leedshackspace/lulzbot-mini/documentation/Specifications v1.0.odt

- Printing
  - Print Surface: Heated Borosilicate glass bed covered with PEI film
  - Print Area:155mm x 155mm x 155mm (6.1in x 6.1in x 6.1in)
  - Print Volume: 3,724cm3 (227in3) of usable space
  - Top Print Speed: 275mm/sec (10.8in/sec) at 0.18 layer height
  - Print Tolerance: 0.1mm (0.0039in) in X and Y axes. Z axis is dependent on layer thickness
  - Layer Thickness: 0.05mm to 0.50mm (0.002in - 0.020in)
  - Supported Materials: ABS, PLA, HIPS, PVA, wood filled filaments, Polyester (Tritan), PETT, filled PLA, Bronze and copper filled filaments, Polycarbonate, Nylon, PETG, Conductive PLA and ABS, UV luminescent filaments, PCTPE, PC-ABS, and more every day.
  - Usable Filament Sizes: standard 3mm (0.1in)
- Physical Dimensions
  - Overall Dimensions: 435mm x 340mm x 385mm (17.1in x 13.4in x 15.2in)
  - Weight: 8.55kg (18.85lbs)
- Electrical
  - Power Requirements: 100 - 240 VAC
  - Power Supply: 24V 150W
  - US, UK, AU and EU electrical plugs available
- Temperature
  - Temperature: Maximum operating temperature (Extruder), 300C (572F)
  - Temperature: Maximum operating temperature (Heated Bed), 120C (248F)
  - Suggested operating temperature (environment), 15-38C (60-100F)
