leedshackspace/lulzbot-mini/parts/machined_parts/electronics_case/index.html

# Index of /Mini/1.04/production_parts/machined_parts/electronics_case

(ICO) | Name | Last modified | Size | Description
(PARENTDIR) | Parent Directory | | -
( ) | electronics-case-mini_PP-FP0082_revG.fcstd | 2017-09-13 06:26 | 938K
( ) | electronics-case-mini_PP-FP0082_revG.step | 2017-09-13 06:26 | 1.0M
( ) | electronics-case-mini_PP-FP0082_revG_page1.pdf | 2017-09-13 06:26 | 1.3M
( ) | electronics-case-mini_PP-FP0082_revG_page2.pdf | 2017-09-13 06:26 | 867K
( ) | electronics-case-mini_PP-FP0082_revG_page3.pdf | 2017-09-13 06:26 | 369K
( ) | electronics-case-mini_PP-FP0139_revJ.fcstd | 2017-12-08 15:28 | 1.0M
( ) | electronics-case-mini_PP-FP0139_revJ.pdf | 2017-12-08 15:28 | 401K
(DIR) | electronics_case_graphics/ | 2017-12-08 15:28 | -
( ) | mini_chassis_corrected_Sept2016.pdf | 2017-09-13 06:26 | 117K
(DIR) | ready/ | 2017-11-06 11:28 | -

Apache/2.4.25 (Debian) Server at download.lulzbot.com Port 80
