leedshackspace/lulzbot-mini/parts/Electronics/cable-harnesses/index.html

# Index of /Mini/1.04/production_parts/Electronics/cable-harnesses

(ICO) | Name | Last modified | Size | Description
(PARENTDIR) | Parent Directory | | -
( ) | EL-HR0114_bed_harness_revK.odg | 2018-01-25 11:28 | 3.5M
( ) | EL-HR0115_yz_motor_harness_revH.odg | 2017-08-30 07:58 | 524K
( ) | bed_harness.odg | 2017-09-13 06:26 | 3.5M
( ) | bed_harness.pdf | 2017-09-13 06:26 | 4.6M
( ) | bed_harness_igus.odg | 2017-09-13 06:26 | 3.3M
( ) | bed_harness_igus.pdf | 2017-09-13 06:26 | 4.1M
(DIR) | chassis_assembly/ | 2017-09-13 06:26 | -
(DIR) | extruder_assembly/ | 2017-09-13 06:26 | -
( ) | igus_changelog.odt | 2017-09-13 06:26 | 13K
( ) | igus_first_cable_prototypes.zip | 2017-09-13 06:26 | 8.0M
( ) | x_extruder_harnesses.odg | 2017-09-13 06:26 | 3.3M
( ) | x_extruder_harnesses.pdf | 2017-09-13 06:26 | 4.2M
( ) | x_extruder_harnesses_revI.odg | 2017-03-20 11:58 | 3.2M
( ) | yz_motor_harness.odg | 2017-09-13 06:26 | 523K

Apache/2.4.25 (Debian) Server at download.lulzbot.com Port 80
