leedshackspace/lulzbot-mini/documentation/Bill of Materials/Mini_1.04_BOM.ods

Sheet: OdooParts_PurchaseNotes
Internal Reference | Name | Long Lead | Possibly Change Part, PN, or Modify | Special | U/M | Supplier PN | Category | Price Per Unit | Released to Order | Manufacturer | Mfg PN | Distributor | Distributor SKU | Notes | 2nd Distributor | 2nd Dist. Part Number | Mass each (g) | Mass per Printer (g) | Mass Total (kg)
AO-PG0001 | Aleph Objects, Inc. Business Cards | #N/A | #N/A | #N/A | PCE | 0 | #N/A | #N/A | #N/A | #N/A | 0 | #N/A | #N/A | #N/A | #N/A | #N/A | #N/A | #N/A | #N/A
AP0010 | Print die | #N/A | #N/A | #N/A | PCE | 0 | #N/A | #N/A | #N/A | #N/A | 0 | #N/A | #N/A | #N/A | #N/A | #N/A | #N/A | #N/A | #N/A
AP-MM0000 | MendelMax Prototype, Dual Extrusion | #N/A | #N/A | #N/A | PCE | 0 | #N/A | #N/A | #N/A | #N/A | 0 | #N/A | #N/A | #N/A | #N/A | #N/A | #N/A | #N/A | #N/A
AP-MM0001 | RepRap 3D Printer, MendelMax Variant, Fully Calibrated | #N/A | #N/A | #N/A | PCE | 0 | #N/A | #N/A | #N/A | #N/A | 0 | #N/A | #N/A | #N/A | #N/A | #N/A | #N/A | #N/A | #N/A
AP-MM0001 | RepRap 3D Printer, MendelMax Variant, Fully Calibrated (copy) | #N/A | #N/A | #N/A | PCE | 0 | #N/A | #N/A | #N/A | #N/A | 0 | #N/A | #N/A | #N/A | #N/A | #N/A | #N/A | #N/A | #N/A
AP-PR0000 | 3D Printer, RepRap Mendel by LulzBot | #N/A | #N/A | #N/A | PCE | 0 | #N/A | #N/A | #N/A | #N/A | 0 | #N/A | #N/A | #N/A | #N/A | #N/A | #N/A | #N/A | #N/A
AP-PR0001 | RepRap Prusa Mendel by LulzBot, Used 3D Printer | #N/A | #N/A | #N/A | PCE | 0 | #N/A | #N/A | #N/A | #N/A | 0 | #N/A | #N/A | #N/A | #N/A | #N/A | #N/A | #N/A | #N/A
AP-PR0002 | Original Prusa i3 MK2 3D Printer | #N/A | #N/A | #N/A | PCE | 0 | #N/A | #N/A | #N/A | #N/A | 0 | #N/A | #N/A | #N/A | #N/A | #N/A | #N/A | #N/A | #N/A
DC-LB0001 | Label, Lulzbot AO-101 Barcode label | #N/A | #N/A | #N/A | PCE | 0 | #N/A | #N/A | #N/A | #N/A | 0 | #N/A | #N/A | #N/A | #N/A | #N/A | #N/A | #N/A | #N/A
DC-LB0002 | Label, LulzBot AO-100 Barcode | #N/A | #N/A | #N/A | PCE | 0 | #N/A | #N/A | #N/A | #N/A | 0 | #N/A | #N/A | #N/A | #N/A | #N/A | #N/A | #N/A | #N/A
DC-LB0003 | Label, Hobbed Bolt | #N/A | #N/A | #N/A | PCE | 0 | #N/A | #N/A | #N/A | #N/A | 0 | #N/A | #N/A | #N/A | #N/A | #N/A | #N/A | #N/A | #N/A
DC-LB0004 | Label, Budaschnozzle 1.1 threaded extension | #N/A | #N/A | #N/A | PCE | 0 | #N/A | #N/A | #N/A | #N/A | 0 | #N/A | #N/A | #N/A | #N/A | #N/A | #N/A | #N/A | #N/A
DC-LB0005 | 2 x 2" D.O.T. Labels - "Right to Know" | #N/A | #N/A | #N/A | PCE | S-2845 | #N/A | #N/A | #N/A | #N/A | 0 | #N/A | #N/A | #N/A | #N/A | #N/A | #N/A | #N/A | #N/A
DC-LB0006 | Label, Lulzbot TAZ 2.0 Barcode | #N/A | #N/A | #N/A | PCE | 0 | #N/A | #N/A | #N/A | #N/A | 0 | #N/A | #N/A | #N/A | #N/A | #N/A | #N/A | #N/A | #N/A
DC-LB0007 | Label, Top of Box | #N/A | #N/A | #N/A | PCE | 0 | #N/A | #N/A | #N/A | #N/A | 0 | #N/A | #N/A | #N/A | #N/A | #N/A | #N/A | #N/A | #N/A
DC-LB0008 | 2 x 2" D.O.T. Labels - "Right to Know", single label | #N/A | #N/A | #N/A | PCE | 0 | #N/A | #N/A | #N/A | #N/A | 0 | #N/A | #N/A | #N/A | #N/A | #N/A | #N/A | #N/A | #N/A
DC-LB0009 | 1", "Made In USA" Labels 500/roll | #N/A | #N/A | #N/A | PCE | S-17021 | #N/A | #N/A | #N/A | #N/A | 0 | #N/A | #N/A | #N/A | #N/A | #N/A | #N/A | #N/A | #N/A
DC-LB0010 | 3X5 DELICATE INSTRUMENTS LBL 500/RL | #N/A | #N/A | #N/A | PCE | S-3005 | #N/A | #N/A | #N/A | #N/A | 0 | #N/A | #N/A | #N/A | #N/A | #N/A | #N/A | #N/A | #N/A
DC-LB0011 | Flame Labels - "Hot", 1 1⁄2 x 2" | #N/A | #N/A | #N/A | PCE | S-248 | #N/A | #N/A | #N/A | #N/A | 0 | #N/A | #N/A | #N/A | #N/A | #N/A | #N/A | #N/A | #N/A
DC-LB0012 | 14035T23 Hazardous Material Sign, NFPA Diamond Style, 5" X5", Adhesive-Backed Vinyl | #N/A | #N/A | #N/A | PCE | 14035T23 | #N/A | #N/A | #N/A | #N/A | 0 | #N/A | #N/A | #N/A | #N/A | #N/A | #N/A | #N/A | #N/A
DC-LB0013 | Hazardous Material Sign, NFPA Diamond, 10-1/2" x 10-1/2", Adhesive-Back Vinyl | #N/A | #N/A | #N/A | PCE | 14035T25 | #N/A | #N/A | #N/A | #N/A | 0 | #N/A | #N/A | #N/A | #N/A | #N/A | #N/A | #N/A | #N/A
DC-LB0014 | TAZ v3.1 serial number sticker | #N/A | #N/A | #N/A | PCE | 0 | #N/A | #N/A | #N/A | #N/A | 0 | #N/A | #N/A | #N/A | #N/A | #N/A | #N/A | #N/A | #N/A
DC-LB0015 | 24VDC sticker | #N/A | #N/A | #N/A | PCE | 0 | #N/A | #N/A | #N/A | #N/A | 0 | #N/A | #N/A | #N/A | #N/A | #N/A | #N/A | #N/A | #N/A
DC-LB0016 | TAZ v3.1 bar code and serial number sticker | #N/A | #N/A | #N/A | PCE | 0 | #N/A | #N/A | #N/A | #N/A | 0 | #N/A | #N/A | #N/A | #N/A | #N/A | #N/A | #N/A | #N/A
DC-LB0017 | Label, Extruder E-Step Number, Avery 1/2 x 3/4 | #N/A | #N/A | #N/A | PCE | 112797 | #N/A | #N/A | #N/A | #N/A | 0 | #N/A | #N/A | #N/A | #N/A | #N/A | #N/A | #N/A | #N/A
DC-LB0018 | TAZ v4.0 serial number sticker | #N/A | #N/A | #N/A | PCE | 0 | #N/A | #N/A | #N/A | #N/A | 0 | #N/A | #N/A | #N/A | #N/A | #N/A | #N/A | #N/A | #N/A
DC-LB0019 | Label, 12VDC Extrusion Fan | #N/A | #N/A | #N/A | PCE | 0 | #N/A | #N/A | #N/A | #N/A | 0 | #N/A | #N/A | #N/A | #N/A | #N/A | #N/A | #N/A | #N/A
DC-LB0020 | Label, 24VDC Extrusion Fan | #N/A | #N/A | #N/A | PCE | 0 | #N/A | #N/A | #N/A | #N/A | 0 | #N/A | #N/A | #N/A | #N/A | #N/A | #N/A | #N/A | #N/A
DC-LB0021 | 1" Circle Inventory Control Labels - "Inspected by _____" roll 500 | #N/A | #N/A | #N/A | PCE | S-13119 | #N/A | #N/A | #N/A | #N/A | 0 | #N/A | #N/A | #N/A | #N/A | #N/A | #N/A | #N/A | #N/A
DC-LB0022 | 2" Circle Inventory Control Labels - "QC Rejected" roll 500 | #N/A | #N/A | #N/A | PCE | S-5914 | #N/A | #N/A | #N/A | #N/A | 0 | #N/A | #N/A | #N/A | #N/A | #N/A | #N/A | #N/A | #N/A
DC-LB0023 | 1" Circle Inventory Control Labels - "QC Passed" Roll 500 | #N/A | #N/A | #N/A | PCE | S-13118 | #N/A | #N/A | #N/A | #N/A | 0 | #N/A | #N/A | #N/A | #N/A | #N/A | #N/A | #N/A | #N/A
DC-LB0024 | Label, Bottom of Box | #N/A | #N/A | #N/A | PCE | 0 | #N/A | #N/A | #N/A | #N/A | 0 | #N/A | #N/A | #N/A | #N/A | #N/A | #N/A | #N/A | #N/A
DC-LB0025 | TAZ v4.1 serial number sticker | #N/A | #N/A | #N/A | PCE | 0 | #N/A | #N/A | #N/A | #N/A | 0 | #N/A | #N/A | #N/A | #N/A | #N/A | #N/A | #N/A | #N/A
DC-LB0026 | Label, Lulzbot TAZ 4.1 Barcode | #N/A | #N/A | #N/A | PCE | 0 | #N/A | #N/A | #N/A | #N/A | 0 | #N/A | #N/A | #N/A | #N/A | #N/A | #N/A | #N/A | #N/A
DC-LB0027 | KITTAZ Labels Complete Set | #N/A | #N/A | #N/A | PCE | 0 | #N/A | #N/A | #N/A | #N/A | 0 | #N/A | #N/A | #N/A | #N/A | #N/A | #N/A | #N/A | #N/A
DC-LB0028 | Label, Lulzbot Mini Barcode | 0 | Y | 0 | PCE | 0 | Packaging | 0.14 |  | 0 | 0 | The print shop of loveland | 0 | 0 | 0 | 0 | 0 | 0 | 0
DC-LB0029 | Mini v1 serial number sticker | 0 | Y | 0 | PCE | 0 | Packaging | 0.014 |  | 0 | 0 | The print shop of loveland | 0 | 0 | 0 | 0 | 0 | 0 | 0
DC-LB0030 | "CE" Regulated Label - 1 x 1" | #N/A | #N/A | #N/A | PCE | S-13827 | #N/A | #N/A | #N/A | #N/A | 0 | #N/A | #N/A | #N/A | #N/A | #N/A | #N/A | #N/A | #N/A
DC-LB0031 | TAZ v5.0 serial number sticker, KT-PR0017NA | #N/A | #N/A | #N/A | PCE | 0 | #N/A | #N/A | #N/A | #N/A | 0 | #N/A | #N/A | #N/A | #N/A | #N/A | #N/A | #N/A | #N/A
DC-LB0032 | Label, Lulzbot TAZ 5.0 Barcode, KT-PR0017NA | #N/A | #N/A | #N/A | PCE | 0 | #N/A | #N/A | #N/A | #N/A | 0 | #N/A | #N/A | #N/A | #N/A | #N/A | #N/A | #N/A | #N/A
DC-LB0033 | TAZ v5.0 serial number sticker, KT-PR0017EU | #N/A | #N/A | #N/A | PCE | 0 | #N/A | #N/A | #N/A | #N/A | 0 | #N/A | #N/A | #N/A | #N/A | #N/A | #N/A | #N/A | #N/A
DC-LB0034 | Label, Lulzbot TAZ 5.0 Barcode, KT-PR0017EU | #N/A | #N/A | #N/A | PCE | 0 | #N/A | #N/A | #N/A | #N/A | 0 | #N/A | #N/A | #N/A | #N/A | #N/A | #N/A | #N/A | #N/A
DC-LB0035 | TAZ v5.0 serial number sticker, KT-PR0017AU | #N/A | #N/A | #N/A | PCE | 0 | #N/A | #N/A | #N/A | #N/A | 0 | #N/A | #N/A | #N/A | #N/A | #N/A | #N/A | #N/A | #N/A
DC-LB0036 | Label, Lulzbot TAZ 5.0 Barcode, KT-PR0017AU | #N/A | #N/A | #N/A | PCE | 0 | #N/A | #N/A | #N/A | #N/A | 0 | #N/A | #N/A | #N/A | #N/A | #N/A | #N/A | #N/A | #N/A
DC-LB0037 | FCC Sticker, Blank | #N/A | #N/A | #N/A | PCE | 0 | #N/A | #N/A | #N/A | #N/A | 0 | #N/A | #N/A | #N/A | #N/A | #N/A | #N/A | #N/A | #N/A
DC-LB0038 | FCC Sticker, KT-PR0035-**** | #N/A | #N/A | #N/A | PCE | 0 | #N/A | #N/A | #N/A | #N/A | 0 | #N/A | #N/A | #N/A | #N/A | #N/A | #N/A | #N/A | #N/A
DC-LB0039 | Label, LulzBot TAZ Single Extruder Tool Head v2, 0.35 Nozzle | #N/A | #N/A | #N/A | PCE | 0 | #N/A | #N/A | #N/A | #N/A | 0 | #N/A | #N/A | #N/A | #N/A | #N/A | #N/A | #N/A | #N/A
DC-LB0040 | Label, Lulzbot Mini Barcode, NA | #N/A | #N/A | #N/A | PCE | 0 | #N/A | #N/A | #N/A | #N/A | 0 | #N/A | #N/A | #N/A | #N/A | #N/A | #N/A | #N/A | #N/A
DC-LB0041 | Label, Lulzbot Mini Barcode, EU | #N/A | #N/A | #N/A | PCE | 0 | #N/A | #N/A | #N/A | #N/A | 0 | #N/A | #N/A | #N/A | #N/A | #N/A | #N/A | #N/A | #N/A
DC-LB0042 | Label, Lulzbot Mini Barcode, AU | #N/A | #N/A | #N/A | PCE | 0 | #N/A | #N/A | #N/A | #N/A | 0 | #N/A | #N/A | #N/A | #N/A | #N/A | #N/A | #N/A | #N/A
DC-LB0043 | Mini v1 serial number sticker, NA | #N/A | #N/A | #N/A | PCE | 0 | #N/A | #N/A | #N/A | #N/A | 0 | #N/A | #N/A | #N/A | #N/A | #N/A | #N/A | #N/A | #N/A
DC-LB0044 | Mini v1 serial number sticker, EU | #N/A | #N/A | #N/A | PCE | 0 | #N/A | #N/A | #N/A | #N/A | 0 | #N/A | #N/A | #N/A | #N/A | #N/A | #N/A | #N/A | #N/A
DC-LB0045 | Mini v1 serial number sticker, AU | #N/A | #N/A | #N/A | PCE | 0 | #N/A | #N/A | #N/A | #N/A | 0 | #N/A | #N/A | #N/A | #N/A | #N/A | #N/A | #N/A | #N/A
DC-LB0046 | FCC-CE-RSF-Colorado Made 3" x 3" B&W Sticker | #N/A | #N/A | #N/A | PCE | Custom Part | #N/A | #N/A | #N/A | #N/A | 0 | #N/A | #N/A | #N/A | #N/A | #N/A | #N/A | #N/A | #N/A
DC-LB0047 | TAZ v5.0 serial number sticker, KT-PR0036NA | #N/A | #N/A | #N/A | PCE | 0 | #N/A | #N/A | #N/A | #N/A | 0 | #N/A | #N/A | #N/A | #N/A | #N/A | #N/A | #N/A | #N/A
DC-LB0048 | Label, Lulzbot TAZ 5.0 Barcode, KT-PR0036NA | #N/A | #N/A | #N/A | PCE | 0 | #N/A | #N/A | #N/A | #N/A | 0 | #N/A | #N/A | #N/A | #N/A | #N/A | #N/A | #N/A | #N/A
DC-LB0049 | TAZ v5.0 serial number sticker, KT-PR0036EU | #N/A | #N/A | #N/A | PCE | 0 | #N/A | #N/A | #N/A | #N/A | 0 | #N/A | #N/A | #N/A | #N/A | #N/A | #N/A | #N/A | #N/A
DC-LB0050 | Label, Lulzbot TAZ 5.0 Barcode, KT-PR0036EU | #N/A | #N/A | #N/A | PCE | 0 | #N/A | #N/A | #N/A | #N/A | 0 | #N/A | #N/A | #N/A | #N/A | #N/A | #N/A | #N/A | #N/A
DC-LB0051 | TAZ v5.0 serial number sticker, KT-PR0036AU | #N/A | #N/A | #N/A | PCE | 0 | #N/A | #N/A | #N/A | #N/A | 0 | #N/A | #N/A | #N/A | #N/A | #N/A | #N/A | #N/A | #N/A
DC-LB0052 | Label, Lulzbot TAZ 5.0 Barcode, KT-PR0036AU | #N/A | #N/A | #N/A | PCE | 0 | #N/A | #N/A | #N/A | #N/A | 0 | #N/A | #N/A | #N/A | #N/A | #N/A | #N/A | #N/A | #N/A
DC-LB0053 | Label, LulzBot TAZ Flexystruder Tool Head v2, 0.6 Nozzle | #N/A | #N/A | #N/A | PCE | 0 | #N/A | #N/A | #N/A | #N/A | 0 | #N/A | #N/A | #N/A | #N/A | #N/A | #N/A | #N/A | #N/A
DC-LB0054 | TAZ v5.0 serial number sticker, KT-PR0036NA | #N/A | #N/A | #N/A | PCE | 0 | #N/A | #N/A | #N/A | #N/A | 0 | #N/A | #N/A | #N/A | #N/A | #N/A | #N/A | #N/A | #N/A
DC-LB0055 | Label, Lulzbot TAZ 5.0 Barcode, KT-PR0036NA | #N/A | #N/A | #N/A | PCE | 0 | #N/A | #N/A | #N/A | #N/A | 0 | #N/A | #N/A | #N/A | #N/A | #N/A | #N/A | #N/A | #N/A
DC-LB0056 | TAZ v5.0 serial number sticker, KT-PR0036EU | #N/A | #N/A | #N/A | PCE | 0 | #N/A | #N/A | #N/A | #N/A | 0 | #N/A | #N/A | #N/A | #N/A | #N/A | #N/A | #N/A | #N/A
DC-LB0057 | Label, Lulzbot TAZ 5.0 Barcode, KT-PR0036EU | #N/A | #N/A | #N/A | PCE | 0 | #N/A | #N/A | #N/A | #N/A | 0 | #N/A | #N/A | #N/A | #N/A | #N/A | #N/A | #N/A | #N/A
DC-LB0058 | TAZ v5.0 serial number sticker, KT-PR0036AU | #N/A | #N/A | #N/A | PCE | 0 | #N/A | #N/A | #N/A | #N/A | 0 | #N/A | #N/A | #N/A | #N/A | #N/A | #N/A | #N/A | #N/A
DC-LB0059 | Label, Lulzbot TAZ 5.0 Barcode, KT-PR0036AU | #N/A | #N/A | #N/A | PCE | 0 | #N/A | #N/A | #N/A | #N/A | 0 | #N/A | #N/A | #N/A | #N/A | #N/A | #N/A | #N/A | #N/A
DC-LB0060 | Tool head ID label, TAZ 5 0.5mm Nozzle | #N/A | #N/A | #N/A | PCE | 0 | #N/A | #N/A | #N/A | #N/A | 0 | #N/A | #N/A | #N/A | #N/A | #N/A | #N/A | #N/A | #N/A
DC-LB0061 | FCC_CE_ROHS_OSHW_RYF_CO_Made_Sticker_4" x3" | #N/A | #N/A | #N/A | PCE | Custom Part | #N/A | #N/A | #N/A | #N/A | 0 | #N/A | #N/A | #N/A | #N/A | #N/A | #N/A | #N/A | #N/A
DC-LB0062 | Clam Knife Sheath Sticker - Caution Sharp Blade! (1"x2.5" Rectangle) | 0 | 0 | 0 | PCE | 0 | Packaging | 0.350877 |  | 0 | 0 | Sticker Giant | 0 | 0 | 0 | 0 | 0 | 0 | 0
DC-LB0063 | Modification Warning Insert Modification 2.75 x 8.5 on 100 lb. Astrobright Lift Off Lemon Very Bright | 0 | 0 | 0 | PCE | 0 | Packaging | 0.07 |  | 0 | 0 | The print shop of loveland | 0 | 0 | 0 | 0 | 0 | 0 | 0
DC-LB0064 | Hexagon Hot End Retail Box Label | #N/A | #N/A | #N/A | PCE | 0 | #N/A | #N/A | #N/A | #N/A | 0 | #N/A | #N/A | #N/A | #N/A | #N/A | #N/A | #N/A | #N/A
DC-LB0065 | Hexagon Hot End Retail Box Label, 0.35mm | #N/A | #N/A | #N/A | PCE | 0 | #N/A | #N/A | #N/A | #N/A | 0 | #N/A | #N/A | #N/A | #N/A | #N/A | #N/A | #N/A | #N/A
DC-LB0066 | Hexagon Hot End Retail Box Label, 0.50mm | #N/A | #N/A | #N/A | PCE | 0 | #N/A | #N/A | #N/A | #N/A | 0 | #N/A | #N/A | #N/A | #N/A | #N/A | #N/A | #N/A | #N/A
DC-LB0067 | Hexagon Hot End Retail Box Label, 0.60mm | #N/A | #N/A | #N/A | PCE | 0 | #N/A | #N/A | #N/A | #N/A | 0 | #N/A | #N/A | #N/A | #N/A | #N/A | #N/A | #N/A | #N/A
DC-LB0068 | Label, LulzBot TAZ Flexystruder Tool Head v2c, 0.6 Nozzle, Front | #N/A | #N/A | #N/A | PCE | 0 | #N/A | #N/A | #N/A | #N/A | 0 | #N/A | #N/A | #N/A | #N/A | #N/A | #N/A | #N/A | #N/A
DC-LB0069 | Label, LulzBot TAZ Flexystruder Tool Head v2c, 0.6 Nozzle, Back | #N/A | #N/A | #N/A | PCE | 0 | #N/A | #N/A | #N/A | #N/A | 0 | #N/A | #N/A | #N/A | #N/A | #N/A | #N/A | #N/A | #N/A
DC-LB0070 | Label, LulzBot Mini Flexystruder Tool Head v2, 0.6 Nozzle, Front | #N/A | #N/A | #N/A | PCE | 0 | #N/A | #N/A | #N/A | #N/A | 0 | #N/A | #N/A | #N/A | #N/A | #N/A | #N/A | #N/A | #N/A
DC-LB0071 | Label, LulzBot Mini Flexystruder Tool Head v2, 0.6 Nozzle, Back | #N/A | #N/A | #N/A | PCE | 0 | #N/A | #N/A | #N/A | #N/A | 0 | #N/A | #N/A | #N/A | #N/A | #N/A | #N/A | #N/A | #N/A
DC-LB0072 | Label, LulzBot TAZ Dual Extruder Tool Head v2c, 0.5 Nozzle, Front | #N/A | #N/A | #N/A | PCE | 0 | #N/A | #N/A | #N/A | #N/A | 0 | #N/A | #N/A | #N/A | #N/A | #N/A | #N/A | #N/A | #N/A
DC-LB0073 | Label, LulzBot TAZ Dual Extruder Tool Head v2c, 0.5 Nozzle, Back | #N/A | #N/A | #N/A | PCE | 0 | #N/A | #N/A | #N/A | #N/A | 0 | #N/A | #N/A | #N/A | #N/A | #N/A | #N/A | #N/A | #N/A
DC-LB0074 | Label, LulzBot TAZ FlexyDually Tool Head v2c, 0.6 Nozzle, Front | #N/A | #N/A | #N/A | PCE | 0 | #N/A | #N/A | #N/A | #N/A | 0 | #N/A | #N/A | #N/A | #N/A | #N/A | #N/A | #N/A | #N/A
DC-LB0075 | Label, LulzBot TAZ FlexyDually Tool Head v2c, 0.6 Nozzle, Back | #N/A | #N/A | #N/A | PCE | 0 | #N/A | #N/A | #N/A | #N/A | 0 | #N/A | #N/A | #N/A | #N/A | #N/A | #N/A | #N/A | #N/A
DC-LB0076 | LulzBot Mini Flexystruder v2 Serial Number Label | #N/A | #N/A | #N/A | PCE | 0 | #N/A | #N/A | #N/A | #N/A | 0 | #N/A | #N/A | #N/A | #N/A | #N/A | #N/A | #N/A | #N/A
DC-LB0077 | Tool head ID label, TAZ 5 0.35mm Nozzle | #N/A | #N/A | #N/A | PCE | 0 | #N/A | #N/A | #N/A | #N/A | 0 | #N/A | #N/A | #N/A | #N/A | #N/A | #N/A | #N/A | #N/A
DC-LB0078 | Label, LulzBot TAZ Single Extruder Tool Head v2c, 0.5 Nozzle, Front | #N/A | #N/A | #N/A | PCE | 0 | #N/A | #N/A | #N/A | #N/A | 0 | #N/A | #N/A | #N/A | #N/A | #N/A | #N/A | #N/A | #N/A
DC-LB0079 | Label, LulzBot TAZ Single Extruder Tool Head v2c, 0.5 Nozzle, Back | #N/A | #N/A | #N/A | PCE | 0 | #N/A | #N/A | #N/A | #N/A | 0 | #N/A | #N/A | #N/A | #N/A | #N/A | #N/A | #N/A | #N/A
DC-LB0080 | Label, LulzBot TAZ Single Extruder Tool Head v2c, 0.35 Nozzle, Front | #N/A | #N/A | #N/A | PCE | 0 | #N/A | #N/A | #N/A | #N/A | 0 | #N/A | #N/A | #N/A | #N/A | #N/A | #N/A | #N/A | #N/A
DC-LB0081 | Label, LulzBot TAZ Single Extruder Tool Head v2c, 0.35 Nozzle, Back | #N/A | #N/A | #N/A | PCE | 0 | #N/A | #N/A | #N/A | #N/A | 0 | #N/A | #N/A | #N/A | #N/A | #N/A | #N/A | #N/A | #N/A
DC-LB0082 | LulzBot TAZ Flexystruder v2 Serial Number Label | #N/A | #N/A | #N/A | PCE | 0 | #N/A | #N/A | #N/A | #N/A | 0 | #N/A | #N/A | #N/A | #N/A | #N/A | #N/A | #N/A | #N/A
DC-LB0083 | LulzBot TAZ Dual Extruder v2 Serial Number Label | #N/A | #N/A | #N/A | PCE | 0 | #N/A | #N/A | #N/A | #N/A | 0 | #N/A | #N/A | #N/A | #N/A | #N/A | #N/A | #N/A | #N/A
DC-LB0084 | LulzBot TAZ FlexyDually v2 Serial Number Label | #N/A | #N/A | #N/A | PCE | 0 | #N/A | #N/A | #N/A | #N/A | 0 | #N/A | #N/A | #N/A | #N/A | #N/A | #N/A | #N/A | #N/A
DC-LB0085 | LulzBot TAZ Single Extruder 0.50noz v2c Serial Number Label | #N/A | #N/A | #N/A | PCE | 0 | #N/A | #N/A | #N/A | #N/A | 0 | #N/A | #N/A | #N/A | #N/A | #N/A | #N/A | #N/A | #N/A
DC-LB0086 | LulzBot TAZ Single Extruder 0.35noz v2c Serial Number Label | #N/A | #N/A | #N/A | PCE | 0 | #N/A | #N/A | #N/A | #N/A | 0 | #N/A | #N/A | #N/A | #N/A | #N/A | #N/A | #N/A | #N/A
DC-LB0087 | Lulzbot Mini topper "sign for Micro Center" | #N/A | #N/A | #N/A | PCE | 0 | #N/A | #N/A | #N/A | #N/A | 0 | #N/A | #N/A | #N/A | #N/A | #N/A | #N/A | #N/A | #N/A
DC-LB0088 | Lulzbot Taz 5, "sign for Micro Center" | #N/A | #N/A | #N/A | PCE | 0 | #N/A | #N/A | #N/A | #N/A | 0 | #N/A | #N/A | #N/A | #N/A | #N/A | #N/A | #N/A | #N/A
DC-LB0089 | Lulzbot ticket molding "for Micro Center" | #N/A | #N/A | #N/A | PCE | 0 | #N/A | #N/A | #N/A | #N/A | 0 | #N/A | #N/A | #N/A | #N/A | #N/A | #N/A | #N/A | #N/A
DC-LB0090 | Lulzbot Channel strip "for Micro Center" | #N/A | #N/A | #N/A | PCE | 0 | #N/A | #N/A | #N/A | #N/A | 0 | #N/A | #N/A | #N/A | #N/A | #N/A | #N/A | #N/A | #N/A
DC-LB0091 | Lulzbot Mini Fact Tag "for Micro Center" | #N/A | #N/A | #N/A | PCE | 0 | #N/A | #N/A | #N/A | #N/A | 0 | #N/A | #N/A | #N/A | #N/A | #N/A | #N/A | #N/A | #N/A
DC-LB0092 | Lulzbot Taz 5 Fact Tag "for Micro Center" | #N/A | #N/A | #N/A | PCE | 0 | #N/A | #N/A | #N/A | #N/A | 0 | #N/A | #N/A | #N/A | #N/A | #N/A | #N/A | #N/A | #N/A
DC-LB0093 | RCM certified for sales in Australia | #N/A | #N/A | #N/A | PCE | 0 | #N/A | #N/A | #N/A | #N/A | 0 | #N/A | #N/A | #N/A | #N/A | #N/A | #N/A | #N/A | #N/A
DC-LB0094 | Serial number label sheets (blank) 100/pk 105 up - 1.25" x 0.375" | #N/A | #N/A | #N/A | PCE | 105 up - 1.25" x 0.375" | #N/A | #N/A | #N/A | #N/A | 0 | #N/A | #N/A | #N/A | #N/A | #N/A | #N/A | #N/A | #N/A
DC-LB0095 | LulzBot Logo Sticker, 3 - Inch | #N/A | #N/A | #N/A | PCE | 0 | #N/A | #N/A | #N/A | #N/A | 0 | #N/A | #N/A | #N/A | #N/A | #N/A | #N/A | #N/A | #N/A
DC-LB0096 | Tool head ID label, Mini 0.5mm Nozzle | #N/A | #N/A | #N/A | PCE | 0 | #N/A | #N/A | #N/A | #N/A | 0 | #N/A | #N/A | #N/A | #N/A | #N/A | #N/A | #N/A | #N/A
DC-LB0097 | TAZ v6.0 serial number sticker, KT-PR0041NA | #N/A | #N/A | #N/A | PCE | 0 | #N/A | #N/A | #N/A | #N/A | 0 | #N/A | #N/A | #N/A | #N/A | #N/A | #N/A | #N/A | #N/A
DC-LB0098 | Label, Lulzbot TAZ 6.0 Barcode, KT-PR0041NA | #N/A | #N/A | #N/A | PCE | 0 | #N/A | #N/A | #N/A | #N/A | 0 | #N/A | #N/A | #N/A | #N/A | #N/A | #N/A | #N/A | #N/A
DC-LB0099 | TAZ v6.0 serial number sticker, KT-PR0041EU | #N/A | #N/A | #N/A | PCE | 0 | #N/A | #N/A | #N/A | #N/A | 0 | #N/A | #N/A | #N/A | #N/A | #N/A | #N/A | #N/A | #N/A
DC-LB0100 | Label, Lulzbot TAZ 6.0 Barcode, KT-PR0041EU | #N/A | #N/A | #N/A | PCE | 0 | #N/A | #N/A | #N/A | #N/A | 0 | #N/A | #N/A | #N/A | #N/A | #N/A | #N/A | #N/A | #N/A
DC-LB0101 | TAZ v6.0 serial number sticker, KT-PR0041AU | #N/A | #N/A | #N/A | PCE | 0 | #N/A | #N/A | #N/A | #N/A | 0 | #N/A | #N/A | #N/A | #N/A | #N/A | #N/A | #N/A | #N/A
DC-LB0102 | Label, Lulzbot TAZ 6.0 Barcode, KT-PR0041AU | #N/A | #N/A | #N/A | PCE | 0 | #N/A | #N/A | #N/A | #N/A | 0 | #N/A | #N/A | #N/A | #N/A | #N/A | #N/A | #N/A | #N/A
DC-LB0104 | Tool Head Wiring Connector Alignment Label | #N/A | #N/A | #N/A | PCE | 0 | #N/A | 0.01791 | Yes | Sticker Giant | 0 | Sticker Giant | #N/A | #N/A | #N/A | #N/A | #N/A | #N/A | #N/A
DC-LB0105 | Arrow Labels - Yellow, 1 x 3" 500/roll | #N/A | #N/A | #N/A | PCE | S-13121 | #N/A | #N/A | #N/A | #N/A | 0 | #N/A | #N/A | #N/A | #N/A | #N/A | #N/A | #N/A | #N/A
DC-LB0106 | TAZ 6 Inner Box Label #1 Contents | #N/A | #N/A | #N/A | PCE | 0 | #N/A | #N/A | #N/A | #N/A | 0 | #N/A | #N/A | #N/A | #N/A | #N/A | #N/A | #N/A | #N/A
DC-LB0107 | TAZ 6 Inner Box Label #2, Contents | #N/A | #N/A | #N/A | PCE | 0 | #N/A | #N/A | #N/A | #N/A | 0 | #N/A | #N/A | #N/A | #N/A | #N/A | #N/A | #N/A | #N/A
DC-LB0108 | Filament Samples Bag Label - TAZ 6 | #N/A | #N/A | #N/A | PCE | 0 | #N/A | #N/A | #N/A | #N/A | 0 | #N/A | #N/A | #N/A | #N/A | #N/A | #N/A | #N/A | #N/A
DC-LB0109 | Label, LulzBot TAZ Opah Tool Head v2c, 1.2 Nozzle, Front | #N/A | #N/A | #N/A | PCE | 0 | #N/A | #N/A | #N/A | #N/A | 0 | #N/A | #N/A | #N/A | #N/A | #N/A | #N/A | #N/A | #N/A
DC-LB0110 | Label, LulzBot TAZ Opah Tool Head v2c, 1.2 Nozzle, Back | #N/A | #N/A | #N/A | PCE | 0 | #N/A | #N/A | #N/A | #N/A | 0 | #N/A | #N/A | #N/A | #N/A | #N/A | #N/A | #N/A | #N/A
DC-MN0000 | AO-100 User Manual | #N/A | #N/A | #N/A | Each - OLD | 0 | #N/A | #N/A | #N/A | #N/A | 0 | #N/A | #N/A | #N/A | #N/A | #N/A | #N/A | #N/A | #N/A
DC-MN0001 | AO-101 User Manual | #N/A | #N/A | #N/A | PCE | 0 | #N/A | #N/A | #N/A | #N/A | 0 | #N/A | #N/A | #N/A | #N/A | #N/A | #N/A | #N/A | #N/A
DC-MN0002 | Lulzbot-Taz Manual Print & Binding | #N/A | #N/A | #N/A | PCE | 0 | #N/A | #N/A | #N/A | #N/A | 0 | #N/A | #N/A | #N/A | #N/A | #N/A | #N/A | #N/A | #N/A
DC-MN0003 | Lulzbot-Taz User Manual | #N/A | #N/A | #N/A | PCE | 0 | #N/A | #N/A | #N/A | #N/A | 0 | #N/A | #N/A | #N/A | #N/A | #N/A | #N/A | #N/A | #N/A
DC-MN0004 | Quick Start Guide, Lulzbot | #N/A | #N/A | #N/A | PCE | 0 | #N/A | #N/A | #N/A | #N/A | 0 | #N/A | #N/A | #N/A | #N/A | #N/A | #N/A | #N/A | #N/A
DC-MN0005 | Lulzbot-Taz 2.0 User Manual | #N/A | #N/A | #N/A | PCE | 0 | #N/A | #N/A | #N/A | #N/A | 0 | #N/A | #N/A | #N/A | #N/A | #N/A | #N/A | #N/A | #N/A
DC-MN0006 | Lulzbot-Taz 2.1 User Manual | #N/A | #N/A | #N/A | PCE | 0 | #N/A | #N/A | #N/A | #N/A | 0 | #N/A | #N/A | #N/A | #N/A | #N/A | #N/A | #N/A | #N/A
DC-MN0007 | Lulzbot-Taz 3.0 User Manual | #N/A | #N/A | #N/A | PCE | 0 | #N/A | #N/A | #N/A | #N/A | 0 | #N/A | #N/A | #N/A | #N/A | #N/A | #N/A | #N/A | #N/A
DC-MN0008 | Lulzbot-Taz 3.1 User Manual | #N/A | #N/A | #N/A | PCE | 0 | #N/A | #N/A | #N/A | #N/A | 0 | #N/A | #N/A | #N/A | #N/A | #N/A | #N/A | #N/A | #N/A
DC-MN0009 | Lulzbot-Taz 4.0 User Manual | #N/A | #N/A | #N/A | PCE | 0 | #N/A | #N/A | #N/A | #N/A | 0 | #N/A | #N/A | #N/A | #N/A | #N/A | #N/A | #N/A | #N/A
DC-MN0010 | Lulzbot-Taz 4.1 User Manual | #N/A | #N/A | #N/A | PCE | 0 | #N/A | #N/A | #N/A | #N/A | 0 | #N/A | #N/A | #N/A | #N/A | #N/A | #N/A | #N/A | #N/A
DC-MN0011 | Getting Started Guide, TAZ 4 | #N/A | #N/A | #N/A | PCE | 0 | #N/A | #N/A | #N/A | #N/A | 0 | #N/A | #N/A | #N/A | #N/A | #N/A | #N/A | #N/A | #N/A
DC-MN0012 | Getting Started Guide, TAZ 5 | #N/A | #N/A | #N/A | PCE | 0 | #N/A | #N/A | #N/A | #N/A | 0 | #N/A | #N/A | #N/A | #N/A | #N/A | #N/A | #N/A | #N/A
DC-MN0013 | Lulzbot-Taz 5.0 User Manual | #N/A | #N/A | #N/A | PCE | 0 | #N/A | #N/A | #N/A | #N/A | 0 | #N/A | #N/A | #N/A | #N/A | #N/A | #N/A | #N/A | #N/A
DC-MN0014 | LulzBot Mini User Manual (PDF) | #N/A | #N/A | #N/A | PCE | 0 | #N/A | #N/A | #N/A | #N/A | 0 | #N/A | #N/A | #N/A | #N/A | #N/A | #N/A | #N/A | #N/A
DC-MN0015 | Lulzbot-TAZ 6.0 User Manual | #N/A | #N/A | #N/A | PCE | 0 | #N/A | #N/A | #N/A | #N/A | 0 | #N/A | #N/A | #N/A | #N/A | #N/A | #N/A | #N/A | #N/A
DC-MN0016 | Operating Guide, TAZ 6 | #N/A | #N/A | #N/A | PCE | 0 | #N/A | #N/A | #N/A | #N/A | 0 | #N/A | #N/A | #N/A | #N/A | #N/A | #N/A | #N/A | #N/A
DC-MN0017 | Unboxing Guide, TAZ 6 | #N/A | #N/A | #N/A | PCE | 0 | #N/A | #N/A | #N/A | #N/A | 0 | #N/A | #N/A | #N/A | #N/A | #N/A | #N/A | #N/A | #N/A
DC-MN0018 | FreeCAD: A Manual | #N/A | #N/A | #N/A | PCE | 0 | #N/A | #N/A | #N/A | #N/A | 0 | #N/A | #N/A | #N/A | #N/A | #N/A | #N/A | #N/A | #N/A
DC-MS0001 | Registration Card, AO-100 | #N/A | #N/A | #N/A | PCE | 0 | #N/A | #N/A | #N/A | #N/A | 0 | #N/A | #N/A | #N/A | #N/A | #N/A | #N/A | #N/A | #N/A
DC-MS0003 | AO-101 Unpacking Instructions | #N/A | #N/A | #N/A | PCE | 0 | #N/A | #N/A | #N/A | #N/A | 0 | #N/A | #N/A | #N/A | #N/A | #N/A | #N/A | #N/A | #N/A
DC-MS0004 | Quality checklist, TAZ 2.0 | #N/A | #N/A | #N/A | PCE | 0 | #N/A | #N/A | #N/A | #N/A | 0 | #N/A | #N/A | #N/A | #N/A | #N/A | #N/A | #N/A | #N/A
DC-MS0005 | Test/Acceptance record TAZ 2.0 | #N/A | #N/A | #N/A | PCE | 0 | #N/A | #N/A | #N/A | #N/A | 0 | #N/A | #N/A | #N/A | #N/A | #N/A | #N/A | #N/A | #N/A
DC-MS0006 | Forum Postcards | #N/A | #N/A | #N/A | PCE | 0 | #N/A | #N/A | #N/A | #N/A | 0 | #N/A | #N/A | #N/A | #N/A | #N/A | #N/A | #N/A | #N/A
DC-MS0007 | Packing List, TAZ 2.0 | #N/A | #N/A | #N/A | PCE | 0 | #N/A | #N/A | #N/A | #N/A | 0 | #N/A | #N/A | #N/A | #N/A | #N/A | #N/A | #N/A | #N/A
DC-MS0008 | AO-101 Printer Documentation | #N/A | #N/A | #N/A | PCE | 0 | #N/A | #N/A | #N/A | #N/A | 0 | #N/A | #N/A | #N/A | #N/A | #N/A | #N/A | #N/A | #N/A
DC-MS0009 | Brochure, Lulzbot Flyer | #N/A | #N/A | #N/A | PCE | 0 | #N/A | #N/A | #N/A | #N/A | 0 | #N/A | #N/A | #N/A | #N/A | #N/A | #N/A | #N/A | #N/A
DC-MS0010 | DVD Training 12: Blender for 3D Printing | #N/A | #N/A | #N/A | PCE | 0 | #N/A | #N/A | #N/A | #N/A | 0 | #N/A | #N/A | #N/A | #N/A | #N/A | #N/A | #N/A | #N/A
DC-MS0011 | New Product Introduction | #N/A | #N/A | #N/A | PCE | 0 | #N/A | #N/A | #N/A | #N/A | 0 | #N/A | #N/A | #N/A | #N/A | #N/A | #N/A | #N/A | #N/A
DC-MS0012 | Postcards | #N/A | #N/A | #N/A | PCE | 0 | #N/A | #N/A | #N/A | #N/A | 0 | #N/A | #N/A | #N/A | #N/A | #N/A | #N/A | #N/A | #N/A
DC-MS0013 | Product Flyers | #N/A | #N/A | #N/A | PCE | 0 | #N/A | #N/A | #N/A | #N/A | 0 | #N/A | #N/A | #N/A | #N/A | #N/A | #N/A | #N/A | #N/A
DC-MS0014 | Quality checklist, TAZ 3.1 | #N/A | #N/A | #N/A | PCE | 0 | #N/A | #N/A | #N/A | #N/A | 0 | #N/A | #N/A | #N/A | #N/A | #N/A | #N/A | #N/A | #N/A
DC-MS0015 | Test/Acceptance record TAZ 3.1 | #N/A | #N/A | #N/A | PCE | 0 | #N/A | #N/A | #N/A | #N/A | 0 | #N/A | #N/A | #N/A | #N/A | #N/A | #N/A | #N/A | #N/A
DC-MS0016 | Packing List, TAZ 3.1 | #N/A | #N/A | #N/A | PCE | 0 | #N/A | #N/A | #N/A | #N/A | 0 | #N/A | #N/A | #N/A | #N/A | #N/A | #N/A | #N/A | #N/A
DC-MS0017 | TAZ 3 unpacking instructions, #1 | #N/A | #N/A | #N/A | PCE | 0 | #N/A | #N/A | #N/A | #N/A | 0 | #N/A | #N/A | #N/A | #N/A | #N/A | #N/A | #N/A | #N/A
DC-MS0018 | TAZ 3 set up instructions, #2 | #N/A | #N/A | #N/A | PCE | 0 | #N/A | #N/A | #N/A | #N/A | 0 | #N/A | #N/A | #N/A | #N/A | #N/A | #N/A | #N/A | #N/A
DC-MS0019 | TAZ 3 quick print instructions, #3 | #N/A | #N/A | #N/A | PCE | 0 | #N/A | #N/A | #N/A | #N/A | 0 | #N/A | #N/A | #N/A | #N/A | #N/A | #N/A | #N/A | #N/A
DC-MS0020 | Test/Acceptance record TAZ 4.0 | #N/A | #N/A | #N/A | PCE | 0 | #N/A | #N/A | #N/A | #N/A | 0 | #N/A | #N/A | #N/A | #N/A | #N/A | #N/A | #N/A | #N/A
DC-MS0021 | Quality checklist, TAZ 4.0 | #N/A | #N/A | #N/A | PCE | 0 | #N/A | #N/A | #N/A | #N/A | 0 | #N/A | #N/A | #N/A | #N/A | #N/A | #N/A | #N/A | #N/A
DC-MS0022 | Packing List, TAZ 4.0 | #N/A | #N/A | #N/A | PCE | 0 | #N/A | #N/A | #N/A | #N/A | 0 | #N/A | #N/A | #N/A | #N/A | #N/A | #N/A | #N/A | #N/A
DC-MS0023 | Test/Acceptance record TAZ 4.1 | #N/A | #N/A | #N/A | PCE | 0 | #N/A | #N/A | #N/A | #N/A | 0 | #N/A | #N/A | #N/A | #N/A | #N/A | #N/A | #N/A | #N/A
DC-MS0024 | Quality checklist, TAZ 4.1 | #N/A | #N/A | #N/A | PCE | 0 | #N/A | #N/A | #N/A | #N/A | 0 | #N/A | #N/A | #N/A | #N/A | #N/A | #N/A | #N/A | #N/A
DC-MS0025 | Packing List, TAZ 4.1 | #N/A | #N/A | #N/A | PCE | 0 | #N/A | #N/A | #N/A | #N/A | 0 | #N/A | #N/A | #N/A | #N/A | #N/A | #N/A | #N/A | #N/A
DC-MS0026 | KITTAZ 4 Page Packing List | #N/A | #N/A | #N/A | PCE | 0 | #N/A | #N/A | #N/A | #N/A | 0 | #N/A | #N/A | #N/A | #N/A | #N/A | #N/A | #N/A | #N/A
DC-MS0027 | KITTAZ Insert | #N/A | #N/A | #N/A | PCE | 0 | #N/A | #N/A | #N/A | #N/A | 0 | #N/A | #N/A | #N/A | #N/A | #N/A | #N/A | #N/A | #N/A
DC-MS0028 | Packing List, Mini 1.0 | 0 | 0 | 0 | PCE | 0 | Packaging | 0.18 |  | 0 | 0 | The print shop of loveland | 0 | 0 | 0 | 0 | 0 | 0 | 0
DC-MS0029 | Quality assurance record Mini 1.0 | 0 | 0 | 0 | PCE | 0 | Packaging | 0.11 |  | 0 | 0 | The print shop of loveland | 0 | 0 | 0 | 0 | 0 | 0 | 0
DC-MS0030 | Lulzbot Mini Poster | 0 | 0 | 0 | PCE | 0 | Packaging | 0.75 |  | 0 | 0 | The print shop of loveland | 0 | 0 | 0 | 0 | 0 | 0 | 0
DC-MS0031 | Warning sheet, Mini | 0 | 0 | 0 | PCE | 0 | Packaging | 0.07 |  | 0 | 0 | The print shop of loveland | 0 | 0 | 0 | 0 | 0 | 0 | 0
DC-MS0032 | Quick start guide, Mini | 0 | 0 | 0 | PCE | 0 | Packaging | 0.95 |  | 0 | 0 | The Print shop of Loveland | 0 | 0 | 0 | 0 | 0 | 0 | 0
DC-MS0033 | EC Declaration of Conformity, Mini v1.0 | 0 | 0 | 0 | PCE | 0 | Packaging | 0.11 |  | 0 | 0 | The print shop of loveland | 0 | 0 | 0 | 0 | 0 | 0 | 0
DC-MS0034 | Test/Acceptance record TAZ 5.0 | #N/A | #N/A | #N/A | PCE | 0 | #N/A | #N/A | #N/A | #N/A | 0 | #N/A | #N/A | #N/A | #N/A | #N/A | #N/A | #N/A | #N/A
DC-MS0035 | Quality checklist, TAZ 5.0 | #N/A | #N/A | #N/A | PCE | 0 | #N/A | #N/A | #N/A | #N/A | 0 | #N/A | #N/A | #N/A | #N/A | #N/A | #N/A | #N/A | #N/A
DC-MS0036 | Packing List, TAZ 5.0 | #N/A | #N/A | #N/A | PCE | 0 | #N/A | #N/A | #N/A | #N/A | 0 | #N/A | #N/A | #N/A | #N/A | #N/A | #N/A | #N/A | #N/A
DC-MS0037 | Colorado Made Green Sticker | #N/A | #N/A | #N/A | PCE | 0 | #N/A | #N/A | #N/A | #N/A | 0 | #N/A | #N/A | #N/A | #N/A | #N/A | #N/A | #N/A | #N/A
DC-MS0038 | Lulzbot Mini Promo Postcard | #N/A | #N/A | #N/A | PCE | 0 | #N/A | #N/A | #N/A | #N/A | 0 | #N/A | #N/A | #N/A | #N/A | #N/A | #N/A | #N/A | #N/A
DC-MS0039 | Lulzbot MINI Brochure | #N/A | #N/A | #N/A | PCE | 0 | #N/A | #N/A | #N/A | #N/A | 0 | #N/A | #N/A | #N/A | #N/A | #N/A | #N/A | #N/A | #N/A
DC-MS0040 | TAZ 4, One Pager (Brochure and Specs) | #N/A | #N/A | #N/A | PCE | 0 | #N/A | #N/A | #N/A | #N/A | 0 | #N/A | #N/A | #N/A | #N/A | #N/A | #N/A | #N/A | #N/A
DC-MS0041 | EC Declaration of Conformity, TAZ v5.0 | #N/A | #N/A | #N/A | PCE | 0 | #N/A | #N/A | #N/A | #N/A | 0 | #N/A | #N/A | #N/A | #N/A | #N/A | #N/A | #N/A | #N/A
DC-MS0042 | TAZ 5, One Pager (Brochure and Specs) | #N/A | #N/A | #N/A | PCE | 0 | #N/A | #N/A | #N/A | #N/A | 0 | #N/A | #N/A | #N/A | #N/A | #N/A | #N/A | #N/A | #N/A
DC-MS0043 | Vinyl Lulzbot Wall Graphic, 4/0, contour cut, 24 x 30 White # 3M Control Tac IJ180 CV3 Matte , high resolution ink jet on 1 side | #N/A | #N/A | #N/A | PCE | DC-MS0043 | #N/A | #N/A | #N/A | #N/A | 0 | #N/A | #N/A | #N/A | #N/A | #N/A | #N/A | #N/A | #N/A
DC-MS0044 | LulzBot Give-Away Banner v2 | #N/A | #N/A | #N/A | PCE | 0 | #N/A | #N/A | #N/A | #N/A | 0 | #N/A | #N/A | #N/A | #N/A | #N/A | #N/A | #N/A | #N/A
DC-MS0045 | LulzBot_Give-Away_Banner_Final | #N/A | #N/A | #N/A | PCE | 0 | #N/A | #N/A | #N/A | #N/A | 0 | #N/A | #N/A | #N/A | #N/A | #N/A | #N/A | #N/A | #N/A
DC-MS0046 | Warning sheet, TAZ | #N/A | #N/A | #N/A | PCE | 0 | #N/A | #N/A | #N/A | #N/A | 0 | #N/A | #N/A | #N/A | #N/A | #N/A | #N/A | #N/A | #N/A
DC-MS0047 | v2 - CONGRATULATIONS!- Tool Head Instruction Card | #N/A | #N/A | #N/A | PCE | 0 | #N/A | #N/A | #N/A | #N/A | 0 | #N/A | #N/A | #N/A | #N/A | #N/A | #N/A | #N/A | #N/A
DC-MS0048 | TAZ 1 Page Brochure v. 3.1 | #N/A | #N/A | #N/A | PCE | 0 | #N/A | #N/A | #N/A | #N/A | 0 | #N/A | #N/A | #N/A | #N/A | #N/A | #N/A | #N/A | #N/A
DC-MS0049 | Test/Acceptance record TAZ 6.0 | #N/A | #N/A | #N/A | PCE | 0 | #N/A | #N/A | #N/A | #N/A | 0 | #N/A | #N/A | #N/A | #N/A | #N/A | #N/A | #N/A | #N/A
DC-MS0050 | Packing List, TAZ 6.0 | #N/A | #N/A | #N/A | PCE | 0 | #N/A | #N/A | #N/A | #N/A | 0 | #N/A | #N/A | #N/A | #N/A | #N/A | #N/A | #N/A | #N/A
DC-MS0051 | EC Declaration of Conformity, TAZ 6.0 | #N/A | #N/A | #N/A | PCE | 0 | #N/A | #N/A | #N/A | #N/A | 0 | #N/A | #N/A | #N/A | #N/A | #N/A | #N/A | #N/A | #N/A
DC-MS0052 | Safety Warnings sheet, TAZ 6.0 | #N/A | #N/A | #N/A | PCE | 0 | #N/A | #N/A | #N/A | #N/A | 0 | #N/A | #N/A | #N/A | #N/A | #N/A | #N/A | #N/A | #N/A
DC-MS0053 | LulzBot Give-Away Banner | #N/A | #N/A | #N/A | PCE | 0 | #N/A | #N/A | #N/A | #N/A | 0 | #N/A | #N/A | #N/A | #N/A | #N/A | #N/A | #N/A | #N/A
DC-MS0054 | Firmware Update Warning Cards | #N/A | #N/A | #N/A | PCE | 0 | #N/A | #N/A | #N/A | #N/A | 0 | #N/A | #N/A | #N/A | #N/A | #N/A | #N/A | #N/A | #N/A
DC-MS0055 | TAZ 6 One-Page Flyers | #N/A | #N/A | #N/A | PCE | 0 | #N/A | #N/A | #N/A | #N/A | 0 | #N/A | #N/A | #N/A | #N/A | #N/A | #N/A | #N/A | #N/A
DC-MS0056 | Frosted Vinyl Applique Sticker | #N/A | #N/A | #N/A | PCE | 0 | #N/A | #N/A | #N/A | #N/A | 0 | #N/A | #N/A | #N/A | #N/A | #N/A | #N/A | #N/A | #N/A
DC-MS0057 | Mini One-Page Flyers | #N/A | #N/A | #N/A | PCE | 0 | #N/A | #N/A | #N/A | #N/A | 0 | #N/A | #N/A | #N/A | #N/A | #N/A | #N/A | #N/A | #N/A
EL-CA0001 | 6ft USB 2.0 A Male to B Male 28/24AWG Cable | #N/A | #N/A | #N/A | PCE | ALE-0000133 | #N/A | #N/A | #N/A | #N/A | 0 | #N/A | #N/A | #N/A | #N/A | #N/A | #N/A | #N/A | #N/A
EL-CA0002 | AC Power Cable w/ Bare End | #N/A | #N/A | #N/A | PCE | ALE-0000132 | #N/A | #N/A | #N/A | #N/A | 0 | #N/A | #N/A | #N/A | #N/A | #N/A | #N/A | #N/A | #N/A
EL-CA0003 | 1.5ft USB 2.0 A Male to A Male 28/24AWG Cable (Gold Plated) | #N/A | #N/A | #N/A | PCE | 5441 | #N/A | #N/A | #N/A | #N/A | 0 | #N/A | #N/A | #N/A | #N/A | #N/A | #N/A | #N/A | #N/A
EL-CA0004 | 15ft USB 2.0 A Male to A Male 28/24AWG Cable (Gold Plated) | #N/A | #N/A | #N/A | PCE | 5445 | #N/A | #N/A | #N/A | #N/A | 0 | #N/A | #N/A | #N/A | #N/A | #N/A | #N/A | #N/A | #N/A
EL-CA0005 | 1.5ft USB 2.0 A Male to B Male 28/24AWG Cable - (Gold Plated) | #N/A | #N/A | #N/A | PCE | 5436 | #N/A | #N/A | #N/A | #N/A | 0 | #N/A | #N/A | #N/A | #N/A | #N/A | #N/A | #N/A | #N/A
EL-CA0006 | 15ft USB 2.0 A Male to B Male 28/24AWG Cable (Gold Plated) | #N/A | #N/A | #N/A | PCE | 5440 | #N/A | #N/A | #N/A | #N/A | 0 | #N/A | #N/A | #N/A | #N/A | #N/A | #N/A | #N/A | #N/A
EL-CA0007 | 3ft USB 2.0 A Male to A Male 28/24AWG Cable (Gold Plated) | #N/A | #N/A | #N/A | PCE | 5442 | #N/A | #N/A | #N/A | #N/A | 0 | #N/A | #N/A | #N/A | #N/A | #N/A | #N/A | #N/A | #N/A
EL-CA0008 | 3ft USB 2.0 A Male to B Male 28/24AWG Cable - (Gold Plated) | #N/A | #N/A | #N/A | PCE | 5437 | #N/A | #N/A | #N/A | #N/A | 0 | #N/A | #N/A | #N/A | #N/A | #N/A | #N/A | #N/A | #N/A
EL-CA0009 | 6ft USB 2.0 A Male to A Male 28/24AWG Cable (Gold Plated) | #N/A | #N/A | #N/A | PCE | 5443 | #N/A | #N/A | #N/A | #N/A | 0 | #N/A | #N/A | #N/A | #N/A | #N/A | #N/A | #N/A | #N/A
EL-CA0010 | 10ft USB 2.0 A Male to B Male 28/24AWG Cable (Gold Plated) | #N/A | #N/A | #N/A | PCE | 5439 | #N/A | #N/A | #N/A | #N/A | 0 | #N/A | #N/A | #N/A | #N/A | #N/A | #N/A | #N/A | #N/A
EL-CA0011 | 10ft USB 2.0 A Male to Mini-B 5pin Male 28/24AWG Cable w/ Ferrite Core (Gold Plated) | #N/A | #N/A | #N/A | PCE | 5449 | #N/A | #N/A | #N/A | #N/A | 0 | #N/A | #N/A | #N/A | #N/A | #N/A | #N/A | #N/A | #N/A
EL-CA0012 | 100cm Length Wire K-type Thermocouple Sensor Probe Temperature 1M Cable New | #N/A | #N/A | #N/A | PCE | 0 | #N/A | #N/A | #N/A | #N/A | 0 | #N/A | #N/A | #N/A | #N/A | #N/A | #N/A | #N/A | #N/A
EL-CA0013 | Ativa® 3' High-Speed HDMI Cable, Black | #N/A | #N/A | #N/A | PCE | 482038 | #N/A | #N/A | #N/A | #N/A | 0 | #N/A | #N/A | #N/A | #N/A | #N/A | #N/A | #N/A | #N/A
EL-CA0014 | BNC to USB Video Converter Cable, 2M length | #N/A | #N/A | #N/A | PCE | 51935 | #N/A | #N/A | #N/A | #N/A | 0 | #N/A | #N/A | #N/A | #N/A | #N/A | #N/A | #N/A | #N/A
EL-CA0015 | CBL, MNG, PVC, 6' | #N/A | #N/A | #N/A | PCE | 284410 | #N/A | #N/A | #N/A | #N/A | 0 | #N/A | #N/A | #N/A | #N/A | #N/A | #N/A | #N/A | #N/A
EL-CA0016 | Flat Cables .050" 10C SHIELDED BLACK 28AWG STRANDED | #N/A | #N/A | #N/A | ft | 517-3517/10 | #N/A | #N/A | #N/A | #N/A | 0 | #N/A | #N/A | #N/A | #N/A | #N/A | #N/A | #N/A | #N/A
EL-CA0016 old | (Obsolete) Flat Cables .050" 10C SHIELDED BLACK 28AWG STRANDED | #N/A | #N/A | #N/A | PCE | 517-3517/10 | #N/A | #N/A | #N/A | #N/A | 0 | #N/A | #N/A | #N/A | #N/A | #N/A | #N/A | #N/A | #N/A
EL-CA0017 | HDMI cable for Raspberry Pi | #N/A | #N/A | #N/A | PCE | 0 | #N/A | #N/A | #N/A | #N/A | 0 | #N/A | #N/A | #N/A | #N/A | #N/A | #N/A | #N/A | #N/A
EL-CA0018 | Lot of Male to Male A/A USB cables | #N/A | #N/A | #N/A | PCE | 0 | #N/A | #N/A | #N/A | #N/A | 0 | #N/A | #N/A | #N/A | #N/A | #N/A | #N/A | #N/A | #N/A
EL-CA0019 | USB DATA CABLE | #N/A | #N/A | #N/A | PCE | 0 | #N/A | #N/A | #N/A | #N/A | 0 | #N/A | #N/A | #N/A | #N/A | #N/A | #N/A | #N/A | #N/A
EL-CA0020 | USB Extension Cable | #N/A | #N/A | #N/A | PCE | 0 | #N/A | #N/A | #N/A | #N/A | 0 | #N/A | #N/A | #N/A | #N/A | #N/A | #N/A | #N/A | #N/A
EL-CA0021 | AmazonBasics High-Speed HDMI Cable (6.5 Feet/2.0 Meters) - Supports Ethernet, 3D, and Audio Return [Newest Standard] | #N/A | #N/A | #N/A | PCE | B003L1ZYYM | #N/A | #N/A | #N/A | #N/A | 0 | #N/A | #N/A | #N/A | #N/A | #N/A | #N/A | #N/A | #N/A
EL-CA0022 | Micro HDMI Low Profile Cable | #N/A | #N/A | #N/A | PCE | 8818542 | #N/A | #N/A | #N/A | #N/A | 0 | #N/A | #N/A | #N/A | #N/A | #N/A | #N/A | #N/A | #N/A
EL-CA0023 | 50ft Ultra Slim Series High Performance HDMI® Cable w/ RedMere® Technology | #N/A | #N/A | #N/A | PCE | 9432 | #N/A | #N/A | #N/A | #N/A | 0 | #N/A | #N/A | #N/A | #N/A | #N/A | #N/A | #N/A | #N/A
EL-CA0024 | 3FT 24AWG Cat5e 350MHz UTP Bare Copper Ethernet Network Cable - Black, 2132 | #N/A | #N/A | #N/A | PCE | 2132 | #N/A | #N/A | #N/A | #N/A | 0 | #N/A | #N/A | #N/A | #N/A | #N/A | #N/A | #N/A | #N/A
EL-CA0025 | 7FT 24AWG Cat5e 350MHz UTP Bare Copper Ethernet Network Cable - Black, 2139 | #N/A | #N/A | #N/A | PCE | 2139 | #N/A | #N/A | #N/A | #N/A | 0 | #N/A | #N/A | #N/A | #N/A | #N/A | #N/A | #N/A | #N/A
EL-CA0026 | 14FT 24AWG Cat5e 350MHz UTP Bare Copper Ethernet Network Cable - Black, 2145 | #N/A | #N/A | #N/A | PCE | 2145 | #N/A | #N/A | #N/A | #N/A | 0 | #N/A | #N/A | #N/A | #N/A | #N/A | #N/A | #N/A | #N/A
EL-CA0027 | 20FT 24AWG Cat5e 350MHz UTP Bare Copper Ethernet Network Cable - Black, 4984 | #N/A | #N/A | #N/A | PCE | 4984 | #N/A | #N/A | #N/A | #N/A | 0 | #N/A | #N/A | #N/A | #N/A | #N/A | #N/A | #N/A | #N/A
EL-CA0028 | 25FT 24AWG Cat5e 350MHz UTP Bare Copper Ethernet Network Cable - Black, 2151 | #N/A | #N/A | #N/A | PCE | 2151 | #N/A | #N/A | #N/A | #N/A | 0 | #N/A | #N/A | #N/A | #N/A | #N/A | #N/A | #N/A | #N/A
EL-CA0029 | 10FT 24AWG Cat5e 350MHz UTP Bare Copper Ethernet Network Cable - Black, 3384 | #N/A | #N/A | #N/A | PCE | 3384 | #N/A | #N/A | #N/A | #N/A | 0 | #N/A | #N/A | #N/A | #N/A | #N/A | #N/A | #N/A | #N/A
EL-CA0030 | North American - 6ft 18AWG Power Cord Cable w/ 3 Conductor PC Power Connector Socket (C13/5-15P) - Black, 5279, Box of 125 | 0 | 0 | 0 | PCE | 5279 | Electronic | 1.1 |  | 0 | 0 | Linvox | 5279 | 0 | 0 | 0 | 0 | 0 | 0
EL-CA0031 | 6ft 18AWG England Power Cord Cable - H05VV-F NEMA C13 - Black , Box of 75 | 0 | 0 | 0 | PCE | 7691 | Electronic | 1.98 |  | 0 | 0 | Linvox | 7691 |  | 0 | 0 | 0 | 0 | 0
EL-CA0032 | 6ft 18AWG European Power Cord Cable - H05VV-F NEMA C13 - Black order in 125 qty boxes | 0 | 0 | 0 | PCE | 7692 | Electronic | 1.25 |  | 0 | 0 | Linvox | 7692 |  | 0 | 0 | 0 | 0 | 0
EL-CA0033 | 10ft 18AWG Power Cord Cable w/ 3 Conductor PC Power Connector Socket (C13/5-15P) - Black, 5280 | #N/A | #N/A | #N/A | PCE | 5280 | #N/A | #N/A | #N/A | #N/A | 0 | #N/A | #N/A | #N/A | #N/A | #N/A | #N/A | #N/A | #N/A
EL-CA0034 | 15ft 18AWG Power Cord Cable w/ 3 Conductor PC Power Connector Socket (C13/5-15P) - Black, 5281 | #N/A | #N/A | #N/A | PCE | 5281 | #N/A | #N/A | #N/A | #N/A | 0 | #N/A | #N/A | #N/A | #N/A | #N/A | #N/A | #N/A | #N/A
EL-CA0035 | CABLE 22AWG 2COND 300V 152M | #N/A | #N/A | #N/A | PCE | T3008-152-ND | #N/A | #N/A | #N/A | #N/A | 0 | #N/A | #N/A | #N/A | #N/A | #N/A | #N/A | #N/A | #N/A
EL-CA0036 | Velcro Reusable Self-Gripping Cable Ties, 0.5 Inches x 8 Inches Long, Black, 100 Ties per Pack (91140) | #N/A | #N/A | #N/A | PCE | 0 | #N/A | #N/A | #N/A | #N/A | 0 | #N/A | #N/A | #N/A | #N/A | #N/A | #N/A | #N/A | #N/A
EL-CA0037 | 5FT 24AWG Cat5e 350MHz UTP Bare Copper Ethernet Network Cable - Black, 3375 | #N/A | #N/A | #N/A | PCE | 0 | #N/A | #N/A | #N/A | #N/A | 0 | #N/A | #N/A | #N/A | #N/A | #N/A | #N/A | #N/A | #N/A
EL-CA0038 | Patch Cord, Cat5E, 7 foot | #N/A | #N/A | #N/A | PCE | 0 | #N/A | #N/A | #N/A | #N/A | 0 | #N/A | #N/A | #N/A | #N/A | #N/A | #N/A | #N/A | #N/A
EL-CA0039 | Patch Cord, Cat5E, 10 foot | #N/A | #N/A | #N/A | PCE | 0 | #N/A | #N/A | #N/A | #N/A | 0 | #N/A | #N/A | #N/A | #N/A | #N/A | #N/A | #N/A | #N/A
EL-CA0040 | Patch Cord, Cat5E, 3 foot | #N/A | #N/A | #N/A | PCE | 0 | #N/A | #N/A | #N/A | #N/A | 0 | #N/A | #N/A | #N/A | #N/A | #N/A | #N/A | #N/A | #N/A
EL-CA0041 | C2G / Cables to Go 27329 WSB 2.0 A to Mini-B Cable, Black (1 Meter/3.28 Feet) | #N/A | #N/A | #N/A | PCE | 0 | #N/A | #N/A | #N/A | #N/A | 0 | #N/A | #N/A | #N/A | #N/A | #N/A | #N/A | #N/A | #N/A
EL-CA0042 | 50 Ft Power Extension Cable | #N/A | #N/A | #N/A | PCE | 0 | #N/A | #N/A | #N/A | #N/A | 0 | #N/A | #N/A | #N/A | #N/A | #N/A | #N/A | #N/A | #N/A
EL-CA0043 | Olimex Ribbon Cables / IDC Cables UEXT FEM-FEM REPLACEMENT CABLE | #N/A | #N/A | #N/A | PCE | 909-CABLE-IDC40-15CM | #N/A | #N/A | #N/A | #N/A | 0 | #N/A | #N/A | #N/A | #N/A | #N/A | #N/A | #N/A | #N/A
EL-CA0044 | Olimex Specialized Cables USB TO SERIAL CABLE | #N/A | #N/A | #N/A | PCE | 1188-1018-ND | #N/A | #N/A | #N/A | #N/A | 0 | #N/A | #N/A | #N/A | #N/A | #N/A | #N/A | #N/A | #N/A
EL-CA0045 | 1.5ft USB 2.0 A Male to Micro 5pin Male 28/28AWG Cable | #N/A | #N/A | #N/A | PCE | 5137 | #N/A | #N/A | #N/A | #N/A | 0 | #N/A | #N/A | #N/A | #N/A | #N/A | #N/A | #N/A | #N/A
EL-CA0046 | Panel Mount USB Cable - A Male to A Female | #N/A | #N/A | #N/A | PCE | 908 | #N/A | #N/A | #N/A | #N/A | 0 | #N/A | #N/A | #N/A | #N/A | #N/A | #N/A | #N/A | #N/A
EL-CA0047 | Panel Mount Ethernet Extension Cable | #N/A | #N/A | #N/A | PCE | 909 | #N/A | #N/A | #N/A | #N/A | 0 | #N/A | #N/A | #N/A | #N/A | #N/A | #N/A | #N/A | #N/A
EL-CA0048 | 1.5ft 28AWG High Speed HDMI® Cable w/Ferrite Cores - Black | #N/A | #N/A | #N/A | PCE | 3872 | #N/A | #N/A | #N/A | #N/A | 0 | #N/A | #N/A | #N/A | #N/A | #N/A | #N/A | #N/A | #N/A
EL-CA0049 | Serial Debug Cable for pcDuino | #N/A | #N/A | #N/A | PCE | SERCAB_PCDUINO_O29 | #N/A | #N/A | #N/A | #N/A | 0 | #N/A | #N/A | #N/A | #N/A | #N/A | #N/A | #N/A | #N/A
EL-CA0050 | 15ft 24AWG CL2 Standard HDMI® Cable Male to Female Extension - Black, 3344 | #N/A | #N/A | #N/A | PCE | 3344 | #N/A | #N/A | #N/A | #N/A | 0 | #N/A | #N/A | #N/A | #N/A | #N/A | #N/A | #N/A | #N/A
EL-CA0051 | 25ft 24AWG CL2 Standard HDMI® Cable Male to Female Extension - Black, 3345 | #N/A | #N/A | #N/A | PCE | 3345 | #N/A | #N/A | #N/A | #N/A | 0 | #N/A | #N/A | #N/A | #N/A | #N/A | #N/A | #N/A | #N/A
EL-CA0052 | 10ft 24AWG CL2 Silver Plated High Speed HDMI® Cable - Black, 3659 | #N/A | #N/A | #N/A | PCE | 3659 | #N/A | #N/A | #N/A | #N/A | 0 | #N/A | #N/A | #N/A | #N/A | #N/A | #N/A | #N/A | #N/A
EL-CA0053 | CABLE 40COND GRAY 25' RIBBON | #N/A | #N/A | #N/A | PCE | AE40A-25-ND | #N/A | #N/A | #N/A | #N/A | 0 | #N/A | #N/A | #N/A | #N/A | #N/A | #N/A | #N/A | #N/A
EL-CA0054 | AmazonBasics High-Speed HDMI Cable - 3 Feet (0.9 Meter) - Supports Ethernet, 3D and Audio Return | #N/A | #N/A | #N/A | PCE | RFQ442 | #N/A | #N/A | #N/A | #N/A | 0 | #N/A | #N/A | #N/A | #N/A | #N/A | #N/A | #N/A | #N/A
EL-CA0055 | 7FT FLEXboot Series 24AWG Cat5e 350MHz UTP Bare Copper Ethernet Network Cable - Black, 11381 | #N/A | #N/A | #N/A | PCE | 11381 | #N/A | #N/A | #N/A | #N/A | 0 | #N/A | #N/A | #N/A | #N/A | #N/A | #N/A | #N/A | #N/A
EL-CA0056 | 6ft 18AWG Australian Power Cord Cable - H05VV-FNEMA C13 - Black, Box of 75 | #N/A | #N/A | #N/A | PCE | 7670 | #N/A | #N/A | #N/A | #N/A | 0 | #N/A | #N/A | #N/A | #N/A | #N/A | #N/A | #N/A | #N/A
EL-CA0057 | Cable Assembly SMA STR Plug RG58 36" | #N/A | #N/A | #N/A | PCE | ACX17236-ND | #N/A | #N/A | #N/A | #N/A | 0 | #N/A | #N/A | #N/A | #N/A | #N/A | #N/A | #N/A | #N/A
EL-CA0059 | 110A Probe Cable | #N/A | #N/A | #N/A | PCE | 110A | #N/A | #N/A | #N/A | #N/A | 0 | #N/A | #N/A | #N/A | #N/A | #N/A | #N/A | #N/A | #N/A
EL-CA0060 | Cable Molded RG58/U 48" | #N/A | #N/A | #N/A | PCE | 290-1012-ND | #N/A | #N/A | #N/A | #N/A | 0 | #N/A | #N/A | #N/A | #N/A | #N/A | #N/A | #N/A | #N/A
EL-CA0061 | Black Extension Cord, 14 Gauge Wire, 3' Long | #N/A | #N/A | #N/A | PCE | 9581T21 | #N/A | #N/A | #N/A | #N/A | 0 | #N/A | #N/A | #N/A | #N/A | #N/A | #N/A | #N/A | #N/A
EL-CA0062 | Black Extension Cord, 14 Gauge Wire, 6' Long | #N/A | #N/A | #N/A | PCE | 5388K14 | #N/A | #N/A | #N/A | #N/A | 0 | #N/A | #N/A | #N/A | #N/A | #N/A | #N/A | #N/A | #N/A
EL-CA0063 | 6ft Tripp Lite - USB 2.0 A/B Gold Device Cable Ferrite Chokes A Male B Male | Y | 0 | 0 | PCE | U023-006 | Electronic | 2.89 |  | 0 | U023-006 | EDC (Electronics Distributors Corp. | Tripplite U023-006 | 0 | 0 | 0 | 0 | 0 | 0
EL-CA0064 | Cable 2PR CPU SHLD PVC 22 AWG 50' | #N/A | #N/A | #N/A | PCE | C1352-50-ND | #N/A | #N/A | #N/A | #N/A | 0 | #N/A | #N/A | #N/A | #N/A | #N/A | #N/A | #N/A | #N/A
EL-CA0065 | 3ft Passive HDMI Cable - Black | #N/A | #N/A | #N/A | PCE | 11559 | #N/A | #N/A | #N/A | #N/A | 0 | #N/A | #N/A | #N/A | #N/A | #N/A | #N/A | #N/A | #N/A
EL-CA0066 | 10FT 24AWG Cat5e 350MHz UTP Bare Copper Ethernet Network Cable - White | #N/A | #N/A | #N/A | PCE | 3391 | #N/A | #N/A | #N/A | #N/A | 0 | #N/A | #N/A | #N/A | #N/A | #N/A | #N/A | #N/A | #N/A
EL-CA0067 | Coboc CY-CAT5E-10-BK 10ft.24AWG Snagless Cat 5e Black Color 350MHz UTP Ethernet Stranded Copper Patch cord /Molded Network lan C | #N/A | #N/A | #N/A | PCE | N82E16812422007 | #N/A | #N/A | #N/A | #N/A | 0 | #N/A | #N/A | #N/A | #N/A | #N/A | #N/A | #N/A | #N/A
EL-CA0068 | 1.5 Feet USB 2.0 Extender Cable - A Male to A Female 28/24AWG Extension Gold Plated (Black) | #N/A | #N/A | #N/A | PCE | B00GCG94WG | #N/A | #N/A | #N/A | #N/A | 0 | #N/A | #N/A | #N/A | #N/A | #N/A | #N/A | #N/A | #N/A
EL-CA0069 | 15ft USB 2.0 A Male to Micro 5pin Male 28/24 AWG Cable w/Ferrite Core (Gold Plated) | #N/A | #N/A | #N/A | PCE | 5460 | #N/A | #N/A | #N/A | #N/A | 0 | #N/A | #N/A | #N/A | #N/A | #N/A | #N/A | #N/A | #N/A
EL-CA0070 | 15ft. USB 2.0 A Male to Mini - B 5pin Male 28/24 AWG Cable w/Ferrite Core (Gold Plated) | #N/A | #N/A | #N/A | PCE | 5450 | #N/A | #N/A | #N/A | #N/A | 0 | #N/A | #N/A | #N/A | #N/A | #N/A | #N/A | #N/A | #N/A
EL-CA0071 | Plantronics APD-80 CS500/SAVI EHS For Grandstream | #N/A | #N/A | #N/A | PCE | 87327-01 | #N/A | #N/A | #N/A | #N/A | 0 | #N/A | #N/A | #N/A | #N/A | #N/A | #N/A | #N/A | #N/A
EL-CA0072 | 10ft USB Cable 2.0 EXT 3M Gold, A Male to A Female | #N/A | #N/A | #N/A | PCE | TL383-ND | #N/A | #N/A | #N/A | #N/A | 0 | #N/A | #N/A | #N/A | #N/A | #N/A | #N/A | #N/A | #N/A
EL-CA0073 | Belden 1310A 010U500 Multi-Conductor Cables 14AWG 4C UNSHLD, BLACK | #N/A | #N/A | #N/A | mm | 1310A 010U500 | #N/A | #N/A | #N/A | #N/A | 0 | #N/A | #N/A | #N/A | #N/A | #N/A | #N/A | #N/A | #N/A
EL-CA0073- old | OLD - Multi-Conductor Cables 14AWG 4C UNSHLD 500ft BOX BLACK | #N/A | #N/A | #N/A | PCE | 566-1310A-U500-10 | #N/A | #N/A | #N/A | #N/A | 0 | #N/A | #N/A | #N/A | #N/A | #N/A | #N/A | #N/A | #N/A
EL-CA0074 | AmazonBasics High-Speed HDMI Cable 2-Pack - 3 Feet | #N/A | #N/A | #N/A | PCE | B00L3KNY22 | #N/A | #N/A | #N/A | #N/A | 0 | #N/A | #N/A | #N/A | #N/A | #N/A | #N/A | #N/A | #N/A
EL-CA0075 | Monoprice 109767 3-Feet 3.5mm Stereo Male to RCA Stereo Male Gold Plated Cable for Mobile, Black | #N/A | #N/A | #N/A | PCE | 109767 or B00AJHBES6 | #N/A | #N/A | #N/A | #N/A | 0 | #N/A | #N/A | #N/A | #N/A | #N/A | #N/A | #N/A | #N/A
EL-CA0076 | Ativa® 6' High-Speed HDMI Cable Kit, Black | #N/A | #N/A | #N/A | PCE | 443149 | #N/A | #N/A | #N/A | #N/A | 0 | #N/A | #N/A | #N/A | #N/A | #N/A | #N/A | #N/A | #N/A
EL-CA0077 | ONN miniHDMI to HDMI Cable, 3', Black | #N/A | #N/A | #N/A | PCE | 68113107335 | #N/A | #N/A | #N/A | #N/A | 0 | #N/A | #N/A | #N/A | #N/A | #N/A | #N/A | #N/A | #N/A
EL-CA0078 | Flat Cables .050" 10C 10 COLOR 28AWG STRANDED 2x180mm | #N/A | #N/A | #N/A | mm | 517-3302/10-300 | #N/A | #N/A | #N/A | #N/A | 3302/10-300 | #N/A | #N/A | #N/A | #N/A | #N/A | #N/A | #N/A | #N/A
EL-CA0079 | Electop USB 2.0 A Female To 2 Dual USB Male Jack Y Splitter Charger Cable | #N/A | #N/A | #N/A | PCE | 0 | #N/A | #N/A | #N/A | #N/A | 0 | #N/A | #N/A | #N/A | #N/A | #N/A | #N/A | #N/A | #N/A
EL-CA0080 | 6ft 16 AWG 1-to-2 Power Cord Splitter (NEMA 5-15P to 1 NEMA 5-15R + 1 IEC320C13) | #N/A | #N/A | #N/A | PCE | 29812 | #N/A | #N/A | #N/A | #N/A | 0 | #N/A | #N/A | #N/A | #N/A | #N/A | #N/A | #N/A | #N/A
EL-CA0081 | Cable Matters Micro USB SlimPort (MyDP) to HDMI 6 Foot Cable with 6 Foot USB Charging Cable | #N/A | #N/A | #N/A | PCE | 603002 | #N/A | #N/A | #N/A | #N/A | 603002 | #N/A | #N/A | #N/A | #N/A | #N/A | #N/A | #N/A | #N/A
EL-CA0082 | 6ft Japan NEMA 5-15P 3-pin to C13 Power Cord with VCTF 0.75mm, Black (Box of 100) | #N/A | #N/A | #N/A | PCE | 3271VF76 | #N/A | #N/A | #N/A | #N/A | 3271VF76 | #N/A | #N/A | #N/A | #N/A | #N/A | #N/A | #N/A | #N/A
EL-FA0001 | 40mm Fan, 5.75 CFM | #N/A | #N/A | #N/A | PCE | UM40FAN | #N/A | #N/A | #N/A | #N/A | 0 | #N/A | #N/A | #N/A | #N/A | #N/A | #N/A | #N/A | #N/A
EL-FA0002 | FAN DC 40X10.5MM 12V 6.7CFM | #N/A | #N/A | #N/A | PCE | 1053-1205-ND | #N/A | #N/A | #N/A | #N/A | 0 | #N/A | #N/A | #N/A | #N/A | #N/A | #N/A | #N/A | #N/A
EL-FA0004 | 12vDC Fan 40mm | #N/A | #N/A | #N/A | PCE | TF4010-12H-S | #N/A | #N/A | #N/A | #N/A | 0 | #N/A | #N/A | #N/A | #N/A | #N/A | #N/A | #N/A | #N/A
EL-FA0005 | Brushless DC Cooling Fan 5V or 12V 24V 4010S Blades 40x40x10mm Sleeve-bearing | #N/A | #N/A | #N/A | PCE | 0 | #N/A | #N/A | #N/A | #N/A | 0 | #N/A | #N/A | #N/A | #N/A | #N/A | #N/A | #N/A | #N/A
EL-FA0006 | Fan, 12VDC | #N/A | #N/A | #N/A | PCE | ME40101V1-000U-A99 | #N/A | #N/A | #N/A | #N/A | 0 | #N/A | #N/A | #N/A | #N/A | #N/A | #N/A | #N/A | #N/A
EL-FA0007 | Fan 40x10mm, 5 VDC 0.9Wm 7.0 cfm | #N/A | #N/A | #N/A | PCE | 25-1565-ND | #N/A | #N/A | #N/A | #N/A | 0 | #N/A | #N/A | #N/A | #N/A | #N/A | #N/A | #N/A | #N/A
EL-FA0008 | FAN 40X20MM 12VDC 1.38W 10.8CFM | #N/A | #N/A | #N/A | PCE | 259-1630-ND | #N/A | #N/A | #N/A | #N/A | 0 | #N/A | #N/A | #N/A | #N/A | #N/A | #N/A | #N/A | #N/A
EL-FA0009 | Fans & Blowers 40mm 24VDC 6.8CFM | #N/A | #N/A | #N/A | PCE | 664-D4010HX-G70-LF | #N/A | #N/A | #N/A | #N/A | 0 | #N/A | #N/A | #N/A | #N/A | #N/A | #N/A | #N/A | #N/A
EL-FA0010 | Link Depot FAN-4LED-80BU 80mm | #N/A | #N/A | #N/A | PCE | 0 | #N/A | #N/A | #N/A | #N/A | 0 | #N/A | #N/A | #N/A | #N/A | #N/A | #N/A | #N/A | #N/A
EL-FA0011 | 69829 FAN,24VDC,Sleeve,5.75CFM,40X40X10MM,60mA | 0 | 0 | 0 | PCE | 69829 - TF4010-24H-S | #N/A | #N/A | #N/A | #N/A | TF4010-24H-S | #N/A | #N/A | #N/A | #N/A | #N/A | #N/A | #N/A | #N/A
EL-FA0012 | 69866 FAN,24VDC,BALL,31.60CFM,80×80×15 MM,100mA | 0 | Y | 0 | PCE | 69866 - TF8015-24M-B | #N/A | #N/A | #N/A | #N/A | TF8015-24M-B | #N/A | #N/A | #N/A | #N/A | #N/A | #N/A | #N/A | #N/A
EL-FA0013 | FAN DC 40X10.5MM 12V 5.7CFM | #N/A | #N/A | #N/A | PCE | TF4010-12H-S | #N/A | #N/A | #N/A | #N/A | 0 | #N/A | #N/A | #N/A | #N/A | #N/A | #N/A | #N/A | #N/A
EL-FA0014 | FAN DC 40X10.5MM 24V 6.7CFM | #N/A | #N/A | #N/A | PCE | 1053-1210-ND | #N/A | #N/A | #N/A | #N/A | 0 | #N/A | #N/A | #N/A | #N/A | #N/A | #N/A | #N/A | #N/A
EL-FA0015 | 24V fan for add on kit w/ connector | #N/A | #N/A | #N/A | PCE | 0 | #N/A | #N/A | #N/A | #N/A | 0 | #N/A | #N/A | #N/A | #N/A | #N/A | #N/A | #N/A | #N/A
EL-FA0016 | 12V fan for add on kit w/ connector | #N/A | #N/A | #N/A | PCE | 0 | #N/A | #N/A | #N/A | #N/A | 0 | #N/A | #N/A | #N/A | #N/A | #N/A | #N/A | #N/A | #N/A
EL-FA0017 | TAZ 24V Extruder Fan Add-on Kit | #N/A | #N/A | #N/A | PCE | 0 | #N/A | #N/A | #N/A | #N/A | 0 | #N/A | #N/A | #N/A | #N/A | #N/A | #N/A | #N/A | #N/A
EL-FA0018 | TAZ 12V Extruder Fan Add-on | #N/A | #N/A | #N/A | PCE | TF4010-12H-S | #N/A | #N/A | #N/A | #N/A | 0 | #N/A | #N/A | #N/A | #N/A | #N/A | #N/A | #N/A | #N/A
EL-FA0019 | BLOWER 12VDC 51.6 X 51.6 X 15MM | #N/A | #N/A | #N/A | PCE | 259-1316-ND | #N/A | #N/A | #N/A | #N/A | 0 | #N/A | #N/A | #N/A | #N/A | #N/A | #N/A | #N/A | #N/A
EL-FA0020 | RFB2008 Micro Blower with 30awg wire that is 250mm long | 0 | 0 | 0 | PCE | RFB2008 | Electronic | 6.54 |  | 0 | 0 | Pelonis | 0 | 0 | 0 | 0 | 0 | 0 | 0
EL-FA0021 | BLOWER DC 24V 51X15 6500RPM | Y | #N/A | #N/A | PCE | 603-1116-ND | #N/A | #N/A | #N/A | #N/A | 0 | #N/A | #N/A | #N/A | #N/A | #N/A | #N/A | #N/A | #N/A
EL-FA0022 | FAN 12VDC 30X10MM 3.5CFM | #N/A | #N/A | #N/A | PCE | 259-1615-ND | #N/A | #N/A | #N/A | #N/A | 0 | #N/A | #N/A | #N/A | #N/A | #N/A | #N/A | #N/A | #N/A
EL-FA0023 | 30x30x10mm 24v DC Fan | #N/A | #N/A | #N/A | PCE | 0 | #N/A | #N/A | #N/A | #N/A | 0 | #N/A | #N/A | #N/A | #N/A | #N/A | #N/A | #N/A | #N/A
EL-FA0024 | RFB2008 Micro Blower, 5.5v Retail (DO Not Use - See KT-CP0082) | #N/A | #N/A | #N/A | PCE | 0 | #N/A | #N/A | #N/A | #N/A | 0 | #N/A | #N/A | #N/A | #N/A | #N/A | #N/A | #N/A | #N/A
EL-FA0025 | FAN 24VDC 40X40X10 Crimped Retail | #N/A | #N/A | #N/A | PCE | TF4010-24H-S | #N/A | #N/A | #N/A | #N/A | 0 | #N/A | #N/A | #N/A | #N/A | #N/A | #N/A | #N/A | #N/A
EL-FA0026 | FAN 12vDC 80x80x15 Crimped Retail | #N/A | #N/A | #N/A | PCE | TF8015-24M-B | #N/A | #N/A | #N/A | #N/A | 0 | #N/A | #N/A | #N/A | #N/A | #N/A | #N/A | #N/A | #N/A
EL-FA0027 | RFB2008 Micro Blower, 5.5v Crimped RMAs | #N/A | #N/A | #N/A | PCE | 0 | #N/A | #N/A | #N/A | #N/A | 0 | #N/A | #N/A | #N/A | #N/A | #N/A | #N/A | #N/A | #N/A
EL-FA0028 | Computer Fans - System 76 | #N/A | #N/A | #N/A | PCE | 0 | #N/A | #N/A | #N/A | #N/A | 0 | #N/A | #N/A | #N/A | #N/A | #N/A | #N/A | #N/A | #N/A
EL-FA0029 | FAN AXIAL 40X10MM VAPO 5VDC WIRE | #N/A | #N/A | #N/A | PCE | 259-1565-ND | #N/A | #N/A | #N/A | #N/A | 0 | #N/A | #N/A | #N/A | #N/A | #N/A | #N/A | #N/A | #N/A
EL-FA0030 | Dual blower harness for v2.0 dual extruders | #N/A | #N/A | #N/A | PCE | 0 | #N/A | #N/A | #N/A | #N/A | 0 | #N/A | #N/A | #N/A | #N/A | #N/A | #N/A | #N/A | #N/A
EL-FA0031 | Dual 40mm fan harness for v2.0 dual extruders | #N/A | #N/A | #N/A | PCE | 0 | #N/A | #N/A | #N/A | #N/A | 0 | #N/A | #N/A | #N/A | #N/A | #N/A | #N/A | #N/A | #N/A
EL-FA0032 | Pelonis FAN 24V 40mmx40mmx10mm Low flow | Y | #N/A | #N/A | PCE | C4010L24BPLB1b-7 | #N/A | 3.13 | Y- Long Lead | #N/A | C4010L24BPLB1b-7 | Pelonis | #N/A | #N/A | #N/A | #N/A | #N/A | #N/A | #N/A
EL-FA0033 | Pelonis FAN 24V 80x80x15mm Low flow | Y | #N/A | #N/A | PCE | C8015L24BPLP1b-7 | #N/A | 3.12 | Y- Long Lead | #N/A | C8015L24BPLP1b-7 | Pelonis | #N/A | #N/A | #N/A | #N/A | #N/A | #N/A | #N/A
EL-FA0034 | Pelonis FAN 5V 40x40x10mm Low flow | Y | #N/A | #N/A | PCE | C4010L05BPLB1b-7 | #N/A | 3.07 | Y- Long Lead | #N/A | C4010L05BPLB1b-7 | Pelonis | #N/A | #N/A | #N/A | #N/A | #N/A | #N/A | #N/A
EL-FA0035 | Pelonis FAN 24V 40x10mm Medium flow | Y | #N/A | #N/A | PCE | C4010M24BPLP1b-7 | #N/A | #N/A | Y- Long Lead | #N/A | 0 | Pelonis | #N/A | #N/A | #N/A | #N/A | #N/A | #N/A | #N/A
EL-FA0036 | TAZ 6 CB Case Fan Assembly v1.0 | #N/A | #N/A | #N/A | PCE | 0 | #N/A | #N/A | #N/A | #N/A | 0 | #N/A | #N/A | #N/A | #N/A | #N/A | #N/A | #N/A | #N/A
EL-FA0037 | 963E Benchtop Air Ionizer w / North America Power Cord (US/MX only) | #N/A | #N/A | #N/A | PCE | 00051135329573-31196 | #N/A | #N/A | #N/A | #N/A | 963E | #N/A | #N/A | #N/A | #N/A | #N/A | #N/A | #N/A | #N/A
EL-FA0038 | EBM-PAPST FAN AXIAL 40X10MM 24VDC WIRE 414FH | #N/A | #N/A | #N/A | PCE | 381-2367-ND | #N/A | #N/A | #N/A | #N/A | 414FH | #N/A | #N/A | #N/A | #N/A | #N/A | #N/A | #N/A | #N/A
EL-FA0039 | ORION FAN AXIAL 40X10MM 24VDC WIRE OD4010-24HSS | #N/A | #N/A | #N/A | PCE | 1053-1210-ND | #N/A | #N/A | #N/A | #N/A | OD4010-24HSS | #N/A | #N/A | #N/A | #N/A | #N/A | #N/A | #N/A | #N/A
EL-FA0040 | ORION FAN AXIAL 40X10.5MM 24VDC WIRE - OD4010-24HB | #N/A | #N/A | #N/A | PCE | 1053-1208-ND | #N/A | #N/A | #N/A | #N/A | OD4010-24HB | #N/A | #N/A | #N/A | #N/A | #N/A | #N/A | #N/A | #N/A
EL-FA0041 | ORIX MDS410-24, DC Axial Fan | #N/A | #N/A | #N/A | PCE | MDS410-24 | #N/A | #N/A | #N/A | #N/A | MDS410-24 | #N/A | #N/A | #N/A | #N/A | #N/A | #N/A | #N/A | #N/A
EL-FA0044 | Pelonis FAN 80x80x15 Medium flow | Y | #N/A | #N/A | PCE | C8015M24BPLP1b-7 | #N/A | #N/A | #N/A | #N/A | C8015M24BPLP1b-7 | Pelonis | #N/A | #N/A | #N/A | #N/A | #N/A | #N/A | #N/A
EL-FA0045 | Pelonis FAN 80x80x15 High flow | Y | #N/A | #N/A | PCE | C8015H24BPLP1b-7 | #N/A | 3.88 | #N/A | #N/A | C8015H24BPLP1b-7 | Pelonis | #N/A | #N/A | #N/A | #N/A | #N/A | #N/A | #N/A
EL-FA0046 | LiteWorld Protective Enclosure: Additional Fan | #N/A | #N/A | #N/A | PCE | 0 | #N/A | #N/A | #N/A | #N/A | 0 | #N/A | #N/A | #N/A | #N/A | #N/A | #N/A | #N/A | #N/A
EL-HB0000 | 5 RepRap PCB heated beds, Out of Spec | #N/A | #N/A | #N/A | PCE | 0 | #N/A | #N/A | #N/A | #N/A | 0 | #N/A | #N/A | #N/A | #N/A | #N/A | #N/A | #N/A | #N/A
EL-HB0001 | Flexible Silicone-Rubber Heat Sheet Plain Backing, 6" X 6" Sheet, Med Watts/SQ Inch | #N/A | #N/A | #N/A | PCE | 35765K51 | #N/A | #N/A | #N/A | #N/A | 0 | #N/A | #N/A | #N/A | #N/A | #N/A | #N/A | #N/A | #N/A
EL-HB0002 | Heated Bed Kit | #N/A | #N/A | #N/A | PCE | 0 | #N/A | #N/A | #N/A | #N/A | 0 | #N/A | #N/A | #N/A | #N/A | #N/A | #N/A | #N/A | #N/A
EL-HB0003 | Low watts, Flexible Silicone-rubber Heat Sheet Plain backing, 10" x 10" sheet | #N/A | #N/A | #N/A | PCE | 35765k512 | #N/A | #N/A | #N/A | #N/A | 0 | #N/A | #N/A | #N/A | #N/A | #N/A | #N/A | #N/A | #N/A
EL-HB0004 | Med Watts, Flexible Silicone-rubber Heat Sheet Plain Backing, 10" X 10" sheet | #N/A | #N/A | #N/A | PCE | 35765K513 | #N/A | #N/A | #N/A | #N/A | 0 | #N/A | #N/A | #N/A | #N/A | #N/A | #N/A | #N/A | #N/A
EL-HB0005 | PCB Heatbed MK1 - soldered power wires | #N/A | #N/A | #N/A | PCE | 0 | #N/A | #N/A | #N/A | #N/A | 0 | #N/A | #N/A | #N/A | #N/A | #N/A | #N/A | #N/A | #N/A
EL-HB0006 | PCB Heatbed MK1 - soldered power wires and thermistor | #N/A | #N/A | #N/A | PCE | 0 | #N/A | #N/A | #N/A | #N/A | 0 | #N/A | #N/A | #N/A | #N/A | #N/A | #N/A | #N/A | #N/A
EL-HB0007 | Silicone Heating Pads | #N/A | #N/A | #N/A | PCE | 0 | #N/A | #N/A | #N/A | #N/A | 0 | #N/A | #N/A | #N/A | #N/A | #N/A | #N/A | #N/A | #N/A
EL-HB0008 | Silicone Rubber Heater Mat w/ Thermistor 12"x12" | #N/A | #N/A | #N/A | PCE | 0 | #N/A | #N/A | #N/A | #N/A | 0 | #N/A | #N/A | #N/A | #N/A | #N/A | #N/A | #N/A | #N/A
EL-HB0009 | Silicone-Rubber Heat Sheet Plain Backing, 9" X 9" Sheet, Med Watts/SQ Inch | #N/A | #N/A | #N/A | PCE | 35765K55 | #N/A | #N/A | #N/A | #N/A | 0 | #N/A | #N/A | #N/A | #N/A | #N/A | #N/A | #N/A | #N/A
EL-HB0011 | TAZ 5 Heat Bed Kit | #N/A | #N/A | #N/A | PCE | 0 | #N/A | #N/A | #N/A | #N/A | 0 | #N/A | #N/A | #N/A | #N/A | #N/A | #N/A | #N/A | #N/A
EL-HR0000 | Servo Y-Harness PCB | #N/A | #N/A | #N/A | PCE | HH-SC_PCB_YH | #N/A | #N/A | #N/A | #N/A | 0 | #N/A | #N/A | #N/A | #N/A | #N/A | #N/A | #N/A | #N/A
EL-HR0001 | Thermistor Wire Harness | #N/A | #N/A | #N/A | PCE | 0 | #N/A | #N/A | #N/A | #N/A | 0 | #N/A | #N/A | #N/A | #N/A | #N/A | #N/A | #N/A | #N/A
EL-HR0002 | Y Opto Wire Harness, 470mm | #N/A | #N/A | #N/A | PCE | 0 | #N/A | #N/A | #N/A | #N/A | 0 | #N/A | #N/A | #N/A | #N/A | #N/A | #N/A | #N/A | #N/A
EL-HR0003 | X Opto Wire Harness, 680mm | #N/A | #N/A | #N/A | PCE | 0 | #N/A | #N/A | #N/A | #N/A | 0 | #N/A | #N/A | #N/A | #N/A | #N/A | #N/A | #N/A | #N/A
EL-HR0004 | Z Opto Wire Harness, 850mm | #N/A | #N/A | #N/A | PCE | 0 | #N/A | #N/A | #N/A | #N/A | 0 | #N/A | #N/A | #N/A | #N/A | #N/A | #N/A | #N/A | #N/A
EL-HR0006 | Heat bed extensions | #N/A | #N/A | #N/A | PCE | 0 | #N/A | #N/A | #N/A | #N/A | 0 | #N/A | #N/A | #N/A | #N/A | #N/A | #N/A | #N/A | #N/A
EL-HR0007 | Heat bed wiring assembly | #N/A | #N/A | #N/A | PCE | 0 | #N/A | #N/A | #N/A | #N/A | 0 | #N/A | #N/A | #N/A | #N/A | #N/A | #N/A | #N/A | #N/A
EL-HR0009-2 | Y switch extension short, TAZ | #N/A | #N/A | #N/A | PCE | 0 | #N/A | #N/A | #N/A | #N/A | 0 | #N/A | #N/A | #N/A | #N/A | #N/A | #N/A | #N/A | #N/A
EL-HR0010-2 | X switch extension short, TAZ | #N/A | #N/A | #N/A | PCE | 0 | #N/A | #N/A | #N/A | #N/A | 0 | #N/A | #N/A | #N/A | #N/A | #N/A | #N/A | #N/A | #N/A
EL-HR0011 | Jumper wire yellow | #N/A | #N/A | #N/A | PCE | 0 | #N/A | #N/A | #N/A | #N/A | 0 | #N/A | #N/A | #N/A | #N/A | #N/A | #N/A | #N/A | #N/A
EL-HR0012 | Jumper wire red | #N/A | #N/A | #N/A | PCE | 0 | #N/A | #N/A | #N/A | #N/A | 0 | #N/A | #N/A | #N/A | #N/A | #N/A | #N/A | #N/A | #N/A
EL-HR0014 | Power thru case assembly | #N/A | #N/A | #N/A | PCE | 0 | #N/A | #N/A | #N/A | #N/A | 0 | #N/A | #N/A | #N/A | #N/A | #N/A | #N/A | #N/A | #N/A
EL-HR0017-1 | Motor extension -1 | #N/A | #N/A | #N/A | PCE | 0 | #N/A | #N/A | #N/A | #N/A | 0 | #N/A | #N/A | #N/A | #N/A | #N/A | #N/A | #N/A | #N/A
EL-HR0017-2 | Motor extension -2 | #N/A | #N/A | #N/A | PCE | 0 | #N/A | #N/A | #N/A | #N/A | 0 | #N/A | #N/A | #N/A | #N/A | #N/A | #N/A | #N/A | #N/A
EL-HR0017-3 | Motor extension -3 | #N/A | #N/A | #N/A | PCE | 0 | #N/A | #N/A | #N/A | #N/A | 0 | #N/A | #N/A | #N/A | #N/A | #N/A | #N/A | #N/A | #N/A
EL-HR0017-4 | Motor extension -4 | #N/A | #N/A | #N/A | PCE | 0 | #N/A | #N/A | #N/A | #N/A | 0 | #N/A | #N/A | #N/A | #N/A | #N/A | #N/A | #N/A | #N/A
EL-HR0018 | Endstop wire harness from Rambo kit | #N/A | #N/A | #N/A | PCE | 0 | #N/A | #N/A | #N/A | #N/A | 0 | #N/A | #N/A | #N/A | #N/A | #N/A | #N/A | #N/A | #N/A
EL-HR0019 | Switch Wires from RAMBo Kit | #N/A | #N/A | #N/A | PCE | 0 | #N/A | #N/A | #N/A | #N/A | 0 | #N/A | #N/A | #N/A | #N/A | #N/A | #N/A | #N/A | #N/A
EL-HR0020 | 24vDC Power supply assembly | #N/A | #N/A | #N/A | PCE | 0 | #N/A | #N/A | #N/A | #N/A | 0 | #N/A | #N/A | #N/A | #N/A | #N/A | #N/A | #N/A | #N/A
EL-HR0021 | Power through case assembly, TAZ | #N/A | #N/A | #N/A | PCE | 0 | #N/A | #N/A | #N/A | #N/A | 0 | #N/A | #N/A | #N/A | #N/A | #N/A | #N/A | #N/A | #N/A
EL-HR0022 | Heat bed extension assembly, #6 | #N/A | #N/A | #N/A | PCE | 0 | #N/A | #N/A | #N/A | #N/A | 0 | #N/A | #N/A | #N/A | #N/A | #N/A | #N/A | #N/A | #N/A
EL-HR0023 | Y extension assembly, #5 | #N/A | #N/A | #N/A | PCE | 0 | #N/A | #N/A | #N/A | #N/A | 0 | #N/A | #N/A | #N/A | #N/A | #N/A | #N/A | #N/A | #N/A
EL-HR0024 | Budaschnozzle extension, 1300mm | #N/A | #N/A | #N/A | PCE | 0 | #N/A | #N/A | #N/A | #N/A | 0 | #N/A | #N/A | #N/A | #N/A | #N/A | #N/A | #N/A | #N/A
EL-HR0025 | Print head extension, #4 | #N/A | #N/A | #N/A | PCE | 0 | #N/A | #N/A | #N/A | #N/A | 0 | #N/A | #N/A | #N/A | #N/A | #N/A | #N/A | #N/A | #N/A
EL-HR0026 | Z switch extension assembly, #1 | #N/A | #N/A | #N/A | PCE | 0 | #N/A | #N/A | #N/A | #N/A | 0 | #N/A | #N/A | #N/A | #N/A | #N/A | #N/A | #N/A | #N/A
EL-HR0027 | Z right motor extension assembly, #2 | #N/A | #N/A | #N/A | PCE | 0 | #N/A | #N/A | #N/A | #N/A | 0 | #N/A | #N/A | #N/A | #N/A | #N/A | #N/A | #N/A | #N/A
EL-HR0028 | X extension assembly, #3A | #N/A | #N/A | #N/A | PCE | 0 | #N/A | #N/A | #N/A | #N/A | 0 | #N/A | #N/A | #N/A | #N/A | #N/A | #N/A | #N/A | #N/A
EL-HR0029 | X switch extension assembly, #3B | #N/A | #N/A | #N/A | PCE | 0 | #N/A | #N/A | #N/A | #N/A | 0 | #N/A | #N/A | #N/A | #N/A | #N/A | #N/A | #N/A | #N/A
EL-HR0030 | AMP-3K TERMINATOR MACHINE RENTAL | #N/A | #N/A | #N/A | PCE | 1725950-2 | #N/A | #N/A | #N/A | #N/A | 0 | #N/A | #N/A | #N/A | #N/A | #N/A | #N/A | #N/A | #N/A
EL-HR0031 | ANVIL | #N/A | #N/A | #N/A | PCE | 1333228-2 | #N/A | #N/A | #N/A | #N/A | 0 | #N/A | #N/A | #N/A | #N/A | #N/A | #N/A | #N/A | #N/A
EL-HR0032 | ANVIL, COMBINATION (.055) | #N/A | #N/A | #N/A | PCE | 1-1333201-1 | #N/A | #N/A | #N/A | #N/A | 0 | #N/A | #N/A | #N/A | #N/A | #N/A | #N/A | #N/A | #N/A
EL-HR0033 | CRIMPER, INSULATION (.070) | #N/A | #N/A | #N/A | PCE | 2-456135-2 | #N/A | #N/A | #N/A | #N/A | 0 | #N/A | #N/A | #N/A | #N/A | #N/A | #N/A | #N/A | #N/A
EL-HR0034 | CRIMPER, INSUL O PREMIUM | #N/A | #N/A | #N/A | PCE | 2119784.7 | #N/A | #N/A | #N/A | #N/A | 0 | #N/A | #N/A | #N/A | #N/A | #N/A | #N/A | #N/A | #N/A
EL-HR0035 | CRIMPER, WIRE .062 F | #N/A | #N/A | #N/A | PCE | 1-456403-2 | #N/A | #N/A | #N/A | #N/A | 0 | #N/A | #N/A | #N/A | #N/A | #N/A | #N/A | #N/A | #N/A
EL-HR0036 | CRIMPER, WIRE .090 F | #N/A | #N/A | #N/A | PCE | 4-456406-7 | #N/A | #N/A | #N/A | #N/A | 0 | #N/A | #N/A | #N/A | #N/A | #N/A | #N/A | #N/A | #N/A
EL-HR0037 | FLOATING SHEAR | #N/A | #N/A | #N/A | PCE | 454276-1 | #N/A | #N/A | #N/A | #N/A | 0 | #N/A | #N/A | #N/A | #N/A | #N/A | #N/A | #N/A | #N/A
EL-HR0038 | FLOATING SHEAR | #N/A | #N/A | #N/A | PCE | 462006-6 | #N/A | #N/A | #N/A | #N/A | 0 | #N/A | #N/A | #N/A | #N/A | #N/A | #N/A | #N/A | #N/A
EL-HR0039 | HD-I 5SMPR055F070O BENCH RENTAL | #N/A | #N/A | #N/A | PCE | 1426179-2 | #N/A | #N/A | #N/A | #N/A | 0 | #N/A | #N/A | #N/A | #N/A | #N/A | #N/A | #N/A | #N/A
EL-HR0040 | INSERT, SHEAR | #N/A | #N/A | #N/A | PCE | 2119806-1 | #N/A | #N/A | #N/A | #N/A | 0 | #N/A | #N/A | #N/A | #N/A | #N/A | #N/A | #N/A | #N/A
EL-HR0041 | OC-AT-S-FM-062F120O-001-0212 RENTAL | #N/A | #N/A | #N/A | PCE | 2151641-1 | #N/A | #N/A | #N/A | #N/A | 0 | #N/A | #N/A | #N/A | #N/A | #N/A | #N/A | #N/A | #N/A
EL-HR0042 | OC-AT-S-FM-090F120O-001-0021 RENTAL | #N/A | #N/A | #N/A | PCE | 2151101-1 | #N/A | #N/A | #N/A | #N/A | 0 | #N/A | #N/A | #N/A | #N/A | #N/A | #N/A | #N/A | #N/A
EL-HR0043 | WORK LIGHT 110V | #N/A | #N/A | #N/A | PCE | CRK-1003 | #N/A | #N/A | #N/A | #N/A | 0 | #N/A | #N/A | #N/A | #N/A | #N/A | #N/A | #N/A | #N/A
EL-HR0044 | Short Motor Wires - 2 | #N/A | #N/A | #N/A | PCE | 0 | #N/A | #N/A | #N/A | #N/A | 0 | #N/A | #N/A | #N/A | #N/A | #N/A | #N/A | #N/A | #N/A
EL-HR0045 | Dual Extruder Wiring Harness - Pre-TAZ 4.0 | #N/A | #N/A | #N/A | PCE | 0 | #N/A | #N/A | #N/A | #N/A | 0 | #N/A | #N/A | #N/A | #N/A | #N/A | #N/A | #N/A | #N/A
EL-HR0046 | Fan add-on wiring harness | #N/A | #N/A | #N/A | PCE | 0 | #N/A | #N/A | #N/A | #N/A | 0 | #N/A | #N/A | #N/A | #N/A | #N/A | #N/A | #N/A | #N/A
EL-HR0049 | FINGER GUARD | #N/A | #N/A | #N/A | PCE | CRK-420102105 | #N/A | #N/A | #N/A | #N/A | 0 | #N/A | #N/A | #N/A | #N/A | #N/A | #N/A | #N/A | #N/A
EL-HR0050 | Enclosure Power Connector Assy | #N/A | #N/A | #N/A | PCE | 0 | #N/A | #N/A | #N/A | #N/A | 0 | #N/A | #N/A | #N/A | #N/A | #N/A | #N/A | #N/A | #N/A
EL-HR0051 | Power Connector Assy | #N/A | #N/A | #N/A | PCE | 0 | #N/A | #N/A | #N/A | #N/A | 0 | #N/A | #N/A | #N/A | #N/A | #N/A | #N/A | #N/A | #N/A
EL-HR0052 | Extruder Extension v2.1 | #N/A | #N/A | #N/A | PCE | 0 | #N/A | #N/A | #N/A | #N/A | 0 | #N/A | #N/A | #N/A | #N/A | #N/A | #N/A | #N/A | #N/A
EL-HR0053 | PS-GRD Wire v1.0, Pomfret | #N/A | #N/A | #N/A | PCE | 0 | #N/A | #N/A | #N/A | #N/A | 0 | #N/A | #N/A | #N/A | #N/A | #N/A | #N/A | #N/A | #N/A
EL-HR0054 | PP-GRD Wire v1.0, Pomfret | #N/A | #N/A | #N/A | PCE | 0 | #N/A | #N/A | #N/A | #N/A | 0 | #N/A | #N/A | #N/A | #N/A | #N/A | #N/A | #N/A | #N/A
EL-HR0055 | PP-SW Black Wire v1.0, Pomfret | #N/A | #N/A | #N/A | PCE | 0 | #N/A | #N/A | #N/A | #N/A | 0 | #N/A | #N/A | #N/A | #N/A | #N/A | #N/A | #N/A | #N/A
EL-HR0056 | PS-SW Black Wire v1.0, Pomfret | #N/A | #N/A | #N/A | PCE | 0 | #N/A | #N/A | #N/A | #N/A | 0 | #N/A | #N/A | #N/A | #N/A | #N/A | #N/A | #N/A | #N/A
EL-HR0057 | PS-SW White Wire v1.0, Pomfret | #N/A | #N/A | #N/A | PCE | 0 | #N/A | #N/A | #N/A | #N/A | 0 | #N/A | #N/A | #N/A | #N/A | #N/A | #N/A | #N/A | #N/A
EL-HR0058 | PP-SW White Wire v1.0, Pomfret | #N/A | #N/A | #N/A | PCE | 0 | #N/A | #N/A | #N/A | #N/A | 0 | #N/A | #N/A | #N/A | #N/A | #N/A | #N/A | #N/A | #N/A
EL-HR0059 | TAZ Extruder Pin Assignments v3.0 | #N/A | #N/A | #N/A | PCE | 0 | #N/A | #N/A | #N/A | #N/A | 0 | #N/A | #N/A | #N/A | #N/A | #N/A | #N/A | #N/A | #N/A
EL-HR0060 | TAZ Extruder Extension v3.0 | #N/A | #N/A | #N/A | PCE | 0 | #N/A | #N/A | #N/A | #N/A | 0 | #N/A | #N/A | #N/A | #N/A | #N/A | #N/A | #N/A | #N/A
EL-HR0061 | Extruder Extension Adapter v2c to v1/v2a | #N/A | #N/A | #N/A | PCE | 0 | #N/A | #N/A | #N/A | #N/A | 0 | #N/A | #N/A | #N/A | #N/A | #N/A | #N/A | #N/A | #N/A
EL-HR0062 | Extruder Extension Adapter v1/v2a to v2c | #N/A | #N/A | #N/A | PCE | 0 | #N/A | #N/A | #N/A | #N/A | 0 | #N/A | #N/A | #N/A | #N/A | #N/A | #N/A | #N/A | #N/A
EL-HR0063 | Extruder Extension Adapter v2c to v2b | #N/A | #N/A | #N/A | PCE | 0 | #N/A | #N/A | #N/A | #N/A | 0 | #N/A | #N/A | #N/A | #N/A | #N/A | #N/A | #N/A | #N/A
EL-HR0064 | External Blower Harness add-on | #N/A | #N/A | #N/A | PCE | 0 | #N/A | #N/A | #N/A | #N/A | 0 | #N/A | #N/A | #N/A | #N/A | #N/A | #N/A | #N/A | #N/A
EL-HR0066 | TAZ Extruder Pin Assignments v2.1 | #N/A | #N/A | #N/A | PCE | 0 | #N/A | #N/A | #N/A | #N/A | 0 | #N/A | #N/A | #N/A | #N/A | #N/A | #N/A | #N/A | #N/A
EL-HR0067 | TAZ Extruder Pin Assignments v2.0 | #N/A | #N/A | #N/A | PCE | 0 | #N/A | #N/A | #N/A | #N/A | 0 | #N/A | #N/A | #N/A | #N/A | #N/A | #N/A | #N/A | #N/A
EL-HR0068 | Mini Plug to Ground Post Extension | 0 | 0 | 0 | PCE | 0 | Electronic | 0 |  | 0 | 0 | 0 | 0 | 0 | 0 | 0 | 0 | 0 | 0
EL-HR0069 | Mini PS to Ground Post Extension | 0 | 0 | 0 | PCE | 0 | Electronic | 0 |  | 0 | 0 | 0 | 0 | 0 | 0 | 0 | 0 | 0 | 0
EL-HR0070 | X-Extruder-1 Assembly for Mini | #N/A | #N/A | #N/A | PCE | 0 | #N/A | #N/A | #N/A | #N/A | 0 | #N/A | #N/A | #N/A | #N/A | #N/A | #N/A | #N/A | #N/A
EL-HR0071 | Mini Ferrite-Jumper Extension | #N/A | #N/A | #N/A | PCE | 0 | #N/A | #N/A | #N/A | #N/A | 0 | #N/A | #N/A | #N/A | #N/A | #N/A | #N/A | #N/A | #N/A
EL-HR0072 | Hexagon Hot End Kit, Adapter Harness | #N/A | #N/A | #N/A | PCE | 0 | #N/A | #N/A | #N/A | #N/A | 0 | #N/A | #N/A | #N/A | #N/A | #N/A | #N/A | #N/A | #N/A
EL-HR0073 | Thermistor Assembly | #N/A | #N/A | #N/A | PCE | 0 | #N/A | #N/A | #N/A | #N/A | 0 | #N/A | #N/A | #N/A | #N/A | #N/A | #N/A | #N/A | #N/A
EL-HR0074 | DC Power Harness v1.0 TAZ 6 | #N/A | #N/A | #N/A | PCE | 0 | #N/A | #N/A | #N/A | #N/A | 0 | #N/A | #N/A | #N/A | #N/A | #N/A | #N/A | #N/A | #N/A
EL-HR0075 | X Harness External TAZ 6 | #N/A | #N/A | #N/A | PCE | 0 | #N/A | #N/A | #N/A | #N/A | 0 | #N/A | #N/A | #N/A | #N/A | #N/A | #N/A | #N/A | #N/A
EL-HR0076 | Taz 6 switch to PSU white | #N/A | #N/A | #N/A | PCE | 0 | #N/A | #N/A | #N/A | #N/A | 0 | #N/A | #N/A | #N/A | #N/A | #N/A | #N/A | #N/A | #N/A
EL-HR0077 | TAZ 6 switch to PSU black | #N/A | #N/A | #N/A | PCE | 0 | #N/A | #N/A | #N/A | #N/A | 0 | #N/A | #N/A | #N/A | #N/A | #N/A | #N/A | #N/A | #N/A
EL-HR0078 | TAZ 6 plug to ground green | #N/A | #N/A | #N/A | PCE | 0 | #N/A | #N/A | #N/A | #N/A | 0 | #N/A | #N/A | #N/A | #N/A | #N/A | #N/A | #N/A | #N/A
EL-HR0079 | TAZ 6 PSU to ground green | #N/A | #N/A | #N/A | PCE | 0 | #N/A | #N/A | #N/A | #N/A | 0 | #N/A | #N/A | #N/A | #N/A | #N/A | #N/A | #N/A | #N/A
EL-HR0080 | TAZ 6 plug to switch black and white with ferrite | #N/A | #N/A | #N/A | PCE | 0 | #N/A | #N/A | #N/A | #N/A | 0 | #N/A | #N/A | #N/A | #N/A | #N/A | #N/A | #N/A | #N/A
EL-HR0081 | TAZ 6 Bed Harness Internal | #N/A | #N/A | #N/A | PCE | Q5-3X-3/4-01 | #N/A | #N/A | #N/A | #N/A | 0 | #N/A | #N/A | #N/A | #N/A | #N/A | #N/A | #N/A | #N/A
EL-HR0082 | Bed power harness internal, TAZ 6 | #N/A | #N/A | #N/A | PCE | 0 | #N/A | #N/A | #N/A | #N/A | 0 | #N/A | #N/A | #N/A | #N/A | #N/A | #N/A | #N/A | #N/A
EL-HR0083 | Bed power harness external, TAZ 6 | #N/A | #N/A | #N/A | PCE | 0 | #N/A | #N/A | #N/A | #N/A | 0 | #N/A | #N/A | #N/A | #N/A | #N/A | #N/A | #N/A | #N/A
EL-HR0084 | TAZ 6, X Harness Internal | #N/A | #N/A | #N/A | PCE | Q5-3X-3/4-01 | #N/A | #N/A | #N/A | #N/A | 0 | #N/A | #N/A | #N/A | #N/A | #N/A | #N/A | #N/A | #N/A
EL-HR0085 | Shielded 24AWG harness for Moon's NEMA17 stepper, 640mm | #N/A | #N/A | #N/A | PCE | 0 | #N/A | #N/A | #N/A | #N/A | 0 | #N/A | #N/A | #N/A | #N/A | #N/A | #N/A | #N/A | #N/A
EL-HR0086 | Mini, Ferrite Motor Extension | #N/A | #N/A | #N/A | PCE | 0 | #N/A | #N/A | #N/A | #N/A | 0 | #N/A | #N/A | #N/A | #N/A | #N/A | #N/A | #N/A | #N/A
EL-HR0087 | TAZ 6, CB Extruder Harness Internal | #N/A | #N/A | #N/A | PCE | FSD74-6 | #N/A | #N/A | #N/A | #N/A | 0 | #N/A | #N/A | #N/A | #N/A | #N/A | #N/A | #N/A | #N/A
EL-HR0088 | TAZ 6, Y & Z Harness Internal | #N/A | #N/A | #N/A | PCE | Q5-3X-3/4-01 | #N/A | #N/A | #N/A | #N/A | 0 | #N/A | #N/A | #N/A | #N/A | #N/A | #N/A | #N/A | #N/A
EL-HR0089 | Taz 6, Bed harness extension | #N/A | #N/A | #N/A | PCE | 0 | #N/A | #N/A | #N/A | #N/A | 0 | #N/A | #N/A | #N/A | #N/A | #N/A | #N/A | #N/A | #N/A
EL-HR0090 | Taz 6, Bed harness external | #N/A | #N/A | #N/A | PCE | 0 | #N/A | #N/A | #N/A | #N/A | 0 | #N/A | #N/A | #N/A | #N/A | #N/A | #N/A | #N/A | #N/A
EL-HR0091 | Taz 6 Y & Z harness external | #N/A | #N/A | #N/A | PCE | 0 | #N/A | #N/A | #N/A | #N/A | 0 | #N/A | #N/A | #N/A | #N/A | #N/A | #N/A | #N/A | #N/A
EL-HR0092 | Taz 6, Extruder 0 harness external | #N/A | #N/A | #N/A | PCE | 0 | #N/A | #N/A | #N/A | #N/A | 0 | #N/A | #N/A | #N/A | #N/A | #N/A | #N/A | #N/A | #N/A
EL-HR0093 | Mini X-Motor Adapter, Moons' v1.0 | #N/A | #N/A | #N/A | PCE | 4634140204390 | #N/A | #N/A | #N/A | #N/A | 4634140204390 | #N/A | #N/A | #N/A | #N/A | #N/A | #N/A | #N/A | #N/A
EL-HR0094 | TAZ XY, Mini Y-Motor Adapter, Moons' v1.0 | #N/A | #N/A | #N/A | PCE | 4634140204391 | #N/A | #N/A | #N/A | #N/A | 4634140204391 | #N/A | #N/A | #N/A | #N/A | #N/A | #N/A | #N/A | #N/A
EL-HR0095 | Extruder Fan Harness TAZ 6, v0.1 | #N/A | #N/A | #N/A | PCE | 0 | #N/A | #N/A | #N/A | #N/A | 0 | #N/A | #N/A | #N/A | #N/A | #N/A | #N/A | #N/A | #N/A
EL-HR0096 | Extruder Motor-switch Harness TAZ 6, v0.1 | #N/A | #N/A | #N/A | PCE | 0 | #N/A | #N/A | #N/A | #N/A | 0 | #N/A | #N/A | #N/A | #N/A | #N/A | #N/A | #N/A | #N/A
EL-HR0097 | LCD Harness TAZ 6, v0.1 | #N/A | #N/A | #N/A | PCE | 0 | #N/A | #N/A | #N/A | #N/A | 0 | #N/A | #N/A | #N/A | #N/A | #N/A | #N/A | #N/A | #N/A
EL-HR0098 | TAZ 2-3pin Blower Adapter | #N/A | #N/A | #N/A | PCE | 0 | #N/A | #N/A | #N/A | #N/A | 0 | #N/A | #N/A | #N/A | #N/A | #N/A | #N/A | #N/A | #N/A
EL-HR0100 | Opah thermistor assembly v0.1 | #N/A | #N/A | #N/A | PCE | 0 | #N/A | #N/A | #N/A | #N/A | 0 | #N/A | #N/A | #N/A | #N/A | #N/A | #N/A | #N/A | #N/A
EL-HR0101 | Taz 6, CB extruder 1 harness | #N/A | #N/A | #N/A | PCE | 0 | #N/A | #N/A | #N/A | #N/A | 0 | #N/A | #N/A | #N/A | #N/A | #N/A | #N/A | #N/A | #N/A
EL-HR0102 | Mini Bed Harness Assembly - Gladiola | 0 | 0 | 0 | PCE | 0 | Electronic | 29.58 |  | 0 | 0 | IGUS | 0 | 0 | 0 | 0 | 0 | 0 | 0
EL-HR0104 | Mini Plug to SW Extension Harness Assembly - Gladiola | #N/A | #N/A | #N/A | PCE | 0 | #N/A | #N/A | #N/A | #N/A | 0 | #N/A | #N/A | #N/A | #N/A | #N/A | #N/A | #N/A | #N/A
EL-HR0106 | Mini PS to RAMBo Harness Assembly - Gladiola | #N/A | #N/A | #N/A | PCE | 0 | #N/A | #N/A | #N/A | #N/A | 0 | #N/A | #N/A | #N/A | #N/A | #N/A | #N/A | #N/A | #N/A
EL-HR0107 | Mini SW to PS Extension Harness Assembly - Gladiola | #N/A | #N/A | #N/A | PCE | 0 | #N/A | #N/A | #N/A | #N/A | 0 | #N/A | #N/A | #N/A | #N/A | #N/A | #N/A | #N/A | #N/A
EL-HR0108 | Mini X Extruder Harnesses Assembly - Gladiola | 0 | 0 | 0 | PCE | 0 | Electronic | 73.26 |  | 0 | 0 | IGUS | 0 | 0 | 0 | 0 | 0 | 0 | 0
EL-HR0109 | Finger Guard 80mm Plastic | #N/A | #N/A | #N/A | PCE | CR282-ND | #N/A | 0.30414 | #N/A | #N/A | 09080-G | Digi-Key | #N/A | #N/A | #N/A | #N/A | #N/A | #N/A | #N/A
EL-HR0110 | Finger/ Filter Assembly 80mm Plastic 30ppl | #N/A | #N/A | #N/A | PCE | CR212-ND | #N/A | #N/A | #N/A | #N/A | 09325-F/30 | #N/A | #N/A | #N/A | #N/A | #N/A | #N/A | #N/A | #N/A
EL-HR0111 | Fan Filter 80mm 45ppl | #N/A | #N/A | #N/A | PCE | 1053-1394-ND | #N/A | #N/A | #N/A | #N/A | GRM80-45 | #N/A | #N/A | #N/A | #N/A | #N/A | #N/A | #N/A | #N/A
EL-HR0112 | Finger Guard 8mm Plastic | #N/A | #N/A | #N/A | PCE | CR226-ND | #N/A | #N/A | #N/A | #N/A | 09325-G | #N/A | #N/A | #N/A | #N/A | #N/A | #N/A | #N/A | #N/A
EL-HR0113 | igus Bed Harness Cable Sub-Assembly - Gladiola | #N/A | #N/A | #N/A | PCE | 0 | #N/A | #N/A | #N/A | #N/A | 0 | #N/A | #N/A | #N/A | #N/A | #N/A | #N/A | #N/A | #N/A
El-HR0114 | Mini Bed Harness Completed Assembly - Gladiola | #N/A | #N/A | #N/A | PCE | 0 | #N/A | #N/A | #N/A | #N/A | 0 | #N/A | #N/A | #N/A | #N/A | #N/A | #N/A | #N/A | #N/A
EL-HR0115 | Mini XY Harness Assembly - Gladiola | #N/A | #N/A | #N/A | PCE | 0 | #N/A | #N/A | #N/A | #N/A | 0 | #N/A | #N/A | #N/A | #N/A | #N/A | #N/A | #N/A | #N/A
EL-HR0116 | Mini USB to Ground Harness | #N/A | #N/A | #N/A | PCE | 0 | #N/A | #N/A | #N/A | #N/A | 0 | #N/A | #N/A | #N/A | #N/A | #N/A | #N/A | #N/A | #N/A
EL-MS0001 | Female Connector Pins .1in Gold Terminals | #N/A | #N/A | #N/A | PCE | HH-PT1IN_FT | #N/A | #N/A | #N/A | #N/A | 0 | #N/A | #N/A | #N/A | #N/A | #N/A | #N/A | #N/A | #N/A
EL-MS0002 | 1x4-pin Connector Housing | #N/A | #N/A | #N/A | PCE | HH-PT1IN_1x4 | #N/A | #N/A | #N/A | #N/A | 0 | #N/A | #N/A | #N/A | #N/A | #N/A | #N/A | #N/A | #N/A
EL-MS0003 | Male Connector Pins .1in Gold Terminals | #N/A | #N/A | #N/A | PCE | HH-PT1IN_MT | #N/A | #N/A | #N/A | #N/A | 0 | #N/A | #N/A | #N/A | #N/A | #N/A | #N/A | #N/A | #N/A
EL-MS0004 | 1x2-pin Connector Housing | #N/A | #N/A | #N/A | PCE | HH-PT1IN_1x2 | #N/A | #N/A | #N/A | #N/A | 0 | #N/A | #N/A | #N/A | #N/A | #N/A | #N/A | #N/A | #N/A
EL-MS0005 | 1x3-pin Connector Housing | #N/A | #N/A | #N/A | PCE | HH-PT1IN_1x3 | #N/A | #N/A | #N/A | #N/A | 0 | #N/A | #N/A | #N/A | #N/A | #N/A | #N/A | #N/A | #N/A
EL-MS0006 | Power Cord with Three-Blade Plug, 18 Gauge Wire, NEMA 5-15 Plug, 6' 7" Long | #N/A | #N/A | #N/A | PCE | 70355K76 | #N/A | #N/A | #N/A | #N/A | 0 | #N/A | #N/A | #N/A | #N/A | #N/A | #N/A | #N/A | #N/A
EL-MS0007 | 22-18 AWG butt connector | #N/A | #N/A | #N/A | PCE | 0 | #N/A | #N/A | #N/A | #N/A | 0 | #N/A | #N/A | #N/A | #N/A | #N/A | #N/A | #N/A | #N/A
EL-MS0008 | Anderson-Heavy Duty Power Connectors HOUSING ONLY, BLACK-BULK POWERPOLE 15/45 | 0 | 0 | 0 | PCE | 879-1327G6-BK | Electronic | 0.192 |  | Anderson | 1327G6-BK | SAGER | 879-1327G6-BK | 0 | 0 | 0 | 0 | 0 | 0
EL-MS0009 | Wire Wrap, 1/4", 100' Length | #N/A | #N/A | #N/A | cm | 7432K91 | #N/A | #N/A | #N/A | #N/A | 0 | #N/A | #N/A | #N/A | #N/A | #N/A | #N/A | #N/A | #N/A
EL-MS0010 | Heavy Duty Power Connectors POWERPOLE 15A CONT | 0 | 0 | 0 | PCE | 879-1332-BK | Electronic | 0.1 |  | Anderson | 1332-BK | Mouser | 879-1332-BK | 0 | 0 | 0 | 0 | 0 | 0
EL-MS0011 | Wire Wrap, 1/2", 100' Length | #N/A | #N/A | #N/A | cm | 7432K93 | #N/A | #N/A | #N/A | #N/A | 0 | #N/A | #N/A | #N/A | #N/A | #N/A | #N/A | #N/A | #N/A
EL-MS0012 | Noninsulated Wire Ferrule, 24-20 AWG, .31" Pin Length | #N/A | #N/A | #N/A | PCE | 9681K15 | #N/A | #N/A | #N/A | #N/A | 0 | #N/A | #N/A | #N/A | #N/A | #N/A | #N/A | #N/A | #N/A
EL-MS0013 | Wire Ferrules, 18 AWG | #N/A | #N/A | #N/A | PCE | 9681K17 | #N/A | #N/A | #N/A | #N/A | 0 | #N/A | #N/A | #N/A | #N/A | #N/A | #N/A | #N/A | #N/A
EL-MS0014 | Noninsulated Wire Ferrule, 16 AWG, .28" Pin Length | #N/A | #N/A | #N/A | PCE | 9681K21 | #N/A | #N/A | #N/A | #N/A | 0 | #N/A | #N/A | #N/A | #N/A | #N/A | #N/A | #N/A | #N/A
EL-MS0015 | Terminal, quick disconnect, female 22-18 AWG | #N/A | #N/A | #N/A | PCE | 538-19003-0107 | #N/A | #N/A | #N/A | #N/A | 0 | #N/A | #N/A | #N/A | #N/A | #N/A | #N/A | #N/A | #N/A
EL-MS0016 | Wire Wrap, 1/4", 300mm | #N/A | #N/A | #N/A | PCE | 0 | #N/A | #N/A | #N/A | #N/A | 0 | #N/A | #N/A | #N/A | #N/A | #N/A | #N/A | #N/A | #N/A
EL-MS0017 | Wire Wrap, 1/4", 340mm | #N/A | #N/A | #N/A | PCE | 0 | #N/A | #N/A | #N/A | #N/A | 0 | #N/A | #N/A | #N/A | #N/A | #N/A | #N/A | #N/A | #N/A
EL-MS0018 | Wire Wrap, 1/4", 420mm | #N/A | #N/A | #N/A | PCE | 0 | #N/A | #N/A | #N/A | #N/A | 0 | #N/A | #N/A | #N/A | #N/A | #N/A | #N/A | #N/A | #N/A
EL-MS0019 | Wire Wrap, 1/2", 90mm | #N/A | #N/A | #N/A | PCE | 0 | #N/A | #N/A | #N/A | #N/A | 0 | #N/A | #N/A | #N/A | #N/A | #N/A | #N/A | #N/A | #N/A
EL-MS0020 | 1x5-pin Connector Housing | #N/A | #N/A | #N/A | PCE | HH-PT1IN_1x5 | #N/A | #N/A | #N/A | #N/A | 0 | #N/A | #N/A | #N/A | #N/A | #N/A | #N/A | #N/A | #N/A
EL-MS0021 | Universal Servo JR Connector Housings | #N/A | #N/A | #N/A | PCE | HH-SC_UNH | #N/A | #N/A | #N/A | #N/A | 0 | #N/A | #N/A | #N/A | #N/A | #N/A | #N/A | #N/A | #N/A
EL-MS0022 | Universal Servo Connector Sleeves | #N/A | #N/A | #N/A | PCE | HH-SC_UNS | #N/A | #N/A | #N/A | #N/A | 0 | #N/A | #N/A | #N/A | #N/A | #N/A | #N/A | #N/A | #N/A
EL-MS0023 | Futaba J Servo Connector Housings | #N/A | #N/A | #N/A | PCE | HH-SC_FJH | #N/A | #N/A | #N/A | #N/A | 0 | #N/A | #N/A | #N/A | #N/A | #N/A | #N/A | #N/A | #N/A
EL-MS0024 | Futaba J Servo Connector Male Sleeves | #N/A | #N/A | #N/A | PCE | HH-SC_FJS | #N/A | #N/A | #N/A | #N/A | 0 | #N/A | #N/A | #N/A | #N/A | #N/A | #N/A | #N/A | #N/A
EL-MS0025 | 1x1-pin Connector Housing | #N/A | #N/A | #N/A | PCE | HH-PT1IN_1x1 | #N/A | #N/A | #N/A | #N/A | 0 | #N/A | #N/A | #N/A | #N/A | #N/A | #N/A | #N/A | #N/A
EL-MS0026 | 1x6-pin Connector Housing | #N/A | #N/A | #N/A | PCE | HH-PT1IN_1x6 | #N/A | #N/A | #N/A | #N/A | 0 | #N/A | #N/A | #N/A | #N/A | #N/A | #N/A | #N/A | #N/A
EL-MS0027 | 1x7-pin Connector Housing | #N/A | #N/A | #N/A | PCE | HH-PT1IN_1x7 | #N/A | #N/A | #N/A | #N/A | 0 | #N/A | #N/A | #N/A | #N/A | #N/A | #N/A | #N/A | #N/A
EL-MS0028 | 1x8-pin Connector Housing | #N/A | #N/A | #N/A | PCE | HH-PT1IN_1x8 | #N/A | #N/A | #N/A | #N/A | 0 | #N/A | #N/A | #N/A | #N/A | #N/A | #N/A | #N/A | #N/A
EL-MS0029 | 1x9-pin Connector Housing | #N/A | #N/A | #N/A | PCE | HH-PT1IN_1x9 | #N/A | #N/A | #N/A | #N/A | 0 | #N/A | #N/A | #N/A | #N/A | #N/A | #N/A | #N/A | #N/A
EL-MS0030 | 1x10-pin Connector Housing | #N/A | #N/A | #N/A | PCE | HH-PT1IN_1x10 | #N/A | #N/A | #N/A | #N/A | 0 | #N/A | #N/A | #N/A | #N/A | #N/A | #N/A | #N/A | #N/A
EL-MS0031 | 2x2-pin Connector Housing | #N/A | #N/A | #N/A | PCE | HH-PT1IN_2x2 | #N/A | #N/A | #N/A | #N/A | 0 | #N/A | #N/A | #N/A | #N/A | #N/A | #N/A | #N/A | #N/A
EL-MS0032 | 2x3-pin Connector Housing | #N/A | #N/A | #N/A | PCE | HH-PT1IN_2x3 | #N/A | #N/A | #N/A | #N/A | 0 | #N/A | #N/A | #N/A | #N/A | #N/A | #N/A | #N/A | #N/A
EL-MS0033 | 2x4-pin Connector Housing | #N/A | #N/A | #N/A | PCE | HH-PT1IN_2x4 | #N/A | #N/A | #N/A | #N/A | 0 | #N/A | #N/A | #N/A | #N/A | #N/A | #N/A | #N/A | #N/A
EL-MS0034 | 2x5-pin Connector Housing | #N/A | #N/A | #N/A | PCE | HH-PT1IN_2x5 | #N/A | #N/A | #N/A | #N/A | 0 | #N/A | #N/A | #N/A | #N/A | #N/A | #N/A | #N/A | #N/A
EL-MS0035 | Gold Single Row Straight Header - 40 Pin | #N/A | #N/A | #N/A | PCE | HH-PT1IN_SRSH40 | #N/A | #N/A | #N/A | #N/A | 0 | #N/A | #N/A | #N/A | #N/A | #N/A | #N/A | #N/A | #N/A
EL-MS0036 | Gold Double Row Straight Header - 80 Pin | #N/A | #N/A | #N/A | PCE | HH-PT1IN_SRSH80 | #N/A | #N/A | #N/A | #N/A | 0 | #N/A | #N/A | #N/A | #N/A | #N/A | #N/A | #N/A | #N/A
EL-MS0037 | Gold Single Row Right Angle Header - 40 Pin | #N/A | #N/A | #N/A | PCE | HH-PT1IN_SRRAH40 | #N/A | #N/A | #N/A | #N/A | 0 | #N/A | #N/A | #N/A | #N/A | #N/A | #N/A | #N/A | #N/A
EL-MS0038 | Gold Double Row Right Angle Header - 80 Pin | #N/A | #N/A | #N/A | PCE | HH-PT1IN_SRRAH80 | #N/A | #N/A | #N/A | #N/A | 0 | #N/A | #N/A | #N/A | #N/A | #N/A | #N/A | #N/A | #N/A
EL-MS0039 | Servo Connector Female to Male Adapter | #N/A | #N/A | #N/A | PCE | HH-PT1IN_SCFMA | #N/A | #N/A | #N/A | #N/A | 0 | #N/A | #N/A | #N/A | #N/A | #N/A | #N/A | #N/A | #N/A
EL-MS0040 | Gold Single Row Female to Male Adapter Header - 40 Pin | #N/A | #N/A | #N/A | PCE | HH-PT1IN_SRFMA40 | #N/A | #N/A | #N/A | #N/A | 0 | #N/A | #N/A | #N/A | #N/A | #N/A | #N/A | #N/A | #N/A
EL-MS0041 | Gold Double Row Female to Male Adapter Header - 80 Pin | #N/A | #N/A | #N/A | PCE | HH-PT1IN_SRFMA80 | #N/A | #N/A | #N/A | #N/A | 0 | #N/A | #N/A | #N/A | #N/A | #N/A | #N/A | #N/A | #N/A
EL-MS0042 | Servo Connector Three-Way Male / Y Adapter | #N/A | #N/A | #N/A | PCE | HH-SC_3WM | #N/A | #N/A | #N/A | #N/A | 0 | #N/A | #N/A | #N/A | #N/A | #N/A | #N/A | #N/A | #N/A
EL-MS0043 | Hammond Mfg Enclosure, 1593HAMBONEBK, Beaglebone | #N/A | #N/A | #N/A | PCE | 70313867 | #N/A | #N/A | #N/A | #N/A | 0 | #N/A | #N/A | #N/A | #N/A | #N/A | #N/A | #N/A | #N/A
EL-MS0044 | 0.1" Servo Strip PCB | #N/A | #N/A | #N/A | PCE | HH-SC_PCB_PT1INSS | #N/A | #N/A | #N/A | #N/A | 0 | #N/A | #N/A | #N/A | #N/A | #N/A | #N/A | #N/A | #N/A
EL-MS0045 | Universal Servo Connector Adapter PCB | #N/A | #N/A | #N/A | PCE | HH-SC_PCB_USCA | #N/A | #N/A | #N/A | #N/A | 0 | #N/A | #N/A | #N/A | #N/A | #N/A | #N/A | #N/A | #N/A
EL-MS0046 | Universal 22 AWG 8" Servo Lead | #N/A | #N/A | #N/A | PCE | HH-LEAD_DX22-08 | #N/A | #N/A | #N/A | #N/A | 0 | #N/A | #N/A | #N/A | #N/A | #N/A | #N/A | #N/A | #N/A
EL-MS0047 | Connector 4 Pin Din Power | #N/A | #N/A | #N/A | PCE | ALE-0000217 | #N/A | #N/A | #N/A | #N/A | 0 | #N/A | #N/A | #N/A | #N/A | #N/A | #N/A | #N/A | #N/A
EL-MS0048 | Non-Insulated Crimp-on Wire Ferrule, 12 AWG, .35" Overall Length, Packs of 100 | #N/A | #N/A | #N/A | PCE | 9681K28 | #N/A | #N/A | #N/A | #N/A | 0 | #N/A | #N/A | #N/A | #N/A | #N/A | #N/A | #N/A | #N/A
EL-MS0049 | Non-Insulated Crimp-on Wire Ferrule, 14 AWG, .39" Overall Length, Packs of 100 | #N/A | #N/A | #N/A | PCE | 9681K25 | #N/A | #N/A | #N/A | #N/A | 0 | #N/A | #N/A | #N/A | #N/A | #N/A | #N/A | #N/A | #N/A
EL-MS0050 | Non-Insulated Crimp-on Wire Ferrule, 16 AWG, .28" Overall Length, Packs of 100 | #N/A | #N/A | #N/A | PCE | 9681K21 | #N/A | #N/A | #N/A | #N/A | 0 | #N/A | #N/A | #N/A | #N/A | #N/A | #N/A | #N/A | #N/A
EL-MS0051 | Non-Insulated Crimp-on Wire Ferrule, 24-22 AWG, .20" Overall Length, Packs of 100 | #N/A | #N/A | #N/A | PCE | 9681K13 | #N/A | #N/A | #N/A | #N/A | 0 | #N/A | #N/A | #N/A | #N/A | #N/A | #N/A | #N/A | #N/A
EL-MS0052 | Non-Insulated Crimp-on Wire Ferrule, 26-24 AWG, .20" Overall Length, Packs of 100 | #N/A | #N/A | #N/A | PCE | 9681K11 | #N/A | #N/A | #N/A | #N/A | 0 | #N/A | #N/A | #N/A | #N/A | #N/A | #N/A | #N/A | #N/A
EL-MS0053 | Hammond Manufacturing Strip, Power; 6; 6 ft.; UL Listed, CSA Certified; Metal; 6 ft. | #N/A | #N/A | #N/A | PCE | 70175099 | #N/A | #N/A | #N/A | #N/A | 0 | #N/A | #N/A | #N/A | #N/A | #N/A | #N/A | #N/A | #N/A
EL-MS0054 | ENCODER OPTICAL ROTARY 256 CPR | #N/A | #N/A | #N/A | PCE | ENS1J-B28-L00256L-ND | #N/A | #N/A | #N/A | #N/A | 0 | #N/A | #N/A | #N/A | #N/A | #N/A | #N/A | #N/A | #N/A
EL-MS0055 | REPLICAPE | #N/A | #N/A | #N/A | PCE | 0 | #N/A | #N/A | #N/A | #N/A | 0 | #N/A | #N/A | #N/A | #N/A | #N/A | #N/A | #N/A | #N/A
EL-MS0056 | Rubber Static Control Work Surface Mat, 36" L X24" W X1-16" Thickness, Wrist Strap & Ground Kit, Blue | #N/A | #N/A | #N/A | PCE | 4446T72 | #N/A | #N/A | #N/A | #N/A | 0 | #N/A | #N/A | #N/A | #N/A | #N/A | #N/A | #N/A | #N/A
EL-MS0057 | Rubber Static Control Work Surface Mat, 48" L X24" W 1/16" Thickness, Wrist Strap & Ground Kit, Blue | #N/A | #N/A | #N/A | PCE | 4446T74 | #N/A | #N/A | #N/A | #N/A | 0 | #N/A | #N/A | #N/A | #N/A | #N/A | #N/A | #N/A | #N/A
EL-MS0058 | CONN PIN MALE 24-30AWG CRIMP TIN 20K REELS | #N/A | #N/A | #N/A | PCE | 1-66106-5 | #N/A | #N/A | #N/A | #N/A | 16-02-0108 | #N/A | #N/A | #N/A | #N/A | #N/A | #N/A | #N/A | #N/A
EL-MS0059 | Molex-CONN TERM FEMALE 22-24AWG TIN Reels of 20K | 0 | 0 | 0 | PCE | 16-02-0086 | Electronic | 0.0146 |  | Molex Inc. | 16-02-0086 / 16-02-0102 | TTI | WM2510TR-ND | 0 | 0 | 0 | 0 | 0 | 0
EL-MS0060 | Conn, term, female, .187 Rohs comp, insulated | #N/A | #N/A | #N/A | PCE | 534-8291 | #N/A | #N/A | #N/A | #N/A | 0 | #N/A | #N/A | #N/A | #N/A | #N/A | #N/A | #N/A | #N/A
EL-MS0061 | Molex-CONN HOUSING MALE 4POS .100 | 0 | 0 | 0 | PCE | 701070003 | Electronic | 0.116 |  | Molex | 701070003 | SAGER | WM2535-ND | 0 | 0 | 0 | 0 | 0 | 0
EL-MS0062 | MOLEX-CONN HOUSING 4POS .100 W/LATCH | 0 | 0 | 0 | PCE | ALE-0000191 | Electronic | 0.0523 |  | Molex Inc. | 50579404 | SAGER | WM2902-ND | 0 | 0 | 0 | 0 | 0 | 0
EL-MS0064 | TERM BLOCK 5.08MM VERT 3POS PCB | #N/A | #N/A | #N/A | PCE | ED2581-ND | #N/A | #N/A | #N/A | #N/A | 0 | #N/A | #N/A | #N/A | #N/A | #N/A | #N/A | #N/A | #N/A
EL-MS0065 | Kingston 4 GB microSDHC Class 4 Flash Memory Card SDC4/4GBET | #N/A | #N/A | #N/A | PCE | B00200K1TI | #N/A | #N/A | #N/A | #N/A | 0 | #N/A | #N/A | #N/A | #N/A | #N/A | #N/A | #N/A | #N/A
EL-MS0066 | Wire Ferrules, 24-20 AWG | #N/A | #N/A | #N/A | PCE | 9681K17 | #N/A | #N/A | #N/A | #N/A | 0 | #N/A | #N/A | #N/A | #N/A | #N/A | #N/A | #N/A | #N/A
EL-MS0067 | Wire Ferrules, 16 AWG | #N/A | #N/A | #N/A | PCE | 9681K17 | #N/A | #N/A | #N/A | #N/A | 0 | #N/A | #N/A | #N/A | #N/A | #N/A | #N/A | #N/A | #N/A
EL-MS0068 | Conn, Crimp, .250, 14-16AWG | #N/A | #N/A | #N/A | PCE | 3-350820-2 | #N/A | #N/A | #N/A | #N/A | 0 | #N/A | #N/A | #N/A | #N/A | #N/A | #N/A | #N/A | #N/A
EL-MS0069 | 48" x 500' 4 Mil Anti-Static Poly Sheeting Roll | #N/A | #N/A | #N/A | PCE | S-13010 | #N/A | #N/A | #N/A | #N/A | 0 | #N/A | #N/A | #N/A | #N/A | #N/A | #N/A | #N/A | #N/A
EL-MS0071 | Connector, 8 pin ribbon | #N/A | #N/A | #N/A | PCE | 71600-308LF | #N/A | #N/A | #N/A | #N/A | 0 | #N/A | #N/A | #N/A | #N/A | #N/A | #N/A | #N/A | #N/A
EL-MS0072 | Ace 16-14 AWG Blue Insulated Ring Terminal - 100 Pack | #N/A | #N/A | #N/A | PCE | 34542 | #N/A | #N/A | #N/A | #N/A | 0 | #N/A | #N/A | #N/A | #N/A | #N/A | #N/A | #N/A | #N/A
EL-MS0073 | Tubing Corrugated Loom .25", Black, 3200' Box | 0 | 0 | 0 | ft | 708161 | Electronic | 0.002246 |  | Panduit | 88-00011 | Electronics Distributors Corp (Distrubutor for Advanced Cable Tie) | 0 | 695 * 3050 / 304.8 = 6955 ft need 3 x 3200' rollsordered 9600 ft 2 x 3200' rolls | 0 | 0 | 0 | 0 | 0
EL-MS0073 (obsolete) | Tubing Corrugated Loom .25" x 100' (obsolete) | #N/A | #N/A | #N/A | PCE | CLT25F-C20 / 298-1141-ND | #N/A | #N/A | #N/A | #N/A | 0 | #N/A | #N/A | #N/A | #N/A | #N/A | #N/A | #N/A | #N/A
EL-MS0074 | Molex-CONN HOUSING 20POS .100 DUAL, BLACK | 0 | 0 | 0 | PCE | 22552201 | Electronic | 0.5101 |  | Molex Inc. | 22552201 | SAGER | WM2527-ND | 0 | 0 | 0 | 0 | 0 | 0
EL-MS0075 | CONN HOUSING 8POS .100 DUAL, Black | #N/A | #N/A | #N/A | PCE | 22552081 | #N/A | #N/A | #N/A | #N/A | 22552081 | #N/A | #N/A | #N/A | #N/A | #N/A | #N/A | #N/A | #N/A
EL-MS0076 | .1in Female Gold Terminals (x1,000) | #N/A | #N/A | #N/A | PCE | HH-PT1IN_FT (x1,000) | #N/A | #N/A | #N/A | #N/A | 0 | #N/A | #N/A | #N/A | #N/A | #N/A | #N/A | #N/A | #N/A
EL-MS0077 | .1in Male Gold Terminals (x1,000) | #N/A | #N/A | #N/A | PCE | HH-PT1IN_MT (x1,000) | #N/A | #N/A | #N/A | #N/A | 0 | #N/A | #N/A | #N/A | #N/A | #N/A | #N/A | #N/A | #N/A
EL-MS0079 | 10 Yubikeys in White | #N/A | #N/A | #N/A | pkg, 10 | 0 | #N/A | #N/A | #N/A | #N/A | 0 | #N/A | #N/A | #N/A | #N/A | #N/A | #N/A | #N/A | #N/A
EL-MS0080 | 1500 Watts Step Up-Step Down Voltage Converter | #N/A | #N/A | #N/A | PCE | TC-1500 | #N/A | #N/A | #N/A | #N/A | 0 | #N/A | #N/A | #N/A | #N/A | #N/A | #N/A | #N/A | #N/A
EL-MS0081 | 1x1 .1in Plastic Housings (x100) | #N/A | #N/A | #N/A | PCE | HH-PT1IN_1x1 (x100) | #N/A | #N/A | #N/A | #N/A | 0 | #N/A | #N/A | #N/A | #N/A | #N/A | #N/A | #N/A | #N/A
EL-MS0082 | 1x2 .1in Plastic Housings (x300) | #N/A | #N/A | #N/A | PCE | HH-PT1IN_1x2 (x300) | #N/A | #N/A | #N/A | #N/A | 0 | #N/A | #N/A | #N/A | #N/A | #N/A | #N/A | #N/A | #N/A
EL-MS0083 | 1x3 .1in Plastic Housings (Economy Servo Housings) (x300) | #N/A | #N/A | #N/A | PCE | HH-PT1IN_1x3 (x300) | #N/A | #N/A | #N/A | #N/A | 0 | #N/A | #N/A | #N/A | #N/A | #N/A | #N/A | #N/A | #N/A
EL-MS0084 | 1x4 .1in Plastic Housings (x300) | #N/A | #N/A | #N/A | PCE | HH-PT1IN_1x4 (x300) | #N/A | #N/A | #N/A | #N/A | 0 | #N/A | #N/A | #N/A | #N/A | #N/A | #N/A | #N/A | #N/A
EL-MS0085 | AC Power Entry Modules PWR INLET W/FUSEHLDR | #N/A | #N/A | #N/A | PCE | 161-PF0030/28 | #N/A | #N/A | #N/A | #N/A | 0 | #N/A | #N/A | #N/A | #N/A | #N/A | #N/A | #N/A | #N/A
EL-MS0086 | Antistatic Cleaner, 32-oz Trigger Spray | #N/A | #N/A | #N/A | PCE | 98265T72 | #N/A | #N/A | #N/A | #N/A | 0 | #N/A | #N/A | #N/A | #N/A | #N/A | #N/A | #N/A | #N/A
EL-MS0087 | Auto Fuse Holder, Littelfuse | #N/A | #N/A | #N/A | PCE | 79458035360 | #N/A | #N/A | #N/A | #N/A | 0 | #N/A | #N/A | #N/A | #N/A | #N/A | #N/A | #N/A | #N/A
EL-MS0088 | Buffers & Line Drivers Hex Non-Inverting | #N/A | #N/A | #N/A | PCE | 595-CD74HC4050M | #N/A | #N/A | #N/A | #N/A | 0 | #N/A | #N/A | #N/A | #N/A | #N/A | #N/A | #N/A | #N/A
EL-MS0089 | Buffers & Line Drivers Hi-Spd CMOS Logic Hex Non-Inv Bfr | #N/A | #N/A | #N/A | PCE | 595-CD74HC4050PWRG4 | #N/A | #N/A | #N/A | #N/A | 0 | #N/A | #N/A | #N/A | #N/A | #N/A | #N/A | #N/A | #N/A
EL-MS0090 | CONN CABLE CLAMP CPC SIZE 11 BLK | #N/A | #N/A | #N/A | PCE | A32515-ND | #N/A | #N/A | #N/A | #N/A | 0 | #N/A | #N/A | #N/A | #N/A | #N/A | #N/A | #N/A | #N/A
EL-MS0091 | DC 3A Step-Down Adjustable Breadboard Module; Power Supply Converter USA | #N/A | #N/A | #N/A | PCE | 0 | #N/A | #N/A | #N/A | #N/A | 0 | #N/A | #N/A | #N/A | #N/A | #N/A | #N/A | #N/A | #N/A
EL-MS0092 | Fuse 5A 125V Fast NANO2 SMD | #N/A | #N/A | #N/A | PCE | F1641CT-ND | #N/A | #N/A | #N/A | #N/A | 0 | #N/A | #N/A | #N/A | #N/A | #N/A | #N/A | #N/A | #N/A
EL-MS0093 | FUSE BLADE 15A 32V ATO FAST-ACT | #N/A | #N/A | #N/A | PCE | F4200-ND | #N/A | #N/A | #N/A | #N/A | 0 | #N/A | #N/A | #N/A | #N/A | #N/A | #N/A | #N/A | #N/A
EL-MS0094 | Fuse Holder Inline | #N/A | #N/A | #N/A | PCE | BPHHN | #N/A | #N/A | #N/A | #N/A | 0 | #N/A | #N/A | #N/A | #N/A | #N/A | #N/A | #N/A | #N/A
EL-MS0095 | FUSE MED-ACT 7A 125V UL 5X20MM | #N/A | #N/A | #N/A | PCE | F4710-ND | #N/A | #N/A | #N/A | #N/A | 0 | #N/A | #N/A | #N/A | #N/A | #N/A | #N/A | #N/A | #N/A
EL-MS0096 | Cartridge Fuses 125V 7A 5X20 MA UL LBC | 0 | 0 | 0 | PCE | 576-0233007.MXP | Electronic | 0.381 |  | 0 | F4710-ND | Mouser | 576-0233007.MXP | 0 | 0 | 0 | 0 | 0 | 0
EL-MS0097 | Heater Cartridge 24V, 40W | #N/A | #N/A | #N/A | PCE | 0 | #N/A | #N/A | #N/A | #N/A | 0 | #N/A | #N/A | #N/A | #N/A | #N/A | #N/A | #N/A | #N/A
EL-MS0098 | HOOK MINI TEST CONN BLK | #N/A | #N/A | #N/A | PCE | 461-1013-ND | #N/A | #N/A | #N/A | #N/A | 0 | #N/A | #N/A | #N/A | #N/A | #N/A | #N/A | #N/A | #N/A
EL-MS0099 | HOOK MINI TEST CONN RED | #N/A | #N/A | #N/A | PCE | 461-1014-ND | #N/A | #N/A | #N/A | #N/A | 0 | #N/A | #N/A | #N/A | #N/A | #N/A | #N/A | #N/A | #N/A
EL-MS0100 | MOD PWR INLET STD FILTER 10A PNL | #N/A | #N/A | #N/A | PCE | 486-2181-ND | #N/A | #N/A | #N/A | #N/A | 0 | #N/A | #N/A | #N/A | #N/A | #N/A | #N/A | #N/A | #N/A
EL-MS0101 | Modular Plug | #N/A | #N/A | #N/A | PCE | 783250853960 | #N/A | #N/A | #N/A | #N/A | 0 | #N/A | #N/A | #N/A | #N/A | #N/A | #N/A | #N/A | #N/A
EL-MS0102 | (OLD - use EL-MS0012) Noninsulated Wire Ferrule, 24-20 AWG, .31" pin length | #N/A | #N/A | #N/A | PCE | 9681K15 | #N/A | #N/A | #N/A | #N/A | 0 | #N/A | #N/A | #N/A | #N/A | #N/A | #N/A | #N/A | #N/A
EL-MS0103 | Rectifiers Vr/400V Io/1A | #N/A | #N/A | #N/A | PCE | 625-1N4004-E3/54 | #N/A | #N/A | #N/A | #N/A | 0 | #N/A | #N/A | #N/A | #N/A | #N/A | #N/A | #N/A | #N/A
EL-MS0104 | Ring Term 12-10 GA | #N/A | #N/A | #N/A | PCE | 85417 | #N/A | #N/A | #N/A | #N/A | 0 | #N/A | #N/A | #N/A | #N/A | #N/A | #N/A | #N/A | #N/A
EL-MS0105 | Safe Glass Fuse, Littelfuse | #N/A | #N/A | #N/A | PCE | 819562006029 | #N/A | #N/A | #N/A | #N/A | 0 | #N/A | #N/A | #N/A | #N/A | #N/A | #N/A | #N/A | #N/A
EL-MS0106 | Solid State Relay SSR-25DA 25A /250V 3-32VDC for Temperature Controller | #N/A | #N/A | #N/A | PCE | 0 | #N/A | #N/A | #N/A | #N/A | 0 | #N/A | #N/A | #N/A | #N/A | #N/A | #N/A | #N/A | #N/A
EL-MS0107 | Static Control Strap for Personnel, 4 Receptacle Grounding Station, 10' Straight Cord | #N/A | #N/A | #N/A | PCE | 72555K66 | #N/A | #N/A | #N/A | #N/A | 0 | #N/A | #N/A | #N/A | #N/A | #N/A | #N/A | #N/A | #N/A
EL-MS0108 | Static Control Strap for Personnel, Wrist Strap, Coiled Cord, 6' Cord Length | #N/A | #N/A | #N/A | PCE | 72555K55 | #N/A | #N/A | #N/A | #N/A | 0 | #N/A | #N/A | #N/A | #N/A | #N/A | #N/A | #N/A | #N/A
EL-MS0109 | Static Control Strap for Personnel, Wrist Strap, Straight Cord, 4' Cord Length | #N/A | #N/A | #N/A | PCE | 72555K54 | #N/A | #N/A | #N/A | #N/A | 0 | #N/A | #N/A | #N/A | #N/A | #N/A | #N/A | #N/A | #N/A
EL-MS0110 | Static Control Strap for Personnel, Wrist Strap, Straight Cord, 6' Cord Length | #N/A | #N/A | #N/A | PCE | 72555K53 | #N/A | #N/A | #N/A | #N/A | 0 | #N/A | #N/A | #N/A | #N/A | #N/A | #N/A | #N/A | #N/A
EL-MS0111 | Term QD 12-10 F .375 | #N/A | #N/A | #N/A | PCE | 85447 | #N/A | #N/A | #N/A | #N/A | 0 | #N/A | #N/A | #N/A | #N/A | #N/A | #N/A | #N/A | #N/A
EL-MS0112 | Wall Socket, single | #N/A | #N/A | #N/A | PCE | 0 | #N/A | #N/A | #N/A | #N/A | 0 | #N/A | #N/A | #N/A | #N/A | #N/A | #N/A | #N/A | #N/A
EL-MS0113 | TRENDnet Rack Mount Kit for TEG-S16Dg and TEG-S24Dg (ETH-11MK) | #N/A | #N/A | #N/A | PCE | 0 | #N/A | #N/A | #N/A | #N/A | 0 | #N/A | #N/A | #N/A | #N/A | #N/A | #N/A | #N/A | #N/A
EL-MS0114 | Transcend 16GB Class 10 SDHC Flash Memory Card (TS16GSDHC10E) | #N/A | #N/A | #N/A | PCE | 0 | #N/A | #N/A | #N/A | #N/A | 0 | #N/A | #N/A | #N/A | #N/A | #N/A | #N/A | #N/A | #N/A
EL-MS0115 | CONN PWR PLUG DC 2.1X5.5 8A MOD | #N/A | #N/A | #N/A | PCE | CP3-002AH-ND | #N/A | #N/A | #N/A | #N/A | 0 | #N/A | #N/A | #N/A | #N/A | #N/A | #N/A | #N/A | #N/A
EL-MS0116 | Kingston 8 GB 240-Pin DDR3 SDRAM ECC Registered DDR3 1600 (PC3 12800) Server Memory DR x4 Model KVR16R11D4/8 | #N/A | #N/A | #N/A | PCE | N82E16820239229 | #N/A | #N/A | #N/A | #N/A | 0 | #N/A | #N/A | #N/A | #N/A | #N/A | #N/A | #N/A | #N/A
EL-MS0117 | Pluggable Terminal Block, 6 contacts 5.08mm (black) | #N/A | #N/A | #N/A | PCE | 0 | #N/A | #N/A | #N/A | #N/A | 0 | #N/A | #N/A | #N/A | #N/A | #N/A | #N/A | #N/A | #N/A
EL-MS0118 | Pluggable Terminal Block, 2 contacts 5.08mm (black) | #N/A | #N/A | #N/A | PCE | 0 | #N/A | #N/A | #N/A | #N/A | 0 | #N/A | #N/A | #N/A | #N/A | #N/A | #N/A | #N/A | #N/A
EL-MS0119 | SD Card from GLCD Kit | #N/A | #N/A | #N/A | PCE | 0 | #N/A | #N/A | #N/A | #N/A | 0 | #N/A | #N/A | #N/A | #N/A | #N/A | #N/A | #N/A | #N/A
EL-MS0120 | (N82E16820239275) Kingston 16GB 240-Pin DDR3 SDRAM ECC Registered DDR3 1600 Server Memory DR x4 Model KVR16R11D4/16 | #N/A | #N/A | #N/A | PCE | N82E13820239275 | #N/A | #N/A | #N/A | #N/A | 0 | #N/A | #N/A | #N/A | #N/A | #N/A | #N/A | #N/A | #N/A
EL-MS0121 | 14-18 AWG Tin Sockets for Receptacle, 4k reel | #N/A | #N/A | #N/A | PCE | 1-66358-6 | #N/A | #N/A | #N/A | #N/A | 1-66359-4 | #N/A | #N/A | #N/A | #N/A | #N/A | #N/A | #N/A | #N/A
EL-MS0122 | CONN PIN .062 14-18AWG TIN CRIMP | #N/A | #N/A | #N/A | PCE | 1-66359-4 | #N/A | #N/A | #N/A | #N/A | 0 | #N/A | #N/A | #N/A | #N/A | #N/A | #N/A | #N/A | #N/A
EL-MS0123 | CONN PIN .062 24-26AWG TIN CRIMP | #N/A | #N/A | #N/A | PCE | 1-66106-5 | #N/A | #N/A | #N/A | #N/A | 0 | #N/A | #N/A | #N/A | #N/A | #N/A | #N/A | #N/A | #N/A
EL-MS0124 | 20-24 AWG Tin Sockets for Receptacle - 4K Reel | #N/A | #N/A | #N/A | PCE | 1-66331-4 | #N/A | #N/A | #N/A | #N/A | 1-66331-4 | #N/A | #N/A | #N/A | #N/A | #N/A | #N/A | #N/A | #N/A
EL-MS0126 | CONN PLUG, 25 POS, IDC GOLD | #N/A | #N/A | #N/A | PCE | 3M15408-ND | #N/A | #N/A | #N/A | #N/A | 0 | #N/A | #N/A | #N/A | #N/A | #N/A | #N/A | #N/A | #N/A
EL-MS0127 | CONN D-SUB RCPT 25 POS IDC GOLD | #N/A | #N/A | #N/A | PCE | 8325-8003 | #N/A | #N/A | #N/A | #N/A | 0 | #N/A | #N/A | #N/A | #N/A | #N/A | #N/A | #N/A | #N/A
EL-MS0128 | CONN PLUG CPC 4POS REV SER 1 | #N/A | #N/A | #N/A | PCE | 206429-1 | #N/A | #N/A | #N/A | #N/A | 206429-1 | #N/A | #N/A | #N/A | #N/A | #N/A | #N/A | #N/A | #N/A
EL-MS0129 | CONN CABLE CLAMP CPC SIZE 17 BLK | #N/A | #N/A | #N/A | PCE | 206070-8 | #N/A | #N/A | #N/A | #N/A | 20607-8 | #N/A | #N/A | #N/A | #N/A | #N/A | #N/A | #N/A | #N/A
EL-MS0130 | CONN CABLE CLAMP R/A CPC SIZE 17 | #N/A | #N/A | #N/A | PCE | 1546349-2 | #N/A | #N/A | #N/A | #N/A | 0 | #N/A | #N/A | #N/A | #N/A | #N/A | #N/A | #N/A | #N/A
EL-MS0131 | CONN PLUG CPC 14POS REV SER 1 | #N/A | #N/A | #N/A | PCE | A1358-ND | #N/A | #N/A | #N/A | #N/A | 206044-1 | #N/A | #N/A | #N/A | #N/A | #N/A | #N/A | #N/A | #N/A
EL-MS0132 | CONN CLAMP, R/A, W/O COVER, SIZE 17 | #N/A | #N/A | #N/A | PCE | 0 | #N/A | #N/A | #N/A | #N/A | 0 | #N/A | #N/A | #N/A | #N/A | #N/A | #N/A | #N/A | #N/A
EL-MS0133 | CONN, RCPT, 14 POS w/Brass Inserts | #N/A | #N/A | #N/A | PCE | 211103-1 | #N/A | #N/A | #N/A | #N/A | 0 | #N/A | #N/A | #N/A | #N/A | #N/A | #N/A | #N/A | #N/A
EL-MS0134 | Conn backshell DB25 Flat Ribbon Plast | #N/A | #N/A | #N/A | PCE | 636-976-025-010R031 | #N/A | #N/A | #N/A | #N/A | 0 | #N/A | #N/A | #N/A | #N/A | #N/A | #N/A | #N/A | #N/A
EL-MS0136 | Corrugated Wrap-Around Polyethylene Sleeving, 3/8" ID, 100' Length, Blue | #N/A | #N/A | #N/A | ft | 7700k52 | #N/A | #N/A | #N/A | #N/A | 0 | #N/A | #N/A | #N/A | #N/A | #N/A | #N/A | #N/A | #N/A
EL-MS0138 | SPEAKER 4OHM 3W 82DB 28X40MM | #N/A | #N/A | #N/A | PCE | 668-1234-ND | #N/A | #N/A | #N/A | #N/A | 0 | #N/A | #N/A | #N/A | #N/A | #N/A | #N/A | #N/A | #N/A
EL-MS0139 | Tubing Corrugated Loom 3/8" ID, Black, 1900' Box | #N/A | #N/A | #N/A | ft | 7840K72 | #N/A | #N/A | #N/A | #N/A | 88-00012 | #N/A | #N/A | #N/A | #N/A | #N/A | #N/A | #N/A | #N/A
EL-MS0140 | Conn Cable Clamp Shell size 11 for 4-Pos; 0.329” opening | #N/A | #N/A | #N/A | PCE | 1-206062-5 | #N/A | #N/A | #N/A | #N/A | 0 | #N/A | #N/A | #N/A | #N/A | #N/A | #N/A | #N/A | #N/A
EL-MS0141 | Term Ring Non Ins 26-22AWG #4 Order Bulk Only | 0 | 0 | 0 | PCE | P22-4R-M | Electronic | 0.069 |  | 0 | P22-4R-M | TTI | P22-4R-M | 0 | 0 | 0 | 0 | 0 | 0
EL-MS0142 | Conn Recept Faston 22-26AWG .110 - Reel of 3K | 0 | 0 | 0 | PCE | 0 | Electronic | 0.075 |  | 0 | 7-520365-2 | TTI | A27793-ND | 0 | 0 | 0 | 0 | 0 | 0
EL-MS0143 | Conn Fast Receptacle14-16 AWG .250 - REEL of 2200 Units | 0 | 0 | 0 | PCE | 3-350819-2 | Electronic | 0.069 |  | 0 | 3-350819-2 | TTI | 22-26AWG .110 | 0 | 0 | 0 | 0 | 0 | 0
EL-MS0144 | Connector Accessories, Sealing Cap, Shell Size 17 | #N/A | #N/A | #N/A | PCE | 207445-3 | #N/A | #N/A | #N/A | #N/A | 207445-3 | #N/A | #N/A | #N/A | #N/A | #N/A | #N/A | #N/A | #N/A
EL-MS0145 | CONN D-SUB PLUG 25POS IDC GOLD | #N/A | #N/A | #N/A | PCE | 3M15408-ND | #N/A | #N/A | #N/A | #N/A | 0 | #N/A | #N/A | #N/A | #N/A | #N/A | #N/A | #N/A | #N/A
EL-MS0148 | (OLD) 14-18 AWG Tin Sockets for Receptacle-[use EL-MS0121] | #N/A | #N/A | #N/A | PCE | A31997-ND | #N/A | #N/A | #N/A | #N/A | 0 | #N/A | #N/A | #N/A | #N/A | #N/A | #N/A | #N/A | #N/A
EL-MS0149 | (obsolete use EL-MS0122) 14-18 AWG Tin Pin for Plug | #N/A | #N/A | #N/A | PCE | A31998-ND | #N/A | #N/A | #N/A | #N/A | 0 | #N/A | #N/A | #N/A | #N/A | #N/A | #N/A | #N/A | #N/A
EL-MS0150 | CONN PIN 20-24AWG TIN CRIMP | #N/A | #N/A | #N/A | PCE | A32008TR-ND | #N/A | #N/A | #N/A | #N/A | 0 | #N/A | #N/A | #N/A | #N/A | #N/A | #N/A | #N/A | #N/A
EL-MS0151 | CONN SOCKET 20-24AWG TIN CRIMP | #N/A | #N/A | #N/A | PCE | A31990TR-ND | #N/A | #N/A | #N/A | #N/A | 0 | #N/A | #N/A | #N/A | #N/A | #N/A | #N/A | #N/A | #N/A
EL-MS0152 | CONN SKT .062 20-24AWG TIN CRIMP | #N/A | #N/A | #N/A | PCE | A32007TR-ND | #N/A | #N/A | #N/A | #N/A | 0 | #N/A | #N/A | #N/A | #N/A | #N/A | #N/A | #N/A | #N/A
EL-MS0153 | CONN SKT .062 14-18AWG AU CRIMP | #N/A | #N/A | #N/A | PCE | A25012TR-ND | #N/A | #N/A | #N/A | #N/A | 0 | #N/A | #N/A | #N/A | #N/A | #N/A | #N/A | #N/A | #N/A
EL-MS0155 | Serial Enabled 20x4 LCD - Black on Green 5V | #N/A | #N/A | #N/A | PCE | LCD-09568 | #N/A | #N/A | #N/A | #N/A | 0 | #N/A | #N/A | #N/A | #N/A | #N/A | #N/A | #N/A | #N/A
EL-MS0156 | IC REG LDO 5V 3A TO220-3 | #N/A | #N/A | #N/A | PCE | 576-1121-ND | #N/A | #N/A | #N/A | #N/A | 0 | #N/A | #N/A | #N/A | #N/A | #N/A | #N/A | #N/A | #N/A
EL-MS0157 | Tubing Corrugated Loom .25", Blue | #N/A | #N/A | #N/A | ft | 7700K51 | #N/A | #N/A | #N/A | #N/A | 0 | #N/A | #N/A | #N/A | #N/A | #N/A | #N/A | #N/A | #N/A
EL-MS0158 | JY-MCU Bluetooth Wireless Serial Port Module for Arduino | #N/A | #N/A | #N/A | PCE | 104299 | #N/A | #N/A | #N/A | #N/A | 0 | #N/A | #N/A | #N/A | #N/A | #N/A | #N/A | #N/A | #N/A
EL-MS0159 | Eleronic Butt Terminal | #N/A | #N/A | #N/A | PCE | 0 | #N/A | #N/A | #N/A | #N/A | 0 | #N/A | #N/A | #N/A | #N/A | #N/A | #N/A | #N/A | #N/A
EL-MS0160 | Noninsulated Wire Ferrule, 14 AWG, .39" Pin Length | #N/A | #N/A | #N/A | PCE | 11225-04231 | #N/A | #N/A | #N/A | #N/A | 11225-04231 | #N/A | #N/A | #N/A | #N/A | #N/A | #N/A | #N/A | #N/A
EL-MS0161 | LCD Graphic Display Modules & Accessories 4.3"LCDDispCAPEw/Tch for Beaglebone Black | #N/A | #N/A | #N/A | PCE | 971-4DCAPE-43T | #N/A | #N/A | #N/A | #N/A | 0 | #N/A | #N/A | #N/A | #N/A | #N/A | #N/A | #N/A | #N/A
EL-MS0162 | Display Modules 7" LCD DispCapew/tch for BeagleBone Black | #N/A | #N/A | #N/A | PCE | 971-4DCAPE-70T | #N/A | #N/A | #N/A | #N/A | 0 | #N/A | #N/A | #N/A | #N/A | #N/A | #N/A | #N/A | #N/A
EL-MS0163 | CONN PIN .062 24-26AWG TIN CRIMP | #N/A | #N/A | #N/A | PCE | 1-66107-2-ND (BULK) | #N/A | #N/A | #N/A | #N/A | 0 | #N/A | #N/A | #N/A | #N/A | #N/A | #N/A | #N/A | #N/A
EL-MS0164 | Servo - Generic (Sub-Micro Size) | #N/A | #N/A | #N/A | PCE | ROB-09065 | #N/A | #N/A | #N/A | #N/A | 0 | #N/A | #N/A | #N/A | #N/A | #N/A | #N/A | #N/A | #N/A
EL-MS0165 | Snap-Together Cable and Hose Carrier, Feed-Through, 0.41" High x 0.39" Wide Interior Size | 0 | 0 | 0 | ft | 06-10-028-0 | Hardware | 0.0202604986877 |  | 0 | 06-10-028-0 | IGUS | 06-10-028-0 | 0 | 0 | 0 | 0 | 0 | 0
EL-MS0165- old | (OLD) Snap-Together Cable and Hose Carrier, Feed-Through, 0.41" High x 0.39" Wide Interior Size | #N/A | #N/A | #N/A | PCE | 55835K32 | #N/A | #N/A | #N/A | #N/A | 0 | #N/A | #N/A | #N/A | #N/A | #N/A | #N/A | #N/A | #N/A
EL-MS0166-Female | Mounting Brackets for .41" High x .39" Wide Interior Snap-Together Cable and Hose Carrier - Female | #N/A | #N/A | #N/A | PCE | 060-10-1 | #N/A | #N/A | #N/A | #N/A | 060-10-12 | #N/A | #N/A | #N/A | #N/A | #N/A | #N/A | #N/A | #N/A
EL-MS0166-Male | Mounting Brackets for .41" High x .39" Wide Interior Snap-Together Cable and Hose Carrier - Male | #N/A | #N/A | #N/A | PCE | 55835K2 | #N/A | #N/A | #N/A | #N/A | 060-10-12 | #N/A | #N/A | #N/A | #N/A | #N/A | #N/A | #N/A | #N/A
EL-MS0167 | QUALITY USA brand fuses, Set of 5 pcs, T6.3AL250V, T6.3A 250V, T6.3L250V cartridge GLASS fuses 5X20mm (3/16" X 3/4"), 6.3A 250V | #N/A | #N/A | #N/A | PCE | 0 | #N/A | #N/A | #N/A | #N/A | 0 | #N/A | #N/A | #N/A | #N/A | #N/A | #N/A | #N/A | #N/A
EL-MS0168 | UniCrimp 200 Crimping Machine | #N/A | #N/A | #N/A | PCE | 0 | #N/A | #N/A | #N/A | #N/A | 0 | #N/A | #N/A | #N/A | #N/A | #N/A | #N/A | #N/A | #N/A
EL-MS0169 | Uni-A Mechanical Side Feed / Double Banded Applicator for Processing Molex Terminal #16-02-0086 | #N/A | #N/A | #N/A | PCE | 0 | #N/A | #N/A | #N/A | #N/A | 0 | #N/A | #N/A | #N/A | #N/A | #N/A | #N/A | #N/A | #N/A
EL-MS0170 | Uni-A Mechanical Side Feed / Front Banded Applicator for Processing Molex Terminal #16-02-0105 | #N/A | #N/A | #N/A | PCE | 0 | #N/A | #N/A | #N/A | #N/A | 0 | #N/A | #N/A | #N/A | #N/A | #N/A | #N/A | #N/A | #N/A
EL-MS0171 | FUSE 10 A/T 5x20 (115V) | #N/A | #N/A | #N/A | PCE | CRK-22042 | #N/A | #N/A | #N/A | #N/A | 0 | #N/A | #N/A | #N/A | #N/A | #N/A | #N/A | #N/A | #N/A
EL-MS0172 | FUSE 2 A/T 5x20 (24V) | #N/A | #N/A | #N/A | PCE | CRK-6270008 | #N/A | #N/A | #N/A | #N/A | 0 | #N/A | #N/A | #N/A | #N/A | #N/A | #N/A | #N/A | #N/A
EL-MS0173 | MAGNETIC BASE FOR WORK LIGHT | #N/A | #N/A | #N/A | PCE | CRK-1005 | #N/A | #N/A | #N/A | #N/A | 0 | #N/A | #N/A | #N/A | #N/A | #N/A | #N/A | #N/A | #N/A
EL-MS0174 | Olimex LCD Graphic Display Modules & Accessories 7 IN TFT TOUCHSCREEN A13 OLINUXINO | #N/A | #N/A | #N/A | PCE | 909-A13-LCD7-TS | #N/A | #N/A | #N/A | #N/A | 0 | #N/A | #N/A | #N/A | #N/A | #N/A | #N/A | #N/A | #N/A
EL-MS0175 | pcDuino3 | #N/A | #N/A | #N/A | PCE | PCDUINOV3 | #N/A | #N/A | #N/A | #N/A | 0 | #N/A | #N/A | #N/A | #N/A | #N/A | #N/A | #N/A | #N/A
EL-MS0176 | Kingston Digital 8 GB microSD Class 10 UHS-1 Memory Card 30MB/s with Adapter SDC10/8GB | #N/A | #N/A | #N/A | PCE | 0 | #N/A | #N/A | #N/A | #N/A | 0 | #N/A | #N/A | #N/A | #N/A | #N/A | #N/A | #N/A | #N/A
EL-MS0177 | Micro USB OTG Adapter | #N/A | #N/A | #N/A | PCE | 9724 | #N/A | #N/A | #N/A | #N/A | 0 | #N/A | #N/A | #N/A | #N/A | #N/A | #N/A | #N/A | #N/A
EL-MS0178 | RJ-45 MODULAR PLUGS RJ45 - 100 PACK FOR SOLID | #N/A | #N/A | #N/A | PCE | 7245 | #N/A | #N/A | #N/A | #N/A | 0 | #N/A | #N/A | #N/A | #N/A | #N/A | #N/A | #N/A | #N/A
EL-MS0179 | Cat5e Inline Coupler - White | #N/A | #N/A | #N/A | PCE | 7284 | #N/A | #N/A | #N/A | #N/A | 0 | #N/A | #N/A | #N/A | #N/A | #N/A | #N/A | #N/A | #N/A
EL-MS0180 | Prototyping board, PC BOARD 2-SIDE PPH 2.0X3.0 | #N/A | #N/A | #N/A | PCE | V2025-ND | #N/A | #N/A | #N/A | #N/A | 8029 | #N/A | #N/A | #N/A | #N/A | #N/A | #N/A | #N/A | #N/A
EL-MS0181 | Breakout pins, 2x36 | #N/A | #N/A | #N/A | PCE | S2252E-36-ND | #N/A | #N/A | #N/A | #N/A | 0 | #N/A | #N/A | #N/A | #N/A | #N/A | #N/A | #N/A | #N/A
EL-MS0182 | Breakout pins, 1x36 | #N/A | #N/A | #N/A | PCE | WM50018-36-ND | #N/A | #N/A | #N/A | #N/A | 0 | #N/A | #N/A | #N/A | #N/A | #N/A | #N/A | #N/A | #N/A
EL-MS0183 | 2 POS Term block header, 5.08mm | #N/A | #N/A | #N/A | PCE | WM7837-ND | #N/A | #N/A | #N/A | #N/A | 395311002 | #N/A | #N/A | #N/A | #N/A | #N/A | #N/A | #N/A | #N/A
EL-MS0184 | 24V 40W Heater Cartridge | #N/A | #N/A | #N/A | PCE | 0 | #N/A | #N/A | #N/A | #N/A | 0 | #N/A | #N/A | #N/A | #N/A | #N/A | #N/A | #N/A | #N/A
EL-MS0200 | FOOT PEDAL, UniCrimp | #N/A | #N/A | #N/A | PCE | SCH-404129 | #N/A | #N/A | #N/A | #N/A | 0 | #N/A | #N/A | #N/A | #N/A | #N/A | #N/A | #N/A | #N/A
EL-MS0201 | 7"HDMI LCD Module Display Optional TouchScreen VGA,Video Driver board | #N/A | #N/A | #N/A | PCE | ER-TFTV070-3 | #N/A | #N/A | #N/A | #N/A | 0 | #N/A | #N/A | #N/A | #N/A | #N/A | #N/A | #N/A | #N/A
EL-MS0202 | Power Module | #N/A | #N/A | #N/A | PCE | PL-TPower | #N/A | #N/A | #N/A | #N/A | 0 | #N/A | #N/A | #N/A | #N/A | #N/A | #N/A | #N/A | #N/A
EL-MS0203 | Leviton 30/50 Amp Black Commercial Grade Straight Blade Plug (00931-000) | #N/A | #N/A | #N/A | PCE | 3201365 | #N/A | #N/A | #N/A | #N/A | 0 | #N/A | #N/A | #N/A | #N/A | #N/A | #N/A | #N/A | #N/A
EL-MS0204 | 10mm Strip to Strip Snap Connector for RGB | #N/A | #N/A | #N/A | PCE | RGB-C2 | #N/A | #N/A | #N/A | #N/A | 0 | #N/A | #N/A | #N/A | #N/A | #N/A | #N/A | #N/A | #N/A
EL-MS0205 | Molex-CONN TERM MALE 22-24AWG TIN - Reels of 20K | 0 | 0 | 0 | PCE | 16-02-0107 | Electronic | 0.0185 |  | Molex | 16-02-0107 | TTI | WM2517TR-ND | 0 | 0 | 0 | 0 | 0 | 0
EL-MS0206 | CONN 3.5MM MALE MONO PHONE PLUG | #N/A | #N/A | #N/A | PCE | CP3-1005-ND | #N/A | #N/A | #N/A | #N/A | MP3-3501 | #N/A | #N/A | #N/A | #N/A | #N/A | #N/A | #N/A | #N/A
EL-MS0207 | POT 10K OHM 17MM RD .06W CARB | #N/A | #N/A | #N/A | PCE | PDB182-E420K-103A-ND | #N/A | #N/A | #N/A | #N/A | 0 | #N/A | #N/A | #N/A | #N/A | #N/A | #N/A | #N/A | #N/A
EL-MS0208 | Crucial 16GB (2 x 8GB) 240-Pin DDR3 SDRAM ECC Unbuffered DDR3 1600 (PC3 12800) Server Memory Model CT2KIT102472BA160B | #N/A | #N/A | #N/A | PCE | 0 | #N/A | #N/A | #N/A | #N/A | 0 | #N/A | #N/A | #N/A | #N/A | #N/A | #N/A | #N/A | #N/A
EL-MS0209 | BULK - RING TONGUE CONN 16-22 AWG #10 PIDG | #N/A | #N/A | #N/A | PCE | A1062-ND | #N/A | #N/A | #N/A | #N/A | 0 | #N/A | #N/A | #N/A | #N/A | #N/A | #N/A | #N/A | #N/A
EL-MS0210 | CONN RING UNINS 15-20AWG #M3 DO NOT USE See EL-MS0246 | #N/A | #N/A | #N/A | PCE | A107160CT-ND | #N/A | #N/A | #N/A | #N/A | 0 | #N/A | #N/A | #N/A | #N/A | #N/A | #N/A | #N/A | #N/A
EL-MS0211 | TE- REEL / RING TONGUE CONN 16-22 AWG #10 PIDG | 0 | 0 | 0 | PCE | 2-36154.2 | Electronic | 0.0854 |  | TE | 2-36154-2 | SAGER | A1062TR-ND | 0 | 0 | 0 | 0 | 0 | 0
EL-MS0212 | Molex-CONN PIN 24-30AWG Crimp Tin, 20,000 Unit Reel | #N/A | #N/A | #N/A | PCE | WM2565-ND | #N/A | 0.022 | #N/A | Molex | 16-02-0105 | TTI | #N/A | #N/A | #N/A | #N/A | #N/A | #N/A | #N/A
EL-MS0213 | 2 x 50' Vinyl Anti-Static Table Mat | #N/A | #N/A | #N/A | PCE | S-14117 | #N/A | 570 | #N/A | #N/A | 0 | uline | s-14117 | #N/A | #N/A | #N/A | #N/A | #N/A | #N/A
EL-MS0214 | Ferrite Tubular Bead 13.72mm | #N/A | #N/A | #N/A | PCE | 240-2116-ND | #N/A | #N/A | #N/A | #N/A | 0 | #N/A | #N/A | #N/A | #N/A | #N/A | #N/A | #N/A | #N/A
EL-MS0215 | Ferrite Tubular Bead 15.49mm | #N/A | #N/A | #N/A | PCE | 240-2313-ND | #N/A | #N/A | #N/A | #N/A | 0 | #N/A | #N/A | #N/A | #N/A | #N/A | #N/A | #N/A | #N/A
EL-MS0216 | Steward-Ferrite Tubular Bead 19.00mm | 0 | 0 | 0 | PCE | 28B1142-100 | Electronic | 0.295 |  | Laird Technologies - Signal Integrity Products | 28B1142-100 | SAGER | 28B1142-100 | Received SAGER $0.295 ea 12-14 wk leadtime w/expedite | 0 | 0 | 0 | 0 | 0
EL-MS0217 | Ferrite Tubular Bead 19.00mm | #N/A | #N/A | #N/A | PCE | 240-2118-ND | #N/A | #N/A | #N/A | #N/A | 0 | #N/A | #N/A | #N/A | #N/A | #N/A | #N/A | #N/A | #N/A
EL-MS0218 | FERRITE BEAD CORE EMI L/F 15.0MM | #N/A | #N/A | #N/A | PCE | 240-2285-ND | #N/A | #N/A | #N/A | #N/A | 0 | #N/A | #N/A | #N/A | #N/A | #N/A | #N/A | #N/A | #N/A
EL-MS0219 | Ferrite Bead Core EMI L/F 10.0mm | #N/A | #N/A | #N/A | PCE | 240-2283-ND | #N/A | #N/A | #N/A | #N/A | 0 | #N/A | #N/A | #N/A | #N/A | #N/A | #N/A | #N/A | #N/A
EL-MS0220 | SWM Style USB Flash drive, 4gb, black with MINI logo | #N/A | #N/A | #N/A | PCE | 0 | #N/A | #N/A | #N/A | #N/A | 0 | #N/A | #N/A | #N/A | #N/A | #N/A | #N/A | #N/A | #N/A
EL-MS0221 | Near Field E/H Probe Set to 3GHz | #N/A | #N/A | #N/A | PCE | EMCO-7405 | #N/A | #N/A | #N/A | #N/A | 0 | #N/A | #N/A | #N/A | #N/A | #N/A | #N/A | #N/A | #N/A
EL-MS0222 | 9kHz-6GHz Spectrum Analyzer w/EMI Filter/Detector/Tracking Gen opts B31/34,B30,K9,B7,B8,B22 | #N/A | #N/A | #N/A | PCE | ROHD-FSL616-PKG02 | #N/A | #N/A | #N/A | #N/A | 0 | #N/A | #N/A | #N/A | #N/A | #N/A | #N/A | #N/A | #N/A
EL-MS0223 | 9kHz-200MHz Transient Limiter, BNC(f) Input, N(m) Output | #N/A | #N/A | #N/A | PCE | AGIL-11947A | #N/A | #N/A | #N/A | #N/A | 0 | #N/A | #N/A | #N/A | #N/A | #N/A | #N/A | #N/A | #N/A
EL-MS0224 | LISN, 10kHz-50MHz 500V Single Line, 50A max, 50uH | #N/A | #N/A | #N/A | PCE | SOLA-9247-50-TS-50-N | #N/A | #N/A | #N/A | #N/A | 0 | #N/A | #N/A | #N/A | #N/A | #N/A | #N/A | #N/A | #N/A
EL-MS0225 | Broadband AMPL / SMA | #N/A | #N/A | #N/A | PCE | ZFL-1000LN+ | #N/A | #N/A | #N/A | #N/A | 0 | #N/A | #N/A | #N/A | #N/A | #N/A | #N/A | #N/A | #N/A
EL-MS0226 | Programmable DC Power Supply with 2 0-30V/3A c | #N/A | #N/A | #N/A | PCE | RIGOLDP832 | #N/A | #N/A | #N/A | #N/A | 0 | #N/A | #N/A | #N/A | #N/A | #N/A | #N/A | #N/A | #N/A
EL-MS0227 | Conn Adapt SMA Plug to BNC Jack | #N/A | #N/A | #N/A | PCE | J10098-ND | #N/A | #N/A | #N/A | #N/A | 0 | #N/A | #N/A | #N/A | #N/A | #N/A | #N/A | #N/A | #N/A
EL-MS0228 | Test Lead STKG BANAMINGRABR - BLACK | #N/A | #N/A | #N/A | PCE | 501-1060-ND | #N/A | #N/A | #N/A | #N/A | 0 | #N/A | #N/A | #N/A | #N/A | #N/A | #N/A | #N/A | #N/A
EL-MS0229 | Test Lead STKG BANAMINGRABR - RED | #N/A | #N/A | #N/A | PCE | 501-1061-ND | #N/A | #N/A | #N/A | #N/A | 0 | #N/A | #N/A | #N/A | #N/A | #N/A | #N/A | #N/A | #N/A
EL-MS0231 | Pneumatic Feed Kit for pneumatic applicator | #N/A | #N/A | #N/A | PCE | CRK-5000 | #N/A | #N/A | #N/A | #N/A | 0 | #N/A | #N/A | #N/A | #N/A | #N/A | #N/A | #N/A | #N/A
EL-MS0232 | Uni-A Mechanical Side Feed / Front Banded Applicator, for Processing TE #1-66331-4 | #N/A | #N/A | #N/A | PCE | SCA-700266001 | #N/A | #N/A | #N/A | #N/A | 0 | #N/A | #N/A | #N/A | #N/A | #N/A | #N/A | #N/A | #N/A
EL-MS0233 | Uni-A Mechanical Side Feed / Front Banded Applicator, for Processing TE #1-66358-6 & 1-66359-4 | #N/A | #N/A | #N/A | PCE | SCA-700269001 for Processing TE# 1-66358-6 & 1-66359-4 | #N/A | #N/A | #N/A | #N/A | 0 | #N/A | #N/A | #N/A | #N/A | #N/A | #N/A | #N/A | #N/A
EL-MS0234 | Uni-A Mechanical Side Feed / Front Banded Applicator, for processing TE #1-66106-5 | #N/A | #N/A | #N/A | PCE | 0 | #N/A | #N/A | #N/A | #N/A | 0 | #N/A | #N/A | #N/A | #N/A | #N/A | #N/A | #N/A | #N/A
EL-MS0235 | Surface Mount Fuses 125V V/FA 5A NANO2 | #N/A | #N/A | #N/A | PCE | 576-0448005.MR | #N/A | #N/A | #N/A | #N/A | 0 | #N/A | #N/A | #N/A | #N/A | #N/A | #N/A | #N/A | #N/A
EL-MS0236 | Steward-FERRITE CYLINDR BOX CLAMP.350"WHT | #N/A | #N/A | #N/A | PCE | 28A2029-0A0 | #N/A | #N/A | #N/A | #N/A | 28A2029-0A0 | #N/A | #N/A | #N/A | #N/A | #N/A | #N/A | #N/A | #N/A
EL-MS0237 | FERRITE BEADCORE L/F EMI 19.00MM | #N/A | #N/A | #N/A | PCE | 240-2139-ND | #N/A | #N/A | #N/A | #N/A | 0 | #N/A | #N/A | #N/A | #N/A | #N/A | #N/A | #N/A | #N/A
EL-MS0238 | Enercell™ High-Power AC Adapter | #N/A | #N/A | #N/A | PCE | 0 | #N/A | #N/A | #N/A | #N/A | 0 | #N/A | #N/A | #N/A | #N/A | #N/A | #N/A | #N/A | #N/A
EL-MS0239 | Grounding Cord Kit for Rubber Static Control Work Surface Mat | #N/A | #N/A | #N/A | PCE | 4446T752 | #N/A | #N/A | #N/A | #N/A | 0 | #N/A | #N/A | #N/A | #N/A | #N/A | #N/A | #N/A | #N/A
EL-MS0240 | Beagle Bone Enclosure - Plastic, Black | #N/A | #N/A | #N/A | PCE | PRT-12843 | #N/A | #N/A | #N/A | #N/A | 0 | #N/A | #N/A | #N/A | #N/A | #N/A | #N/A | #N/A | #N/A
EL-MS0241 | 4 GB DataStick Pro USB 2.0 Flash Drive DSP4GB-007 | #N/A | #N/A | #N/A | PCE | DSP4GB-007 | #N/A | #N/A | #N/A | #N/A | 0 | #N/A | #N/A | #N/A | #N/A | #N/A | #N/A | #N/A | #N/A
EL-MS0242 | TAPE COPPER FOIL 12.7MMX5.5 | #N/A | #N/A | #N/A | PCE | 3M9903-ND | #N/A | #N/A | #N/A | #N/A | 0 | #N/A | #N/A | #N/A | #N/A | #N/A | #N/A | #N/A | #N/A
EL-MS0243 | Corrugated Wrap-Around Polyethylene Sleeving, 3/8" ID, 100' Length, Blue | #N/A | #N/A | #N/A | mm | 7700K52 | #N/A | #N/A | #N/A | #N/A | 0 | #N/A | #N/A | #N/A | #N/A | #N/A | #N/A | #N/A | #N/A
EL-MS0244 | D SUB CONNECTOR, STANDARD, 25 POSITION, PLUG - ASSEMBLY | #N/A | #N/A | #N/A | PCE | 8225-6000 | #N/A | #N/A | #N/A | #N/A | 0 | #N/A | #N/A | #N/A | #N/A | #N/A | #N/A | #N/A | #N/A
EL-MS0245 | D SUB CONNECTOR, STANDARD, 25 POSITION, RECEPTACLE - ASSEMBLY | #N/A | #N/A | #N/A | PCE | 8325-6003 | #N/A | #N/A | #N/A | #N/A | 0 | #N/A | #N/A | #N/A | #N/A | #N/A | #N/A | #N/A | #N/A
EL-MS0246 | Conn Ring 16-22 AWG #4 Red PIDG - Reel 5000 | 0 | 0 | 0 | PCE | A27229TR-ND | Electronic | 0.414 |  | 0 | 2-323758-1 | TTI | A27229TR-ND | TTI 10k min reels 5000 Confirmed 10/16 delivery 11-14 wks leadtime requested quote heilind 10 wks 5k min 0.414ea some stock at digikey | 0 | 0 | 0 | 0 | 0
EL-MS0247 | Heat Shrink Tubing – 0.19-0.09 – Black, 100' | #N/A | #N/A | #N/A | PCE | 7856K74 | #N/A | 22.08 | #N/A | #N/A | 0 | EDC (Electronics Distributors Corp. | 88-01870 | #N/A | #N/A | #N/A | #N/A | #N/A | #N/A
EL-MS0248 | CONN RING 14-16 AWG #10 PIDG - 5,000 Unit Reel | #N/A | #N/A | #N/A | PCE | A1072TR-ND | #N/A | #N/A | #N/A | #N/A | 2-36160-1 | #N/A | #N/A | #N/A | #N/A | #N/A | #N/A | #N/A | #N/A
EL-MS0249 | WEiPU Front Mount Male, 4 pin, solder | #N/A | #N/A | #N/A | PCE | SP2112/P4 1N | #N/A | #N/A | #N/A | #N/A | SP2112/P4 1N | #N/A | #N/A | #N/A | #N/A | #N/A | #N/A | #N/A | #N/A
EL-MS0250 | WEiPU Cable connector female, 4 pin, solder | #N/A | #N/A | #N/A | PCE | SP2110/S4II1N | #N/A | #N/A | #N/A | #N/A | SP2110/S4II 1N | #N/A | #N/A | #N/A | #N/A | #N/A | #N/A | #N/A | #N/A
EL-MS0251 | CONN HOUSING 16POS .100 DUAL | #N/A | #N/A | #N/A | PCE | 22552161 | #N/A | #N/A | #N/A | #N/A | 22552161 | #N/A | #N/A | #N/A | #N/A | #N/A | #N/A | #N/A | #N/A
EL-MS0252 | Nikon MH-23 Quick Charger for EN-EL9 Li-ion Battery by Nikon | #N/A | #N/A | #N/A | PCE | B000KWGS9K | #N/A | #N/A | #N/A | #N/A | 0 | #N/A | #N/A | #N/A | #N/A | #N/A | #N/A | #N/A | #N/A
EL-MS0253 | FERRITE TUBULAR BEAD 7.87MM | #N/A | #N/A | #N/A | PCE | 240-2115-ND | #N/A | #N/A | #N/A | #N/A | 0 | #N/A | #N/A | #N/A | #N/A | #N/A | #N/A | #N/A | #N/A
EL-MS0254 | FERRITE BRDBAND CYLINDER 17.07MM | #N/A | #N/A | #N/A | PCE | 240-2769-ND | #N/A | #N/A | #N/A | #N/A | 0 | #N/A | #N/A | #N/A | #N/A | #N/A | #N/A | #N/A | #N/A
EL-MS0255 | FERRITE EMI SPLIT/SNAP-ON CORE | #N/A | #N/A | #N/A | PCE | 240-2601-ND | #N/A | #N/A | #N/A | #N/A | 0 | #N/A | #N/A | #N/A | #N/A | #N/A | #N/A | #N/A | #N/A
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
