leedshackspace/lulzbot-mini/documentation/Bill of Materials/Mini_Gladiola_BOM_OCA_AU.ods

BoM Name | Level | Product Reference | Product Name | Quantity | Unit of Measure | BoM Reference | Manufacturer | Manufacturer Ref. | Distributor | Distributor Ref. | Distr. UOM | Price per Unit | Price per BoM Qty
LulzBot Mini v1.0, Boxed for Retail, AU |  | KT-PR0035AU | LulzBot Mini v1.0, Boxed for Retail, AU | 1 | PCE
 | > | KT-PR0035 | [KT-PR0035] Mini, Gladiola, Calibrated | 1 | PCE
 | > > | AS-PR0037 | [AS-PR0037] Mini, Gladiola, Final Electrical Assembly | 1 | PCE
 | > > > | AS-PR0042 | [AS-PR0042] Mini, Z Axis, Left Assembly | 1 | PCE
 | > > > > | AS-PR0044 | [AS-PR0044] Mini, Z upper left v1.2, Mini, complete | 1 | PCE
 | > > > > > | PP-GP0271 | [PP-GP0271] z-upper-mini-left_black_v2.0 | 1 | PCE
 | > > > > > > | RM-AB0105 | [RM-AB0105] Chroma Strand ABS Filament, Black 2.85mm, 5 lb reel | 27.65 | g |  |  |  | Chroma Strand Labs, LLC |  | Reel, 5lb | 0.02 USD/g | 0.55 USD
 | > > > > > | HD-MS0030 | [HD-MS0030] Metric Brass Heat-Set Insert for Plastics Tapered, M3-.5 Internal Thread, 3.8mm Length | 6 | PCE |  |  |  | Aero-Space Fasteners and Hardware (formerly Colorado Electronic Hardware) | PEM IUBB-M3-1 | PCE | 0.04 USD/PCE | 0.21 USD
 | > > > > | AS-PR0045 | [AS-PR0045] Mini, Z lower, Left complete | 1 | PCE
 | > > > > > | PP-GP0269 | [PP-GP0269] lower-z-left-mini_lulz-green_v1.6 | 1 | PCE
 | > > > > > > | RM-AB0104 | [RM-AB0104] Chroma Strand ABS Filament, Lulzbot Green 2.85mm, 5 lb reel | 54.68 | g |  | Chroma Strand Labs, LLC |  | Chroma Strand Labs, LLC |  | Reel, 5lb | 0.02 USD/g | 1.08 USD
 | > > > > > | HD-MS0030 | [HD-MS0030] Metric Brass Heat-Set Insert for Plastics Tapered, M3-.5 Internal Thread, 3.8mm Length | 5 | PCE |  |  |  | Aero-Space Fasteners and Hardware (formerly Colorado Electronic Hardware) | PEM IUBB-M3-1 | PCE | 0.04 USD/PCE | 0.18 USD
 | > > > > > | HD-MS0277 | [HD-MS0277] Bearing 627 Ball Bearings 627 RS - BLACK | 1 | PCE |  |  |  | JSB Great Bearings | 627-2RS | PCE | 0.65 USD/PCE | 0.65 USD
 | > > > > | AS-PR0046 | [AS-PR0046] Mini, Z carriage- X Motor Inserts and Bushing Assembly | 1 | PCE
 | > > > > > | AS-PR0047 | [AS-PR0047] Mini, X End Motor Assembly | 1 | PCE
 | > > > > > > | RM-AB0105 | [RM-AB0105] Chroma Strand ABS Filament, Black 2.85mm, 5 lb reel | 112.68 | g |  |  |  | Chroma Strand Labs, LLC |  | Reel, 5lb | 0.02 USD/g | 2.24 USD
 | > > > > > > | HD-BU0013 | [HD-BU0013] DryLin® R - Solid polymer bearing RJM-01, 8mm | 2 | PCE |  |  | RJM-01-08 | Igus, Inc. | RJM-01-08 | PCE | 1.15 USD/PCE | 2.30 USD
 | > > > > > | HD-MS0030 | [HD-MS0030] Metric Brass Heat-Set Insert for Plastics Tapered, M3-.5 Internal Thread, 3.8mm Length | 6 | PCE |  |  |  | Aero-Space Fasteners and Hardware (formerly Colorado Electronic Hardware) | PEM IUBB-M3-1 | PCE | 0.04 USD/PCE | 0.21 USD
 | > > > > > | HD-MS0158 | [HD-MS0158] Metric Brass Heat-Set Insert For Plastics Tapered, M5-.8 Internal Thread, 6.7mm Length | 3 | PCE |  |  |  | Aero-Space Fasteners and Hardware (formerly Colorado Electronic Hardware) | PEM IUBB-M5-1 | PCE | 0.07 USD/PCE | 0.22 USD
 | > > > > > | PP-MP0066 | [PP-MP0066] Metric Brass Heat-Set Insert for Plastics, Tapered, M2-.4 Internal Thread, 2.9MM Length | 4 | PCE |  |  |  | Aero-Space Fasteners and Hardware (formerly Colorado Electronic Hardware) | PEM ZZIUB-48213 | PCE | 0.05 USD/PCE | 0.20 USD
 | > > > > | DC-LB0104 | [DC-LB0104] Tool Head Wiring Connector Alignment Label | 1 | PCE |  |  |  | Sticker Giant |  | PCE | 0.03 USD/PCE | 0.03 USD
 | > > > > | EL-HR0108 | [EL-HR0108] Mini X Extruder Harnesses Assembly - revG | 1 | PCE |  | Igus, Inc. |  | Igus, Inc. |  | PCE | 73.26 USD/PCE | 73.26 USD
 | > > > > | EL-MT0029 | [EL-MT0029] NEMA 17 Stepper Motor, Moons' - NOT INCLUDING wire harness | 2 | PCE |  |  | MS17HD6P4150-01-B | Moons' Industries (America), Inc. | MS17HD6P4150-01-B | PCE | 8.30 USD/PCE | 16.60 USD
 | > > > > | EL-MT0032 | [EL-MT0032] Nema 17 Stepper Motor Damper, Flange-less, w/Pilot - Moons' | 1 | PCE |  | Moons' Industries (America), Inc. | 4696325000008 | Moons' Industries (America), Inc. | 4696325000008 | PCE | 2.45 USD/PCE | 2.45 USD
 | > > > > | EL-SW0022 | [EL-SW0022] SWITCH BASIC SPDT 3A .110QC 125V | 2 | PCE |  |  | SS-3GPT | TTI Global Distribution | SS-3GPT | PCE | 0.42 USD/PCE | 0.84 USD
 | > > > > | HD-BT0005 | [HD-BT0005] M3 x 10 Bolt, SHCS Black-oxide | 2 | PCE |  |  |  | Fastenal | 1139504 | PCE | 0.05 USD/PCE | 0.10 USD
 | > > > > | HD-BT0012 | [HD-BT0012] M3 Set Screw (Grub Screw) | 3 | PCE |  |  | 40818 | Fastenal | 40818 | PCE | 0.03 USD/PCE | 0.08 USD
 | > > > > | HD-BT0039 | [HD-BT0039] Metric Class 12.9 Socket Head Cap Screw, Alloy Steel, M3 Thread, 12MM Length, 0.50MM Pitch | 4 | PCE |  |  | 39505 | Fastenal | 39505 | PCE | 0.03 USD/PCE | 0.12 USD
 | > > > > | HD-BT0044 | [HD-BT0044] Metric Class 12.9 Socket Head Cap Screw, Alloy Steel, M3 Thread, 5MM Length, 0.50MM Pitch | 2 | PCE |  |  | 39501 | Fastenal | 39501 | PCE | 0.02 USD/PCE | 0.04 USD
 | > > > > | HD-BT0048 | [HD-BT0048] Metric Class 12.9 Socket Head Cap Screw Alloy Steel, M5 Thread, 10mm Length, 0.80mm Pitch | 3 | PCE |  |  |  | Fastenal | 39544 | PCE | 0.02 USD/PCE | 0.06 USD
 | > > > > | HD-BT0107 | [HD-BT0107] Metric Class 12.9 Socket Head Cap Screw Alloy Steel, Black, M2 Thread, 10mm Length, 0.4mm Pitch | 4 | PCE |  |  | 0134599 | Fastenal | 0134599 | PCE | 0.02 USD/PCE | 0.09 USD
 | > > > > | HD-BT0128 | [HD-BT0128] M3 x 6 Bolt, FHCS Black-Oxide | 4 | PCE |  |  | 40921 | McMaster-Carr | 91294A126 | PCE | 0.04 USD/PCE | 0.16 USD
 | > > > > | HD-MS0033 | [HD-MS0033] GT2, 16 Teeth, timing pulley, AL | 1 | PCE |  |  |  | B & B Manufacturing, Inc | 16-2P06M6CA5 | PCE | 2.90 USD/PCE | 2.90 USD
 | > > > > | HD-MS0058 | [HD-MS0058] Wire Tie, 8" Black, pk 1000 | 6 | PCE |  |  | APU-08-18-0-M | Electronics Distributors Corp. | 17-01125 | pkg, 1000 | 0.01 USD/PCE | 0.08 USD
 | > > > > | HD-MS0277 | [HD-MS0277] Bearing 627 Ball Bearings 627 RS - BLACK | 1 | PCE |  |  |  | JSB Great Bearings | 627-2RS | PCE | 0.65 USD/PCE | 0.65 USD
 | > > > > | HD-MS0351 | [HD-MS0351] Helical Flexible Shaft Coupling with Set Screw - X10835-5mm-5mm - Anodize IAW HPS1000 | 1 | PCE |  | Helical Products Company, Inc. | 30070 | Helical Products Company, Inc. | 30070 | PCE | 6.33 USD/PCE | 6.33 USD
 | > > > > | HD-NT0047 | [HD-NT0047] 10mm x 2mm Flange mount supernut | 1 | PCE |  |  |  | Thomson Ball Screws and Actuators Co., Inc. |  | PCE | 4.81 USD/PCE | 4.81 USD
 | > > > > | HD-RD0035 | [HD-RD0035] 8mm Smooth rod, 315mm, 300 Series Stainless Steel | 1 | PCE |  | Igus, Inc. | EWMR-08-315X | Igus, Inc. | EWMR-08-315X | PCE | 5.26 USD/PCE | 5.26 USD
 | > > > > | HD-RD0037 | [HD-RD0037] Drive Rod 10mm X 2mm Lead OAL 282mm, Machined to Print | 1 | PCE |  | Thomson Linear | SRT10X2M | Thomson Ball Screws and Actuators Co., Inc. |  | PCE | 16.94 USD/PCE | 16.94 USD
 | > > > > | HD-WA0012 | [HD-WA0012] Steel Flat Washer, DIN 125 zinc-plated class 4,M2 screw sz, 5mm OD, .25mm-.35mm thick | 4 | PCE |  |  | 40350 | Fastenal | 40350 | PCE | 0.04 USD/PCE | 0.14 USD
 | > > > > | HD-WA0038 | [HD-WA0038] Black-Oxide 18-8 Steel Flat Washer, M3 Screw Size, 3.2mm ID, 7.0mm OD | 6 | PCE |  |  |  | Fastenal | 11264395 | PCE | 0.02 USD/PCE | 0.10 USD
 | > > > > | HD-WA0040 | [HD-WA0040] Black-Oxide 18-8 Stainless Steel Flat Washer, M5 Screw Size, 5.3mm ID, 10.0mm OD | 3 | PCE |  |  |  | Fastenal | 11264558 | PCE | 0.02 USD/PCE | 0.06 USD
 | > > > | AS-PR0048 | [AS-PR0048] Mini, Z Axis, Right Assembly | 1 | PCE
 | > > > > | AS-PR0050 | [AS-PR0050] Mini, Z upper right v1.2 Assembly | 1 | PCE
 | > > > > > | PP-GP0272 | [PP-GP0272] z-upper-mini-right_black_v2.0 | 1 | PCE
 | > > > > > > | RM-AB0105 | [RM-AB0105] Chroma Strand ABS Filament, Black 2.85mm, 5 lb reel | 27.62 | g |  |  |  | Chroma Strand Labs, LLC |  | Reel, 5lb | 0.02 USD/g | 0.55 USD
 | > > > > > | HD-MS0030 | [HD-MS0030] Metric Brass Heat-Set Insert for Plastics Tapered, M3-.5 Internal Thread, 3.8mm Length | 6 | PCE |  |  |  | Aero-Space Fasteners and Hardware (formerly Colorado Electronic Hardware) | PEM IUBB-M3-1 | PCE | 0.04 USD/PCE | 0.21 USD
 | > > > > | AS-PR0051 | [AS-PR0051] Mini, Z lower right Assembly | 1 | PCE
 | > > > > > | PP-GP0270 | [PP-GP0270] lower-z-right-mini_lulz-green_v1.6 | 1 | PCE
 | > > > > > > | RM-AB0104 | [RM-AB0104] Chroma Strand ABS Filament, Lulzbot Green 2.85mm, 5 lb reel | 56.15 | g |  | Chroma Strand Labs, LLC |  | Chroma Strand Labs, LLC |  | Reel, 5lb | 0.02 USD/g | 1.11 USD
 | > > > > > | HD-MS0030 | [HD-MS0030] Metric Brass Heat-Set Insert for Plastics Tapered, M3-.5 Internal Thread, 3.8mm Length | 5 | PCE |  |  |  | Aero-Space Fasteners and Hardware (formerly Colorado Electronic Hardware) | PEM IUBB-M3-1 | PCE | 0.04 USD/PCE | 0.18 USD
 | > > > > > | HD-MS0277 | [HD-MS0277] Bearing 627 Ball Bearings 627 RS - BLACK | 1 | PCE |  |  |  | JSB Great Bearings | 627-2RS | PCE | 0.65 USD/PCE | 0.65 USD
 | > > > > | AS-PR0052 | [AS-PR0052] Mini, X End Idler Assembly | 1 | PCE
 | > > > > > | AS-PR0054 | [AS-PR0054] Mini, X End Idler Printed Assembly | 1 | PCE
 | > > > > > > | RM-AB0105 | [RM-AB0105] Chroma Strand ABS Filament, Black 2.85mm, 5 lb reel | 114.42 | g |  |  |  | Chroma Strand Labs, LLC |  | Reel, 5lb | 0.02 USD/g | 2.27 USD
 | > > > > > > | HD-BU0013 | [HD-BU0013] DryLin® R - Solid polymer bearing RJM-01, 8mm | 2 | PCE |  |  | RJM-01-08 | Igus, Inc. | RJM-01-08 | PCE | 1.15 USD/PCE | 2.30 USD
 | > > > > > | HD-BT0131 | [HD-BT0131] Black Alloy Steel Flat-Head Socket Cap Screw, Class 10.9, M8 Size, 45mm Length, 1.25mm Pitch | 1 | PCE |  |  | 0154350 | Fastenal | 0154350 | PCE | 0.12 USD/PCE | 0.12 USD
 | > > > > > | HD-MS0030 | [HD-MS0030] Metric Brass Heat-Set Insert for Plastics Tapered, M3-.5 Internal Thread, 3.8mm Length | 2 | PCE |  |  |  | Aero-Space Fasteners and Hardware (formerly Colorado Electronic Hardware) | PEM IUBB-M3-1 | PCE | 0.04 USD/PCE | 0.07 USD
 | > > > > > | HD-MS0158 | [HD-MS0158] Metric Brass Heat-Set Insert For Plastics Tapered, M5-.8 Internal Thread, 6.7mm Length | 3 | PCE |  |  |  | Aero-Space Fasteners and Hardware (formerly Colorado Electronic Hardware) | PEM IUBB-M5-1 | PCE | 0.07 USD/PCE | 0.22 USD
 | > > > > > | HD-MS0282 | [HD-MS0282] 608-2RS ABEC3/C3 Rubber Sealed Bearing - BLACK | 2 | PCE |  | JSB Great Bearings | 608-2RS ABEC3/C3 | JSB Great Bearings | 608-2RS ABEC3/C3 | PCE | 0.42 USD/PCE | 0.84 USD
 | > > > > > | HD-NT0002 | [HD-NT0002] M8 Nyloc Nut, Zinc Plated | 1 | PCE |  |  | 40163 | Fastenal | 40163 | PCE | 0.03 USD/PCE | 0.03 USD
 | > > > > > | HD-WA0006 | [HD-WA0006] M8 Washer, Steel, Zinc Plated | 2 | PCE |  |  |  | Fastenal | 40357 | PCE | 0.04 USD/PCE | 0.08 USD
 | > > > > | EL-MT0029 | [EL-MT0029] NEMA 17 Stepper Motor, Moons' - NOT INCLUDING wire harness | 1 | PCE |  |  | MS17HD6P4150-01-B | Moons' Industries (America), Inc. | MS17HD6P4150-01-B | PCE | 8.30 USD/PCE | 8.30 USD
 | > > > > | EL-MT0032 | [EL-MT0032] Nema 17 Stepper Motor Damper, Flange-less, w/Pilot - Moons' | 1 | PCE |  | Moons' Industries (America), Inc. | 4696325000008 | Moons' Industries (America), Inc. | 4696325000008 | PCE | 2.45 USD/PCE | 2.45 USD
 | > > > > | HD-BT0005 | [HD-BT0005] M3 x 10 Bolt, SHCS Black-oxide | 2 | PCE |  |  |  | Fastenal | 1139504 | PCE | 0.05 USD/PCE | 0.10 USD
 | > > > > | HD-BT0012 | [HD-BT0012] M3 Set Screw (Grub Screw) | 3 | PCE |  |  | 40818 | Fastenal | 40818 | PCE | 0.03 USD/PCE | 0.08 USD
 | > > > > | HD-BT0044 | [HD-BT0044] Metric Class 12.9 Socket Head Cap Screw, Alloy Steel, M3 Thread, 5MM Length, 0.50MM Pitch | 2 | PCE |  |  | 39501 | Fastenal | 39501 | PCE | 0.02 USD/PCE | 0.04 USD
 | > > > > | HD-BT0048 | [HD-BT0048] Metric Class 12.9 Socket Head Cap Screw Alloy Steel, M5 Thread, 10mm Length, 0.80mm Pitch | 3 | PCE |  |  |  | Fastenal | 39544 | PCE | 0.02 USD/PCE | 0.06 USD
 | > > > > | HD-MS0277 | [HD-MS0277] Bearing 627 Ball Bearings 627 RS - BLACK | 1 | PCE |  |  |  | JSB Great Bearings | 627-2RS | PCE | 0.65 USD/PCE | 0.65 USD
 | > > > > | HD-MS0351 | [HD-MS0351] Helical Flexible Shaft Coupling with Set Screw - X10835-5mm-5mm - Anodize IAW HPS1000 | 1 | PCE |  | Helical Products Company, Inc. | 30070 | Helical Products Company, Inc. | 30070 | PCE | 6.33 USD/PCE | 6.33 USD
 | > > > > | HD-NT0047 | [HD-NT0047] 10mm x 2mm Flange mount supernut | 1 | PCE |  |  |  | Thomson Ball Screws and Actuators Co., Inc. |  | PCE | 4.81 USD/PCE | 4.81 USD
 | > > > > | HD-RD0035 | [HD-RD0035] 8mm Smooth rod, 315mm, 300 Series Stainless Steel | 1 | PCE |  | Igus, Inc. | EWMR-08-315X | Igus, Inc. | EWMR-08-315X | PCE | 5.26 USD/PCE | 5.26 USD
 | > > > > | HD-RD0037 | [HD-RD0037] Drive Rod 10mm X 2mm Lead OAL 282mm, Machined to Print | 1 | PCE |  | Thomson Linear | SRT10X2M | Thomson Ball Screws and Actuators Co., Inc. |  | PCE | 16.94 USD/PCE | 16.94 USD
 | > > > > | HD-WA0038 | [HD-WA0038] Black-Oxide 18-8 Steel Flat Washer, M3 Screw Size, 3.2mm ID, 7.0mm OD | 2 | PCE |  |  |  | Fastenal | 11264395 | PCE | 0.02 USD/PCE | 0.03 USD
 | > > > > | HD-WA0040 | [HD-WA0040] Black-Oxide 18-8 Stainless Steel Flat Washer, M5 Screw Size, 5.3mm ID, 10.0mm OD | 3 | PCE |  |  |  | Fastenal | 11264558 | PCE | 0.02 USD/PCE | 0.06 USD
 | > > > | AS-PR0055 | [AS-PR0055] Mini, X Axis, Carriage Assembly | 1 | PCE
 | > > > > | AS-PR0056 | [AS-PR0056] Mini, X Motor Carriage with Bearings Assembly | 1 | PCE
 | > > > > > | RM-AB0105 | [RM-AB0105] Chroma Strand ABS Filament, Black 2.85mm, 5 lb reel | 49.02 | g |  |  |  | Chroma Strand Labs, LLC |  | Reel, 5lb | 0.02 USD/g | 0.97 USD
 | > > > > > | HD-BU0013 | [HD-BU0013] DryLin® R - Solid polymer bearing RJM-01, 8mm | 2 | PCE |  |  | RJM-01-08 | Igus, Inc. | RJM-01-08 | PCE | 1.15 USD/PCE | 2.30 USD
 | > > > > | AS-PR0057 | [AS-PR0057] Mini, Upper Bearing holder Assembly | 1 | PCE
 | > > > > > | AS-PR0058 | [AS-PR0058] Mini, Upper Bearing holder with Bearings Assembly | 1 | PCE
 | > > > > > > | RM-AB0105 | [RM-AB0105] Chroma Strand ABS Filament, Black 2.85mm, 5 lb reel | 37.19 | g |  |  |  | Chroma Strand Labs, LLC |  | Reel, 5lb | 0.02 USD/g | 0.74 USD
 | > > > > > > | HD-BU0013 | [HD-BU0013] DryLin® R - Solid polymer bearing RJM-01, 8mm | 2 | PCE |  |  | RJM-01-08 | Igus, Inc. | RJM-01-08 | PCE | 1.15 USD/PCE | 2.30 USD
 | > > > > > | HD-MS0030 | [HD-MS0030] Metric Brass Heat-Set Insert for Plastics Tapered, M3-.5 Internal Thread, 3.8mm Length | 8 | PCE |  |  |  | Aero-Space Fasteners and Hardware (formerly Colorado Electronic Hardware) | PEM IUBB-M3-1 | PCE | 0.04 USD/PCE | 0.28 USD
 | > > > > | AS-PR0060 | [AS-PR0060] Mini, Printed belt clamp assembly | 1 | PCE
 | > > > > > | PP-GP0278 | [PP-GP0278] belt-mount black v1.2 | 1 | PCE
 | > > > > > > | RM-AB0105 | [RM-AB0105] Chroma Strand ABS Filament, Black 2.85mm, 5 lb reel | 9.4 | g |  |  |  | Chroma Strand Labs, LLC |  | Reel, 5lb | 0.02 USD/g | 0.19 USD
 | > > > > > | HD-MS0030 | [HD-MS0030] Metric Brass Heat-Set Insert for Plastics Tapered, M3-.5 Internal Thread, 3.8mm Length | 5 | PCE |  |  |  | Aero-Space Fasteners and Hardware (formerly Colorado Electronic Hardware) | PEM IUBB-M3-1 | PCE | 0.04 USD/PCE | 0.18 USD
 | > > > > | PP-GP0277 | [PP-GP0277] Belt-clamp Black v1.2 | 1 | PCE
 | > > > > > | RM-AB0105 | [RM-AB0105] Chroma Strand ABS Filament, Black 2.85mm, 5 lb reel | 0.86 | g |  |  |  | Chroma Strand Labs, LLC |  | Reel, 5lb | 0.02 USD/g | 0.02 USD
 | > > > > | HD-BT0039 | [HD-BT0039] Metric Class 12.9 Socket Head Cap Screw, Alloy Steel, M3 Thread, 12MM Length, 0.50MM Pitch | 7 | PCE |  |  | 39505 | Fastenal | 39505 | PCE | 0.03 USD/PCE | 0.20 USD
 | > > > > | HD-BT0039 | [HD-BT0039] Metric Class 12.9 Socket Head Cap Screw, Alloy Steel, M3 Thread, 12MM Length, 0.50MM Pitch | 2 | PCE |  |  | 39505 | Fastenal | 39505 | PCE | 0.03 USD/PCE | 0.06 USD
 | > > > > | HD-WA0038 | [HD-WA0038] Black-Oxide 18-8 Steel Flat Washer, M3 Screw Size, 3.2mm ID, 7.0mm OD | 7 | PCE |  |  |  | Fastenal | 11264395 | PCE | 0.02 USD/PCE | 0.12 USD
 | > > > > | HD-WA0038 | [HD-WA0038] Black-Oxide 18-8 Steel Flat Washer, M3 Screw Size, 3.2mm ID, 7.0mm OD | 2 | PCE |  |  |  | Fastenal | 11264395 | PCE | 0.02 USD/PCE | 0.03 USD
 | > > > | AS-PR0064 | [AS-PR0064] Mini, Final Frame Assembly | 1 | PCE
 | > > > > | AS-PR0065 | [AS-PR0065] Mini, Handle Complete | 1 | PCE
 | > > > > > | PP-GP0259_v2.5 | [PP-GP0259_v2.5] handle-bar_black_v2.5 | 1 | PCE
 | > > > > > > | RM-AB0105 | [RM-AB0105] Chroma Strand ABS Filament, Black 2.85mm, 5 lb reel | 41.44 | g |  |  |  | Chroma Strand Labs, LLC |  | Reel, 5lb | 0.02 USD/g | 0.82 USD
 | > > > > > | HD-MS0030 | [HD-MS0030] Metric Brass Heat-Set Insert for Plastics Tapered, M3-.5 Internal Thread, 3.8mm Length | 3 | PCE |  |  |  | Aero-Space Fasteners and Hardware (formerly Colorado Electronic Hardware) | PEM IUBB-M3-1 | PCE | 0.04 USD/PCE | 0.11 USD
 | > > > > | AS-PR0066 | [AS-PR0066] Mini, Upper Relief Mount Assembly | 1 | PCE
 | > > > > > | PP-GP0266 | [PP-GP0266] strain-relief-upper_black_v3.0 | 1 | PCE
 | > > > > > > | RM-AB0105 | [RM-AB0105] Chroma Strand ABS Filament, Black 2.85mm, 5 lb reel | 14.42 | g |  |  |  | Chroma Strand Labs, LLC |  | Reel, 5lb | 0.02 USD/g | 0.29 USD
 | > > > > > | HD-MS0030 | [HD-MS0030] Metric Brass Heat-Set Insert for Plastics Tapered, M3-.5 Internal Thread, 3.8mm Length | 2 | PCE |  |  |  | Aero-Space Fasteners and Hardware (formerly Colorado Electronic Hardware) | PEM IUBB-M3-1 | PCE | 0.04 USD/PCE | 0.07 USD
 | > > > > | AS-PR0067 | [AS-PR0067] Mini, Y Axis Assembly | 1 | PCE
 | > > > > > | AS-PR0023 | [AS-PR0023] 90mm Cut wiper pad | 1 | PCE, 90mm
 | > > > > > > | PP-FP0087 | [PP-FP0087] LulzBot Wiper Pads | 90 | mm |  |  |  | eNTWORKS Ltd. |  | ft, 25 | 0.01 USD/mm | 0.63 USD
 | > > > > > > | SR-MN0007 | [SR-MN0007] Service for Cutting Wiper Pad AS-PR0023 | 1 | PCE |  |  |  | CCX Corp. | WIPERKIT | PCE | 0.01 USD/PCE | 0.01 USD
 | > > > > > | AS-PR0060 | [AS-PR0060] Mini, Printed belt clamp assembly | 1 | PCE
 | > > > > > > | PP-GP0278 | [PP-GP0278] belt-mount black v1.2 | 1 | PCE
 | > > > > > > > | RM-AB0105 | [RM-AB0105] Chroma Strand ABS Filament, Black 2.85mm, 5 lb reel | 9.4 | g |  |  |  | Chroma Strand Labs, LLC |  | Reel, 5lb | 0.02 USD/g | 0.19 USD
 | > > > > > > | HD-MS0030 | [HD-MS0030] Metric Brass Heat-Set Insert for Plastics Tapered, M3-.5 Internal Thread, 3.8mm Length | 5 | PCE |  |  |  | Aero-Space Fasteners and Hardware (formerly Colorado Electronic Hardware) | PEM IUBB-M3-1 | PCE | 0.04 USD/PCE | 0.18 USD
 | > > > > > | AS-PR0069 | [AS-PR0069] Mini 2, Y Axis Mount Idler Insert Assembly | 1 | PCE
 | > > > > > > | PP-GP0264 | [PP-GP0264] y-idler-mini_black_v1.4 | 1 | PCE
 | > > > > > > > | RM-AB0105 | [RM-AB0105] Chroma Strand ABS Filament, Black 2.85mm, 5 lb reel | 27.44 | g |  |  |  | Chroma Strand Labs, LLC |  | Reel, 5lb | 0.02 USD/g | 0.54 USD
 | > > > > > > | HD-BT0117 | [HD-BT0117] Black Alloy Steel Flat-Head Socket Cap Screw, Class 10.9, M8 Size, 40mm Length, 1.25mm Pitch | 1 | PCE |  |  | 1139965 | Fastenal | 1139965 | PCE | 0.14 USD/PCE | 0.14 USD
 | > > > > > > | HD-MS0030 | [HD-MS0030] Metric Brass Heat-Set Insert for Plastics Tapered, M3-.5 Internal Thread, 3.8mm Length | 4 | PCE |  |  |  | Aero-Space Fasteners and Hardware (formerly Colorado Electronic Hardware) | PEM IUBB-M3-1 | PCE | 0.04 USD/PCE | 0.14 USD
 | > > > > > > | HD-MS0282 | [HD-MS0282] 608-2RS ABEC3/C3 Rubber Sealed Bearing - BLACK | 2 | PCE |  | JSB Great Bearings | 608-2RS ABEC3/C3 | JSB Great Bearings | 608-2RS ABEC3/C3 | PCE | 0.42 USD/PCE | 0.84 USD
 | > > > > > > | HD-NT0002 | [HD-NT0002] M8 Nyloc Nut, Zinc Plated | 1 | PCE |  |  | 40163 | Fastenal | 40163 | PCE | 0.03 USD/PCE | 0.03 USD
 | > > > > > > | HD-WA0006 | [HD-WA0006] M8 Washer, Steel, Zinc Plated | 3 | PCE |  |  |  | Fastenal | 40357 | PCE | 0.04 USD/PCE | 0.12 USD
 | > > > > > | AS-PR0070 | [AS-PR0070] Mini, Y Axis Rod Mount, Motor Side Assembly | 1 | PCE
 | > > > > > > | PP-GP0263 | [PP-GP0263] y-motor-mount_black_v1.4 | 1 | PCE
 | > > > > > > > | RM-AB0105 | [RM-AB0105] Chroma Strand ABS Filament, Black 2.85mm, 5 lb reel | 27.14 | g |  |  |  | Chroma Strand Labs, LLC |  | Reel, 5lb | 0.02 USD/g | 0.54 USD
 | > > > > > > | HD-MS0030 | [HD-MS0030] Metric Brass Heat-Set Insert for Plastics Tapered, M3-.5 Internal Thread, 3.8mm Length | 4 | PCE |  |  |  | Aero-Space Fasteners and Hardware (formerly Colorado Electronic Hardware) | PEM IUBB-M3-1 | PCE | 0.04 USD/PCE | 0.14 USD
 | > > > > > | AS-PR0073 | [AS-PR0073] Mini, Double Bearing Holder, Switchside Insert Assembly | 1 | PCE
 | > > > > > > | AS-PR0074 | [AS-PR0074] Mini, Double Bearing Holder Assembly | 1 | PCE
 | > > > > > > > | RM-AB0105 | [RM-AB0105] Chroma Strand ABS Filament, Black 2.85mm, 5 lb reel | 24.98 | g |  |  |  | Chroma Strand Labs, LLC |  | Reel, 5lb | 0.02 USD/g | 0.50 USD
 | > > > > > > > | HD-BU0013 | [HD-BU0013] DryLin® R - Solid polymer bearing RJM-01, 8mm | 2 | PCE |  |  | RJM-01-08 | Igus, Inc. | RJM-01-08 | PCE | 1.15 USD/PCE | 2.30 USD
 | > > > > > > | HD-MS0030 | [HD-MS0030] Metric Brass Heat-Set Insert for Plastics Tapered, M3-.5 Internal Thread, 3.8mm Length | 4 | PCE |  |  |  | Aero-Space Fasteners and Hardware (formerly Colorado Electronic Hardware) | PEM IUBB-M3-1 | PCE | 0.04 USD/PCE | 0.14 USD
 | > > > > > > | PP-MP0066 | [PP-MP0066] Metric Brass Heat-Set Insert for Plastics, Tapered, M2-.4 Internal Thread, 2.9MM Length | 4 | PCE |  |  |  | Aero-Space Fasteners and Hardware (formerly Colorado Electronic Hardware) | PEM ZZIUB-48213 | PCE | 0.05 USD/PCE | 0.20 USD
 | > > > > > | AS-PR0075 | [AS-PR0075] Mini, Double Bearing Holder, Non-switchside Insert Assembly | 1 | PCE
 | > > > > > > | AS-PR0074 | [AS-PR0074] Mini, Double Bearing Holder Assembly | 1 | PCE
 | > > > > > > > | RM-AB0105 | [RM-AB0105] Chroma Strand ABS Filament, Black 2.85mm, 5 lb reel | 24.98 | g |  |  |  | Chroma Strand Labs, LLC |  | Reel, 5lb | 0.02 USD/g | 0.50 USD
 | > > > > > > > | HD-BU0013 | [HD-BU0013] DryLin® R - Solid polymer bearing RJM-01, 8mm | 2 | PCE |  |  | RJM-01-08 | Igus, Inc. | RJM-01-08 | PCE | 1.15 USD/PCE | 2.30 USD
 | > > > > > > | HD-MS0030 | [HD-MS0030] Metric Brass Heat-Set Insert for Plastics Tapered, M3-.5 Internal Thread, 3.8mm Length | 4 | PCE |  |  |  | Aero-Space Fasteners and Hardware (formerly Colorado Electronic Hardware) | PEM IUBB-M3-1 | PCE | 0.04 USD/PCE | 0.14 USD
 | > > > > > | PP-FP0138 | [PP-FP0138] Silk Screened Bed Mount Plate, Mini | 1 | PCE |  |  |  | Rapid Sheet Metal |  | PCE | 21.74 USD/PCE | 21.74 USD
 | > > > > > | PP-GP0231 | [PP-GP0231] Wiper Mount, v1.1 | 1 | PCE
 | > > > > > > | RM-AB0105 | [RM-AB0105] Chroma Strand ABS Filament, Black 2.85mm, 5 lb reel | 12.35 | g |  |  |  | Chroma Strand Labs, LLC |  | Reel, 5lb | 0.02 USD/g | 0.25 USD
 | > > > > > | PP-GP0248 | [PP-GP0248] bed corners, mini v2.5 | 4 | PCE
 | > > > > > > | RM-TE0002 | [RM-TE0002] Midnight NinjaFlex™ TPE Filament, 3mm, 0.75kg Fenner Drives | 1.94 | g |  | Fenner Drives | 3D3011290 Midnight | Fenner Drives | 3D3011290A | Reel, 0.75kg | 0.05 USD/g | 0.09 USD
 | > > > > > | PP-GP0277 | [PP-GP0277] Belt-clamp Black v1.2 | 1 | PCE
 | > > > > > > | RM-AB0105 | [RM-AB0105] Chroma Strand ABS Filament, Black 2.85mm, 5 lb reel | 0.86 | g |  |  |  | Chroma Strand Labs, LLC |  | Reel, 5lb | 0.02 USD/g | 0.02 USD
 | > > > > > | EL-SW0022 | [EL-SW0022] SWITCH BASIC SPDT 3A .110QC 125V | 2 | PCE |  |  | SS-3GPT | TTI Global Distribution | SS-3GPT | PCE | 0.42 USD/PCE | 0.84 USD
 | > > > > > | HD-BT0039 | [HD-BT0039] Metric Class 12.9 Socket Head Cap Screw, Alloy Steel, M3 Thread, 12MM Length, 0.50MM Pitch | 2 | PCE |  |  | 39505 | Fastenal | 39505 | PCE | 0.03 USD/PCE | 0.06 USD
 | > > > > > | HD-BT0104 | [HD-BT0104] M3 x 8 Bolt, BHCS, SST | 1 | PCE |  |  | MB2510008A20000 | Fastenal | MB2510008A20000 | PCE | 0.10 USD/PCE | 0.10 USD
 | > > > > > | HD-BT0107 | [HD-BT0107] Metric Class 12.9 Socket Head Cap Screw Alloy Steel, Black, M2 Thread, 10mm Length, 0.4mm Pitch | 4 | PCE |  |  | 0134599 | Fastenal | 0134599 | PCE | 0.02 USD/PCE | 0.09 USD
 | > > > > > | HD-BT0128 | [HD-BT0128] M3 x 6 Bolt, FHCS Black-Oxide | 2 | PCE |  |  | 40921 | McMaster-Carr | 91294A126 | PCE | 0.04 USD/PCE | 0.08 USD
 | > > > > > | HD-BT0137 | [HD-BT0137] M3 x 8 Bolt, BHCS, Black-Oxide | 19 | PCE |  |  | 40868 | Fastenal | 40868 | PCE | 0.04 USD/PCE | 0.67 USD
 | > > > > > | HD-NT0001 | [HD-NT0001] Metric Zinc-Plated Steel Nylon-Insert Locknut, Class 8, M3 Screw sz, .5MM pitch, 5.5MM W, 4MM H | 2 | PCE |  |  | 40143 | Fastenal | 40143 | PCE | 0.01 USD/PCE | 0.02 USD
 | > > > > > | HD-RD0035 | [HD-RD0035] 8mm Smooth rod, 315mm, 300 Series Stainless Steel | 2 | PCE |  | Igus, Inc. | EWMR-08-315X | Igus, Inc. | EWMR-08-315X | PCE | 5.26 USD/PCE | 10.52 USD
 | > > > > > | HD-WA0012 | [HD-WA0012] Steel Flat Washer, DIN 125 zinc-plated class 4,M2 screw sz, 5mm OD, .25mm-.35mm thick | 4 | PCE |  |  | 40350 | Fastenal | 40350 | PCE | 0.04 USD/PCE | 0.14 USD
 | > > > > > | HD-WA0038 | [HD-WA0038] Black-Oxide 18-8 Steel Flat Washer, M3 Screw Size, 3.2mm ID, 7.0mm OD | 2 | PCE |  |  |  | Fastenal | 11264395 | PCE | 0.02 USD/PCE | 0.03 USD
 | > > > > > | HD-WA0038 | [HD-WA0038] Black-Oxide 18-8 Steel Flat Washer, M3 Screw Size, 3.2mm ID, 7.0mm OD | 21 | PCE |  |  |  | Fastenal | 11264395 | PCE | 0.02 USD/PCE | 0.35 USD
 | > > > > | EL-HR0114 | [EL-HR0114] Mini Bed Harness Completed Assembly - Gladiola | 1 | PCE
 | > > > > > | EL-HR0115 | [EL-HR0115] Mini YZ Motor Harness Assembly - Gladiola | 1 | PCE |  | Aleph Objects Inc.
 | > > > > > > | EL-MS0059 | [EL-MS0059] Molex-CONN TERM FEMALE 22-24AWG TIN Reels of 20K | 12 | PCE |  | Molex | 16-02-0086 | TTI Global Distribution | 16-02-0086 | PCE | 0.01 USD/PCE | 0.17 USD
 | > > > > > > | EL-MS0141 | [EL-MS0141] Term Ring Non Ins 26-22AWG #4 Order Bulk Only | 5 | PCE |  | Panduit | P22-4R-M | TTI Global Distribution | P22-4R-M | PCE | 0.06 USD/PCE | 0.30 USD
 | > > > > > > | EL-MS0351 | [EL-MS0351] JST - CONN TERM CRIMP PH 24-30AWG - 8,000 Unit Reel | 12 | PCE |  | JST Sales America | SPH-002T-P0.5S | Future Electronics |  | PCE | 0.01 USD/PCE | 0.15 USD
 | > > > > > > | EL-MS0355 | [EL-MS0355] CONN HOUSING PH 6POS 2MM WHITE | 3 | PCE |  | JST Sales America | PHR-6 | Future Electronics | PHR-6 | PCE | 0.04 USD/PCE | 0.12 USD
 | > > > > > > | EL-MS0431 | [EL-MS0431] Fork Terminal, non-insulated, 26 – 22 AWG, #4 stud size | 1 | PCE |  | Panduit | P22-4F-C | Fastenal | P22-4F-C | PCE | 0.39 USD/PCE | 0.39 USD
 | > > > > > > | EL-WR0099 | [EL-WR0099] Shielded 22AWG UL2464 4 COND | 1700 | mm |  |  |  | Allcable | C0762A.41.10 | ft, 1000 | 0.00 USD/mm | 1.72 USD
 | > > > > > > | HD-TB0066 | [HD-TB0066] Flexible Polyolefin Heat Shrink Tubing 1/8" ID Before, 1/16" ID After, 100' L, Black | 535 | mm |  |  |  | Electronics Distributors Corp. | 88-01250 | PCE, 100' | 0.00 USD/mm | 0.33 USD
 | > > > > > | EL-HR0102 | [EL-HR0102] Mini Bed Harness Assembly - revG | 1 | PCE |  | Igus, Inc. |  | Igus, Inc. |  | PCE | 29.58 USD/PCE | 29.58 USD
 | > > > > > | EL-MS0062 | [EL-MS0062] MOLEX-CONN HOUSING 4POS .100 W/LATCH | 3 | PCE |  |  | 050579404 | Sager Electronics | 050579404 | PCE | 0.05 USD/PCE | 0.16 USD
 | > > > > > | EL-MS0073 | [EL-MS0073] Tubing Corrugated Loom .25", Black, 3200' Box | 910 | mm |  |  | 88-00011 | Electronics Distributors Corp. | 88-00011 | ft, 100 | 0.00 USD/mm | 0.21 USD
 | > > > > > | EL-MS0247 | [EL-MS0247] Heat Shrink Tubing – 0.19-0.09 – Black, 100' | 25 | mm |  | 3M | 88-01870 | Electronics Distributors Corp. | 88-01870 | PCE, 100' | 0.00 USD/mm | 0.02 USD
 | > > > > > | EL-MS0259 | [EL-MS0259] Heat Shrink DL WL Q53X 3/4" | 70 | mm |  | Qualtek | Q5-3X-3/4-01-QB48IN-5 | Electronics Distributors Corp. | 67-30751 | PCE ft, 4 | 0.00 USD/mm | 0.32 USD
 | > > > > > | EL-MS0343 | [EL-MS0343] Ferrite Tubular Bead 10.16MM | 1 | PCE |  | Laird Technologies | 28B0735-000 | Sager Electronics | 28B0735-000 | PCE | 0.26 USD/PCE | 0.26 USD
 | > > > > > | EL-MS0434 | [EL-MS0434] Heat Shrink Tubing – 0.19-0.09 – Red, 100' | 25 | mm |  |  |  | Electronics Distributors Corp. | 99-01872 | PCE, 100' | 0.00 USD/mm | 0.02 USD
 | > > > > > | PC-CN0001 | [PC-CN0001] Molex-Conn Housing 2POS .100 W/Latch | 1 | PCE |  | Molex | 050579402 | Sager Electronics | 050579402 | PCE | 0.06 USD/PCE | 0.06 USD
 | > > > > > | PC-CN0003 | [PC-CN0003] Molex - CONN HOUSING 3POS .100 W/LATCH | 3 | PCE |  | Molex | 50-57-9403 | TTI Global Distribution | 0050579403 | PCE | 0.06 USD/PCE | 0.18 USD
 | > > > > > | PC-CN0032 | [PC-CN0032] Term Block Plug 2POS STR 5.08MM | 1 | PCE |  | Molex | 0395300002 | TTI Global Distribution | 0395300002 | PCE | 0.41 USD/PCE | 0.41 USD
 | > > > > | PP-GP0265 | [PP-GP0265] strain-relief-lower_black_1.2 | 1 | PCE
 | > > > > > | RM-AB0105 | [RM-AB0105] Chroma Strand ABS Filament, Black 2.85mm, 5 lb reel | 2.72 | g |  |  |  | Chroma Strand Labs, LLC |  | Reel, 5lb | 0.02 USD/g | 0.05 USD
 | > > > > | EL-MT0029 | [EL-MT0029] NEMA 17 Stepper Motor, Moons' - NOT INCLUDING wire harness | 1 | PCE |  |  | MS17HD6P4150-01-B | Moons' Industries (America), Inc. | MS17HD6P4150-01-B | PCE | 8.30 USD/PCE | 8.30 USD
 | > > > > | EL-MT0032 | [EL-MT0032] Nema 17 Stepper Motor Damper, Flange-less, w/Pilot - Moons' | 1 | PCE |  | Moons' Industries (America), Inc. | 4696325000008 | Moons' Industries (America), Inc. | 4696325000008 | PCE | 2.45 USD/PCE | 2.45 USD
 | > > > > | HD-BT0085 | [HD-BT0085] 18-8 Stainless Steel Button-Head Socket Cap Screw, M3 Size, 5 mm Length, .5 mm Pitch | 1 | PCE |  |  |  | Fastenal | 11511411 | PCE | 0.03 USD/PCE | 0.03 USD
 | > > > > | HD-BT0104 | [HD-BT0104] M3 x 8 Bolt, BHCS, SST | 4 | PCE |  |  | MB2510008A20000 | Fastenal | MB2510008A20000 | PCE | 0.10 USD/PCE | 0.39 USD
 | > > > > | HD-BT0128 | [HD-BT0128] M3 x 6 Bolt, FHCS Black-Oxide | 37 | PCE |  |  | 40921 | McMaster-Carr | 91294A126 | PCE | 0.04 USD/PCE | 1.52 USD
 | > > > > | HD-BT0137 | [HD-BT0137] M3 x 8 Bolt, BHCS, Black-Oxide | 13 | PCE |  |  | 40868 | Fastenal | 40868 | PCE | 0.04 USD/PCE | 0.46 USD
 | > > > > | HD-BT0140 | [HD-BT0140] M3 x 6 Bolt, BHCS Black-Oxide | 4 | PCE |  |  | 408674 | Fastenal | 40867 | PCE | 0.18 USD/PCE | 0.74 USD
 | > > > > | HD-MS0033 | [HD-MS0033] GT2, 16 Teeth, timing pulley, AL | 1 | PCE |  |  |  | B & B Manufacturing, Inc | 16-2P06M6CA5 | PCE | 2.90 USD/PCE | 2.90 USD
 | > > > > | HD-MS0054 | [HD-MS0054] Bumper Square, rubber | 4 | PCE |  |  |  | Aero-Space Fasteners and Hardware (formerly Colorado Electronic Hardware) | BS-19Black | PCE | 0.09 USD/PCE | 0.37 USD
 | > > > > | HD-MS0058 | [HD-MS0058] Wire Tie, 8" Black, pk 1000 | 2 | PCE |  |  | APU-08-18-0-M | Electronics Distributors Corp. | 17-01125 | pkg, 1000 | 0.01 USD/PCE | 0.03 USD
 | > > > > | HD-NT0001 | [HD-NT0001] Metric Zinc-Plated Steel Nylon-Insert Locknut, Class 8, M3 Screw sz, .5MM pitch, 5.5MM W, 4MM H | 1 | PCE |  |  | 40143 | Fastenal | 40143 | PCE | 0.01 USD/PCE | 0.01 USD
 | > > > > | HD-WA0035 | [HD-WA0035] Metric 18-8 Stainless Steel External Serrated Lock Washer, M3 Screw Size, 6mm OD, 0.4mm min Thick | 4 | PCE |  |  | 11511313 | Fastenal | 11511313 | PCE | 0.02 USD/PCE | 0.08 USD
 | > > > > | HD-WA0038 | [HD-WA0038] Black-Oxide 18-8 Steel Flat Washer, M3 Screw Size, 3.2mm ID, 7.0mm OD | 15 | PCE |  |  |  | Fastenal | 11264395 | PCE | 0.02 USD/PCE | 0.25 USD
 | > > > > | PP-FP0051 | [PP-FP0051] Top-Plate-Mini_PP-FP0051 | 1 | PCE |  |  |  | Weiser Engineering, Inc. |  | PCE | 19.87 USD/PCE | 19.87 USD
 | > > > > | PP-FP0052 | [PP-FP0052] Right-Side-Mini_PP-FP0052 | 1 | PCE |  |  |  | Weiser Engineering, Inc. |  | PCE | 11.98 USD/PCE | 11.98 USD
 | > > > > | PP-FP0055 | [PP-FP0055] Left-Side-Mini_PP-FP0055 | 1 | PCE |  |  |  | Weiser Engineering, Inc. |  | PCE | 18.52 USD/PCE | 18.52 USD
 | > > > > | PP-MP0149 | [PP-MP0149] Bottom-Plate-Mini_PP-MP0149 | 1 | PCE |  |  |  | Weiser Engineering, Inc. |  | PCE | 29.93 USD/PCE | 29.93 USD
 | > > > | AS-PR0078 | [AS-PR0078] Mini, Electrical Cover Assembly | 1 | PCE
 | > > > > | EL-HR0068 | [EL-HR0068] Mini Plug to Ground Post Extension | 1 | PCE
 | > > > > > | EL-MS0143 | [EL-MS0143] Conn Fast Receptacle14-16 AWG .250 - REEL of 2200 Units | 1 | PCE |  |  | 3-350819-2 | TTI Global Distribution | 3-350820-2 | PCE | 0.07 USD/PCE | 0.07 USD
 | > > > > > | EL-MS0246 | [EL-MS0246] Conn Ring 16-22 AWG #4 Red PIDG - Reel 5000 | 1 | PCE |  |  | 2-323758-1 | TTI Global Distribution | 2-323758-1 | PCE | 0.41 USD/PCE | 0.41 USD
 | > > > > > | EL-WR0124 | [EL-WR0124] 16AWG Stranded – Green w/ yellow stripe | 80 | mm |  |  |  | Allcable | HU15691626GN | ft, 1000 | 0.00 USD/mm | 0.03 USD
 | > > > > | EL-HR0069 | [EL-HR0069] Mini PS to Ground Post Extension | 1 | PCE
 | > > > > > | EL-MS0211 | [EL-MS0211] TE- REEL / RING TONGUE CONN 16-22 AWG #10 PIDG | 1 | PCE |  |  |  | Sager Electronics | 2-36154-2 | PCE | 0.09 USD/PCE | 0.09 USD
 | > > > > > | EL-MS0246 | [EL-MS0246] Conn Ring 16-22 AWG #4 Red PIDG - Reel 5000 | 1 | PCE |  |  | 2-323758-1 | TTI Global Distribution | 2-323758-1 | PCE | 0.41 USD/PCE | 0.41 USD
 | > > > > > | EL-WR0124 | [EL-WR0124] 16AWG Stranded – Green w/ yellow stripe | 50 | mm |  |  |  | Allcable | HU15691626GN | ft, 1000 | 0.00 USD/mm | 0.02 USD
 | > > > > | EL-HR0104 | [EL-HR0104] Mini Plug to SW Extension Harness Assembly - Gladiola | 1 | PCE
 | > > > > > | EL-MS0143 | [EL-MS0143] Conn Fast Receptacle14-16 AWG .250 - REEL of 2200 Units | 4 | PCE |  |  | 3-350819-2 | TTI Global Distribution | 3-350820-2 | PCE | 0.07 USD/PCE | 0.28 USD
 | > > > > > | EL-MS0216 | [EL-MS0216] Steward-Ferrite Tubular Bead 19.00mm | 1 | PCE |  |  |  | Sager Electronics | 28B1142-100 | PCE | 0.30 USD/PCE | 0.30 USD
 | > > > > > | EL-WR0121 | [EL-WR0121] 16AWG Stranded Wire – Black | 560 | mm |  |  |  | Allcable | HU15691626BK | ft, 1000 | 0.00 USD/mm | 0.16 USD
 | > > > > > | EL-WR0123 | [EL-WR0123] 16AWG Stranded Wire – White | 560 | mm |  |  |  | Allcable | HU15691626WE | ft, 1000 | 0.00 USD/mm | 0.16 USD
 | > > > > > | HD-MS0058 | [HD-MS0058] Wire Tie, 8" Black, pk 1000 | 2 | PCE |  |  | APU-08-18-0-M | Electronics Distributors Corp. | 17-01125 | pkg, 1000 | 0.01 USD/PCE | 0.03 USD
 | > > > > | EL-HR0106 | [EL-HR0106] Mini PS to RAMBo Harness Assembly - Gladiola | 1 | PCE
 | > > > > > | EL-MS0211 | [EL-MS0211] TE- REEL / RING TONGUE CONN 16-22 AWG #10 PIDG | 4 | PCE |  |  |  | Sager Electronics | 2-36154-2 | PCE | 0.09 USD/PCE | 0.34 USD
 | > > > > > | EL-MS0361 | [EL-MS0361] 16 AWG 6.0mm Pin Length Power Phase Black Single Wire - Insulated Ferrule | 4 | PCE |  | Panduit | FSD78-6-D | TTI Global Distribution | FSD78-6-D | PCE | 0.17 USD/PCE | 0.67 USD
 | > > > > > | EL-WR0106 | [EL-WR0106] 16AWG Stranded – Red | 400 | mm |  |  |  | Allcable | HU15691626RD | ft, 1000 | 0.00 USD/mm | 0.12 USD
 | > > > > > | EL-WR0121 | [EL-WR0121] 16AWG Stranded Wire – Black | 400 | mm |  |  |  | Allcable | HU15691626BK | ft, 1000 | 0.00 USD/mm | 0.12 USD
 | > > > > > | PC-CN0046 | [PC-CN0046] Term Block Plug 4POS STR 5.08MM | 1 | PCE |  |  | 0395300004 | TTI Global Distribution |  | PCE | 0.88 USD/PCE | 0.88 USD
 | > > > > | EL-HR0107 | [EL-HR0107] Mini SW to PS - Black Wire Extension Harness Assembly - Gladiola | 1 | PCE
 | > > > > > | EL-MS0143 | [EL-MS0143] Conn Fast Receptacle14-16 AWG .250 - REEL of 2200 Units | 1 | PCE |  |  | 3-350819-2 | TTI Global Distribution | 3-350820-2 | PCE | 0.07 USD/PCE | 0.07 USD
 | > > > > > | EL-MS0211 | [EL-MS0211] TE- REEL / RING TONGUE CONN 16-22 AWG #10 PIDG | 1 | PCE |  |  |  | Sager Electronics | 2-36154-2 | PCE | 0.09 USD/PCE | 0.09 USD
 | > > > > > | EL-WR0121 | [EL-WR0121] 16AWG Stranded Wire – Black | 260 | mm |  |  |  | Allcable | HU15691626BK | ft, 1000 | 0.00 USD/mm | 0.08 USD
 | > > > > | EL-HR0117 | [EL-HR0117] Earth Ground Extension Wire Harness | 1 | PCE
 | > > > > > | EL-MS0141 | [EL-MS0141] Term Ring Non Ins 26-22AWG #4 Order Bulk Only | 2 | PCE |  | Panduit | P22-4R-M | TTI Global Distribution | P22-4R-M | PCE | 0.06 USD/PCE | 0.12 USD
 | > > > > > | EL-MS0205 | [EL-MS0205] Molex-CONN TERM MALE 22-24AWG TIN - Reels of 20K | 2 | PCE |  | Molex | 16-02-0107 | TTI Global Distribution | 16-02-0107 | PCE | 0.02 USD/PCE | 0.04 USD
 | > > > > > | EL-WR0119 | [EL-WR0119] 24AWG Stranded Wire – Green | 200 | mm |  |  |  | Allcable | HU1569247GN | ft, 1000 | 0.00 USD/mm | 0.02 USD
 | > > > > > | PP-MP0059 | [PP-MP0059] CONN HOUSING MALE 2POS .100 | 1 | PCE |  |  |  | TTI Global Distribution | 0701070001 | PCE | 0.12 USD/PCE | 0.12 USD
 | > > > > | EL-HR0127 | [EL-HR0127] Mini SW to PS - White Wire Extension Harness Assembly – Gladiola | 1 | PCE
 | > > > > > | EL-MS0143 | [EL-MS0143] Conn Fast Receptacle14-16 AWG .250 - REEL of 2200 Units | 1 | PCE |  |  | 3-350819-2 | TTI Global Distribution | 3-350820-2 | PCE | 0.07 USD/PCE | 0.07 USD
 | > > > > > | EL-MS0211 | [EL-MS0211] TE- REEL / RING TONGUE CONN 16-22 AWG #10 PIDG | 1 | PCE |  |  |  | Sager Electronics | 2-36154-2 | PCE | 0.09 USD/PCE | 0.09 USD
 | > > > > > | EL-WR0123 | [EL-WR0123] 16AWG Stranded Wire – White | 260 | mm |  |  |  | Allcable | HU15691626WE | ft, 1000 | 0.00 USD/mm | 0.08 USD
 | > > > > | EL-HR0128 | [EL-HR0128] Mini Case Fan Harness RevA | 1 | PCE |  | Yageo | CC1206JKX7R7BB105 | Mouser Electronics | 603-CC126JKX7R7BB105 | PCE | 0.04 USD/PCE | 0.04 USD
 | > > > > > | EL-FA0045 | [EL-FA0045] Pelonis FAN 80x80x15 High flow | 1 | PCE |  | Pelonis Technologies, Inc. | C8015H24BPLP1b-7 | Pelonis Technologies, Inc. | C8015H24BPLP1b-7 | PCE | 3.88 USD/PCE | 3.88 USD
 | > > > > > | EL-MS0059 | [EL-MS0059] Molex-CONN TERM FEMALE 22-24AWG TIN Reels of 20K | 2 | PCE |  | Molex | 16-02-0086 | TTI Global Distribution | 16-02-0086 | PCE | 0.01 USD/PCE | 0.03 USD
 | > > > > > | PC-CN0001 | [PC-CN0001] Molex-Conn Housing 2POS .100 W/Latch | 1 | PCE |  | Molex | 050579402 | Sager Electronics | 050579402 | PCE | 0.06 USD/PCE | 0.06 USD
 | > > > > | PP-FP0139 | [PP-FP0139] Silk Screened Electronics Case, Mini | 1 | PCE |  |  |  | Weiser Engineering, Inc. |  | PCE | 42.32 USD/PCE | 42.32 USD
 | > > > > | EL-HR0109 | [EL-HR0109] Finger Guard 80mm Plastic | 1 | PCE |  | Qualtek | 09080-G | Digi-Key Corp | CR282-ND | PCE | 0.30 USD/PCE | 0.30 USD
 | > > > > | EL-PS0025 | [EL-PS0025] DELTA POWER SUP 150W 24V 6.25A PNL MT | 1 | PCE |  | Delta Electronics (Americas) Ltd. | PMC-24V150W1AA | Delta Electronics (Americas) Ltd. | PMC-24V150W1AA | PCE | 20.65 USD/PCE | 20.65 USD
 | > > > > | EL-MS0414 | [EL-MS0414] Cartridge Fuse 250V 3.15A Slo-Blo | 2 | PCE |  | Littelfuse | 02153.15MXP | TTI Global Distribution | 576-02153.15MXP | PCE | 0.39 USD/PCE | 0.77 USD
 | > > > > | EL-MS0432 | [EL-MS0432] Clip-On EMI Shielding Gasket 150.876mm length | 1 | PCE |  | TECH-ETCH, Inc. | 187RF1C100-5.94-L-08 | Tech Etch AP | 187RF1C100-5.94-L-08 | PCE | 2.36 USD/PCE | 2.36 USD
 |  |  |  |  |  |  |  |  | TECH-ETCH, Inc. |  | PCE | 2.36 USD/PCE | 2.36 USD
 | > > > > | EL-SW0023 | [EL-SW0023] SWITCH ROCKER DPST 20A 250V, Illuminated Red | 1 | PCE |  |  | R5BBLKREDFF2 | Heilind | R5BBLKREDFF2 | PCE | 1.27 USD/PCE | 1.27 USD
 | > > > > | HD-BT0128 | [HD-BT0128] M3 x 6 Bolt, FHCS Black-Oxide | 4 | PCE |  |  | 40921 | McMaster-Carr | 91294A126 | PCE | 0.04 USD/PCE | 0.16 USD
 | > > > > | HD-BT0130 | [HD-BT0130] M3 x 8 Bolt, FHCS Black-Oxide | 2 | PCE |  |  |  | Fastenal | 40922 | PCE | 0.03 USD/PCE | 0.06 USD
 | > > > > | HD-BT0135 | [HD-BT0135] M3 x 25 Bolt FHCS, Black-Oxide, Partially Threaded | 4 | PCE |  |  | 40929 | Fastenal | 40929 | PCE | 0.03 USD/PCE | 0.14 USD
 | > > > > | HD-MS0058 | [HD-MS0058] Wire Tie, 8" Black, pk 1000 | 2 | PCE |  |  | APU-08-18-0-M | Electronics Distributors Corp. | 17-01125 | pkg, 1000 | 0.01 USD/PCE | 0.03 USD
 | > > > > | HD-MS0249 | [HD-MS0249] UV-Resistant Cable Tie Holder, Adhesive Back/Screw Mount, 4-Way, for.18" Maximum Tie, Black | 2 | PCE |  |  |  | Electronics Distributors Corp. | 56-07035 | pkg, 500 | 0.26 USD/PCE | 0.52 USD
 | > > > > | HD-NT0001 | [HD-NT0001] Metric Zinc-Plated Steel Nylon-Insert Locknut, Class 8, M3 Screw sz, .5MM pitch, 5.5MM W, 4MM H | 5 | PCE |  |  | 40143 | Fastenal | 40143 | PCE | 0.01 USD/PCE | 0.06 USD
 | > > > > | HD-WA0035 | [HD-WA0035] Metric 18-8 Stainless Steel External Serrated Lock Washer, M3 Screw Size, 6mm OD, 0.4mm min Thick | 1 | PCE |  |  | 11511313 | Fastenal | 11511313 | PCE | 0.02 USD/PCE | 0.02 USD
 | > > > > | HD-WA0038 | [HD-WA0038] Black-Oxide 18-8 Steel Flat Washer, M3 Screw Size, 3.2mm ID, 7.0mm OD | 4 | PCE |  |  |  | Fastenal | 11264395 | PCE | 0.02 USD/PCE | 0.07 USD
 | > > > > | PP-MP0028 | [PP-MP0028] Bulgin-AC Power Entry Modules SC MT FUSED .25" TAB | 1 | PCE |  |  | PF0030/63 | Heilind Electronics | PF0030/63 | PCE | 3.10 USD/PCE | 3.10 USD
 | > > > | AS-PR0107 | [AS-PR0107] Mini Spool Arm Assembly, v2 | 1 | PCE
 | > > > > | PP-IS0044 | [PP-IS0044] Spool mount A with inserts | 1 | PCE
 | > > > > > | PP-GP0319 | [PP-GP0319] Spool Mount A | 1 | PCE
 | > > > > > > | RM-AB0105 | [RM-AB0105] Chroma Strand ABS Filament, Black 2.85mm, 5 lb reel | 30.7 | g |  |  |  | Chroma Strand Labs, LLC |  | Reel, 5lb | 0.02 USD/g | 0.61 USD
 | > > > > > | HD-MS0158 | [HD-MS0158] Metric Brass Heat-Set Insert For Plastics Tapered, M5-.8 Internal Thread, 6.7mm Length | 2 | PCE |  |  |  | Aero-Space Fasteners and Hardware (formerly Colorado Electronic Hardware) | PEM IUBB-M5-1 | PCE | 0.07 USD/PCE | 0.15 USD
 | > > > > | PP-IS0045 | [PP-IS0045] Spool Mount B with inserts | 1 | PCE
 | > > > > > | PP-GP0318 | [PP-GP0318] Spool Mount B | 1 | PCE
 | > > > > > > | RM-AB0105 | [RM-AB0105] Chroma Strand ABS Filament, Black 2.85mm, 5 lb reel | 38.4 | g |  |  |  | Chroma Strand Labs, LLC |  | Reel, 5lb | 0.02 USD/g | 0.76 USD
 | > > > > > | HD-MS0158 | [HD-MS0158] Metric Brass Heat-Set Insert For Plastics Tapered, M5-.8 Internal Thread, 6.7mm Length | 4 | PCE |  |  |  | Aero-Space Fasteners and Hardware (formerly Colorado Electronic Hardware) | PEM IUBB-M5-1 | PCE | 0.07 USD/PCE | 0.30 USD
 | > > > > | PP-IS0067 | [PP-IS0067] Mini 2, Spool Hinge | 1 | PCE
 | > > > > > | PP-GP0253 | [PP-GP0253] spool-arm-bracket_black_v1.0 | 1 | PCE
 | > > > > > > | RM-AB0105 | [RM-AB0105] Chroma Strand ABS Filament, Black 2.85mm, 5 lb reel | 10.74 | g |  |  |  | Chroma Strand Labs, LLC |  | Reel, 5lb | 0.02 USD/g | 0.21 USD
 | > > > > > | HD-MS0030 | [HD-MS0030] Metric Brass Heat-Set Insert for Plastics Tapered, M3-.5 Internal Thread, 3.8mm Length | 4 | PCE |  |  |  | Aero-Space Fasteners and Hardware (formerly Colorado Electronic Hardware) | PEM IUBB-M3-1 | PCE | 0.04 USD/PCE | 0.14 USD
 | > > > > | PP-GP0255_v1.4 | [PP-GP0255_v1.4] spool-arm_black_v1.4 | 1 | PCE
 | > > > > > | RM-AB0105 | [RM-AB0105] Chroma Strand ABS Filament, Black 2.85mm, 5 lb reel | 16.43 | g |  |  |  | Chroma Strand Labs, LLC |  | Reel, 5lb | 0.02 USD/g | 0.33 USD
 | > > > > | HD-BT0049 | [HD-BT0049] Metric Class 12.9 Socket Head Cap Screw, Alloy Steel, M5 thread, 14MM length, 0.80MM pitch | 2 | PCE |  |  | 1139539 | Fastenal | 1139539 | PCE | 0.02 USD/PCE | 0.05 USD
 | > > > > | HD-BT0120 | [HD-BT0120] Alloy Steel Shoulder Screw, 6mm Diameter x 10mm Long Shoulder, M5 Thread | 2 | PCE |  |  | 40000 | Fastenal | 40000 | PCE | 0.59 USD/PCE | 1.18 USD
 | > > > > | HD-BT0151 | [HD-BT0151] M5 x 20mm SCHS, Black Oxide | 2 | PCE |  |  |  | McMaster-Carr | 91290A242 | pkg, 100 | 0.12 USD/PCE | 0.24 USD
 | > > > > | HD-WA0040 | [HD-WA0040] Black-Oxide 18-8 Stainless Steel Flat Washer, M5 Screw Size, 5.3mm ID, 10.0mm OD | 4 | PCE |  |  |  | Fastenal | 11264558 | PCE | 0.02 USD/PCE | 0.08 USD
 | > > > | AS-TH0022 | [AS-TH0022] Mini, Gladiola, Extruder Assembly | 1 | PCE
 | > > > > | AS-HE0005 | [AS-HE0005] Hexagon Hot End, .5mm Assembly, Mini Single | 1 | PCE
 | > > > > > | AS-CB0024 | [AS-CB0024] Heater Cartridge 175mm Harness | 1 | PCE
 | > > > > > > | EL-MS0205 | [EL-MS0205] Molex-CONN TERM MALE 22-24AWG TIN - Reels of 20K | 2 | PCE |  | Molex | 16-02-0107 | TTI Global Distribution | 16-02-0107 | PCE | 0.02 USD/PCE | 0.04 USD
 | > > > > > > | EL-MS0377 | [EL-MS0377] 24V 30W Heater Cartridge, 23cm Leads (with no connectors on end) | 1 | PCE |  | Reprapdiscount / PLUG IT LTD |  | Reprapdiscount / PLUG IT LTD | HC24V | PCE | 3.25 USD/PCE | 3.25 USD
 | > > > > > | AS-CB0025 | [AS-CB0025] Thermistor 195mm Harness | 1 | PCE
 | > > > > > > | EL-MS0212 | [EL-MS0212] Molex-CONN PIN 24-30AWG Crimp Tin, 20,000 Unit Reel | 2 | PCE |  |  | 16-02-0105 | TTI Global Distribution | 16-02-0105 | PCE | 0.02 USD/PCE | 0.04 USD
 | > > > > > > | EL-TH0011 | [EL-TH0011] Semitec GT2 Thermistor (100kOhm type) Leads with no connectors on end. | 1 | PCE |  | Reprapdiscount / PLUG IT LTD |  | Reprapdiscount / PLUG IT LTD | Semitec104gt2 Thermistor | PCE | 1.30 USD/PCE | 1.30 USD
 | > > > > > | EL-HR0124 | [EL-HR0124] Mini, Zero Sense 215mm Harness | 1 | PCE
 | > > > > > > | EL-MS0141 | [EL-MS0141] Term Ring Non Ins 26-22AWG #4 Order Bulk Only | 1 | PCE |  | Panduit | P22-4R-M | TTI Global Distribution | P22-4R-M | PCE | 0.06 USD/PCE | 0.06 USD
 | > > > > > > | EL-MS0205 | [EL-MS0205] Molex-CONN TERM MALE 22-24AWG TIN - Reels of 20K | 1 | PCE |  | Molex | 16-02-0107 | TTI Global Distribution | 16-02-0107 | PCE | 0.02 USD/PCE | 0.02 USD
 | > > > > > > | EL-WR0040 | [EL-WR0040] Wire - Single Conductor 20AWG SOLID PTFE, RED | 215 | mm |  | Thermax | M16878/4BGA-2 | Hardware Speciality |  | ft, 500 | 0.00 USD/mm | 0.21 USD
 | > > > > > | HD-BT0104 | [HD-BT0104] M3 x 8 Bolt, BHCS, SST | 2 | PCE |  |  | MB2510008A20000 | Fastenal | MB2510008A20000 | PCE | 0.10 USD/PCE | 0.19 USD
 | > > > > > | HD-BT0172 | [HD-BT0172] M3 x 4 Setscrew (Heater Cartridge Set Screw) | 1 | PCE |  | Reprapdiscount / PLUG IT LTD |  | Reprapdiscount / PLUG IT LTD | M3x4 Setscrew | pkg, 2 | 0.04 USD/PCE | 0.04 USD
 | > > > > > | HD-MS0230 | [HD-MS0230] Black Class 12.9 Socket Head Cap Screw, Alloy Steel, M2 Thread, 6mm Length, 0.4mm Pitch | 1 | PCE |  |  | 0134596 | Fastenal | 0134596 | PCE | 0.03 USD/PCE | 0.03 USD
 | > > > > > | HD-WA0035 | [HD-WA0035] Metric 18-8 Stainless Steel External Serrated Lock Washer, M3 Screw Size, 6mm OD, 0.4mm min Thick | 1 | PCE |  |  | 11511313 | Fastenal | 11511313 | PCE | 0.02 USD/PCE | 0.02 USD
 | > > > > > | PP-MP0133 | [PP-MP0133] Hexagon Heatsink for 3mm Filament | 1 | PCE |  | Reprapdiscount / PLUG IT LTD |  | Reprapdiscount / PLUG IT LTD | Hexagon AO Body | PCE | 19.50 USD/PCE | 19.50 USD
 | > > > > > | PP-MP0134 | [PP-MP0134] Hexagon Heater Block with Holes for Retention Plate and Hexagon Logo Laser Etched on Front | 1 | PCE |  | Reprapdiscount / PLUG IT LTD |  | Reprapdiscount / PLUG IT LTD | Hexagon AO Block | PCE | 5.20 USD/PCE | 5.20 USD
 | > > > > > | PP-MP0135 | [PP-MP0135] 0.5mm Nozzle for 3mm Filament | 1 | PCE |  | Reprapdiscount / PLUG IT LTD |  | Reprapdiscount / PLUG IT LTD | Nozzle 0.5mm | PCE | 4.55 USD/PCE | 4.55 USD
 | > > > > > | PP-MP0136 | [PP-MP0136] Thermistor Retention Plate | 1 | PCE |  | Reprapdiscount / PLUG IT LTD |  | Reprapdiscount / PLUG IT LTD | Hexagon AO Retention Plate | PCE | 0.52 USD/PCE | 0.52 USD
 | > > > > | AS-TH0003 | [AS-TH0003] Large Herringbone, Green with Hob Bolt Assembly | 1 | PCE
 | > > > > > | PP-GP0191 | [PP-GP0191] Herringbone Large Gear v1.3, Lulzbot green | 1 | PCE
 | > > > > > > | RM-AB0104 | [RM-AB0104] Chroma Strand ABS Filament, Lulzbot Green 2.85mm, 5 lb reel | 23.71 | g |  | Chroma Strand Labs, LLC |  | Chroma Strand Labs, LLC |  | Reel, 5lb | 0.02 USD/g | 0.47 USD
 | > > > > > | HD-BT0108 | [HD-BT0108] Hobbed Bolt, M8 x 50mm Hex head, 26mm offset, Stainless Steel | 1 | PCE |  |  |  | Quattro Machining Services, Inc. |  | PCE | 5.99 USD/PCE | 5.99 USD
 | > > > > | AS-TH0005 | [AS-TH0005] Extruder Thumb Screw assembly | 2 | PCE
 | > > > > > | HD-BT0052 | [HD-BT0052] Metric Class 12.9 Socket Head Cap Screw M4 Thread, 55mm Length, 0.70mm Pitch | 1 | PCE |  |  | ZT2530055PF0000 | Fastenal | ZT2530055PF000 | PCE | 0.09 USD/PCE | 0.09 USD
 | > > > > > | HD-MS0031 | [HD-MS0031] Metric Press-Fit Plastic Thumb Screw Head Knurled, Black, Fits M4 Screw, 13mm A, 5.5mm B | 1 | PCE |  |  | 11102951 | Fastenal | 11102951 | PCE | 0.08 USD/PCE | 0.08 USD
 | > > > > | AS-TH0016 | [AS-TH0016] Extruder Heatsink Fan duct with Insert Assembly | 1 | PCE
 | > > > > > | PP-GP0232 | [PP-GP0232] heatsink-fan-duct_black_v0.6 | 1 | PCE
 | > > > > > > | RM-AB0105 | [RM-AB0105] Chroma Strand ABS Filament, Black 2.85mm, 5 lb reel | 11.07 | g |  |  |  | Chroma Strand Labs, LLC |  | Reel, 5lb | 0.02 USD/g | 0.22 USD
 | > > > > > | HD-MS0030 | [HD-MS0030] Metric Brass Heat-Set Insert for Plastics Tapered, M3-.5 Internal Thread, 3.8mm Length | 4 | PCE |  |  |  | Aero-Space Fasteners and Hardware (formerly Colorado Electronic Hardware) | PEM IUBB-M3-1 | PCE | 0.04 USD/PCE | 0.14 USD
 | > > > > | AS-TH0023 | [AS-TH0023] Mini, Nozzle Fan Mount Complete | 1 | PCE
 | > > > > > | PP-GP0252 | [PP-GP0252] Extruder Fan Mount v2.0, Mini | 1 | PCE
 | > > > > > > | RM-AB0105 | [RM-AB0105] Chroma Strand ABS Filament, Black 2.85mm, 5 lb reel | 12.16 | g |  |  |  | Chroma Strand Labs, LLC |  | Reel, 5lb | 0.02 USD/g | 0.24 USD
 | > > > > > | HD-MS0030 | [HD-MS0030] Metric Brass Heat-Set Insert for Plastics Tapered, M3-.5 Internal Thread, 3.8mm Length | 2 | PCE |  |  |  | Aero-Space Fasteners and Hardware (formerly Colorado Electronic Hardware) | PEM IUBB-M3-1 | PCE | 0.04 USD/PCE | 0.07 USD
 | > > > > > | PP-MP0066 | [PP-MP0066] Metric Brass Heat-Set Insert for Plastics, Tapered, M2-.4 Internal Thread, 2.9MM Length | 2 | PCE |  |  |  | Aero-Space Fasteners and Hardware (formerly Colorado Electronic Hardware) | PEM ZZIUB-48213 | PCE | 0.05 USD/PCE | 0.10 USD
 | > > > > | AS-TH0027 | [AS-TH0027] Mini, Extruder Mount Complete | 1 | PCE
 | > > > > > | PP-GP0251 | [PP-GP0251] Extruder Mount v3.0, Mini | 1 | PCE
 | > > > > > > | RM-AB0105 | [RM-AB0105] Chroma Strand ABS Filament, Black 2.85mm, 5 lb reel | 35.36 | g |  |  |  | Chroma Strand Labs, LLC |  | Reel, 5lb | 0.02 USD/g | 0.70 USD
 | > > > > > | HD-MS0030 | [HD-MS0030] Metric Brass Heat-Set Insert for Plastics Tapered, M3-.5 Internal Thread, 3.8mm Length | 3 | PCE |  |  |  | Aero-Space Fasteners and Hardware (formerly Colorado Electronic Hardware) | PEM IUBB-M3-1 | PCE | 0.04 USD/PCE | 0.11 USD
 | > > > > > | HD-MS0158 | [HD-MS0158] Metric Brass Heat-Set Insert For Plastics Tapered, M5-.8 Internal Thread, 6.7mm Length | 3 | PCE |  |  |  | Aero-Space Fasteners and Hardware (formerly Colorado Electronic Hardware) | PEM IUBB-M5-1 | PCE | 0.07 USD/PCE | 0.22 USD
 | > > > > | AS-TH0028 | [AS-TH0028] Beefy idler Assembly, Black | 1 | PCE
 | > > > > > | PP-GP0276 | [PP-GP0276] Beefy Extruder Idler v0.4 | 1 | PCE
 | > > > > > > | RM-AB0105 | [RM-AB0105] Chroma Strand ABS Filament, Black 2.85mm, 5 lb reel | 12.66 | g |  |  |  | Chroma Strand Labs, LLC |  | Reel, 5lb | 0.02 USD/g | 0.25 USD
 | > > > > > | HD-MS0282 | [HD-MS0282] 608-2RS ABEC3/C3 Rubber Sealed Bearing - BLACK | 1 | PCE |  | JSB Great Bearings | 608-2RS ABEC3/C3 | JSB Great Bearings | 608-2RS ABEC3/C3 | PCE | 0.42 USD/PCE | 0.42 USD
 | > > > > > | HD-RD0004 | [HD-RD0004] 8mm Smooth Rod x 18-19mm, Stainless Steel (Nubbin) | 1 | PCE |  | Igus, Inc. | EWMR-08-19 | Igus, Inc. | EWMR-08-19 | PCE | 1.50 USD/PCE | 1.50 USD
 | > > > > | EL-HR0121 | [EL-HR0121] Mini, Nozzle Fan Harness | 1 | PCE
 | > > > > > | EL-FA0032 | [EL-FA0032] Pelonis FAN 24V 40mmx40mmx10mm Low flow | 1 | PCE |  |  | C4010L24BPLB1b-7 | Pelonis Technologies, Inc. | C4010L24BPLB1b-7 | PCE | 3.13 USD/PCE | 3.13 USD
 | > > > > > | EL-MS0205 | [EL-MS0205] Molex-CONN TERM MALE 22-24AWG TIN - Reels of 20K | 2 | PCE |  | Molex | 16-02-0107 | TTI Global Distribution | 16-02-0107 | PCE | 0.02 USD/PCE | 0.04 USD
 | > > > > | EL-HR0122 | [EL-HR0122] Mini, Extruder Motor Harness | 1 | PCE
 | > > > > > | EL-MS0074 | [EL-MS0074] Molex-CONN HOUSING 20POS .100 DUAL, BLACK | 1 | PCE |  |  | 0022552201 | TTI Global Distribution | 22552201 | PCE | 0.56 USD/PCE | 0.56 USD
 | > > > > > | EL-MS0205 | [EL-MS0205] Molex-CONN TERM MALE 22-24AWG TIN - Reels of 20K | 4 | PCE |  | Molex | 16-02-0107 | TTI Global Distribution | 16-02-0107 | PCE | 0.02 USD/PCE | 0.07 USD
 | > > > > > | EL-MS0351 | [EL-MS0351] JST - CONN TERM CRIMP PH 24-30AWG - 8,000 Unit Reel | 4 | PCE |  | JST Sales America | SPH-002T-P0.5S | Future Electronics |  | PCE | 0.01 USD/PCE | 0.05 USD
 | > > > > > | EL-MS0355 | [EL-MS0355] CONN HOUSING PH 6POS 2MM WHITE | 1 | PCE |  | JST Sales America | PHR-6 | Future Electronics | PHR-6 | PCE | 0.04 USD/PCE | 0.04 USD
 | > > > > > | EL-WR0103 | [EL-WR0103] 24AWG Stranded – Red | 200 | mm |  |  |  | Allcable | HU1569247RD | ft, 1000 | 0.00 USD/mm | 0.02 USD
 | > > > > > | EL-WR0105 | [EL-WR0105] 24AWG Stranded – Black | 200 | mm |  |  |  | Allcable | HU1569247BK | ft, 1000 | 0.00 USD/mm | 0.02 USD
 | > > > > > | EL-WR0119 | [EL-WR0119] 24AWG Stranded Wire – Green | 200 | mm |  |  |  | Allcable | HU1569247GN | ft, 1000 | 0.00 USD/mm | 0.02 USD
 | > > > > > | EL-WR0107 | [EL-WR0107] 24AWG Stranded – White | 200 | mm |  |  |  | Allcable | HU1569247WE | ft, 1000 | 0.00 USD/mm | 0.02 USD
 | > > > > > | EL-MS0247 | [EL-MS0247] Heat Shrink Tubing – 0.19-0.09 – Black, 100' | 90 | mm |  | 3M | 88-01870 | Electronics Distributors Corp. | 88-01870 | PCE, 100' | 0.00 USD/mm | 0.07 USD
 | > > > > | EL-HR0123 | [EL-HR0123] Mini, Heat Sink Fan Harness | 1 | PCE
 | > > > > > | EL-FA0034 | [EL-FA0034] Pelonis FAN 5V 40x40x10mm Low flow | 1 | PCE |  |  | C4010L05BPLB1b-7 | Pelonis Technologies, Inc. | C4010L05BPLB1b-7 | PCE | 3.07 USD/PCE | 3.07 USD
 | > > > > > | EL-MS0205 | [EL-MS0205] Molex-CONN TERM MALE 22-24AWG TIN - Reels of 20K | 2 | PCE |  | Molex | 16-02-0107 | TTI Global Distribution | 16-02-0107 | PCE | 0.02 USD/PCE | 0.04 USD
 | > > > > | EL-HR0125 | [EL-HR0125] Mini X Max Switch Harness | 2 | PCE
 | > > > > > | EL-MS0142 | [EL-MS0142] Conn Recept Faston 22-26AWG .110 - Reel of 3K | 1 | PCE |  |  | 7-520365-2 | TTI Global Distribution | 7-520365-2 | PCE | 0.08 USD/PCE | 0.08 USD
 | > > > > > | EL-WR0120 | [EL-WR0120] 24AWG Stranded Wire – Purple | 170 | mm |  |  |  | Allcable | HU1569247VT | ft, 1000 | 0.00 USD/mm | 0.01 USD
 | > > > > > | EL-MS0205 | [EL-MS0205] Molex-CONN TERM MALE 22-24AWG TIN - Reels of 20K | 1 | PCE |  | Molex | 16-02-0107 | TTI Global Distribution | 16-02-0107 | PCE | 0.02 USD/PCE | 0.02 USD
 | > > > > | PP-GP0060 | [PP-GP0060] Extruder Washer v3.0, Taz | 1 | PCE
 | > > > > > | RM-AB0105 | [RM-AB0105] Chroma Strand ABS Filament, Black 2.85mm, 5 lb reel | 0.2 | g |  |  |  | Chroma Strand Labs, LLC |  | Reel, 5lb | 0.02 USD/g | 0.00 USD
 | > > > > | PP-GP0186 | [PP-GP0186] extruder body hex black v1.4.1 | 1 | PCE
 | > > > > > | RM-AB0105 | [RM-AB0105] Chroma Strand ABS Filament, Black 2.85mm, 5 lb reel | 32.82 | g |  |  |  | Chroma Strand Labs, LLC |  | Reel, 5lb | 0.02 USD/g | 0.65 USD
 | > > > > | PP-GP0192 | [PP-GP0192] Herringbone Small Gear v1.1, Lulzbot green | 1 | PCE
 | > > > > > | RM-AB0104 | [RM-AB0104] Chroma Strand ABS Filament, Lulzbot Green 2.85mm, 5 lb reel | 3.47 | g |  | Chroma Strand Labs, LLC |  | Chroma Strand Labs, LLC |  | Reel, 5lb | 0.02 USD/g | 0.07 USD
 | > > > > | PP-GP0245 | [PP-GP0245] Beefy Idler Latch v2.2, black | 1 | PCE
 | > > > > > | RM-AB0105 | [RM-AB0105] Chroma Strand ABS Filament, Black 2.85mm, 5 lb reel | 2.32 | g |  |  |  | Chroma Strand Labs, LLC |  | Reel, 5lb | 0.02 USD/g | 0.05 USD
 | > > > > | DC-LB0104 | [DC-LB0104] Tool Head Wiring Connector Alignment Label | 1 | PCE |  |  |  | Sticker Giant |  | PCE | 0.03 USD/PCE | 0.03 USD
 | > > > > | EL-MT0029 | [EL-MT0029] NEMA 17 Stepper Motor, Moons' - NOT INCLUDING wire harness | 1 | PCE |  |  | MS17HD6P4150-01-B | Moons' Industries (America), Inc. | MS17HD6P4150-01-B | PCE | 8.30 USD/PCE | 8.30 USD
 | > > > > | EL-SW0022 | [EL-SW0022] SWITCH BASIC SPDT 3A .110QC 125V | 1 | PCE |  |  | SS-3GPT | TTI Global Distribution | SS-3GPT | PCE | 0.42 USD/PCE | 0.42 USD
 | > > > > | HD-BT0012 | [HD-BT0012] M3 Set Screw (Grub Screw) | 1 | PCE |  |  | 40818 | Fastenal | 40818 | PCE | 0.03 USD/PCE | 0.03 USD
 | > > > > | HD-BT0039 | [HD-BT0039] Metric Class 12.9 Socket Head Cap Screw, Alloy Steel, M3 Thread, 12MM Length, 0.50MM Pitch | 9 | PCE |  |  | 39505 | Fastenal | 39505 | PCE | 0.03 USD/PCE | 0.26 USD
 | > > > > | HD-BT0041 | [HD-BT0041] Metric Class 12.9 Socket Head Cap Screw Alloy Steel, M3 Thread, 25mm Length, 0.50mm Pitch | 2 | PCE |  |  | 39508 | Fastenal | 39508 | PCE | 0.03 USD/PCE | 0.06 USD
 | > > > > | HD-BT0107 | [HD-BT0107] Metric Class 12.9 Socket Head Cap Screw Alloy Steel, Black, M2 Thread, 10mm Length, 0.4mm Pitch | 2 | PCE |  |  | 0134599 | Fastenal | 0134599 | PCE | 0.02 USD/PCE | 0.04 USD
 | > > > > | HD-BT0118 | [HD-BT0118] M3 x 14 Bolt FHCS, Black-Oxide | 2 | PCE |  |  | 40925 | Fastenal | 40925 | PCE | 0.02 USD/PCE | 0.04 USD
 | > > > > | HD-MS0027 | [HD-MS0027] Extruder Comp Spring - Music Wire, Extruder, 6mm OD, 0.8mm WD, 9.7mm FL | 2 | PCE |  |  | C02400320380M | Associated Spring | C0240-032-0380-M | PCE | 0.16 USD/PCE | 0.32 USD
 | > > > > | HD-MS0229 | [HD-MS0229] M4 x 25 Bolt, SHCS Black-Oxide | 2 | PCE |  |  | 11103314 | Fastenal | 11103314 | PCE | 0.15 USD/PCE | 0.29 USD
 | > > > > | HD-MS0282 | [HD-MS0282] 608-2RS ABEC3/C3 Rubber Sealed Bearing - BLACK | 2 | PCE |  | JSB Great Bearings | 608-2RS ABEC3/C3 | JSB Great Bearings | 608-2RS ABEC3/C3 | PCE | 0.42 USD/PCE | 0.84 USD
 | > > > > | HD-NT0002 | [HD-NT0002] M8 Nyloc Nut, Zinc Plated | 1 | PCE |  |  | 40163 | Fastenal | 40163 | PCE | 0.03 USD/PCE | 0.03 USD
 | > > > > | HD-NT0004 | [HD-NT0004] M3 Nut, Steel, Zinc Plated | 2 | PCE |  |  | 40302 | Fastenal | 40302 | PCE | 0.01 USD/PCE | 0.01 USD
 | > > > > | HD-NT0011 | [HD-NT0011] M4 Nut, Steel, Zinc Plated | 4 | PCE |  |  | 40303 | Fastenal | 40303 | PCE | 0.01 USD/PCE | 0.02 USD
 | > > > > | HD-WA0006 | [HD-WA0006] M8 Washer, Steel, Zinc Plated | 3 | PCE |  |  |  | Fastenal | 40357 | PCE | 0.04 USD/PCE | 0.12 USD
 | > > > > | HD-WA0008 | [HD-WA0008] Metric Spring Steel Shim - DIN 988 0.5mm Thick, 8mm ID, 14mm OD | 1 | PCE |  |  | 11511045 | Fastenal | 11511045 | PCE | 0.05 USD/PCE | 0.05 USD
 | > > > > | HD-WA0009 | [HD-WA0009] Metric Spring Steel Shim - DIN 988 1.0mm Thick, 8mm ID, 14mm OD | 1 | PCE |  |  | 11511046 | Fastenal | 11511046 | PCE | 0.05 USD/PCE | 0.05 USD
 | > > > > | HD-WA0012 | [HD-WA0012] Steel Flat Washer, DIN 125 zinc-plated class 4,M2 screw sz, 5mm OD, .25mm-.35mm thick | 2 | PCE |  |  | 40350 | Fastenal | 40350 | PCE | 0.04 USD/PCE | 0.07 USD
 | > > > > | HD-WA0038 | [HD-WA0038] Black-Oxide 18-8 Steel Flat Washer, M3 Screw Size, 3.2mm ID, 7.0mm OD | 5 | PCE |  |  |  | Fastenal | 11264395 | PCE | 0.02 USD/PCE | 0.08 USD
 | > > > > | HD-WA0039 | [HD-WA0039] Black-Oxide 18-8 Stainless Steel Flat Washer, M4 Screw Size, 4.3mm ID, 9.0mm OD | 6 | PCE |  |  |  | Fastenal | 11264487 | PCE | 0.02 USD/PCE | 0.13 USD
 | > > > > | PP-MP0137 | [PP-MP0137] Standard Hexagon Mount Plate | 1 | PCE |  | Reprapdiscount / PLUG IT LTD |  | Reprapdiscount / PLUG IT LTD | Grove Mount Plate | PCE | 2.35 USD/PCE | 2.35 USD
 | > > > | EL-HR0118 | [EL-HR0118] Chassis Ground Extension Wire Harness | 1 | PCE
 | > > > > | EL-MS0059 | [EL-MS0059] Molex-CONN TERM FEMALE 22-24AWG TIN Reels of 20K | 2 | PCE |  | Molex | 16-02-0086 | TTI Global Distribution | 16-02-0086 | PCE | 0.01 USD/PCE | 0.03 USD
 | > > > > | EL-MS0141 | [EL-MS0141] Term Ring Non Ins 26-22AWG #4 Order Bulk Only | 2 | PCE |  | Panduit | P22-4R-M | TTI Global Distribution | P22-4R-M | PCE | 0.06 USD/PCE | 0.12 USD
 | > > > > | EL-WR0119 | [EL-WR0119] 24AWG Stranded Wire – Green | 200 | mm |  |  |  | Allcable | HU1569247GN | ft, 1000 | 0.00 USD/mm | 0.02 USD
 | > > > > | PC-CN0001 | [PC-CN0001] Molex-Conn Housing 2POS .100 W/Latch | 1 | PCE |  | Molex | 050579402 | Sager Electronics | 050579402 | PCE | 0.06 USD/PCE | 0.06 USD
 | > > > | PP-GP0247 | [PP-GP0247] USB support mini v1.5 | 1 | PCE
 | > > > > | RM-AB0105 | [RM-AB0105] Chroma Strand ABS Filament, Black 2.85mm, 5 lb reel | 2.05 | g |  |  |  | Chroma Strand Labs, LLC |  | Reel, 5lb | 0.02 USD/g | 0.04 USD
 | > > > | PP-GP0249 | [PP-GP0249] bed clip v3 | 1 | PCE
 | > > > > | RM-AB0105 | [RM-AB0105] Chroma Strand ABS Filament, Black 2.85mm, 5 lb reel | 2.86 | g |  |  |  | Chroma Strand Labs, LLC |  | Reel, 5lb | 0.02 USD/g | 0.06 USD
 | > > > | PP-GP0280 | [PP-GP0280] x-carriage-cap_black_v2.5 | 1 | PCE
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
