leedshackspace/lulzbot-mini/parts/jigs/heat_pad_alignment_jig_mini.stl

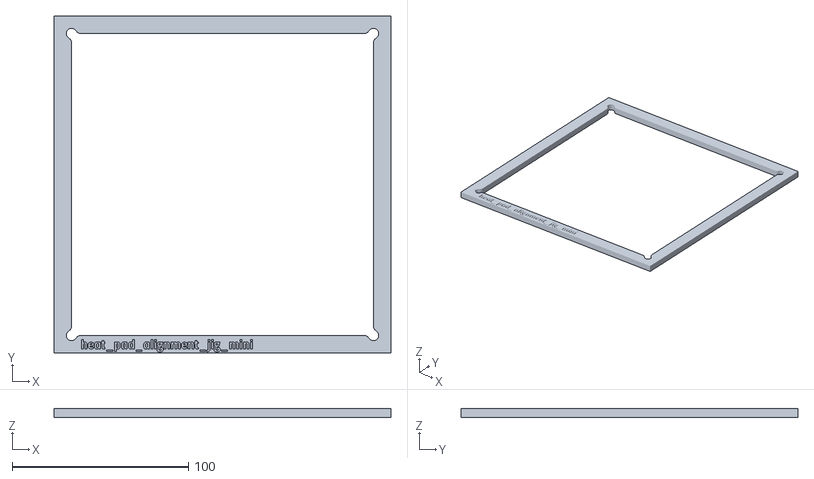
[picture p1: CAD file, 2022-02-17]
parts/jigs/heat_pad_alignment_jig_mini.stl
191.0 x 191.0 x 5.00
