leedshackspace/lulzbot-mini/parts/printed_parts/bed_clip/bed_clip_v3.stl

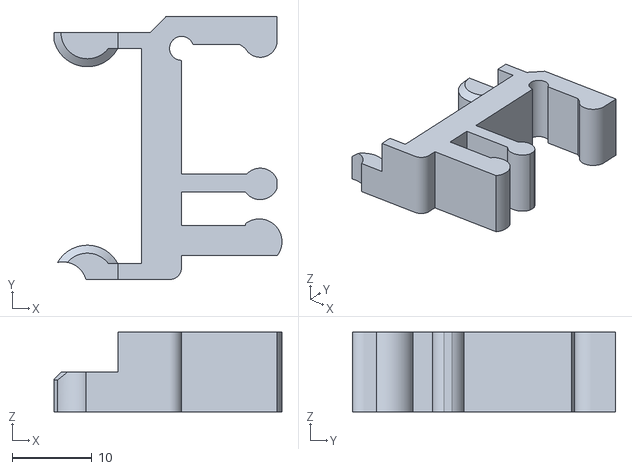
[picture p2: CAD file, 2022-02-17]
parts/printed_parts/bed_clip/bed_clip_v3.stl
28.6 x 33.0 x 10.0
