leedshackspace/lulzbot-mini/parts/printed_parts/bed_corner/bed_corner_v2.7.stl

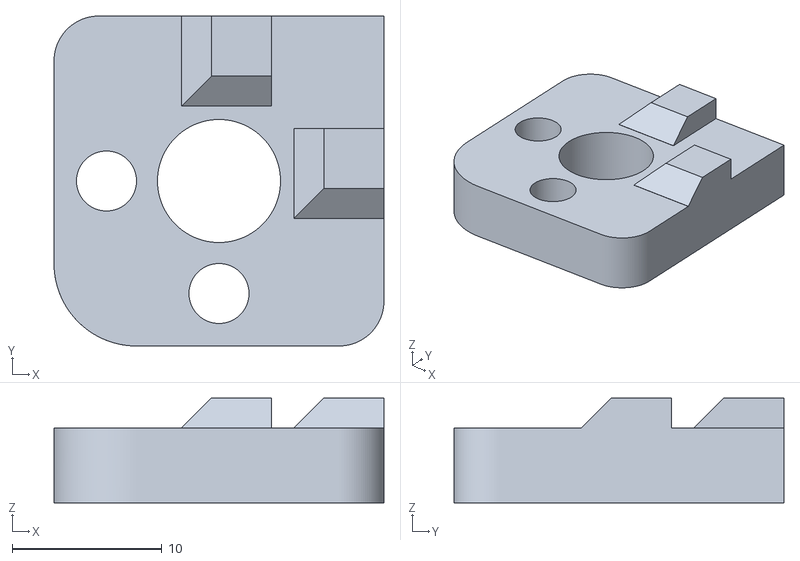
[picture p3: CAD file, 2022-02-17]
parts/printed_parts/bed_corner/bed_corner_v2.7.stl
22.0 x 22.0 x 7.00
