leedshackspace/lulzbot-mini/parts/printed_parts/beefy_extruder_idler/beefy_extruder_idler_v0.4.stl

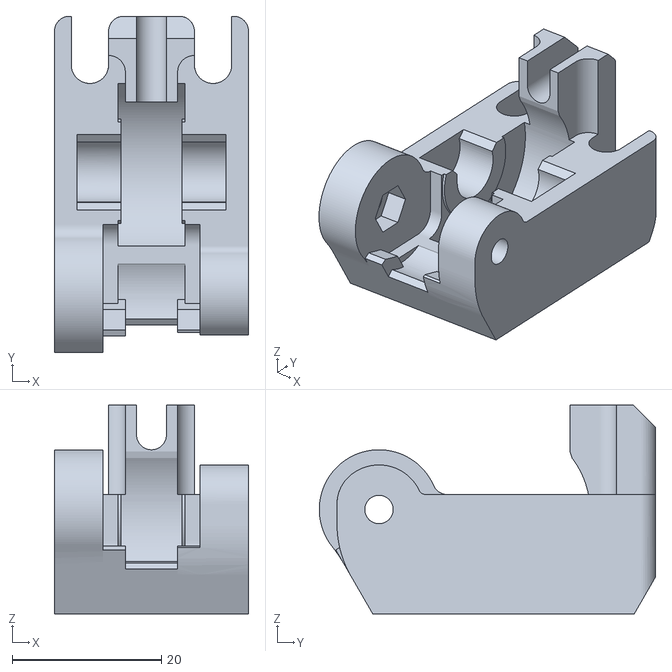
[picture p4: CAD file, 2022-02-17]
parts/printed_parts/beefy_extruder_idler/beefy_extruder_idler_v0.4.stl
26.0 x 45.1 x 28.0
