leedshackspace/lulzbot-mini/parts/printed_parts/beefy_idler_latch/beefy_idler_latch_v2.2.stl

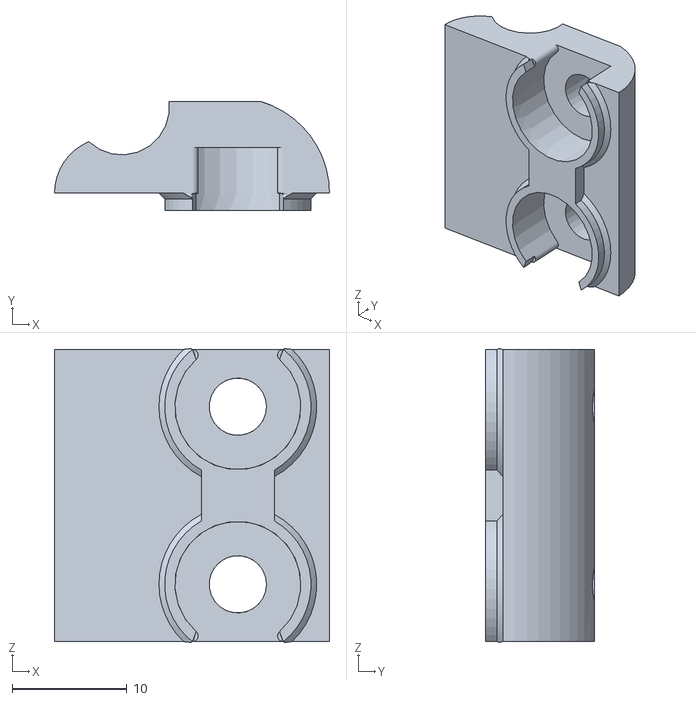
[picture p5: CAD file, 2022-02-17]
parts/printed_parts/beefy_idler_latch/beefy_idler_latch_v2.2.stl
24.0 x 9.50 x 25.7
