leedshackspace/lulzbot-mini/parts/printed_parts/belt-clamp/belt-clamp_black_v1.1.stl

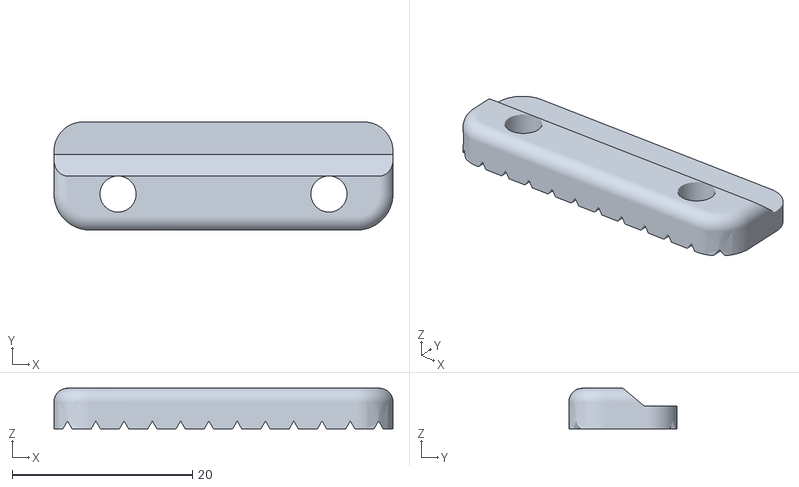
[picture p6: CAD file, 2022-02-17]
parts/printed_parts/belt-clamp/belt-clamp_black_v1.1.stl
37.6 x 12.0 x 4.50
