leedshackspace/lulzbot-mini/parts/printed_parts/belt-mount/belt-mount_black_v1.1.stl

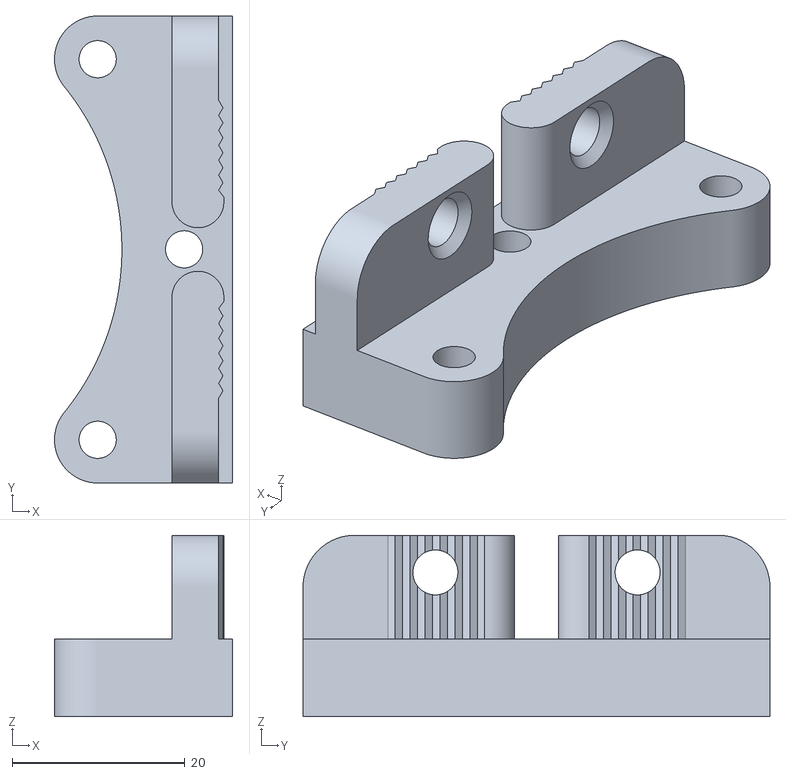
[picture p7: CAD file, 2022-02-17]
parts/printed_parts/belt-mount/belt-mount_black_v1.1.stl
20.6 x 54.0 x 21.0
