leedshackspace/lulzbot-mini/parts/printed_parts/double-bearing-holder/double-bearing-holder_black_v1.4.stl

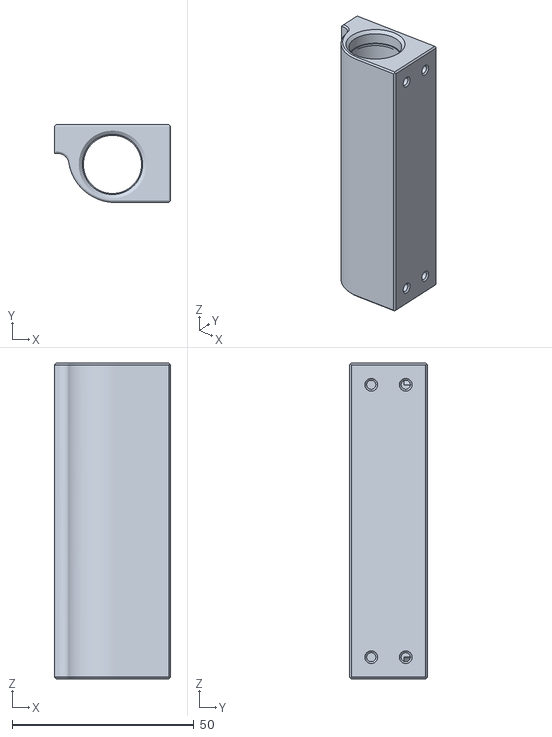
[picture p8: CAD file, 2022-02-17]
parts/printed_parts/double-bearing-holder/double-bearing-holder_black_v1.4.stl
32.0 x 21.5 x 87.0
