leedshackspace/lulzbot-mini/parts/printed_parts/extruder-body-hex/extruder-body-hex_black_v1.4.1.stl

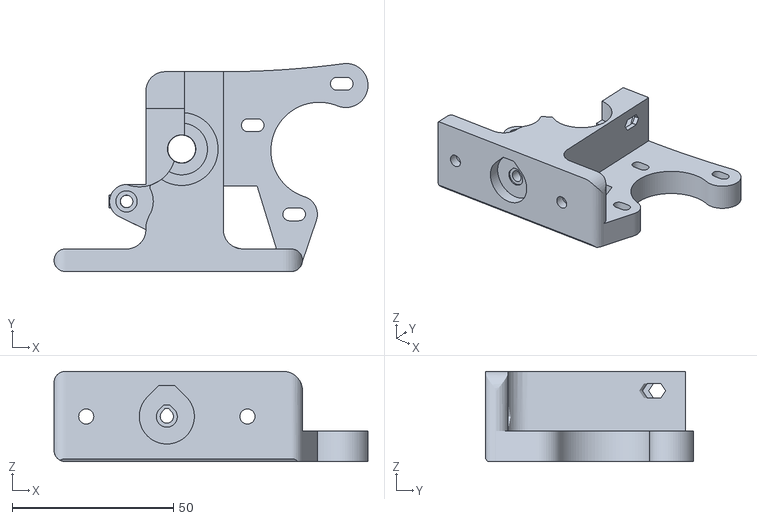
[picture p9: CAD file, 2022-02-17]
parts/printed_parts/extruder-body-hex/extruder-body-hex_black_v1.4.1.stl
97.4 x 64.5 x 28.0
