leedshackspace/lulzbot-mini/parts/printed_parts/extruder_fan_mount/extruder_fan_mount_v2.1_mini.stl

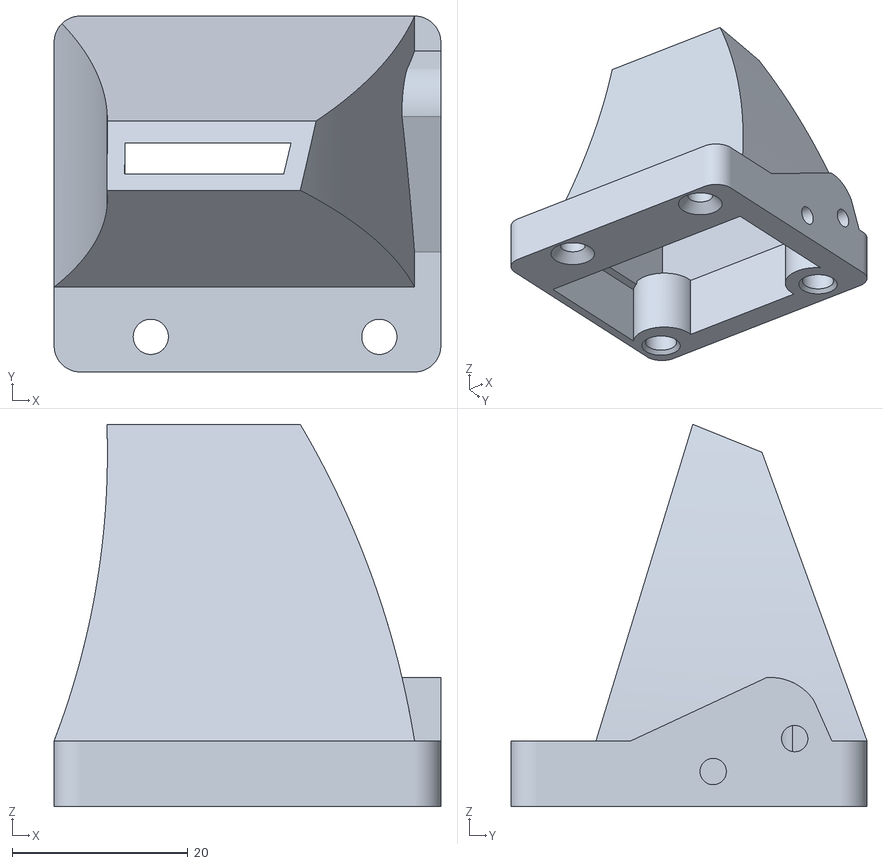
[picture p10: CAD file, 2022-02-17]
parts/printed_parts/extruder_fan_mount/extruder_fan_mount_v2.1_mini.stl
44.0 x 40.5 x 43.5
