leedshackspace/lulzbot-mini/parts/printed_parts/extruder_mount/extruder_mount_v2.11.stl

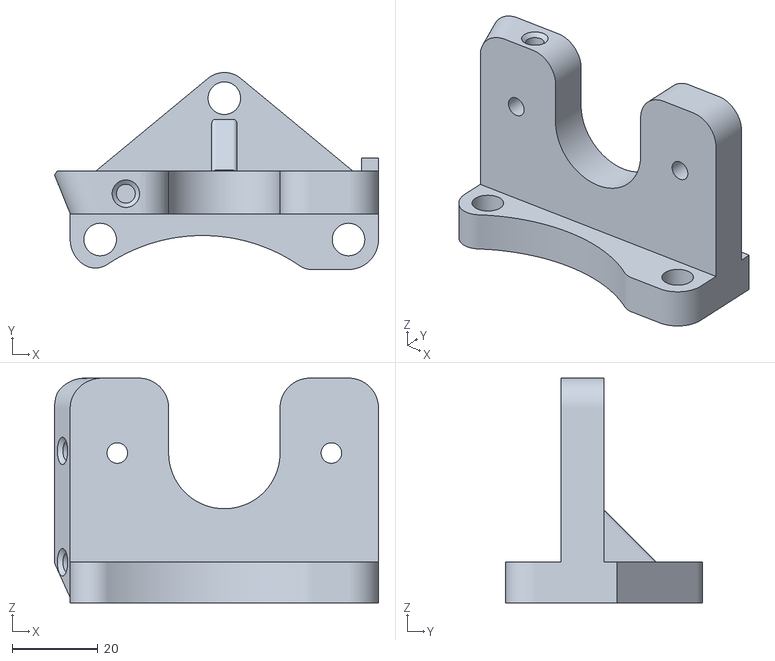
[picture p11: CAD file, 2022-02-17]
parts/printed_parts/extruder_mount/extruder_mount_v2.11.stl
75.7 x 46.0 x 52.5
