leedshackspace/lulzbot-mini/parts/printed_parts/handle/handle-bar_black_v2.6.stl

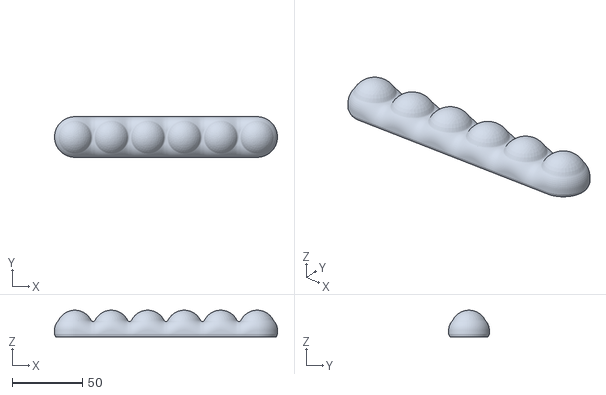
[picture p12: CAD file, 2022-02-17]
parts/printed_parts/handle/handle-bar_black_v2.6.stl
159.0 x 29.0 x 19.0
