leedshackspace/lulzbot-mini/parts/printed_parts/heatsink-fan-duct/heatsink-fan-duct_black_v0.6.stl

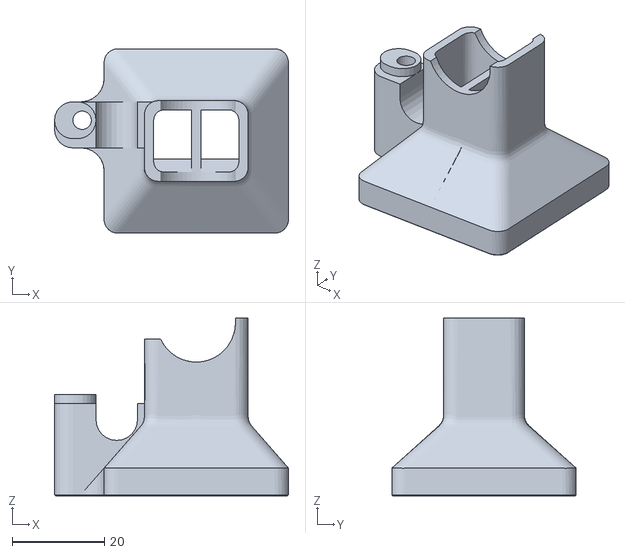
[picture p13: CAD file, 2022-02-17]
parts/printed_parts/heatsink-fan-duct/heatsink-fan-duct_black_v0.6.stl
50.8 x 40.0 x 38.5
