leedshackspace/lulzbot-mini/parts/printed_parts/herringbone-gears/large-herringbone/lrg_herringbone_gear_v1.3.stl

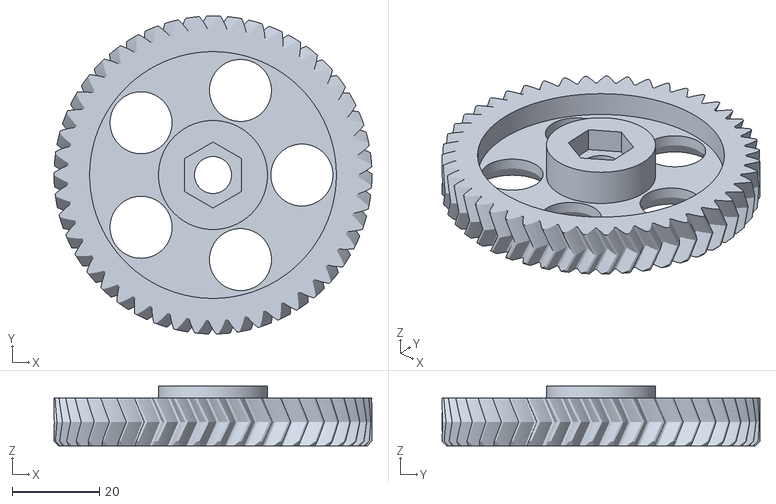
[picture p14: CAD file, 2022-02-17]
parts/printed_parts/herringbone-gears/large-herringbone/lrg_herringbone_gear_v1.3.stl
73.0 x 73.0 x 13.8
