leedshackspace/lulzbot-mini/parts/printed_parts/herringbone-gears/small-herringbone/herringbone_small_gear-1.1-highres.stl

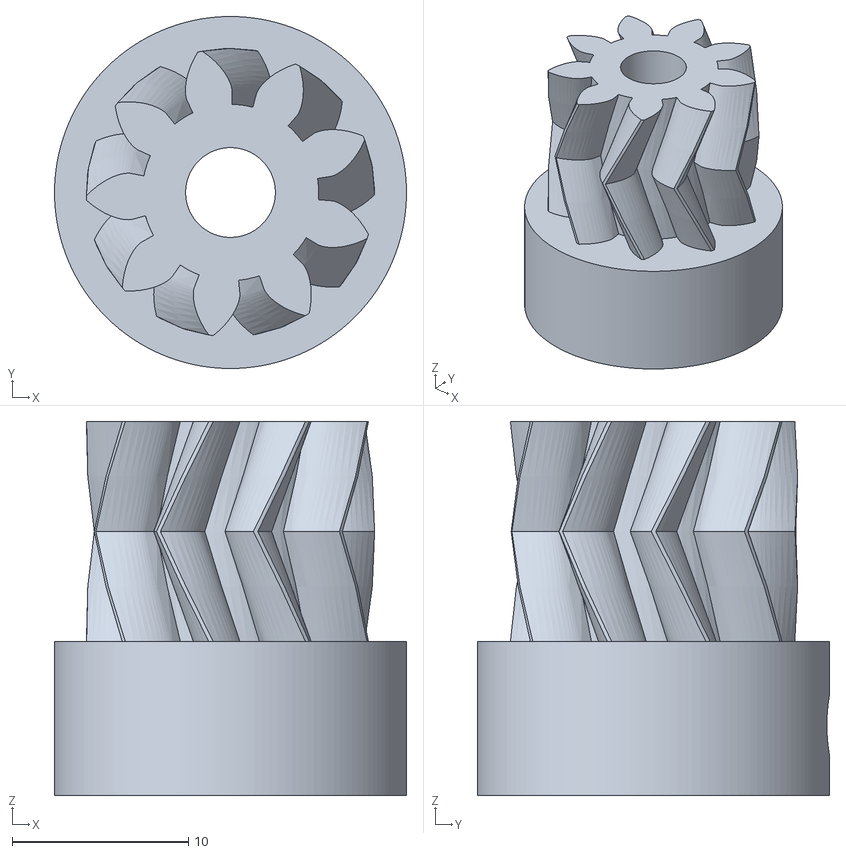
[picture p15: CAD file, 2022-02-17]
parts/printed_parts/herringbone-gears/small-herringbone/herringbone_small_gear-1.1-highres.stl
20.0 x 20.0 x 21.2
