leedshackspace/lulzbot-mini/parts/printed_parts/lower-z-left-mini/lower-z-left-mini_lulz-green_v1.6.stl

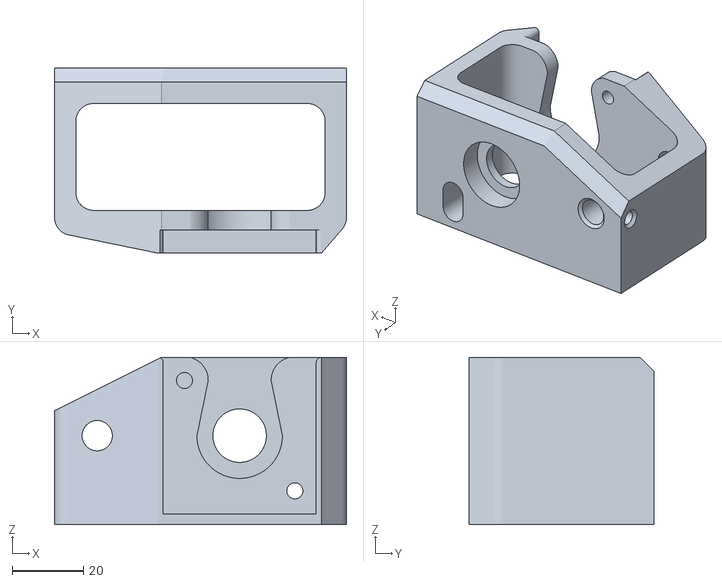
[picture p16: CAD file, 2022-02-17]
parts/printed_parts/lower-z-left-mini/lower-z-left-mini_lulz-green_v1.6.stl
82.0 x 52.0 x 47.0
