leedshackspace/lulzbot-mini/parts/printed_parts/spool-arm-bracket/spool-arm-bracket_black_v1.0.stl

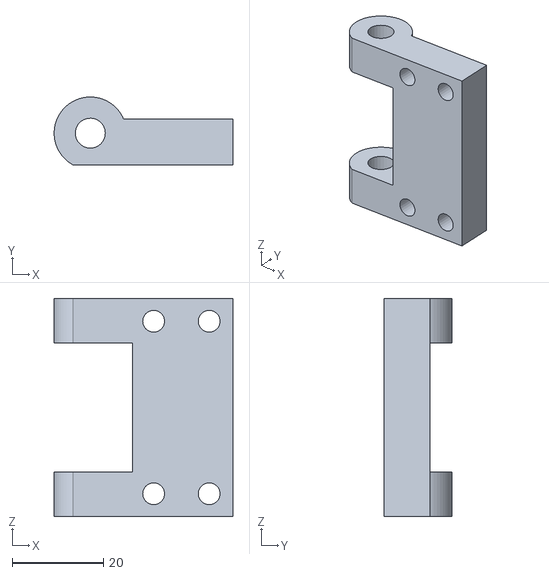
[picture p17: CAD file, 2022-02-17]
parts/printed_parts/spool-arm-bracket/spool-arm-bracket_black_v1.0.stl
39.3 x 14.9 x 47.9
