leedshackspace/lulzbot-mini/parts/printed_parts/spool-arm-mini/spool-arm-mini_black_v1.4.stl

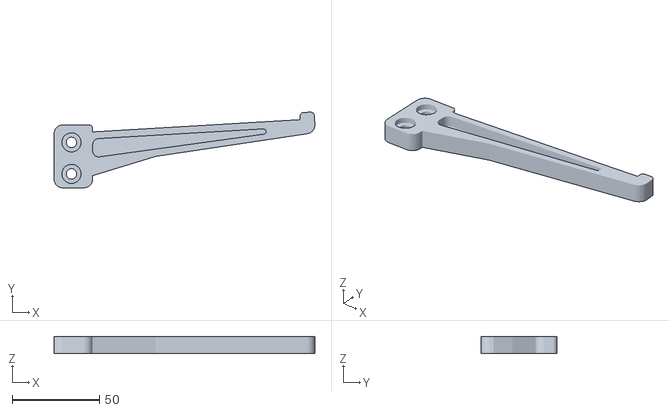
[picture p18: CAD file, 2022-02-17]
parts/printed_parts/spool-arm-mini/spool-arm-mini_black_v1.4.stl
149.2 x 43.3 x 10.0
