leedshackspace/lulzbot-mini/parts/printed_parts/spool-arm-support/spool-arm-support_black_v1.1.stl

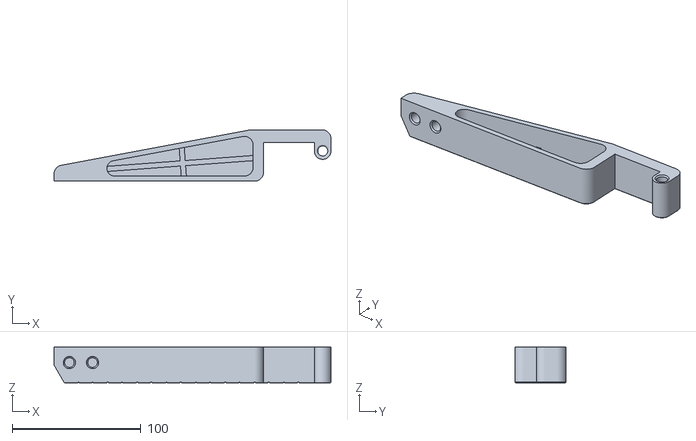
[picture p19: CAD file, 2022-02-17]
parts/printed_parts/spool-arm-support/spool-arm-support_black_v1.1.stl
215.5 x 40.0 x 27.8
