leedshackspace/lulzbot-mini/parts/printed_parts/strain-relief-lower/strain-relief-lower_black_1.2.stl

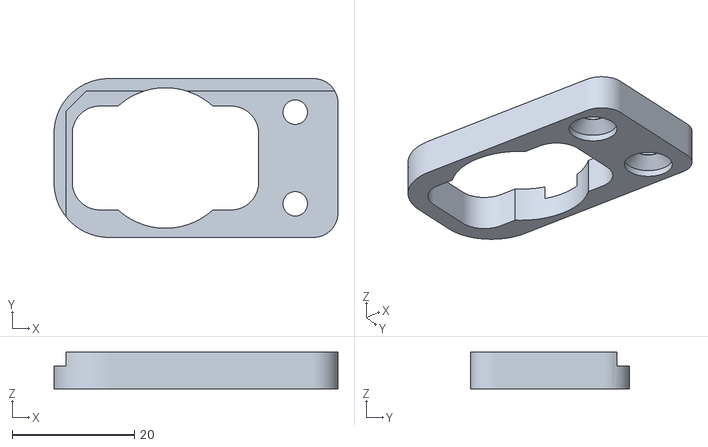
[picture p20: CAD file, 2022-02-17]
parts/printed_parts/strain-relief-lower/strain-relief-lower_black_1.2.stl
46.5 x 26.0 x 6.00
