leedshackspace/lulzbot-mini/parts/printed_parts/strain-relief-upper/strain-relief-upper_black_v3.0.stl

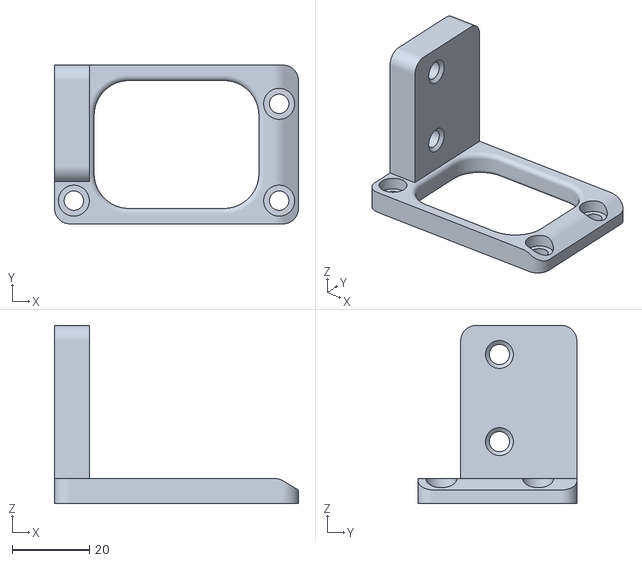
[picture p21: CAD file, 2022-02-17]
parts/printed_parts/strain-relief-upper/strain-relief-upper_black_v3.0.stl
63.0 x 41.0 x 46.0
