leedshackspace/lulzbot-mini/parts/printed_parts/upper-bearing-holder/upper-bearing-holder_black_v3.0.stl

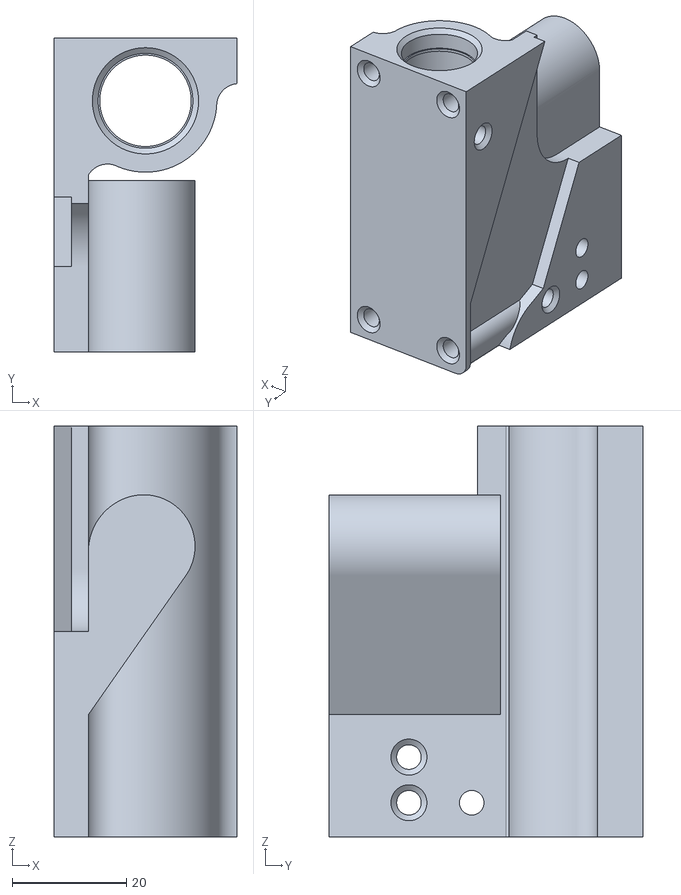
[picture p22: CAD file, 2022-02-17]
parts/printed_parts/upper-bearing-holder/upper-bearing-holder_black_v3.0.stl
32.0 x 55.0 x 72.0
