leedshackspace/lulzbot-mini/parts/printed_parts/wiper_mount/wiper_mount_v1.1-x3.stl

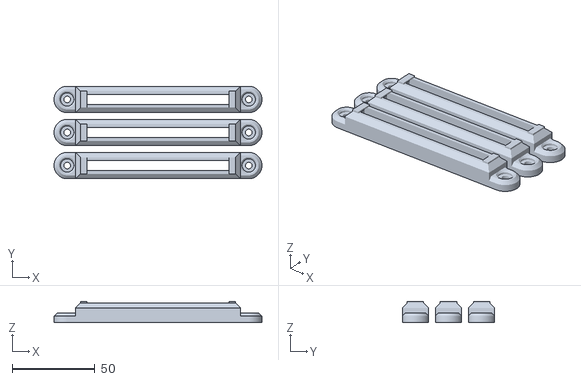
[picture p23: CAD file, 2022-02-17]
parts/printed_parts/wiper_mount/wiper_mount_v1.1-x3.stl
126.0 x 56.0 x 13.0
