leedshackspace/lulzbot-mini/parts/printed_parts/x-carriage-cap/x-carriage-cap_black_v2.4.stl

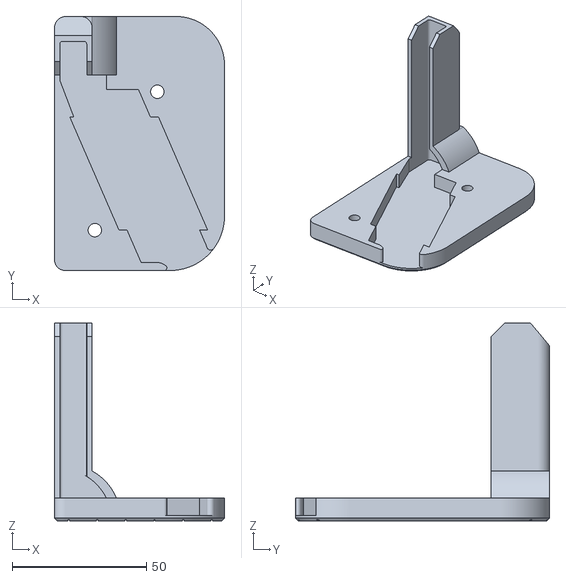
[picture p24: CAD file, 2022-02-17]
parts/printed_parts/x-carriage-cap/x-carriage-cap_black_v2.4.stl
63.2 x 94.5 x 73.5
