leedshackspace/lulzbot-mini/parts/printed_parts/x-carriage-mini/x-carriage-mini_black_v1.1.stl

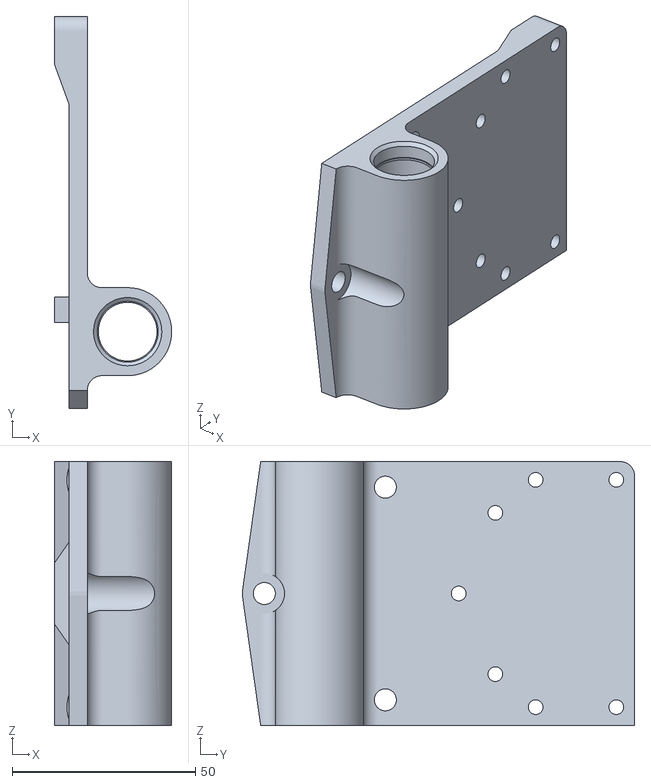
[picture p25: CAD file, 2022-02-17]
parts/printed_parts/x-carriage-mini/x-carriage-mini_black_v1.1.stl
32.0 x 107.0 x 72.0
