leedshackspace/lulzbot-mini/parts/printed_parts/x-end-motor/x-end-motor-mini_black_v1.9.stl

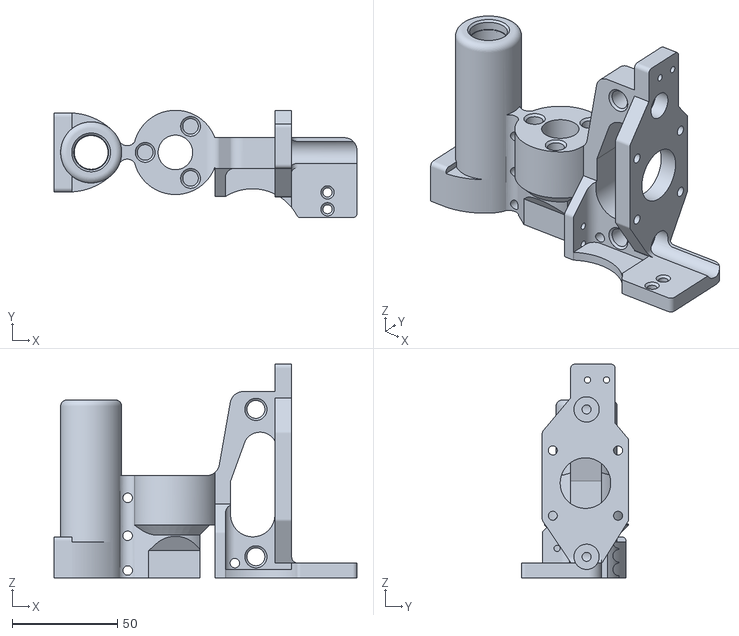
[picture p26: CAD file, 2022-02-17]
parts/printed_parts/x-end-motor/x-end-motor-mini_black_v1.9.stl
143.9 x 51.0 x 101.5
