leedshackspace/lulzbot-mini/parts/printed_parts/x-end_idler/x-end-idler-mini_black_v2.8.stl

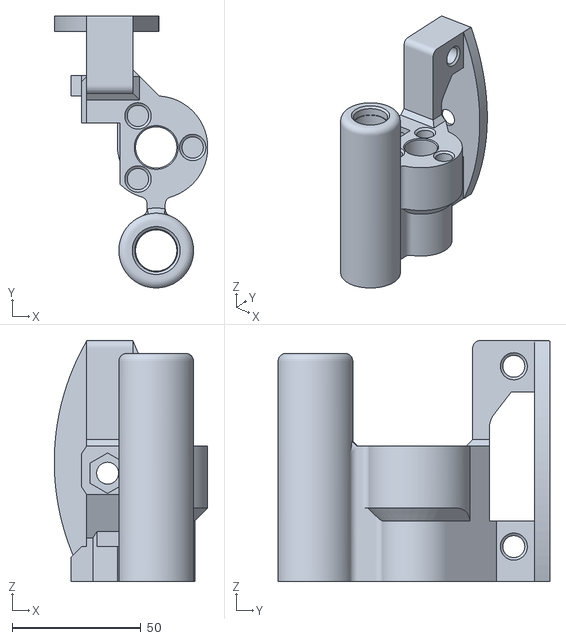
[picture p27: CAD file, 2022-02-17]
parts/printed_parts/x-end_idler/x-end-idler-mini_black_v2.8.stl
59.6 x 105.5 x 93.5
