leedshackspace/lulzbot-mini/parts/printed_parts/y-idler/y-idler-mini_black_v1.4.stl

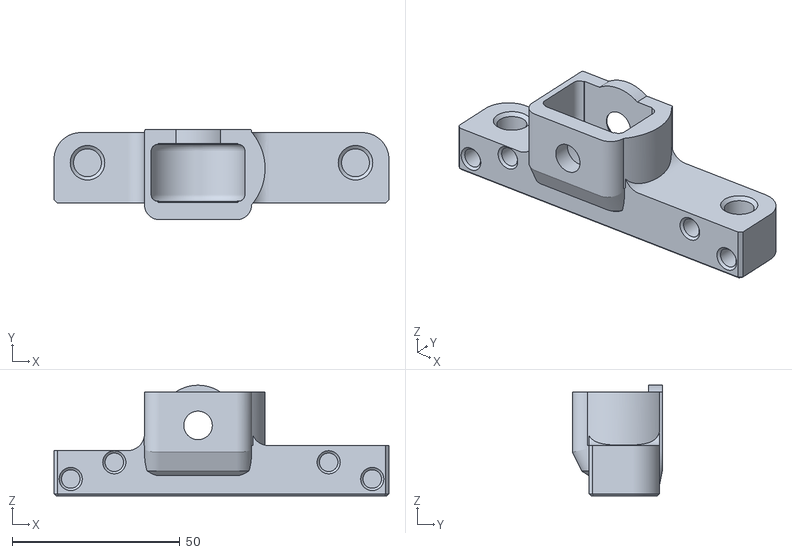
[picture p28: CAD file, 2022-02-17]
parts/printed_parts/y-idler/y-idler-mini_black_v1.4.stl
100.0 x 27.0 x 33.0
