leedshackspace/lulzbot-mini/parts/printed_parts/y-motor-mount/y-motor-mount_black_v1.4.stl

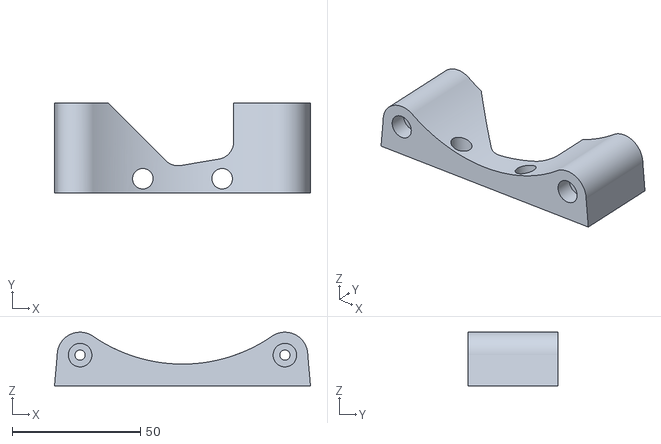
[picture p29: CAD file, 2022-02-17]
parts/printed_parts/y-motor-mount/y-motor-mount_black_v1.4.stl
100.0 x 35.0 x 21.0
