leedshackspace/lulzbot-mini/parts/printed_parts/z-upper-mini-left/z-upper-mini-left_black_v2.0.stl

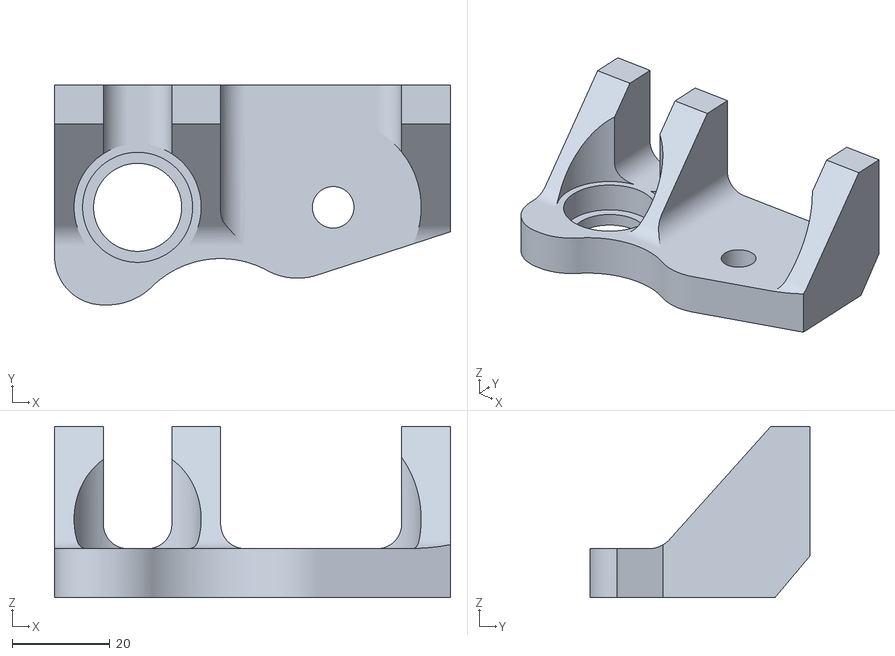
[picture p30: CAD file, 2022-02-17]
parts/printed_parts/z-upper-mini-left/z-upper-mini-left_black_v2.0.stl
81.0 x 45.0 x 35.0
