leedshackspace/lulzbot-mini/software/curasource/resources/example/OpenHardwareKeychain.stl

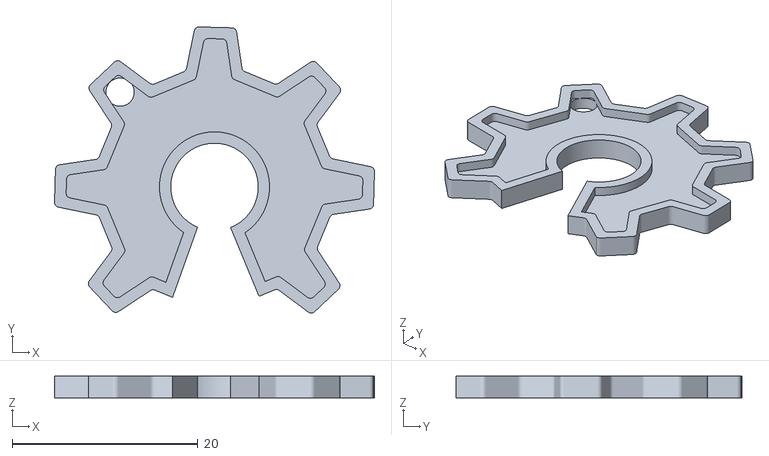
[picture p31: CAD file, 2022-02-17]
software/curasource/resources/example/OpenHardwareKeychain.stl
34.5 x 30.8 x 2.32
