leedshackspace/lulzbot-mini/software/curasource/resources/meshes/ultimaker2go_platform.stl

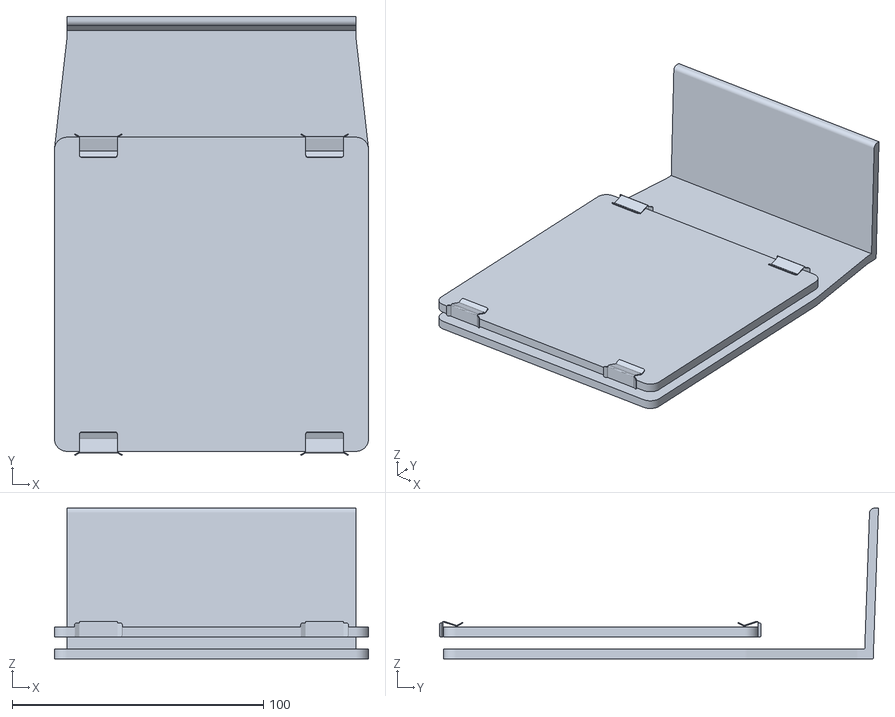
[picture p32: CAD file, 2022-02-17]
software/curasource/resources/meshes/ultimaker2go_platform.stl
125.0 x 174.7 x 60.0
