leedshackspace/lulzbot-mini/parts/jigs/15mm_z_motor_jig.stl

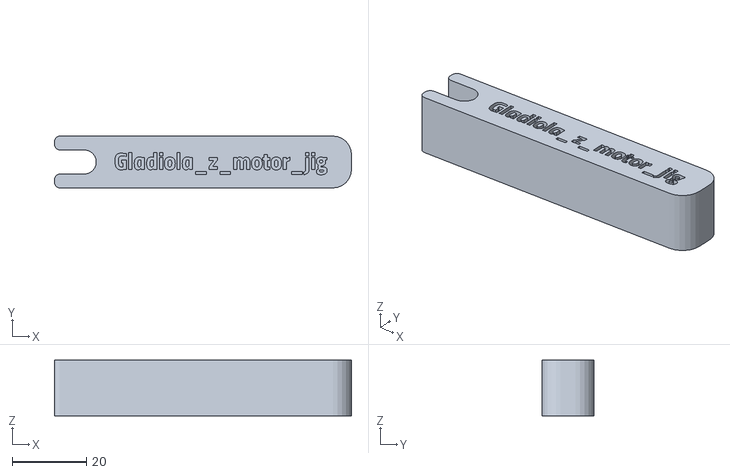
[picture p33: CAD file, 2022-02-17]
parts/jigs/15mm_z_motor_jig.stl
80.0 x 14.0 x 15.0
