leedshackspace/lulzbot-mini/parts/printed_parts/wiper_mount/wiper_mount_v1.1.stl

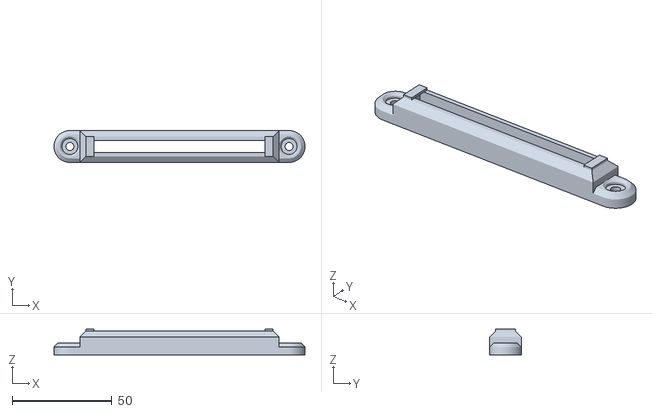
[picture p34: CAD file, 2022-02-17]
parts/printed_parts/wiper_mount/wiper_mount_v1.1.stl
126.0 x 16.0 x 13.0
