leedshackspace/lulzbot-mini/software/curasource/resources/example/UltimakerHandle.stl

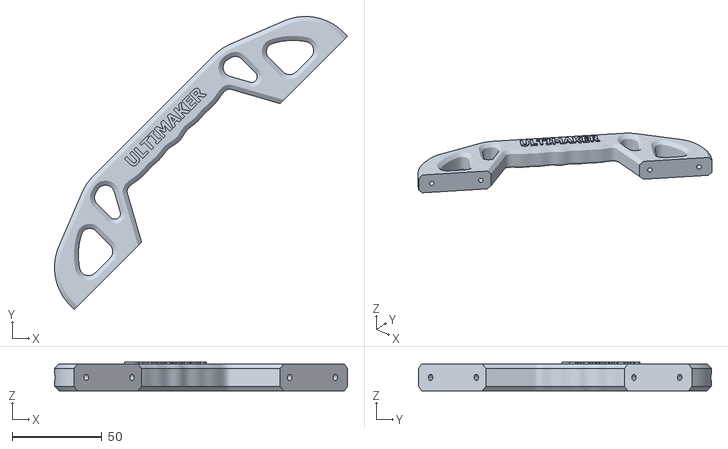
[picture p35: CAD file, 2022-02-17]
software/curasource/resources/example/UltimakerHandle.stl
163.0 x 163.0 x 16.0
