leedshackspace/lulzbot-mini/parts/jigs/Glad_80mmFanJig.stl

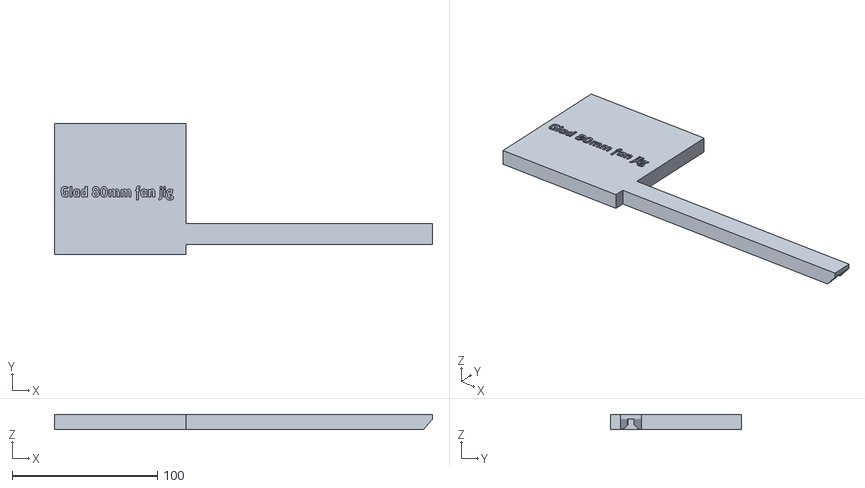
[picture p36: CAD file, 2022-02-17]
parts/jigs/Glad_80mmFanJig.stl
260.5 x 90.5 x 10.0
