leedshackspace/lulzbot-mini/(list of files, cad)

Other CAD files:
parts/printed_parts/extruder_mount/testing/extruder_mount_v2.14.stl
parts/printed_parts/lower-z-right-mini/lower-z-right-mini_lulz-green_v1.6.stl
parts/printed_parts/z-upper-mini-right/z-upper-mini-right_black_v2.0.stl
parts/jigs/heat_pad_alignment_jig_mini_1.stl
parts/jigs/nut_insert_tool.stl
parts/printed_parts/extruder_mount/testing/extruder_mount_v2.13.stl
parts/printed_parts/extruder_washer/extruder_washer_v3.0-x16.stl
