leedshackspace/lulzbot-mini/documentation/Quality Build Checklist.pdf

## QUALITY ASSURANCE RECORD

### Model: LulzBot Mini 1.0 3D Printer

Serial Number:
Date Completed:
Tested by:

Configuration:
Electronics: | Mini-RAMBo 1.3a
Firmware: | Marlin

Nozzle: 0.5mm diameter nozzle
Settings:
Stepper Motor | Steps/mm | Max Length | Microstep Mode | Digipot
X | 100.5 | 155 | 16 | 175
Y | 100.5 | 155 | 16 | 175
Z | 1600 | 155 | 16 | 220
E0 | 833 | NA | 16 | 135

Z Offset

General:
θ Are all the screws and zip ties tight?
θ Are the current version of parts being used?
θ Is the Spool Mount properly mounted so it flips up and sits securely? θ Is the Finger Clip properly mounted with the taller side on the left? θ Are the switches installed securely?
θ Are all 4 rubber feet installed?
θ Is the PEI tape free of bubbles and wrinkles?
θ Is the heat bed adhesive smooth and consistent? θ Is the frame free of scratches and scuffs?

Y Axis:
θ Does the Y bed move freely back and forth?
θ Is the Y bed tight side to side from motion and twisting?
θ Does the Y belt rub on the y-idler by the bearings?
θ Are the Y pulley set screws tight with one aligned with the flat on the motor shaft? θ Is the Y belt tight?
θ Are the four bed leveling washers tight?
θ Are the belts trimmed far enough to not interfere with the pulley or bearing?

## QUALITY ASSURANCE RECORD

X Axis:

θ Are the X pulley set screws tight with one aligned with the flat on the motor shaft? θ Does the X belt rub on the x-idler by the bearings?
θ Does the X belt rub on the screw heads of the belt mount?
θ Is the X belt tight?
θ Does the X axis move freely end to end?
θ Are the belts trimmed far enough to not interfere with the pulley or bearing? θ Are the wires and zip ties behind the carriage free from touching the case wall?

Z Axis:

θ Do the Z drive rods rotate smoothly?
θ Are the coupler set screws tight?
θ Are the drive rods and motor shafts aligned so the couplers are not bent?

Extruder:

θ Are the extruder springs set to 8mm between the cap and the latch?
θ Are the V grooves on the extruder gears lined up?
θ Is the hobbing aligned to the hole in the extruder?
θ Can you feed filament about 100mm from the top of the extruder?

Electronics:

θ Are all connections to the Mini-Rambo plugged in correctly?
θ Are all cables free from contacting any moving parts?

Test and Verification Results:

θ Verify case fan is running.
θ Verify heat sink fan is running when motors are engaged. θ Verify control of the extrusion fan.
θ Nozzle temperature control verified.
θ Extruder control verified.
θ X, Y, and Z min and max stop switches verified. θ Bed leveling is functioning properly.
θ Bed temperature control verified.
θ Bearing conditioning complete.
θ Test print (Octopus*) successful.
θ Print head moved to shipping position.

*Octopus by yeoldbrian is licensed under CC BY-SA 4.0

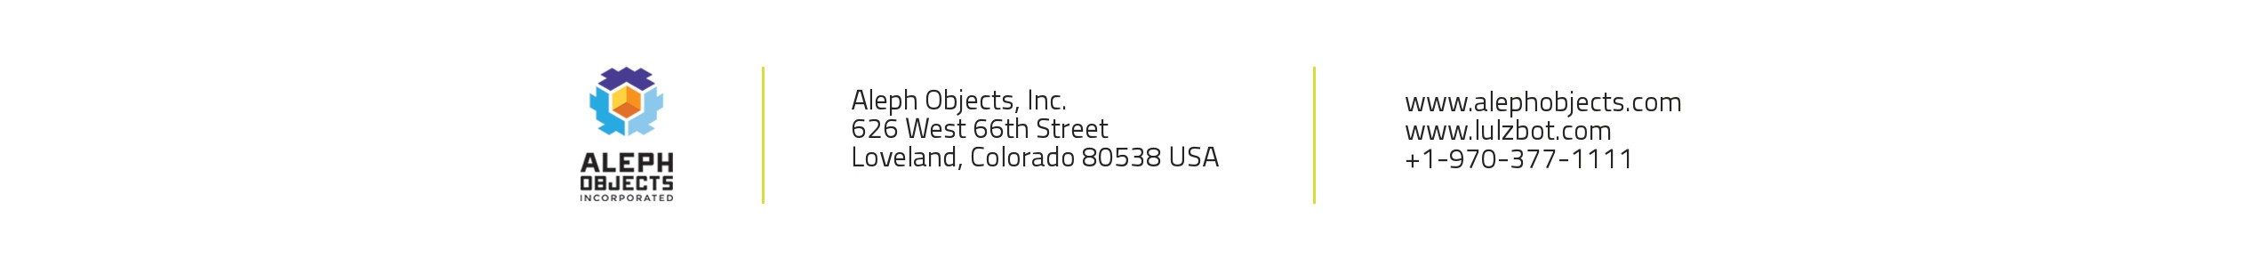
[picture p37: figure]
