leedshackspace/lulzbot-mini/parts/Electronics/cable-harnesses/igus_changelog.odt

Rev. B/C

X-Extruder Harness

- *No strain-relief teeth on mounting brackets!*
- *Cut X-min endstop wires 80mm not 40mm!*
- Heatshrink Z-max endstop wires together
- Make extruder motor cable 1150mm long
- Increase strip length for ferrite to 150mm (bring ferrite back 50mm)
- Shorten X-min/Z-max cable to 720mm
- Shorten X motor cable to 720mm
- Increase strip length of 20 position connector to 60mm
- Label wires

Bed Harness

- Increase Y-endstop cable strip length to 60mm
- Increase bed power cable strip length to 50mm
- Reduce the Z-probe cable length to 670mm, reduce the left strip length to 190mm
- Cut 40mm off the diode wire
- Label wires

Rev. D

X-Extruder Harness

- *No strain-relief teeth on mounting brackets!*
- *Cut 80mm off X-min endstop wires, not make it's length from the jacket 80mm!*
- Fix X-Motor label (X, not Z)
- Increase left-side E-Motor strip length to 80mm

Double-Ferrite X-Extruder Harness

- Increase left side strip length to 170mm and move ferrites to that new farther strip edge

Bed Harness

- *No strain-relief teeth on mounting brackets!*
- *Cut 40mm off brown diode wire, not make it's length from the jacket 40mm!*
- Increase right-side Y-Endstop cable strip length to 75mm
- Move labels to 25mm away from the pin

Rev. E

X-Extruder Harness

- Move shielding closer to (20mm away from) the ends of the X & E motor cables
- Change the lengths of the shielding/ground wires on the left-side of the X & E motor cables
- Add heat-shrink over the shielding that is exposed; The heat shrink insulation is thinner and more flexible than the cable's insulation where we need it to be
- Reduce right-side X-Motor cable strip length to 20mm
- Add shielding/ground wire to the right-side of the X-Motor cable
