leedshackspace/lulzbot-mini/parts/machined_parts/electronics_case/ready/mini_chassis_SilkScreen_Final.pdf

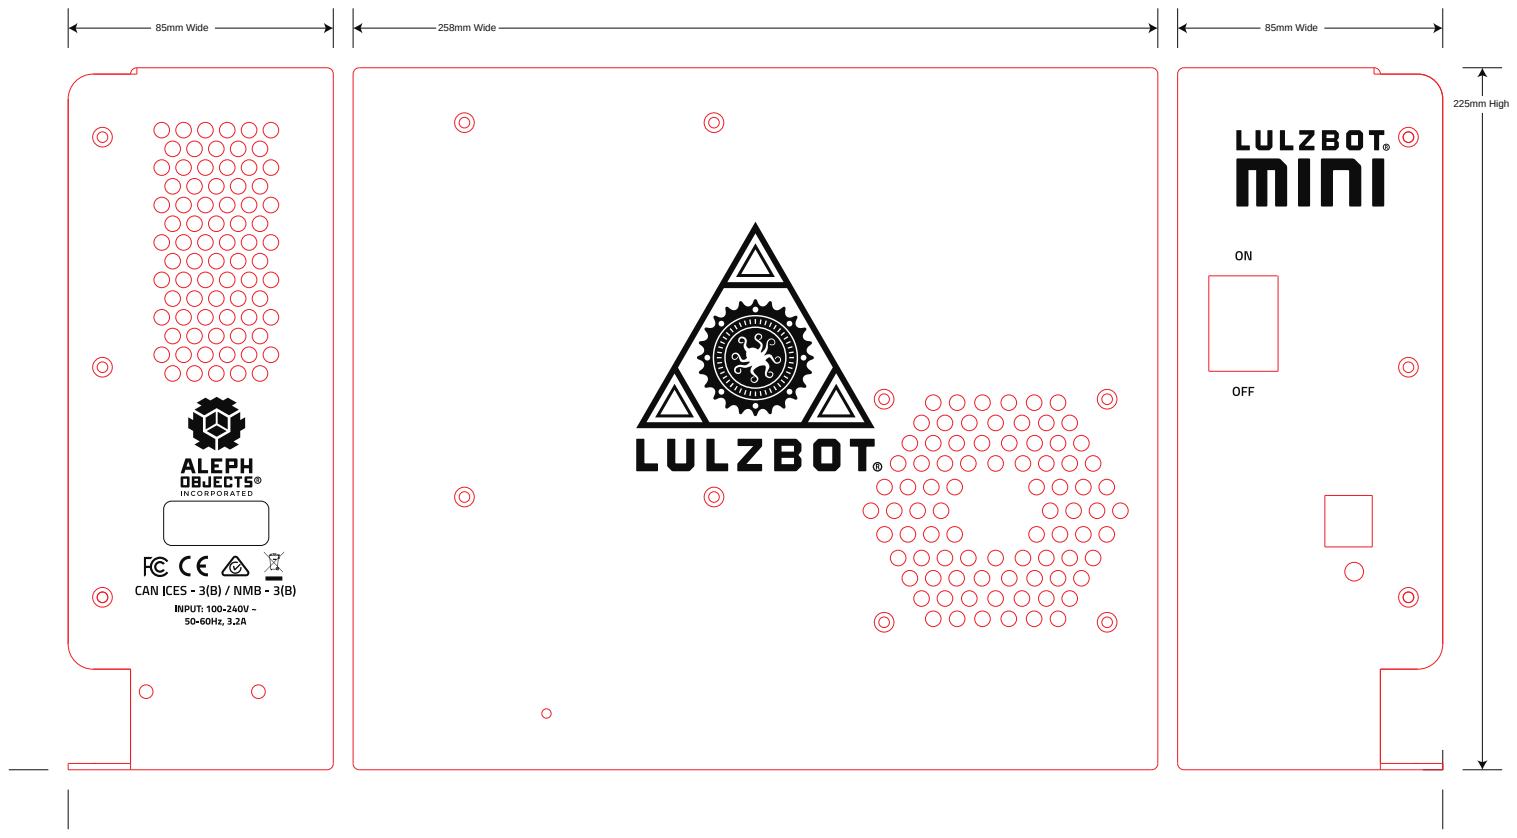
[picture p83: page 1]
225mm High; 85mm Wide; 258mm Wide
