leedshackspace/lulzbot-mini/parts/Electronics/bed_heat_pad/Silcone_heater_148mm-square_PC-BD0032.pdf

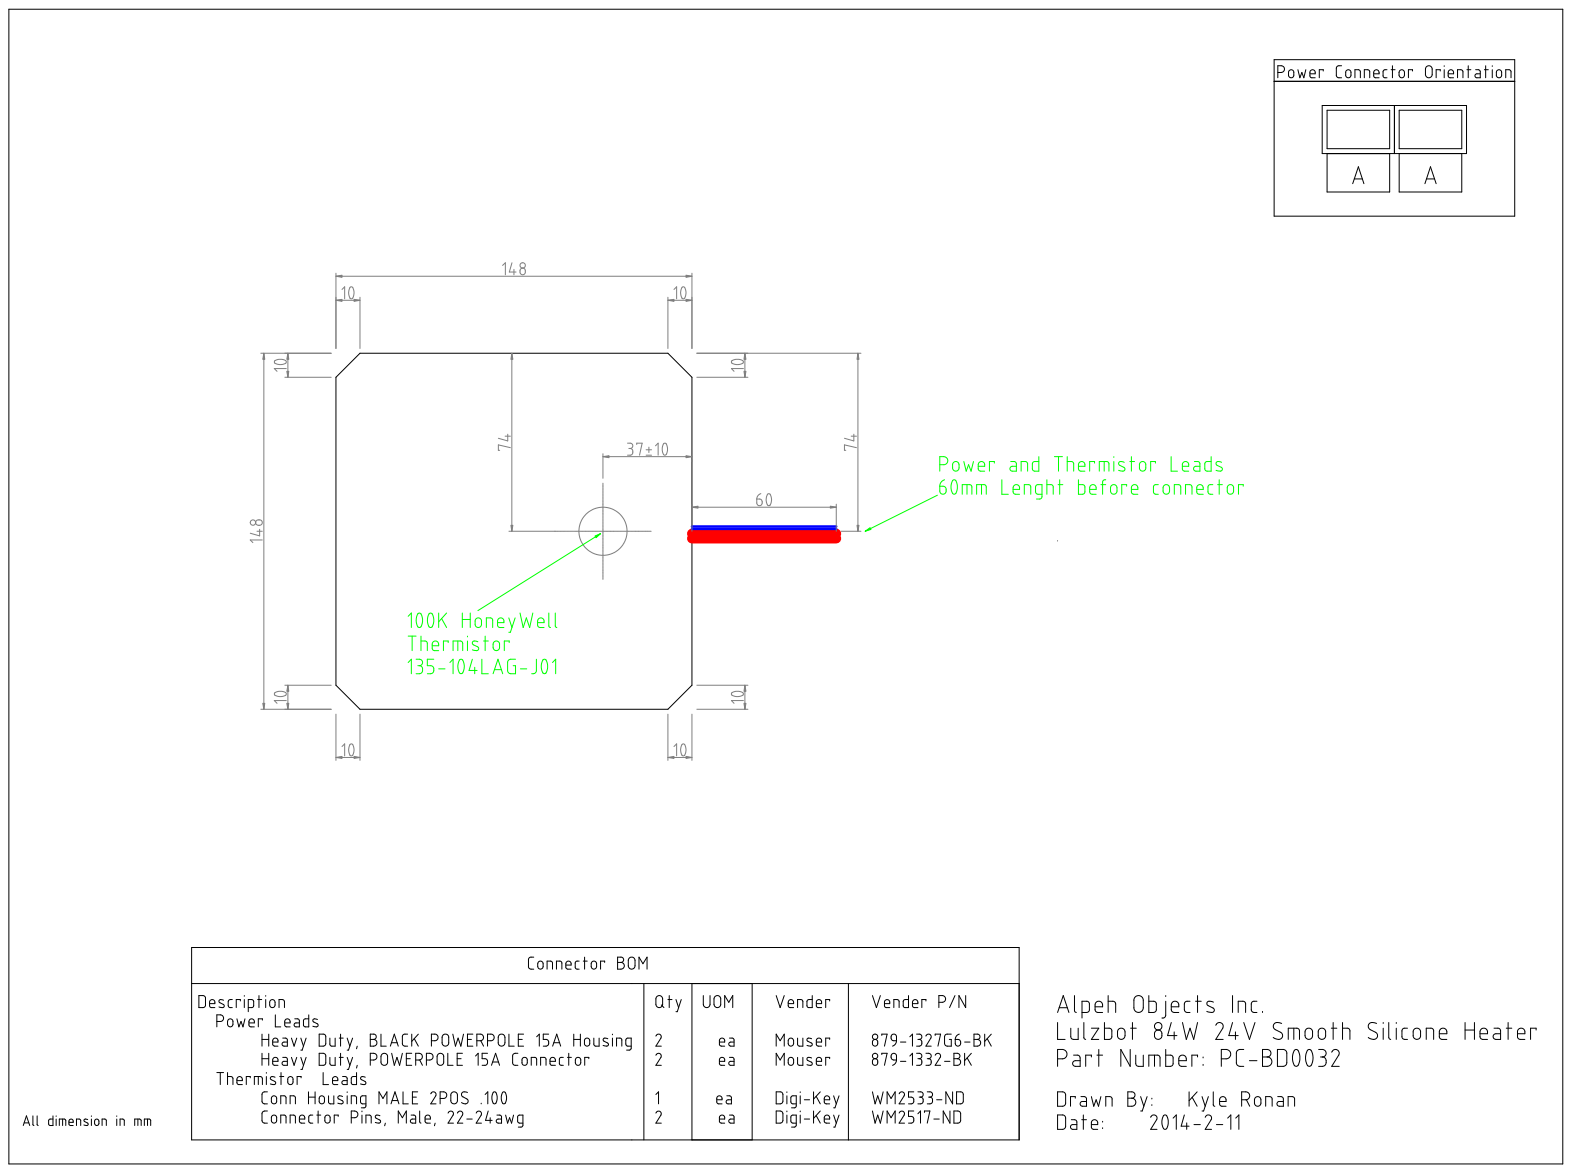
[picture p97: page 1]
