leedshackspace/lulzbot-mini/parts/machined_parts/8_mm_rod/8x19mm_smooth_rod_revA_page1.pdf

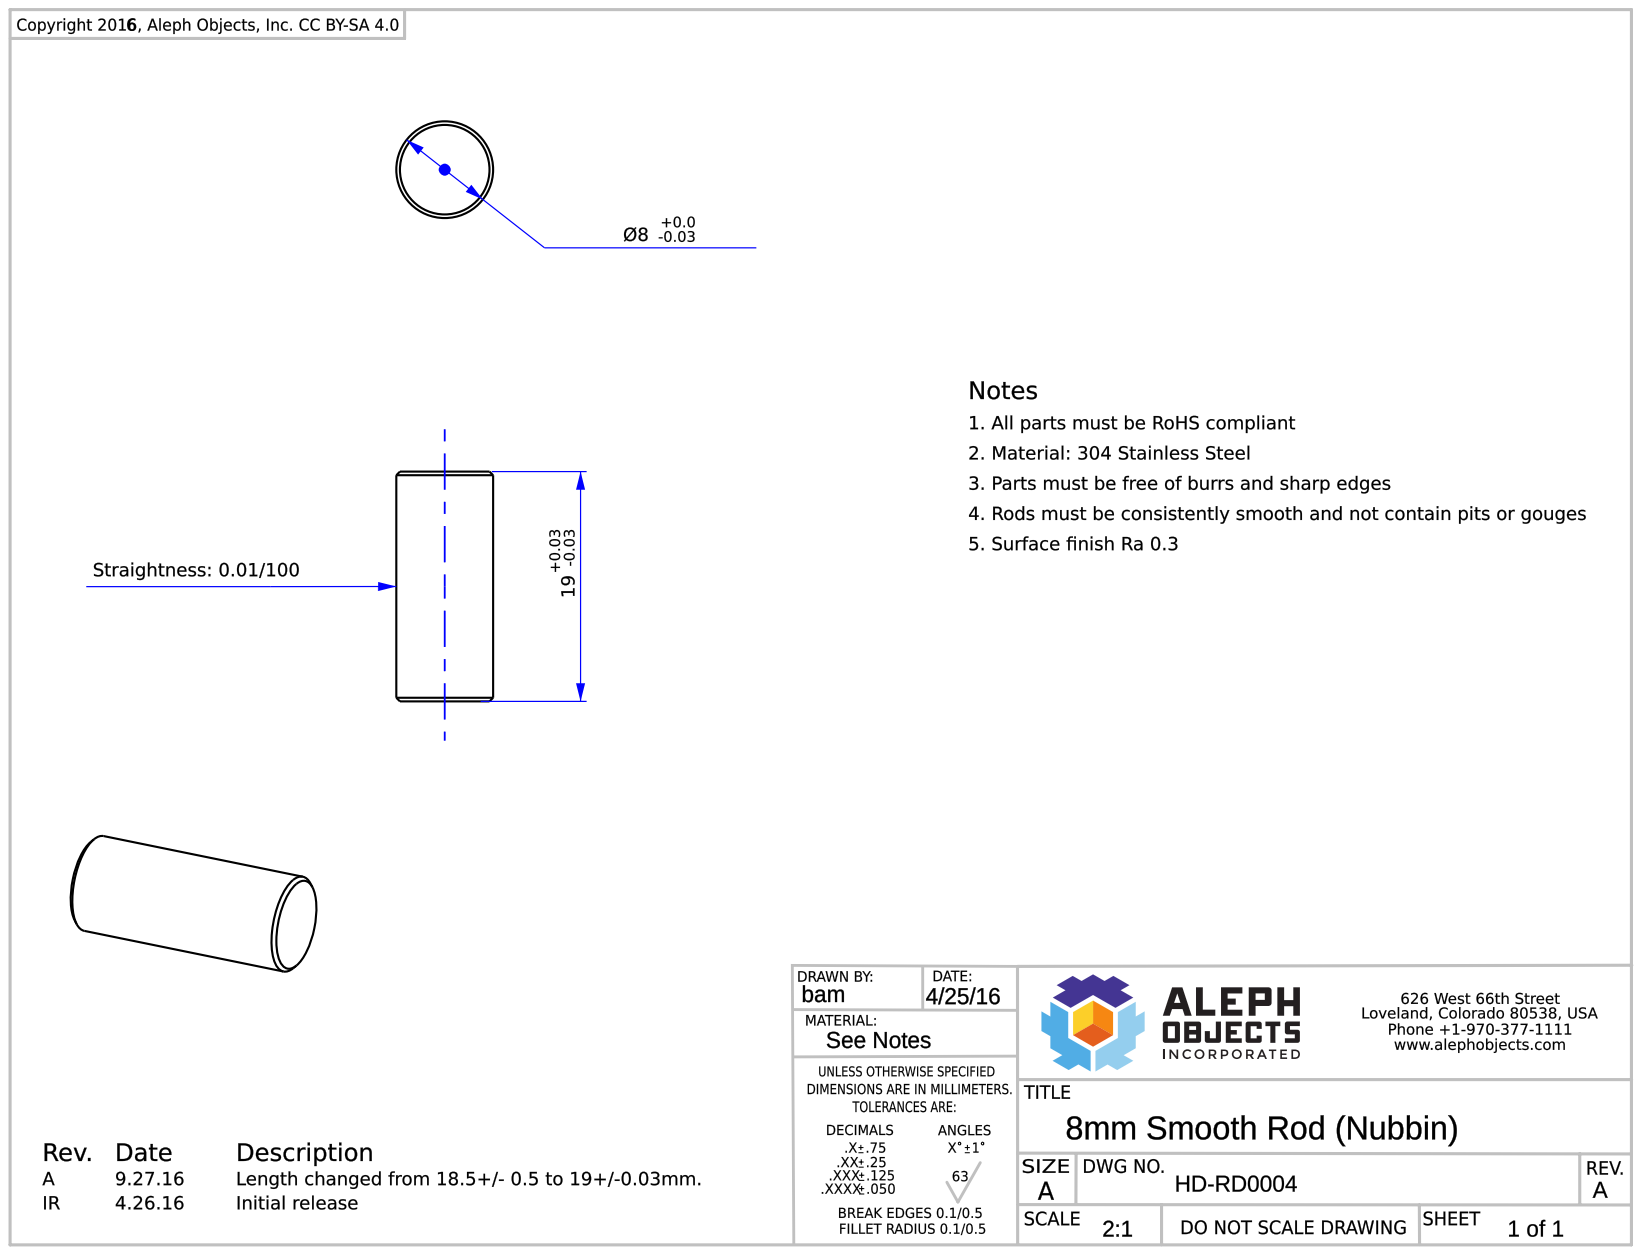
[picture p98: page 1]
