leedshackspace/lulzbot-mini/parts/machined_parts/bed_mount_plate/bed-mount-plate-mini_PP-MP0146_revC_page1.pdf

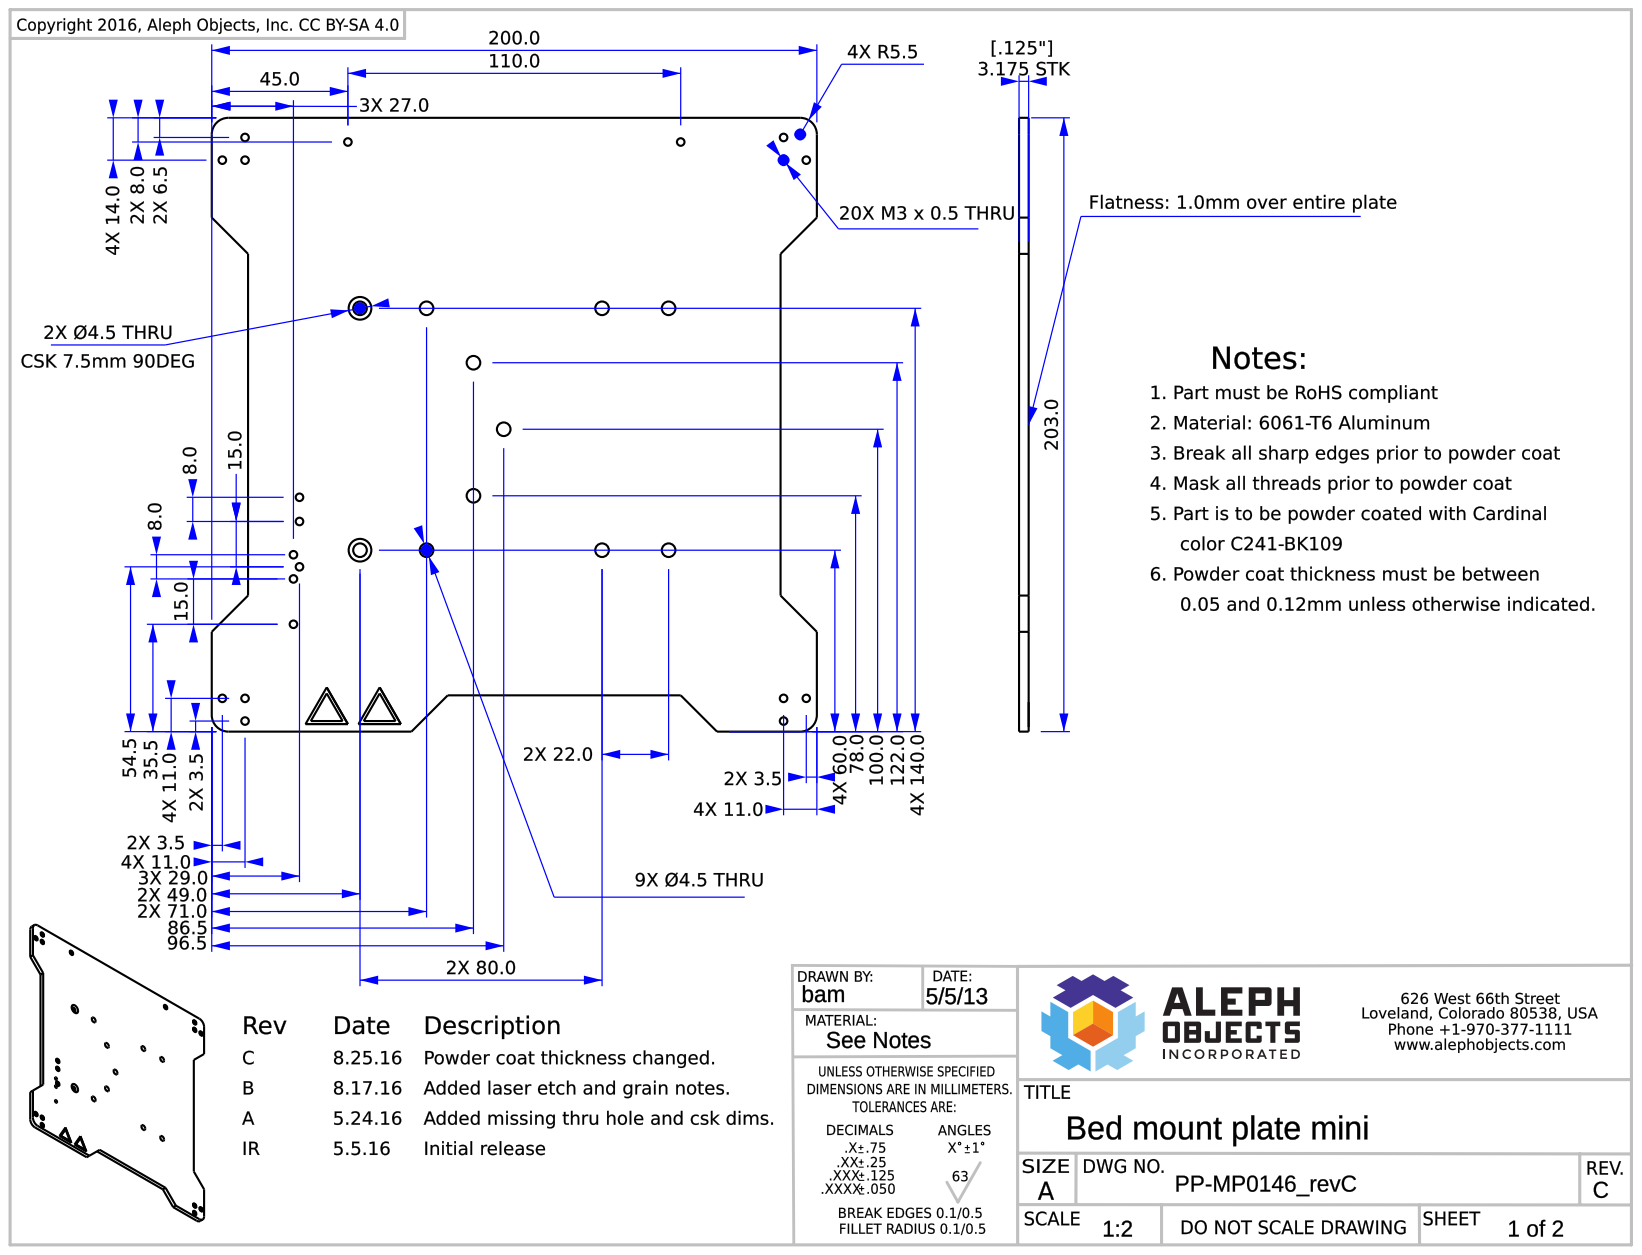
[picture p99: page 1]
