leedshackspace/lulzbot-mini/parts/machined_parts/bed_mount_plate/bed-mount-plate-mini_PP-MP0146_revC_page2.pdf

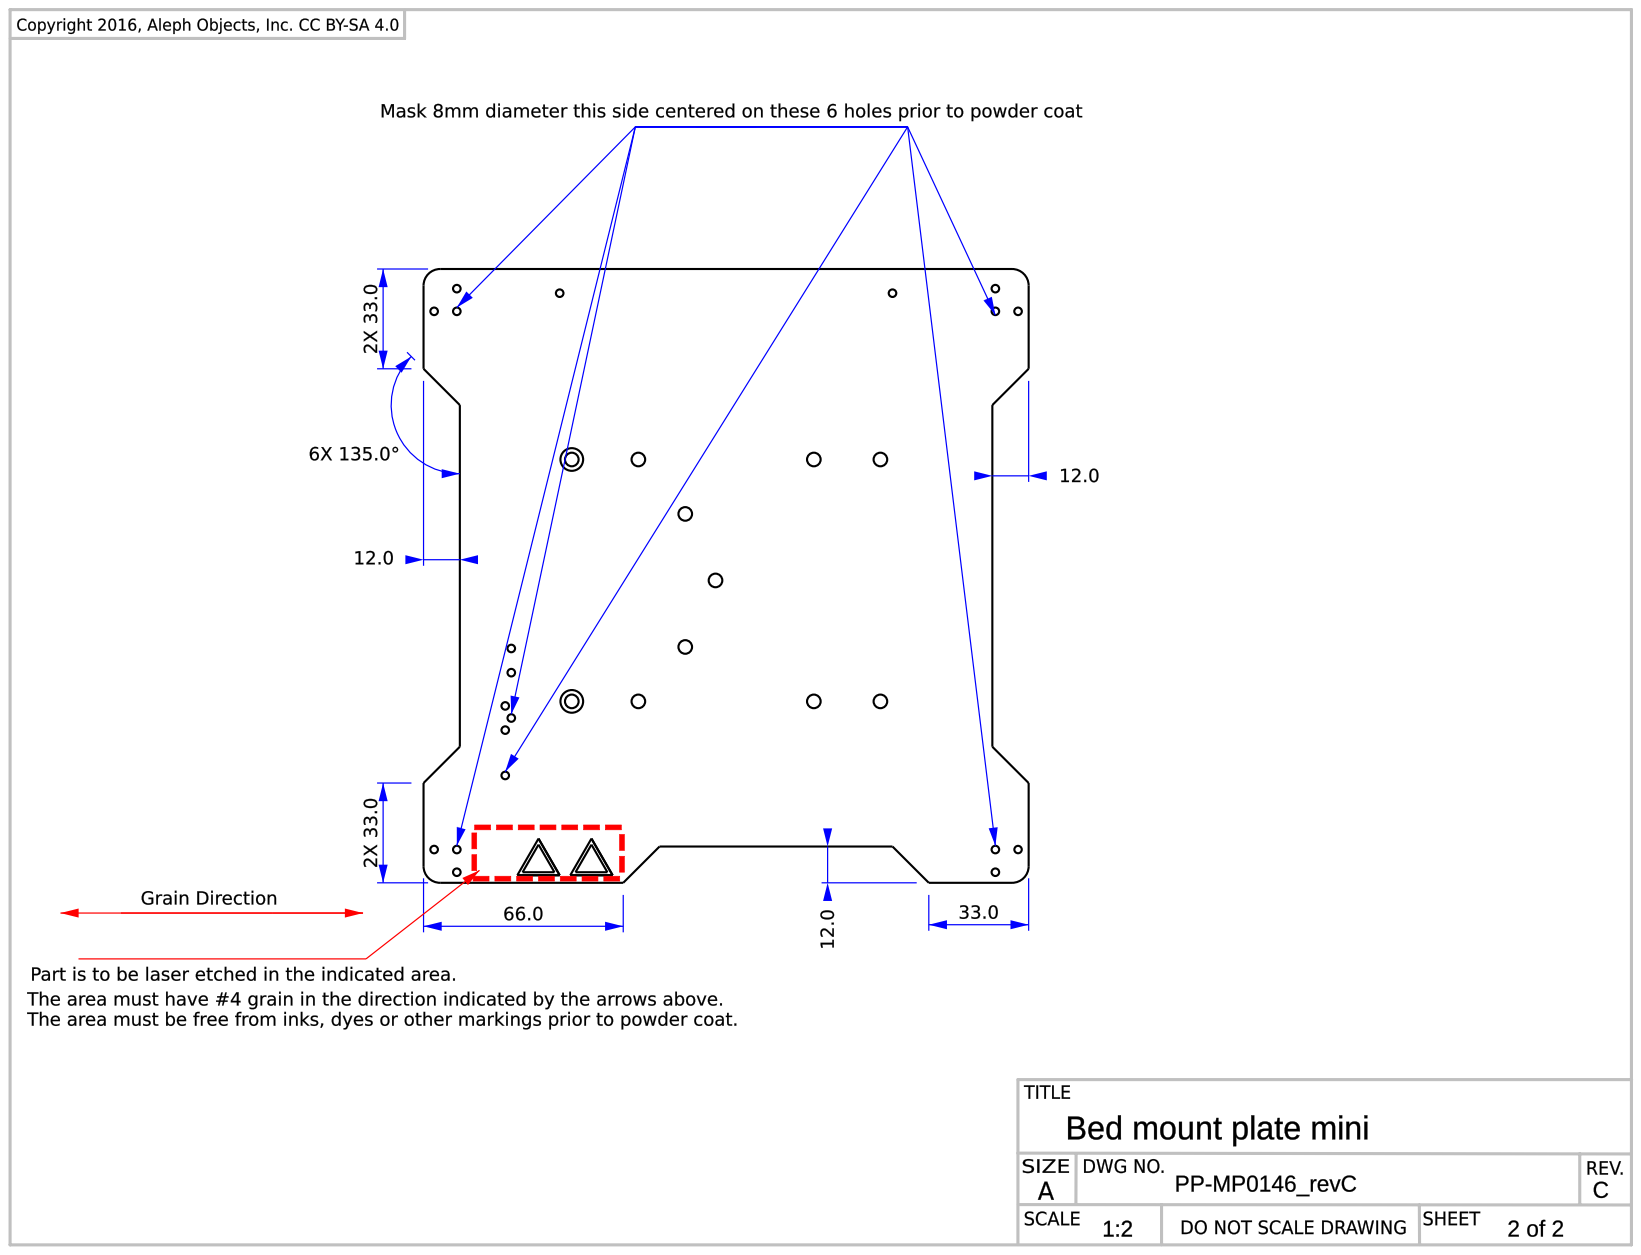
[picture p100: page 1]
