leedshackspace/lulzbot-mini/parts/machined_parts/bottom_plate_mini/bottom-plate-mini_PP-MP0149_revB_page1.pdf

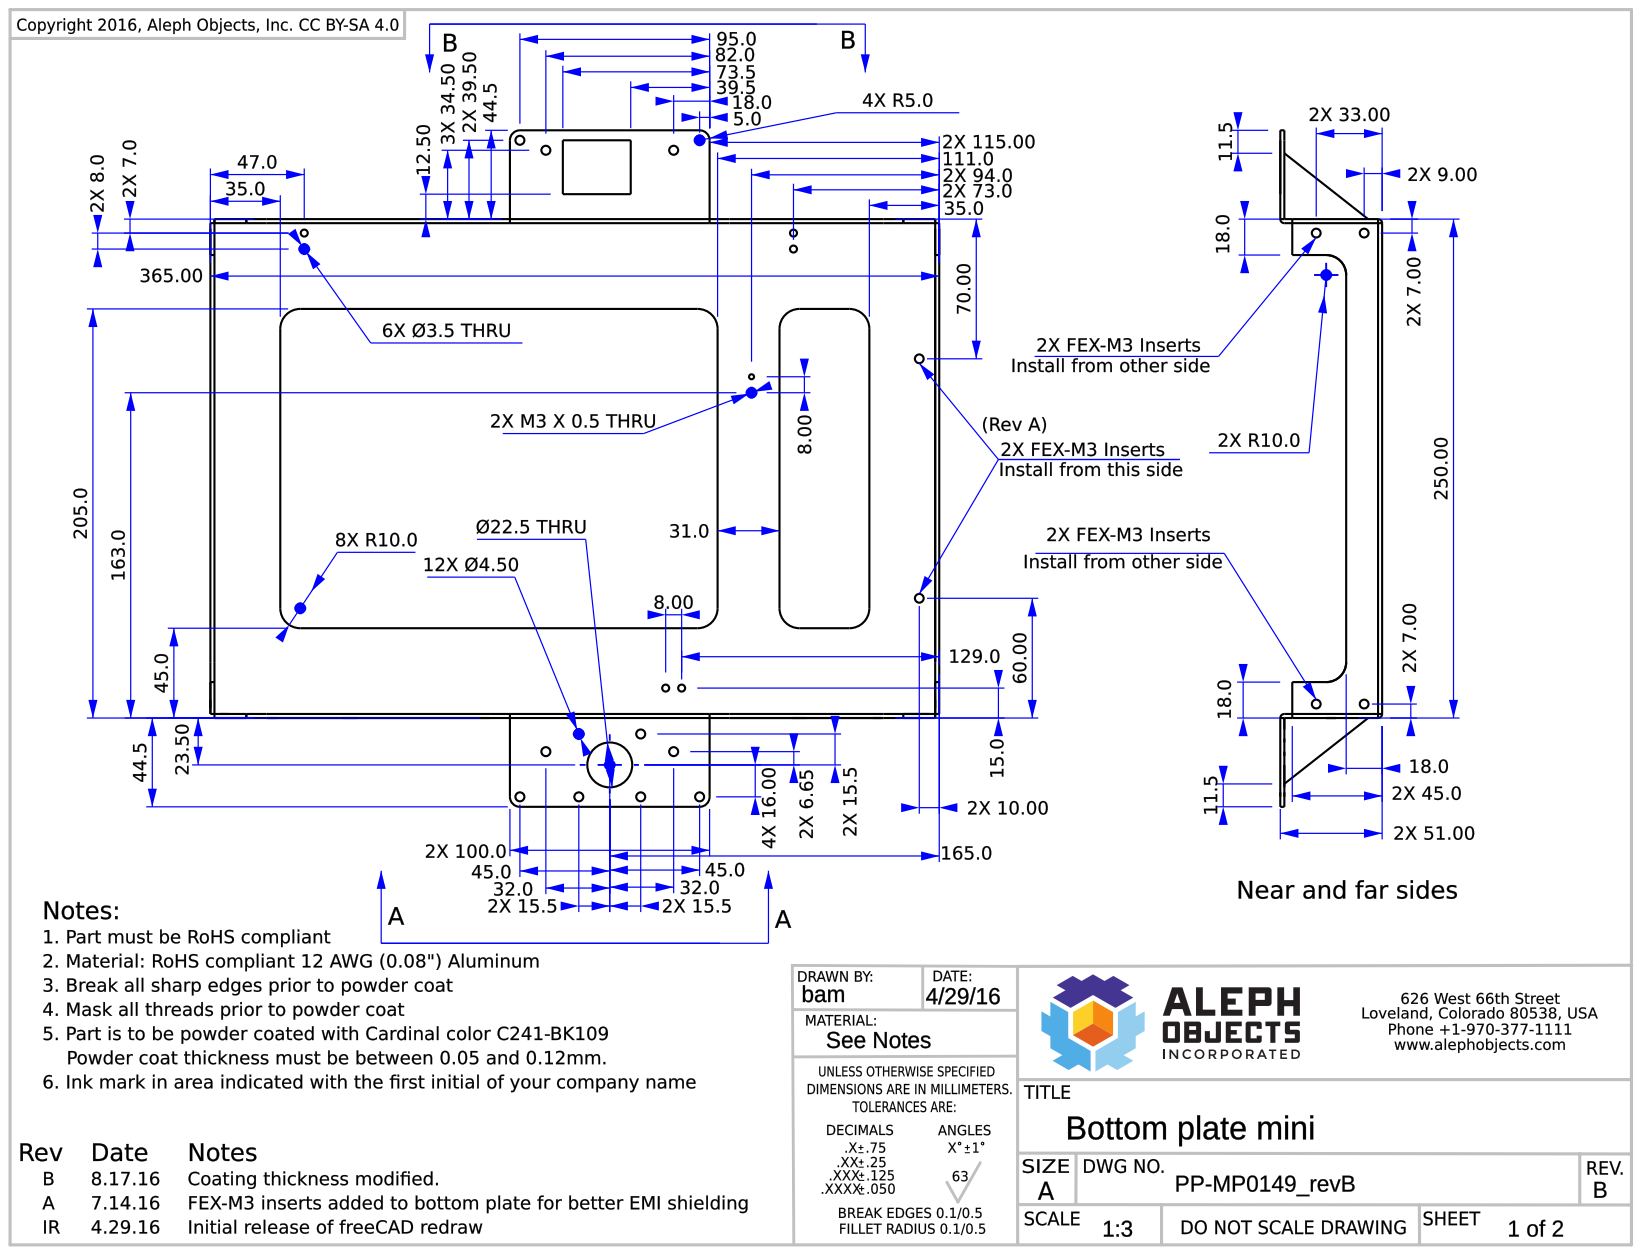
[picture p101: page 1]
