leedshackspace/lulzbot-mini/parts/machined_parts/bottom_plate_mini/bottom-plate-mini_PP-MP0149_revB_page2.pdf

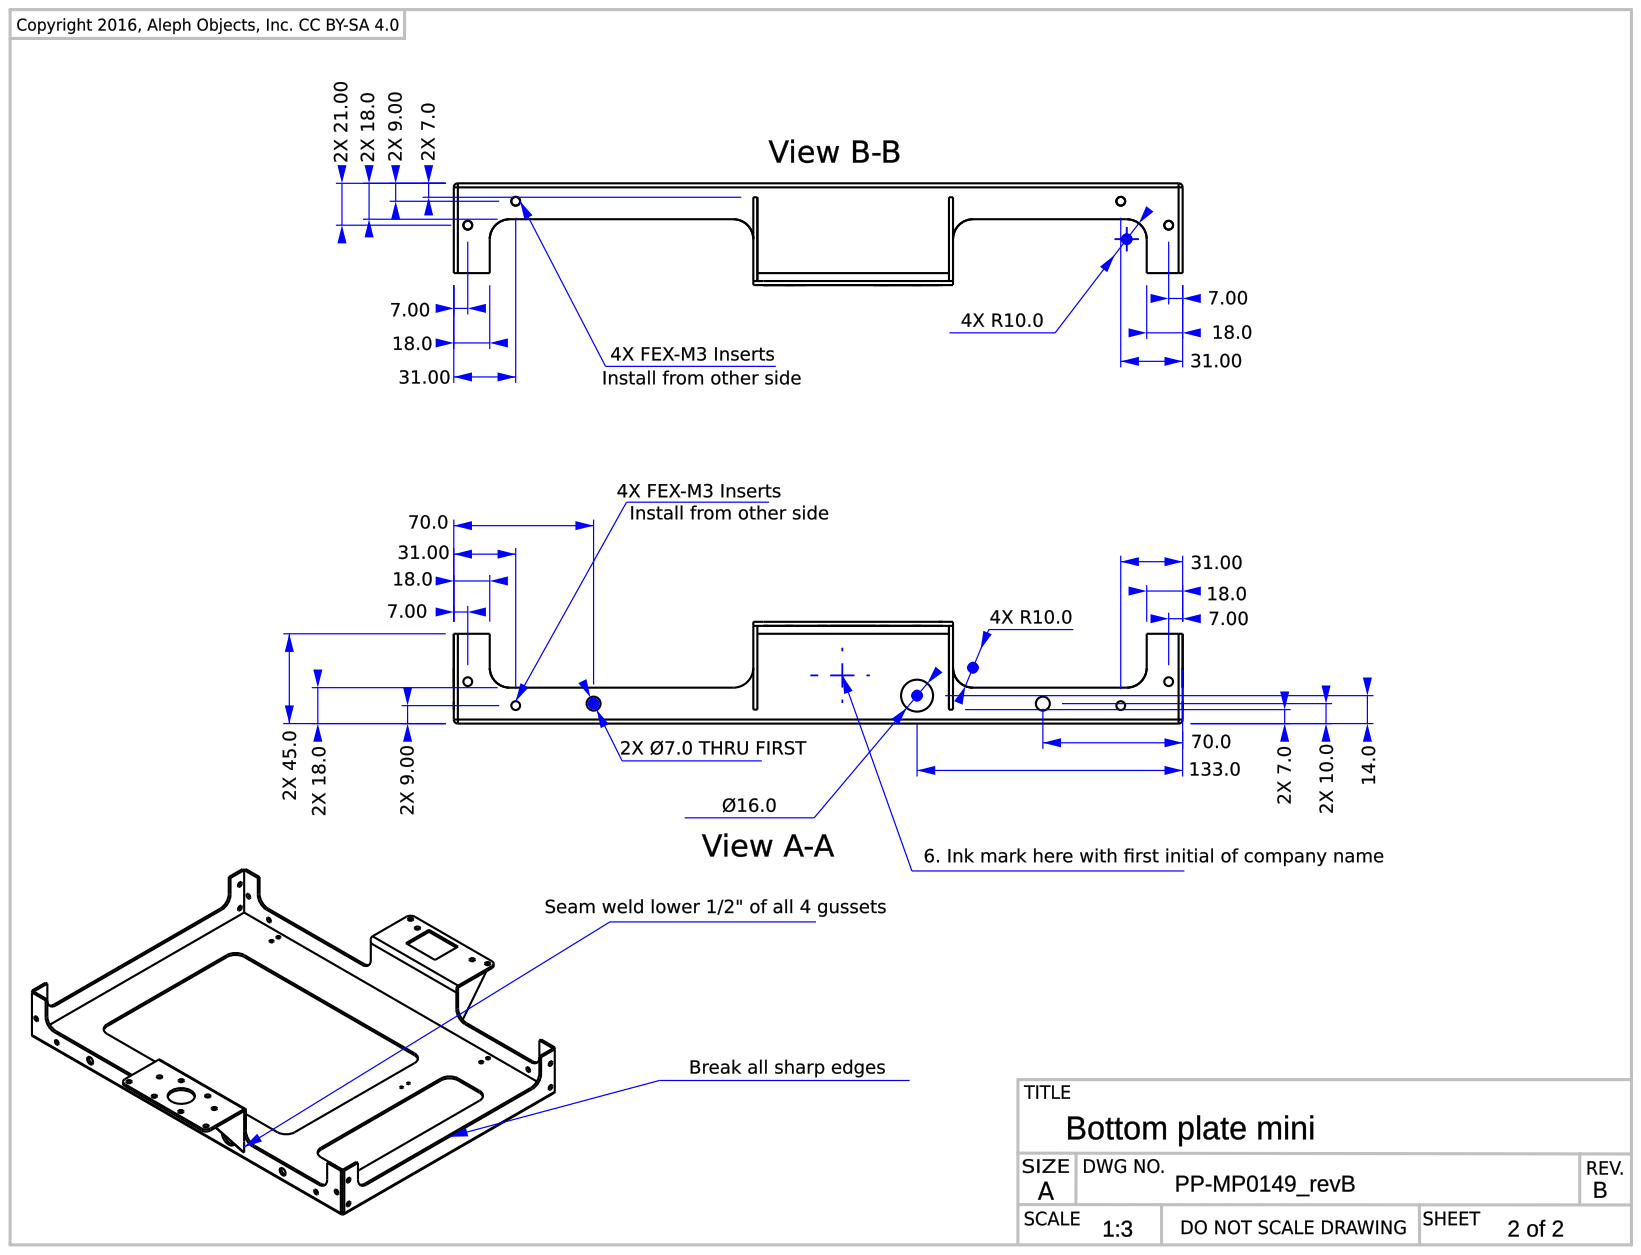
[picture p102: page 1]
