leedshackspace/lulzbot-mini/parts/machined_parts/bottom_plate_mini/bottom-plate-mini_PP-MP0149_revE.pdf

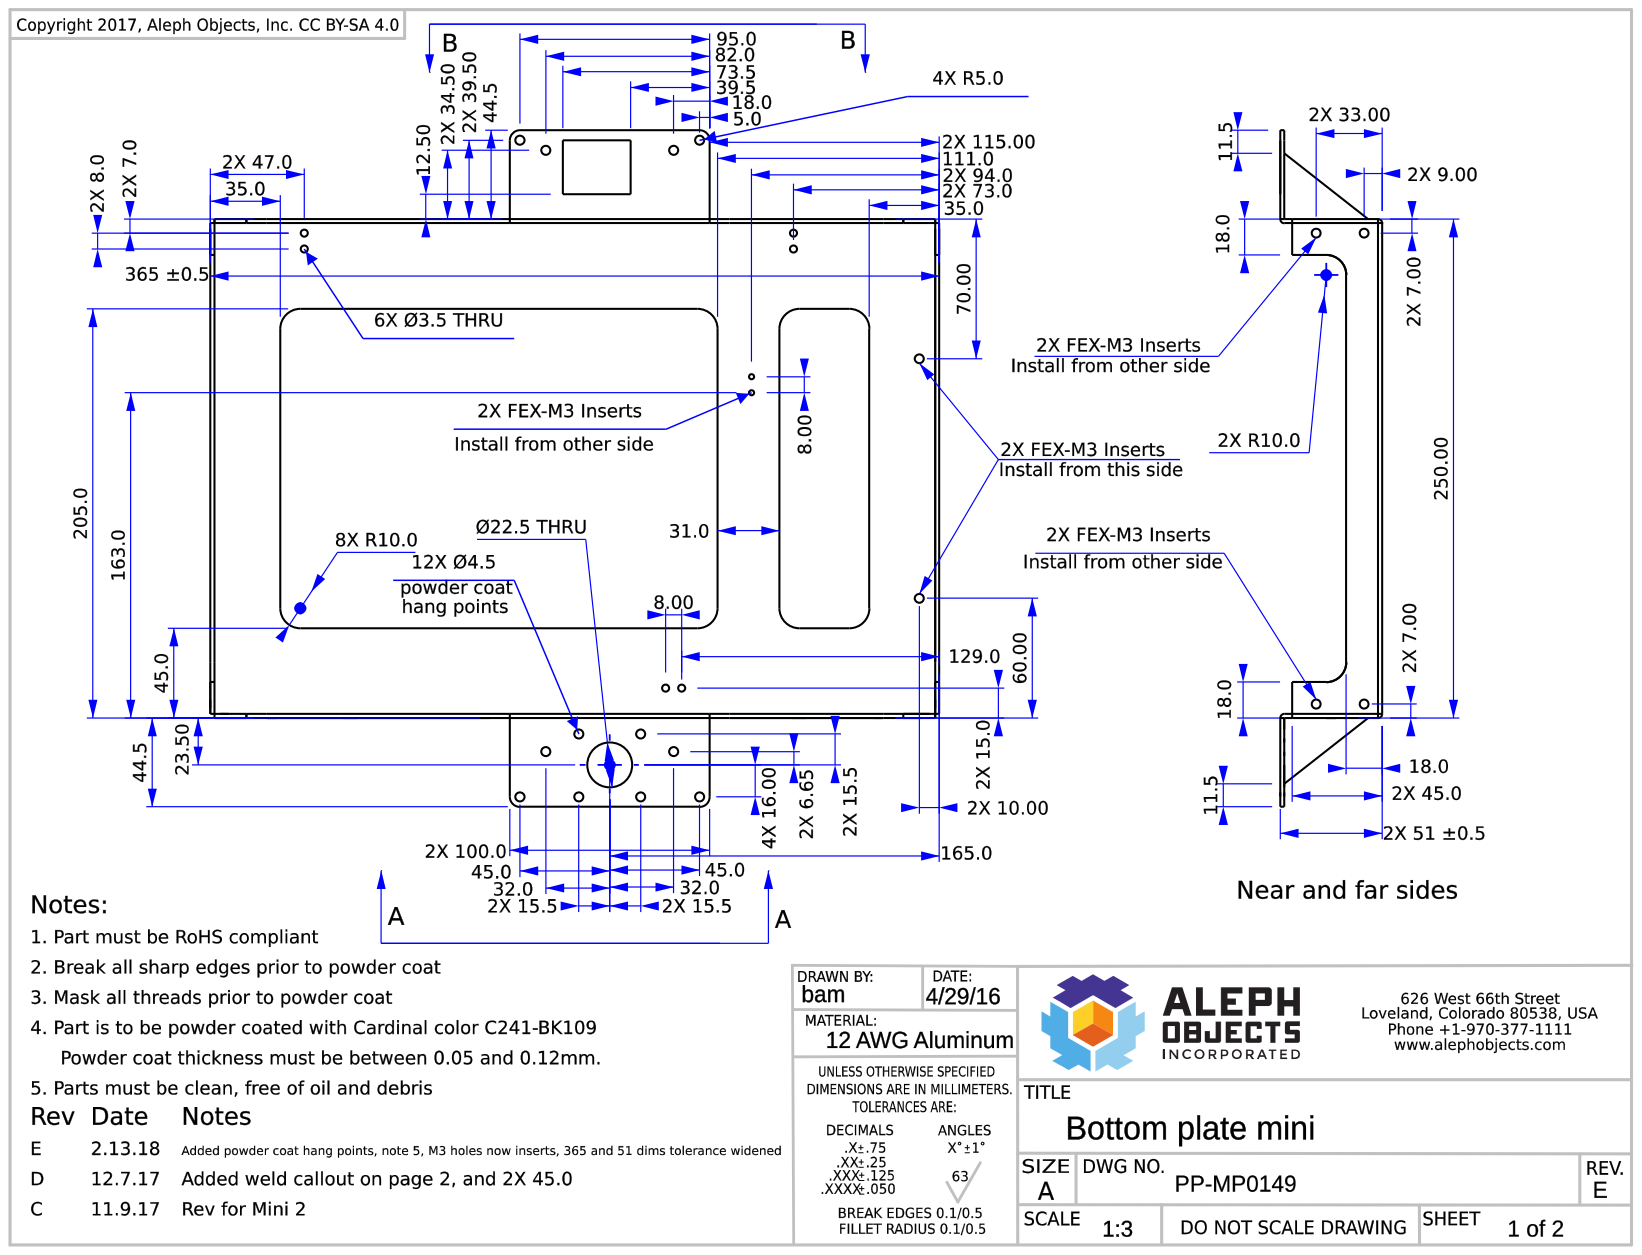
[picture p103: page 1]

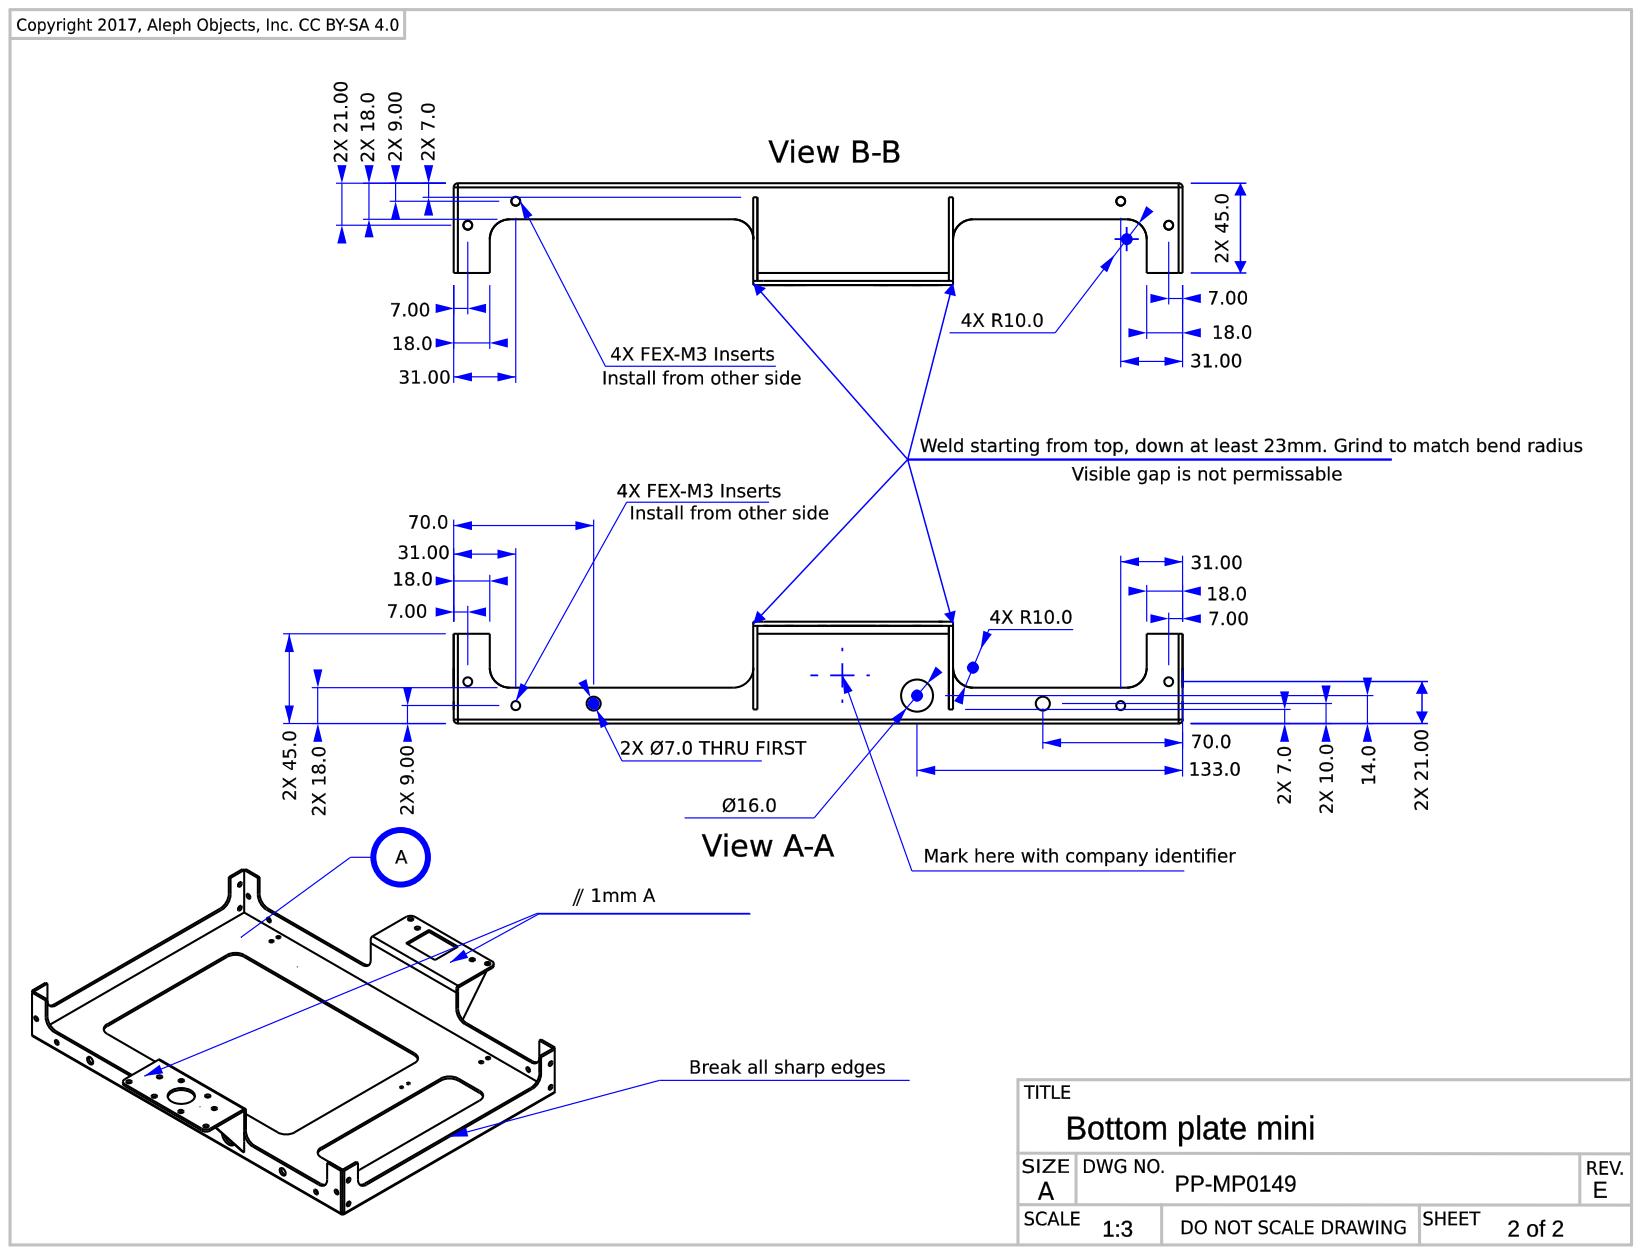
[picture p104: page 2]
