leedshackspace/lulzbot-mini/parts/machined_parts/drive_rods/drive_rod_10mm_mini_HD-RD0037.pdf

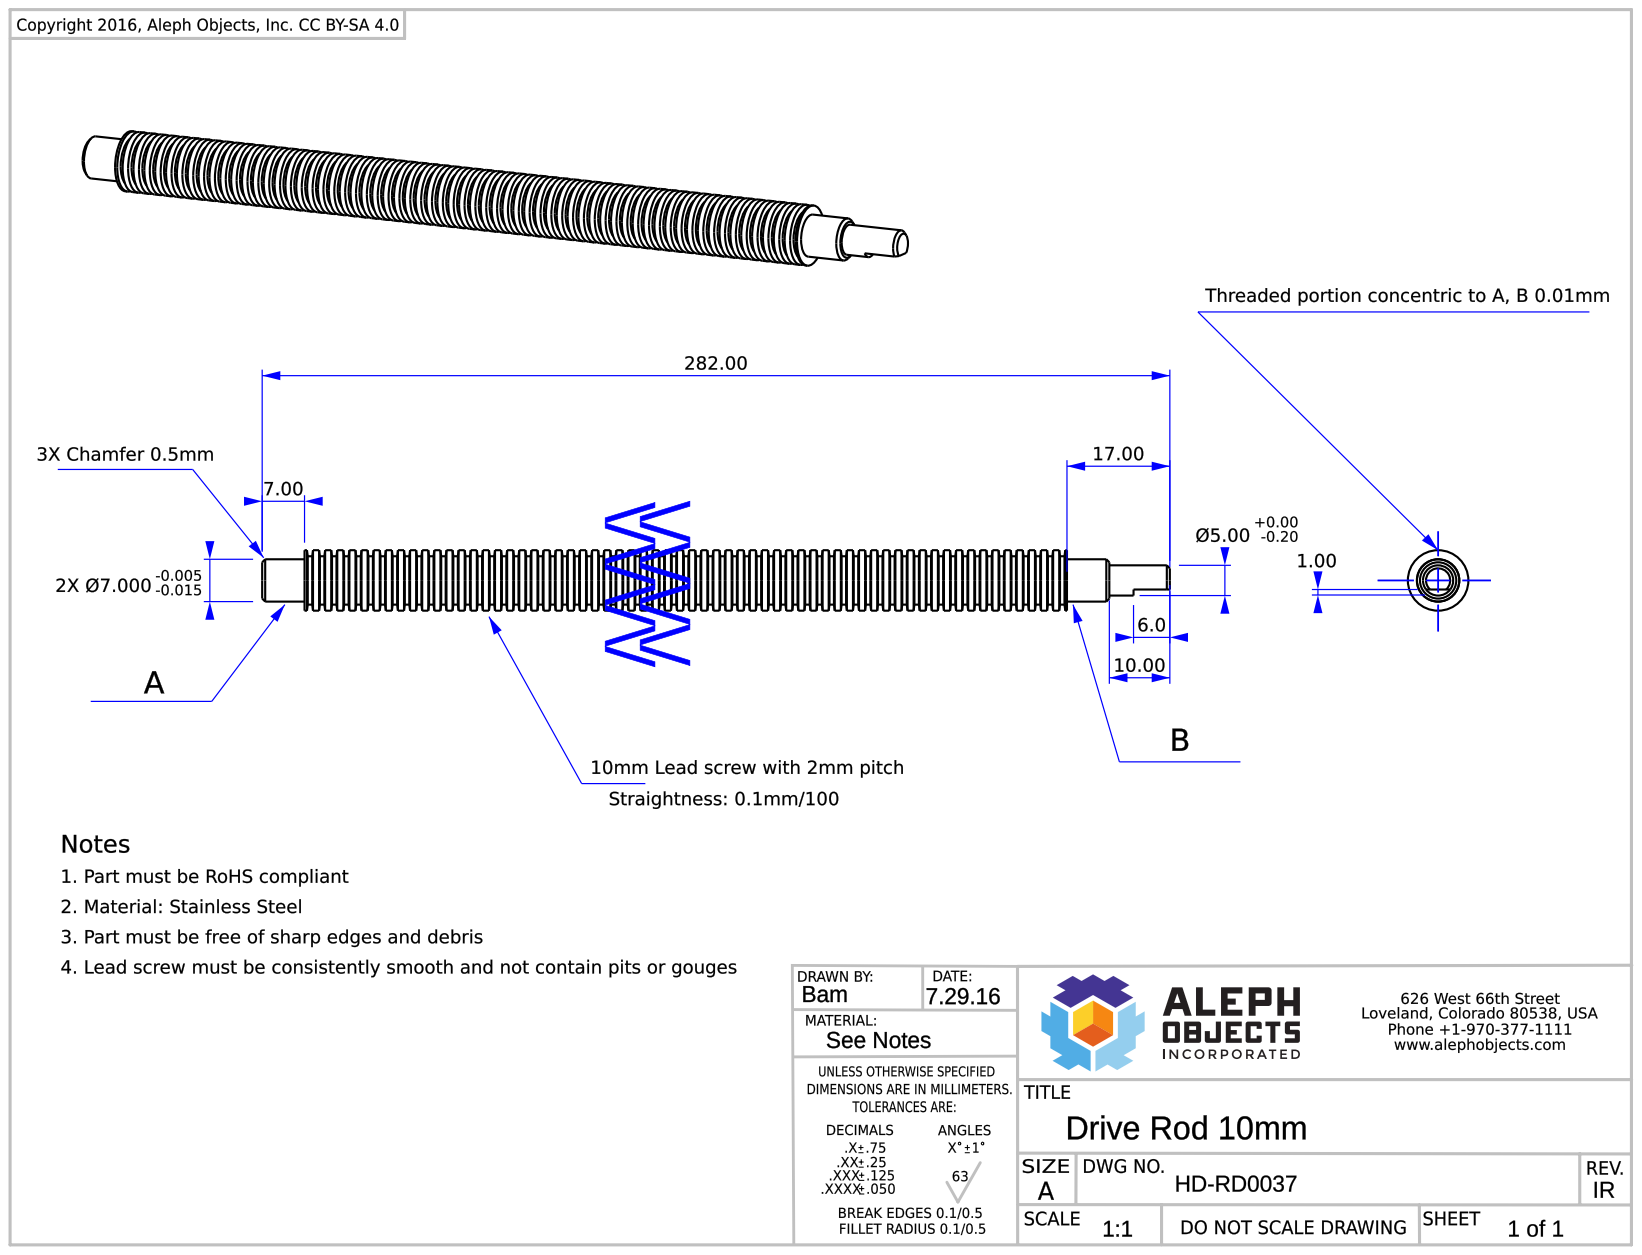
[picture p105: page 1]
