leedshackspace/lulzbot-mini/parts/machined_parts/electronics_case/electronics-case-mini_PP-FP0082_revG_page1.pdf

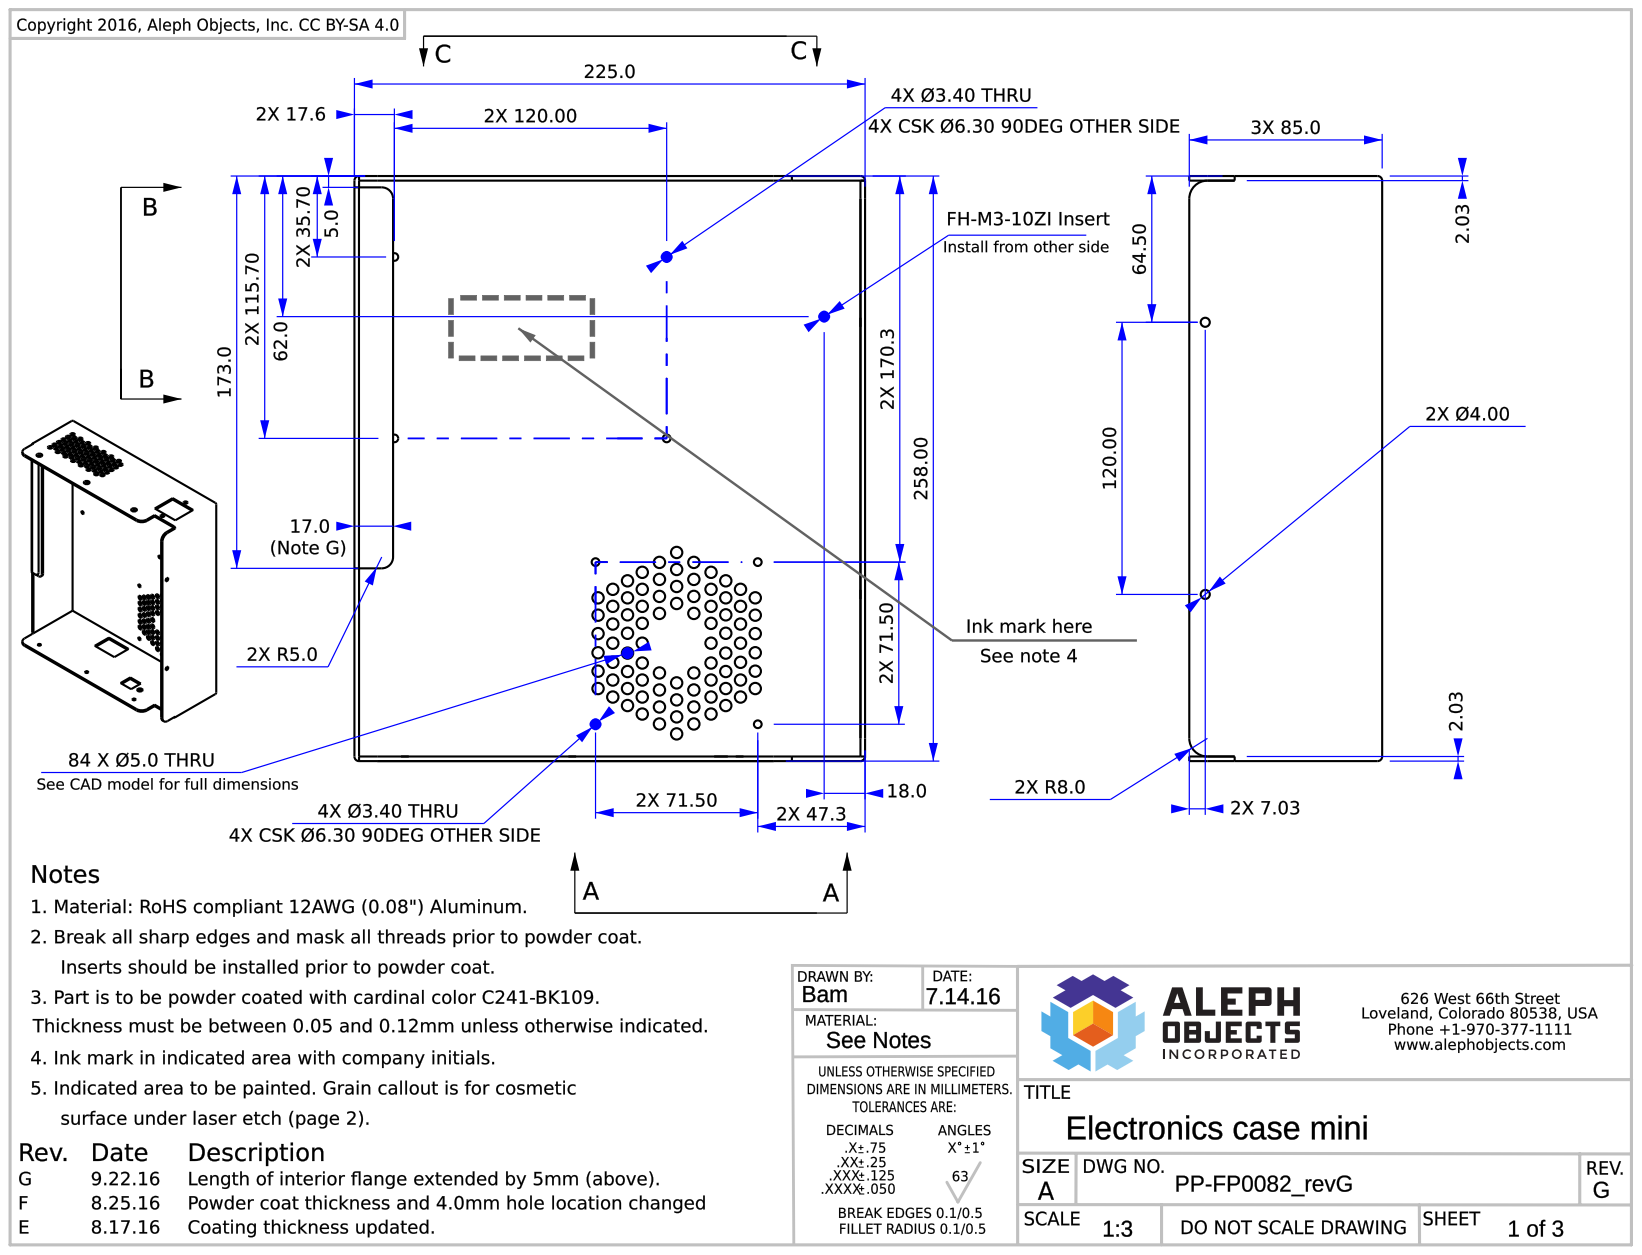
[picture p106: page 1]
