leedshackspace/lulzbot-mini/parts/machined_parts/electronics_case/electronics-case-mini_PP-FP0082_revG_page2.pdf

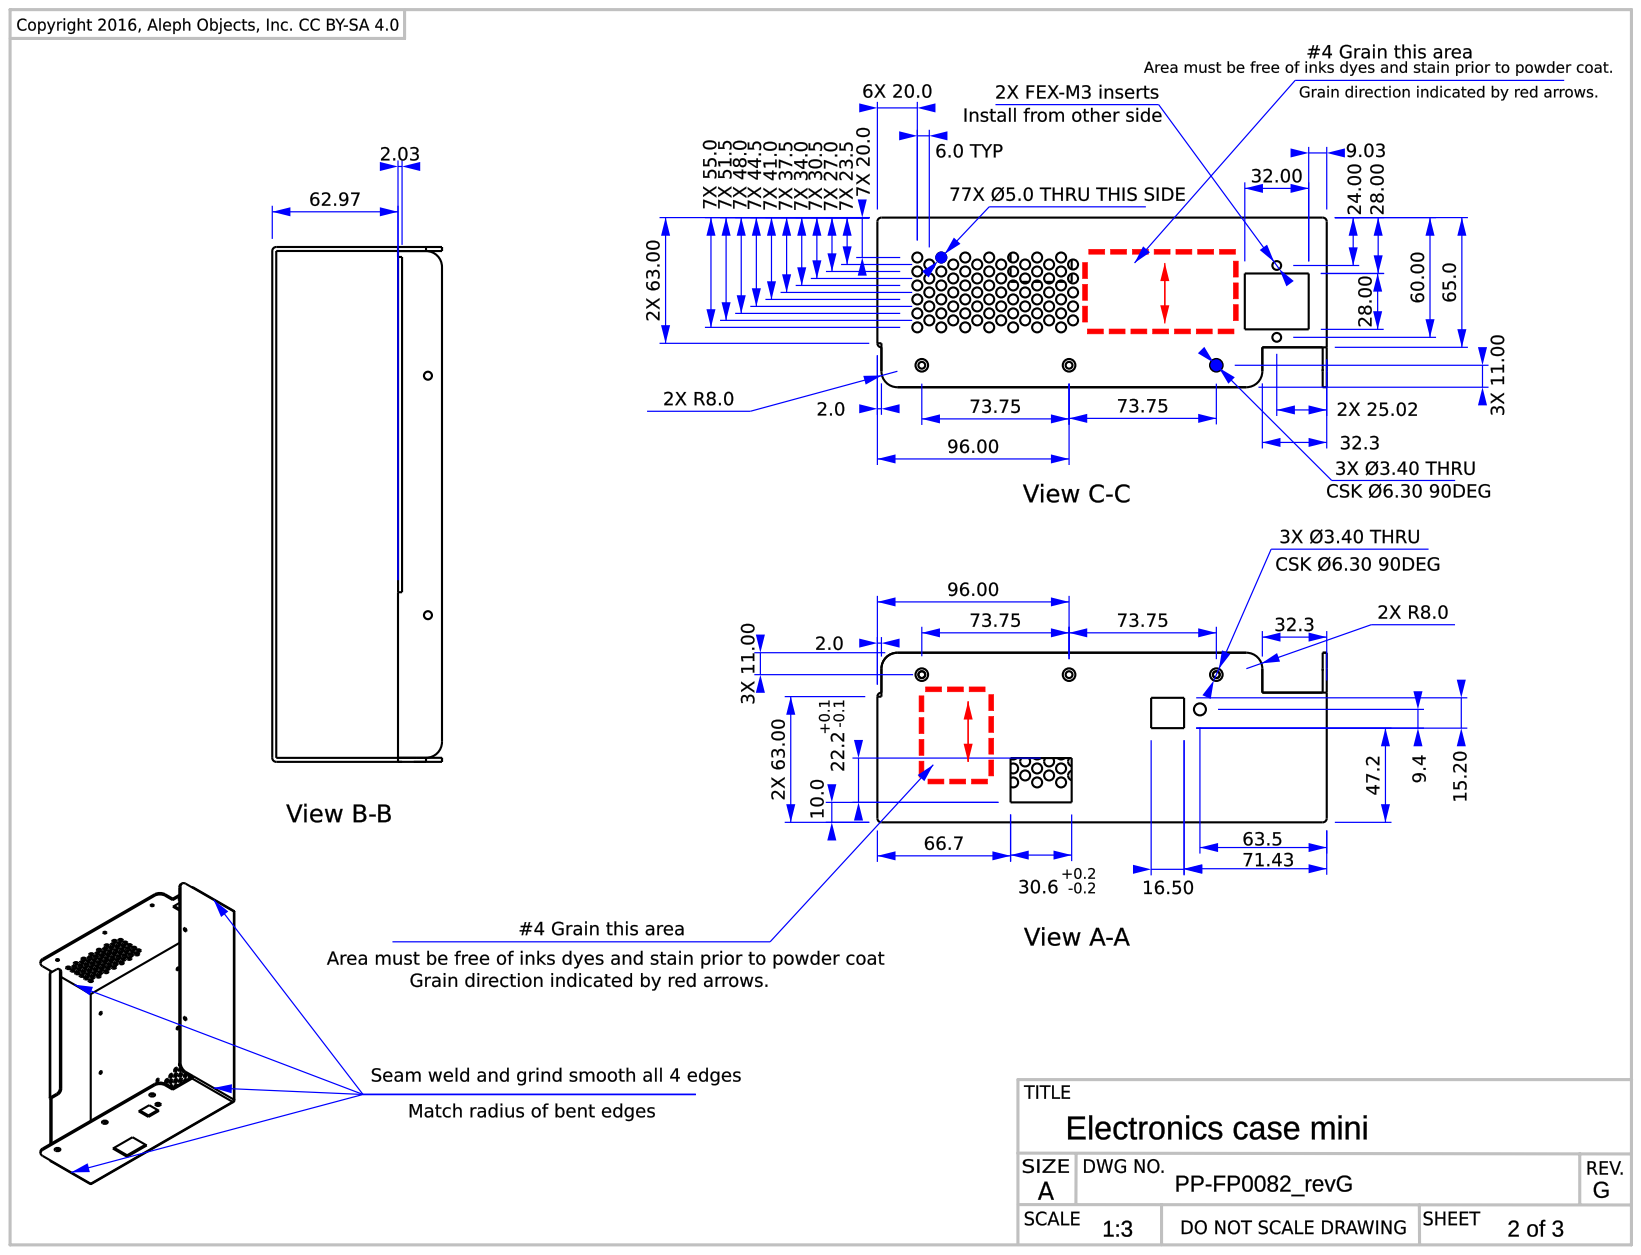
[picture p107: page 1]
