leedshackspace/lulzbot-mini/parts/machined_parts/electronics_case/electronics-case-mini_PP-FP0082_revG_page3.pdf

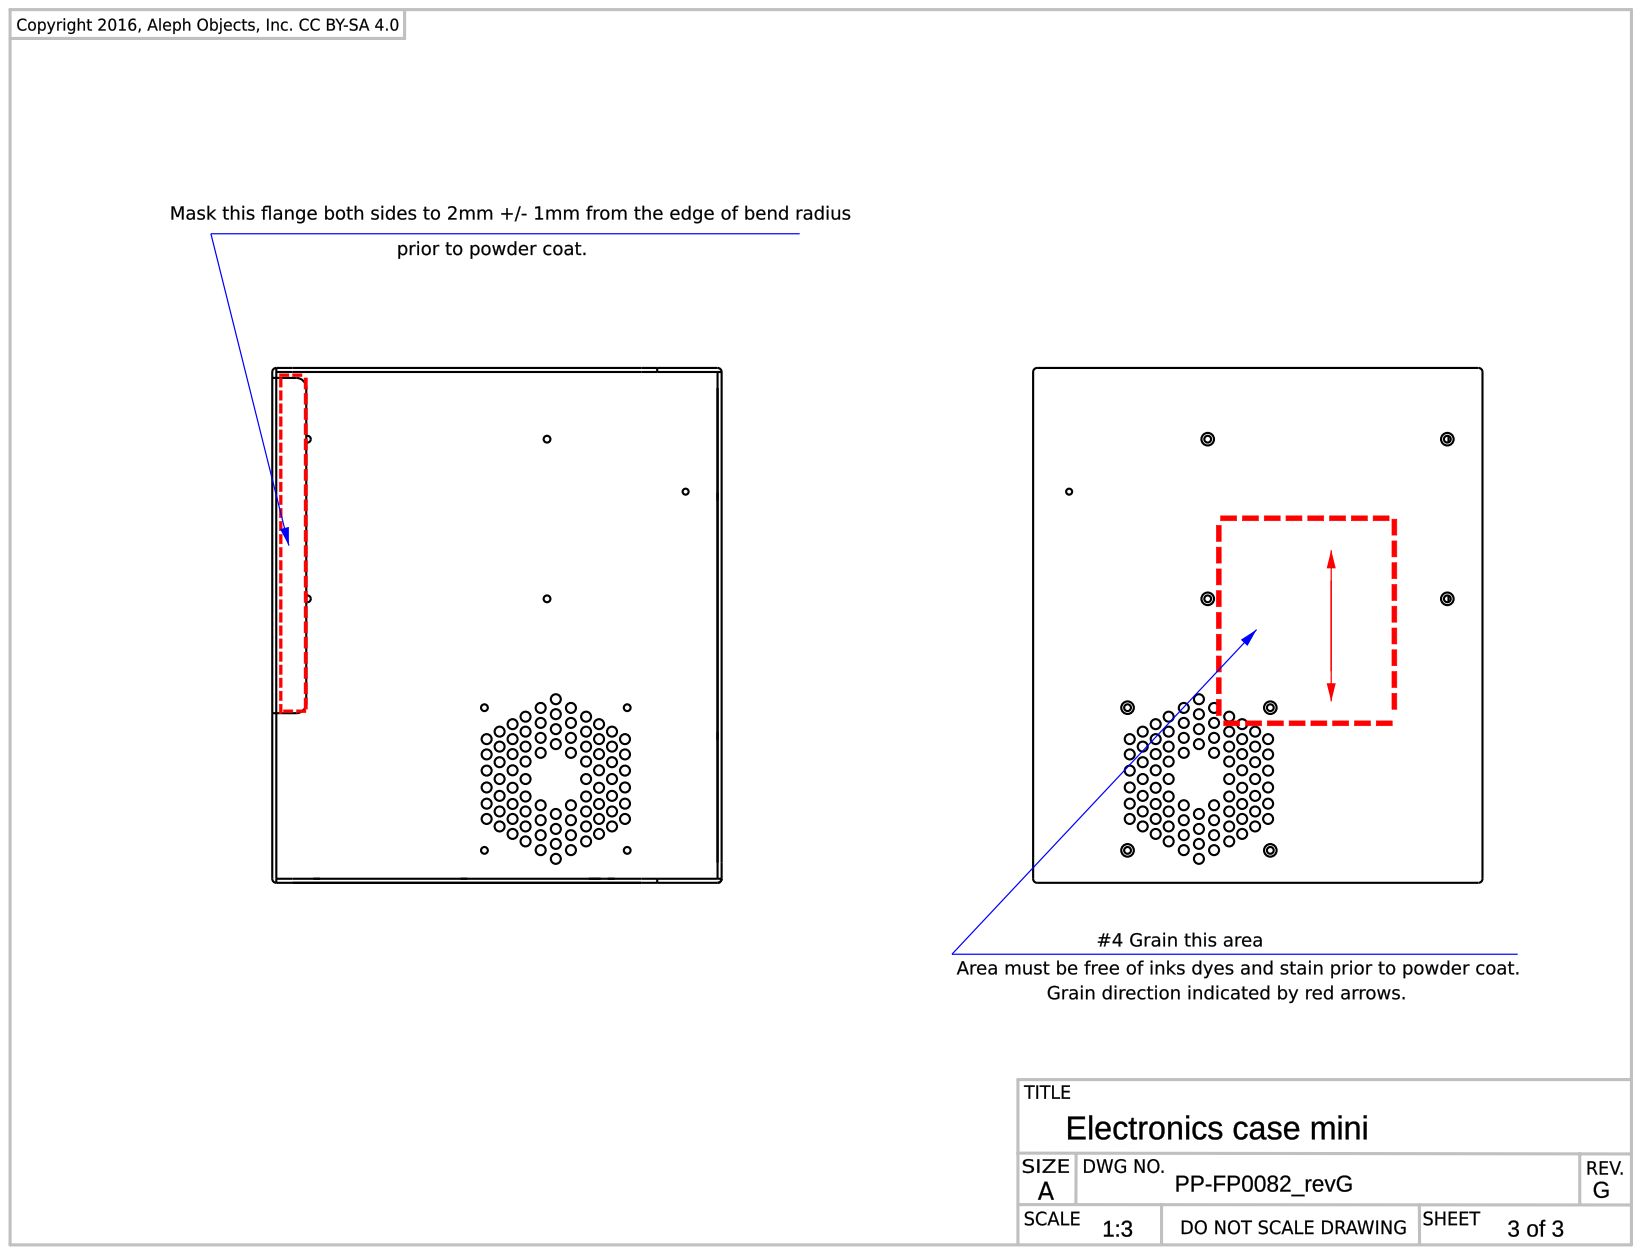
[picture p108: page 1]
