leedshackspace/lulzbot-mini/parts/machined_parts/electronics_case/electronics-case-mini_PP-FP0139_revJ.pdf

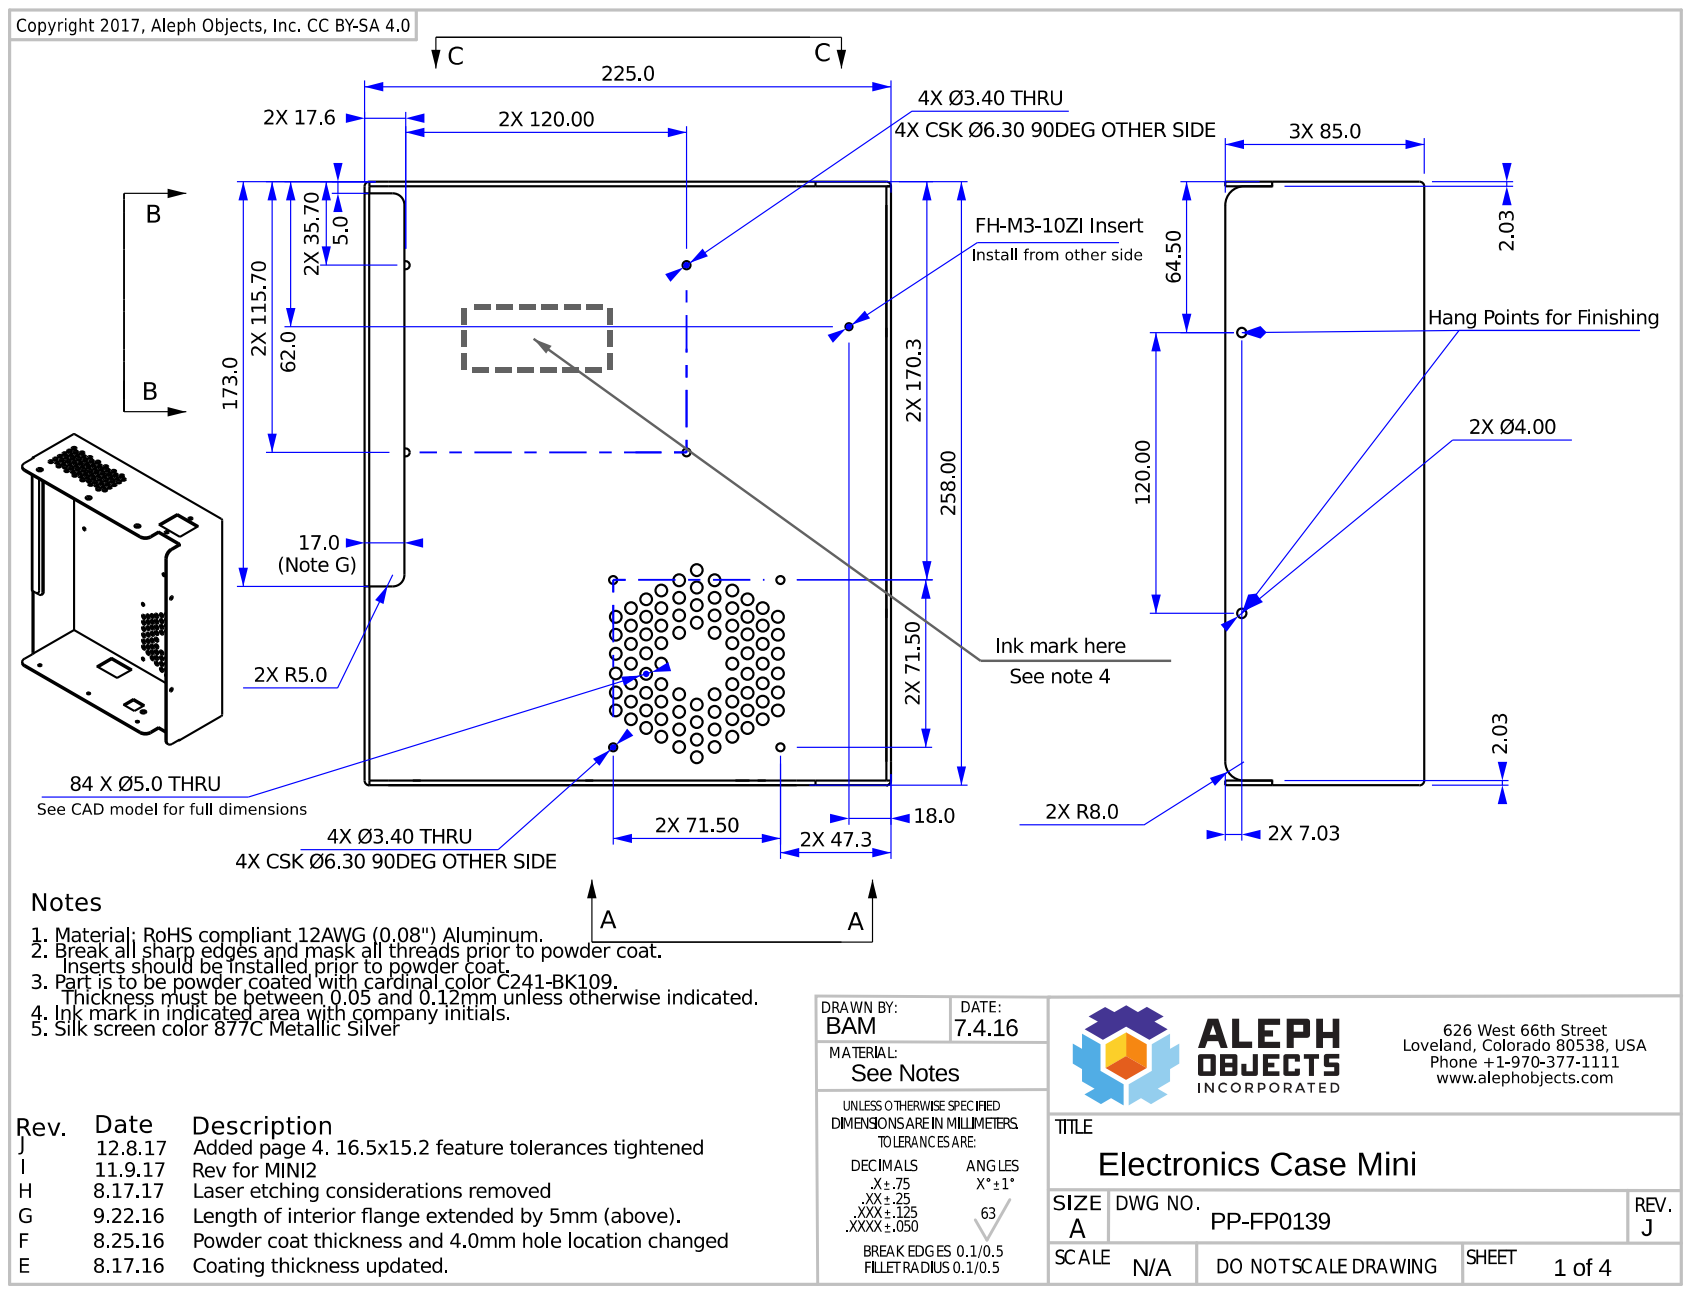
[picture p109: page 1]

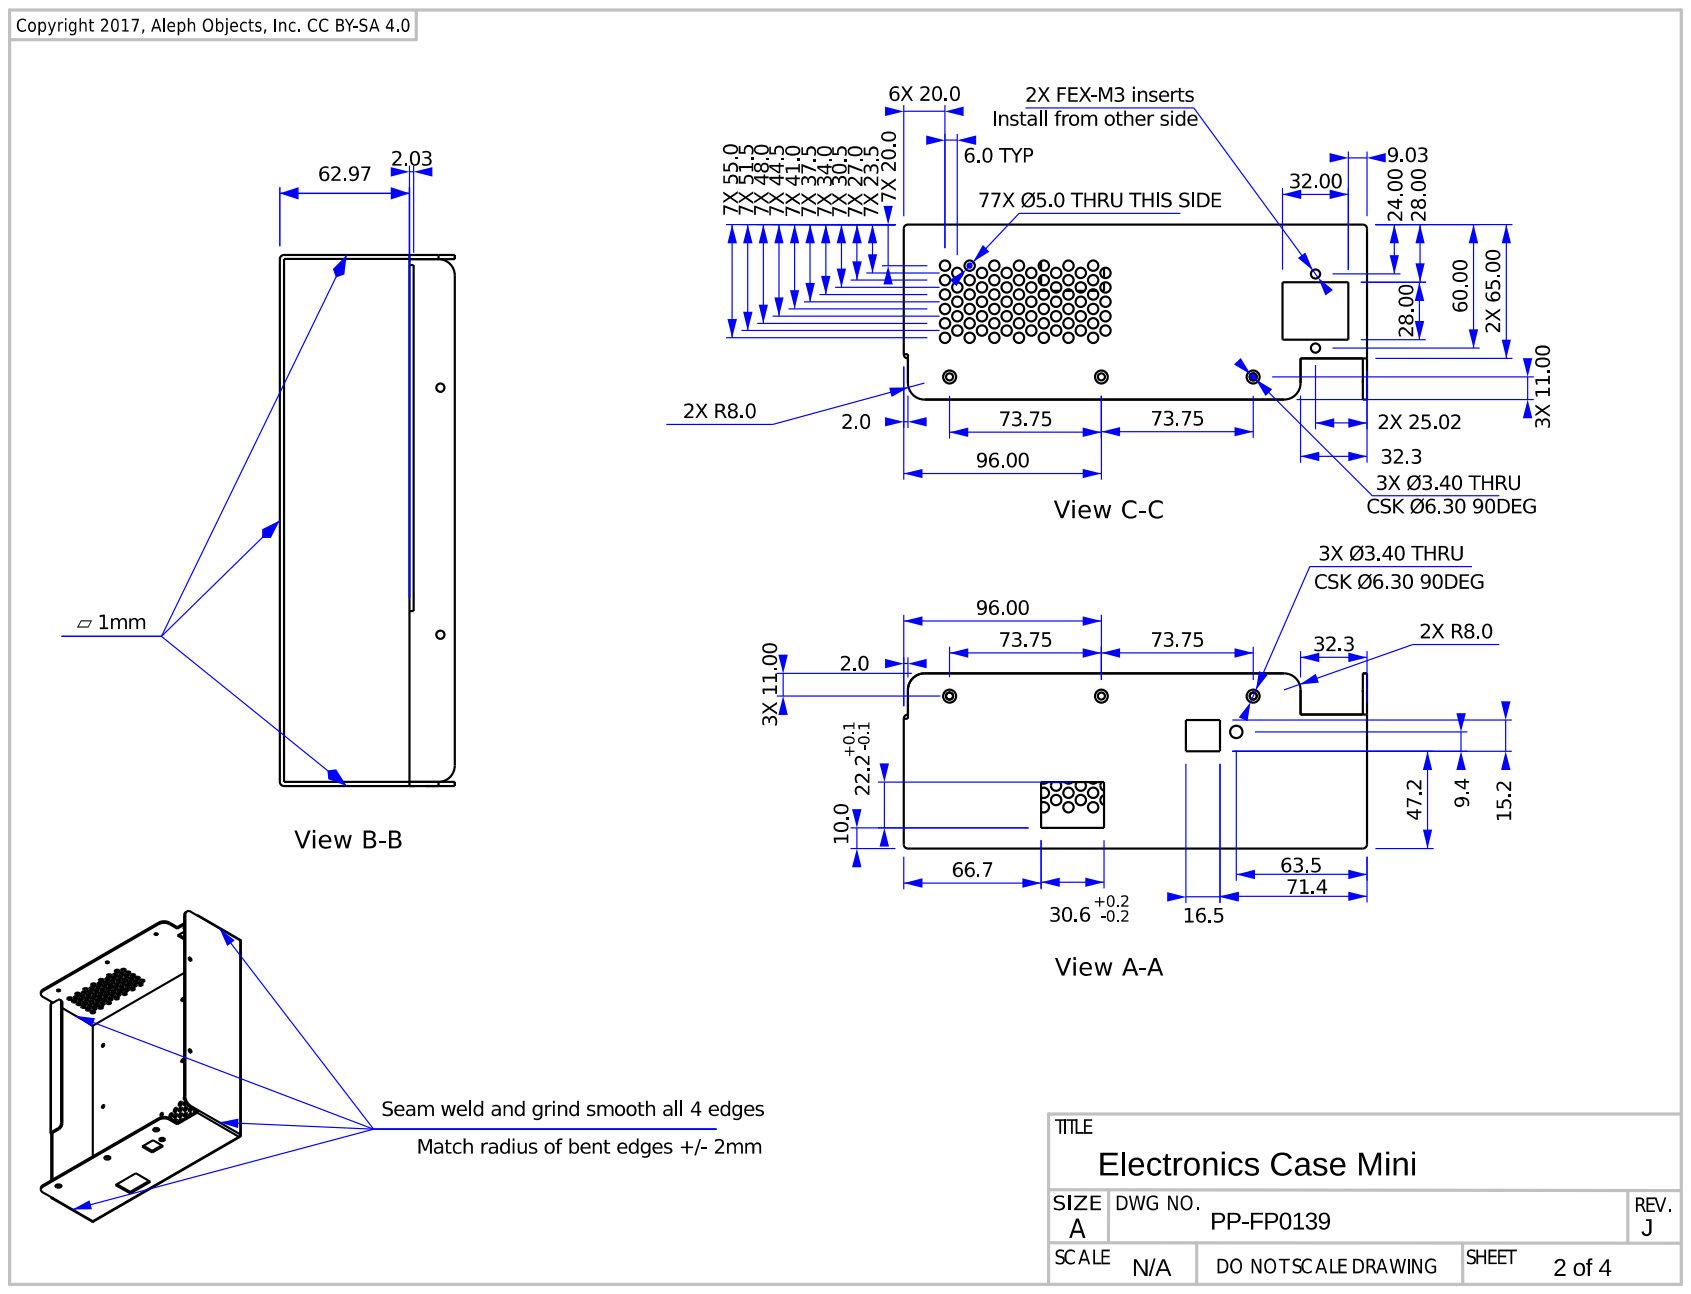
[picture p110: page 2]

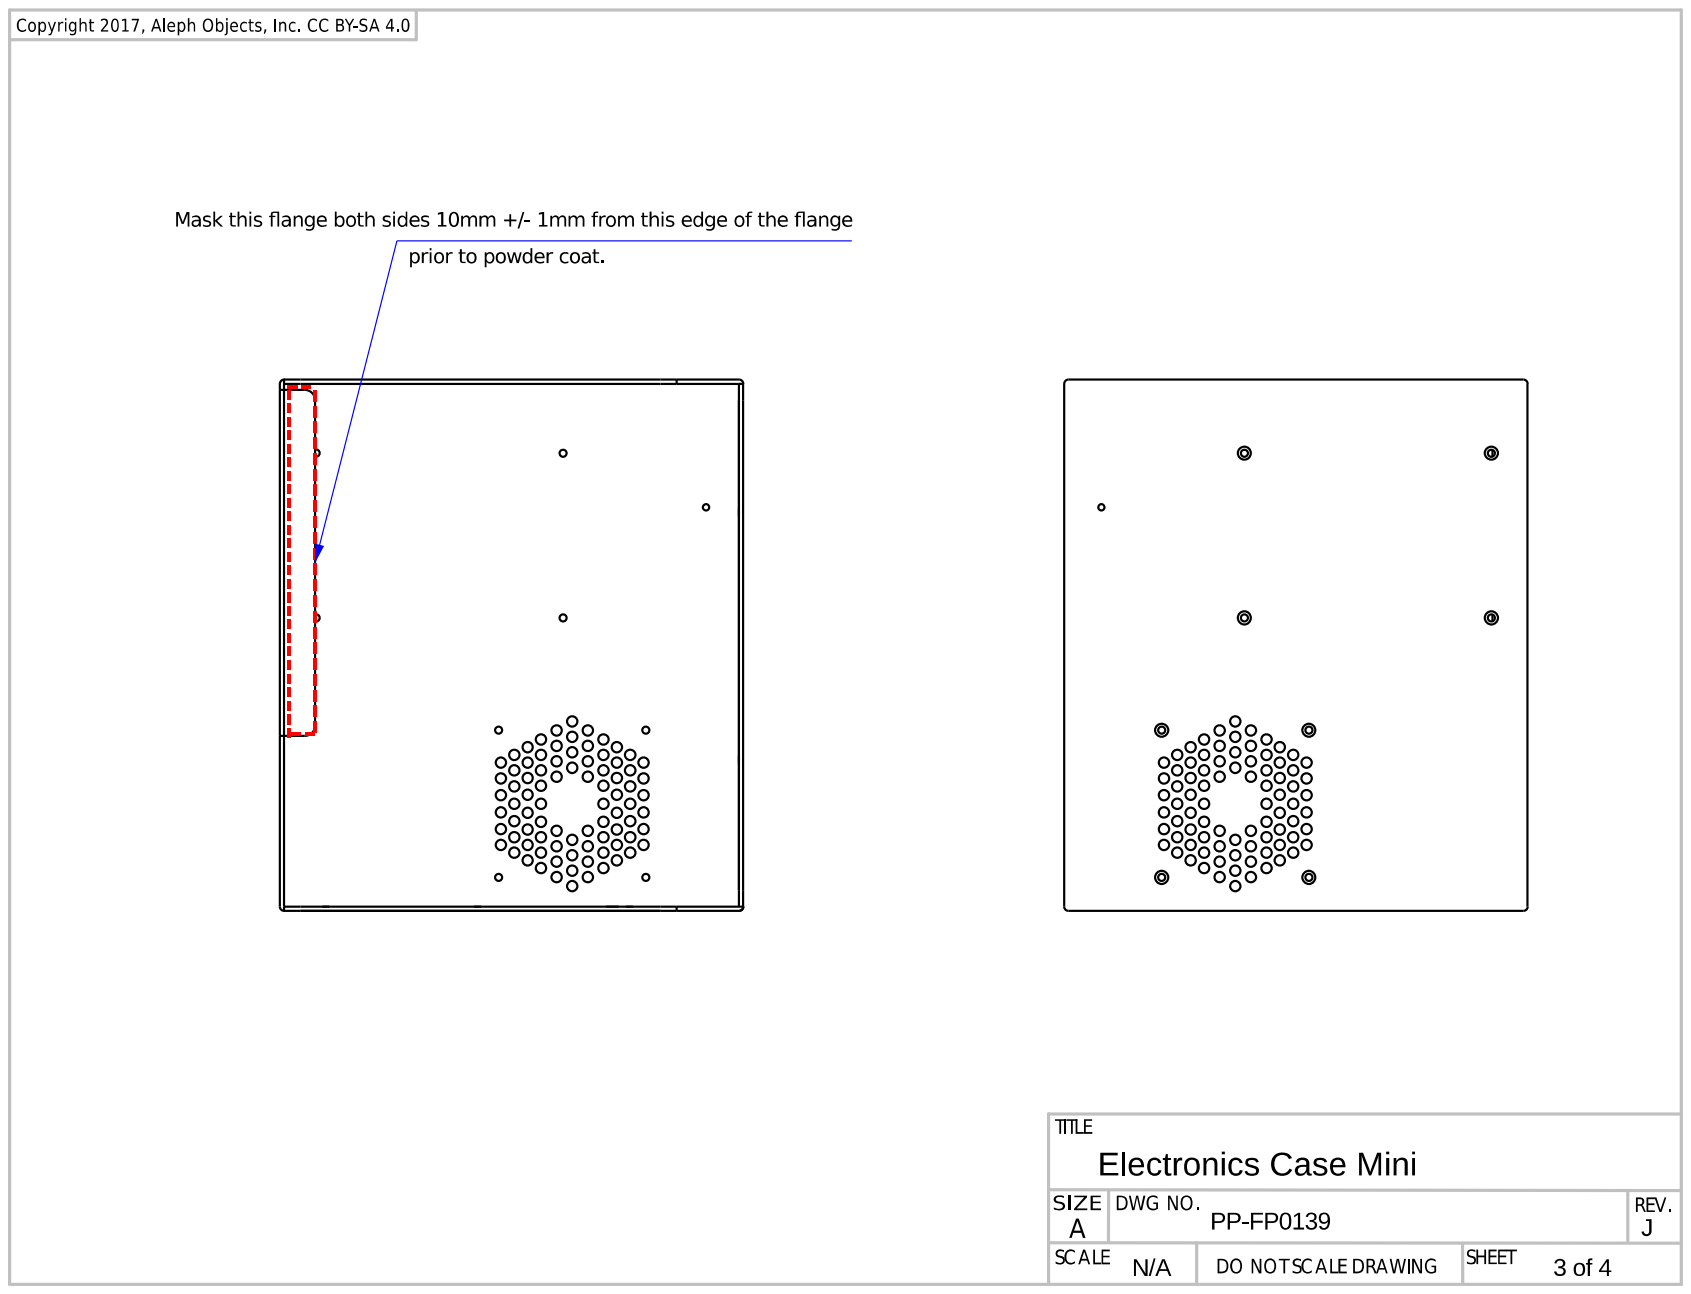
[picture p111: page 3]

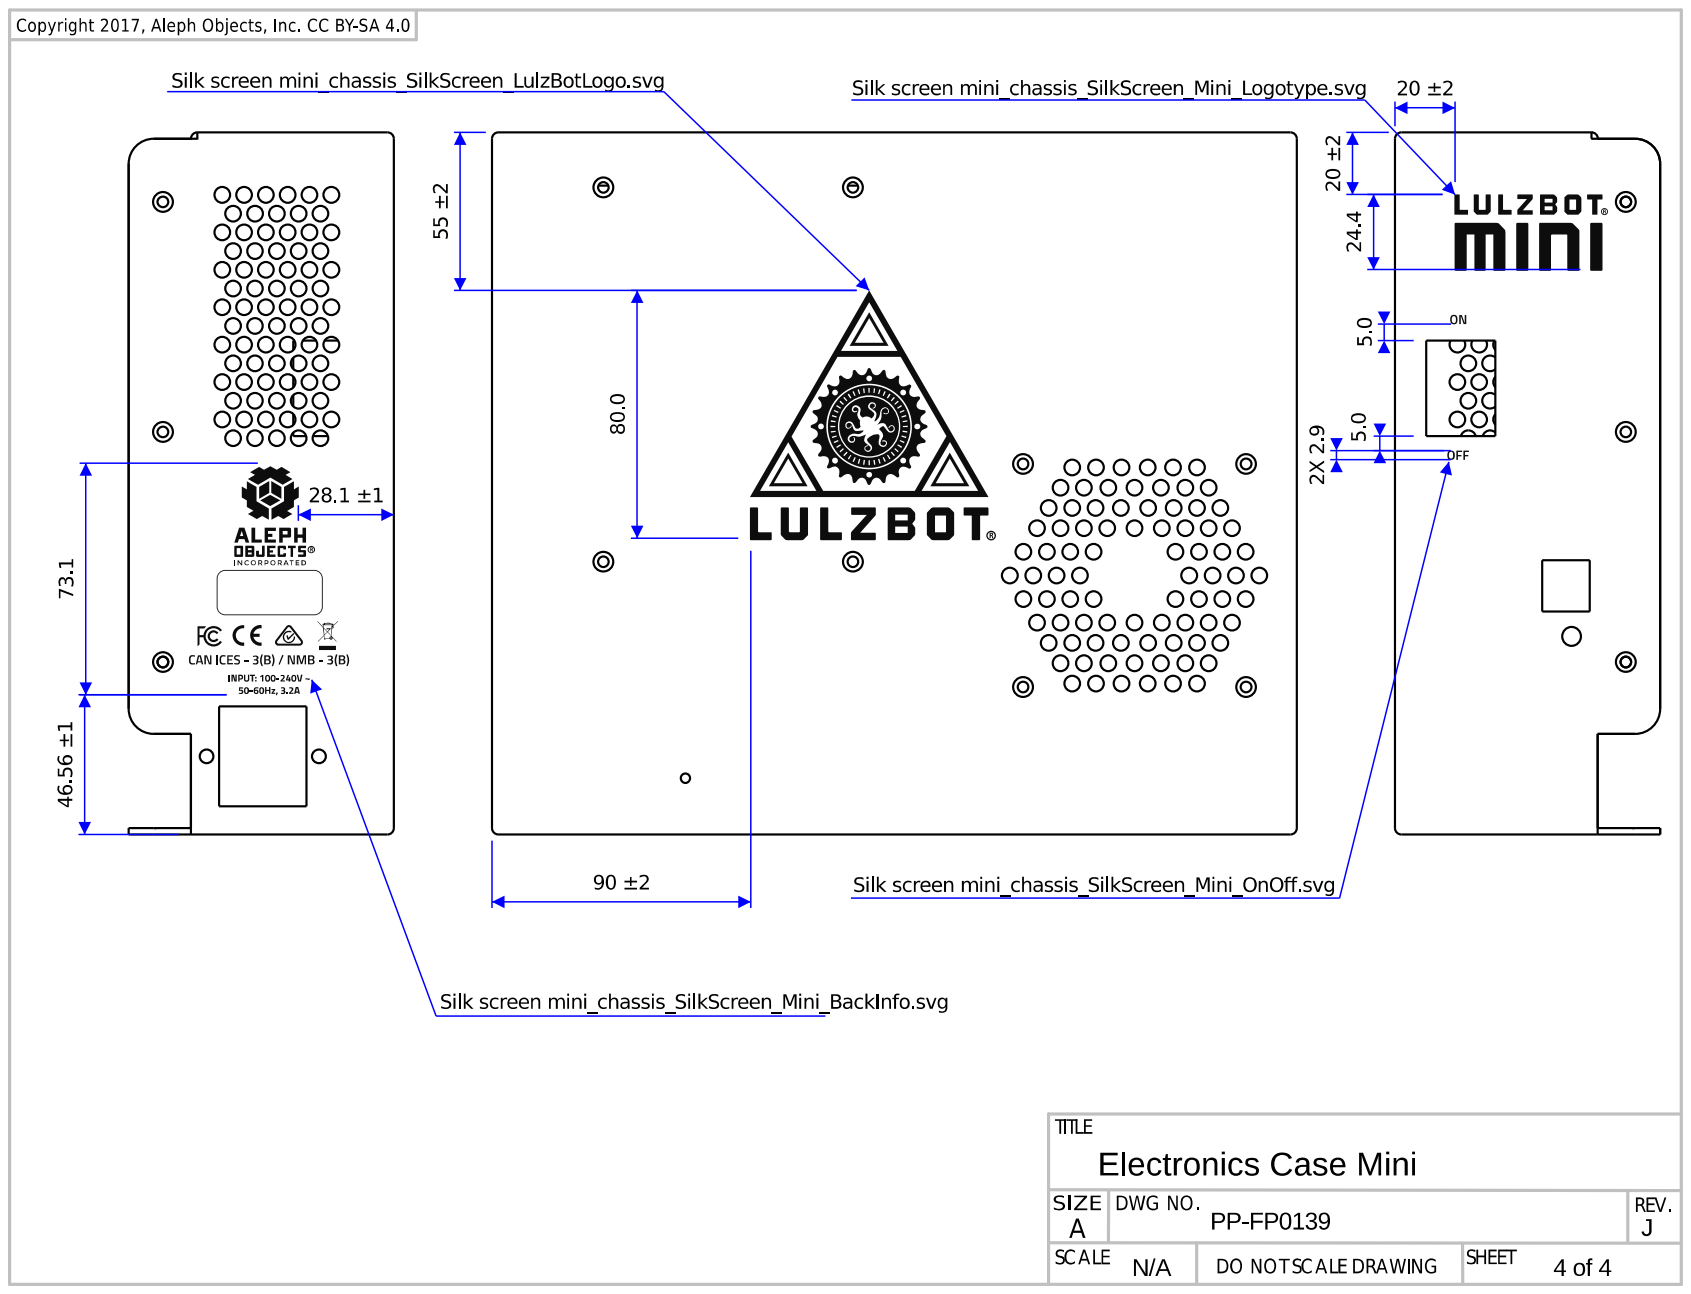
[picture p112: page 4]
