leedshackspace/lulzbot-mini/parts/machined_parts/laser_etching/laser_etched_bed_mount_plate_mini_v1.1_PP-FP0081.pdf

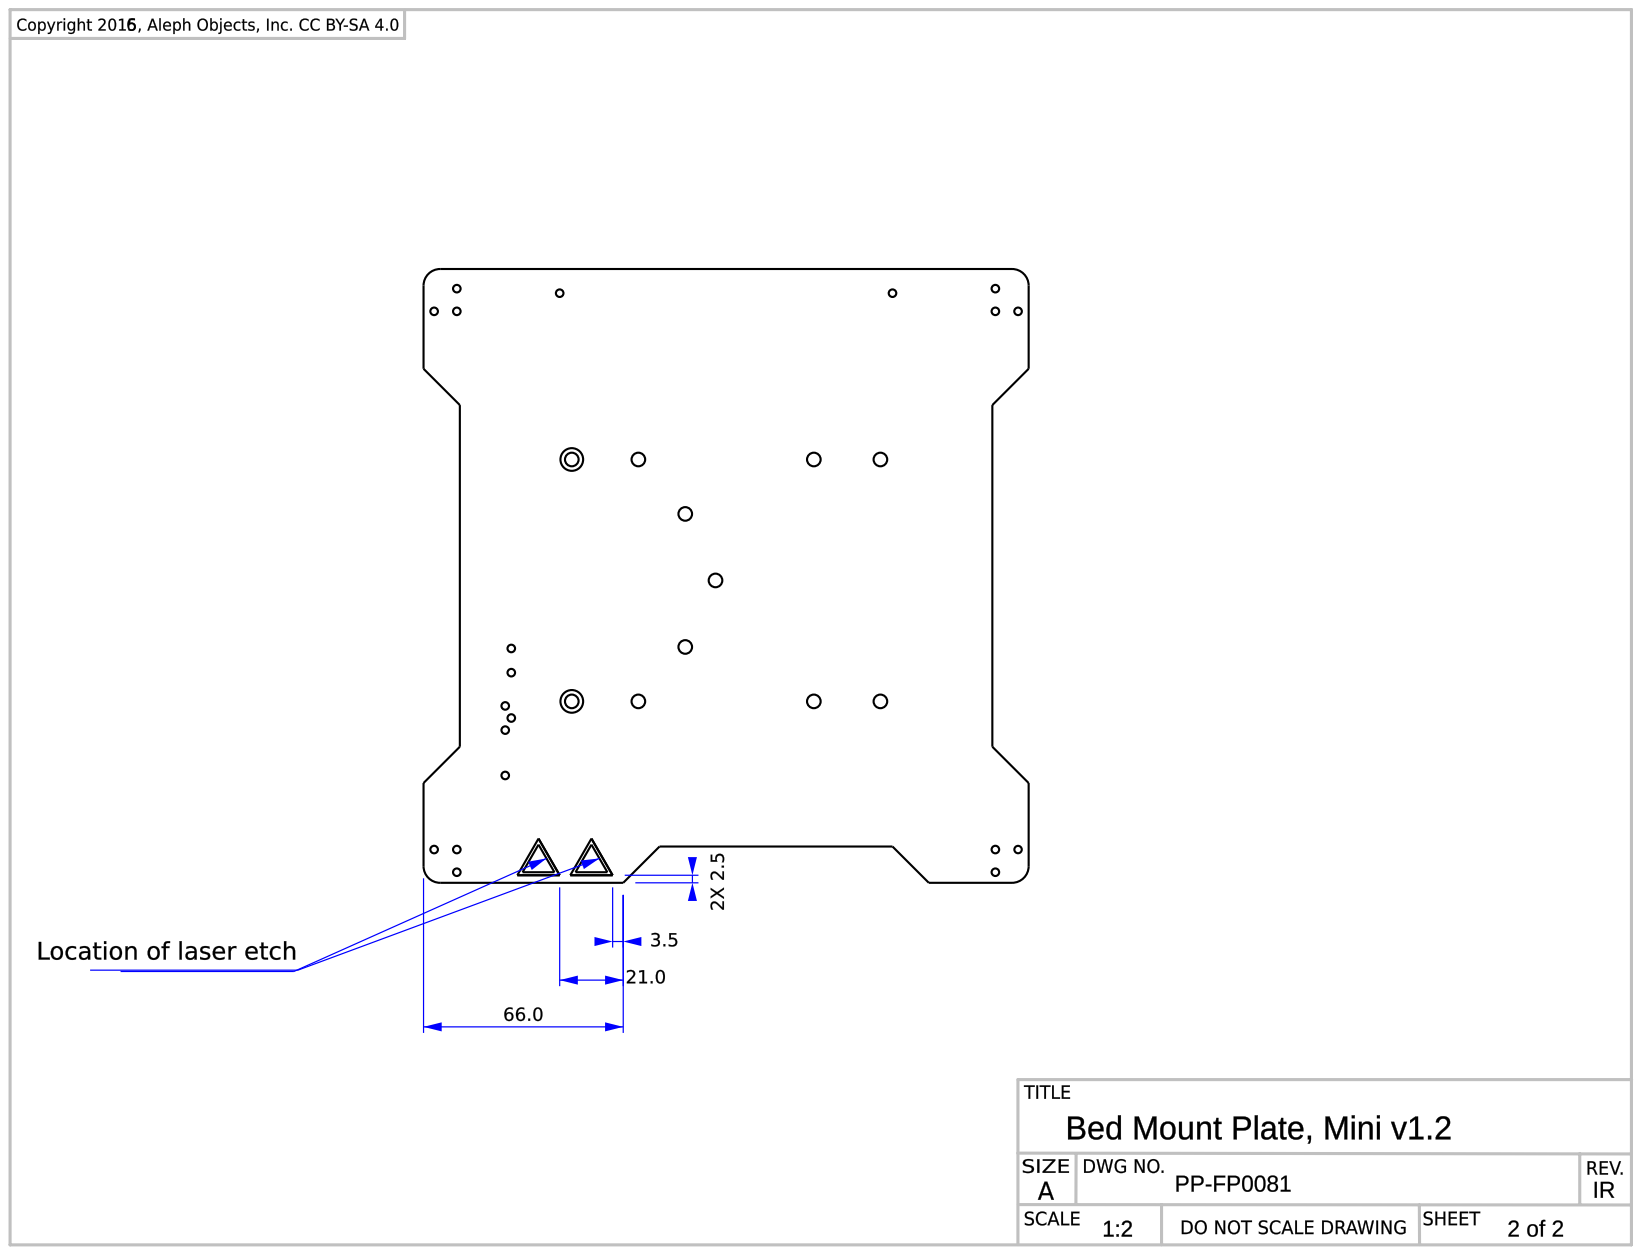
[picture p113: page 1]
