leedshackspace/lulzbot-mini/parts/machined_parts/left_side/left-side-mini_PP-FP0055_revH_page1.pdf

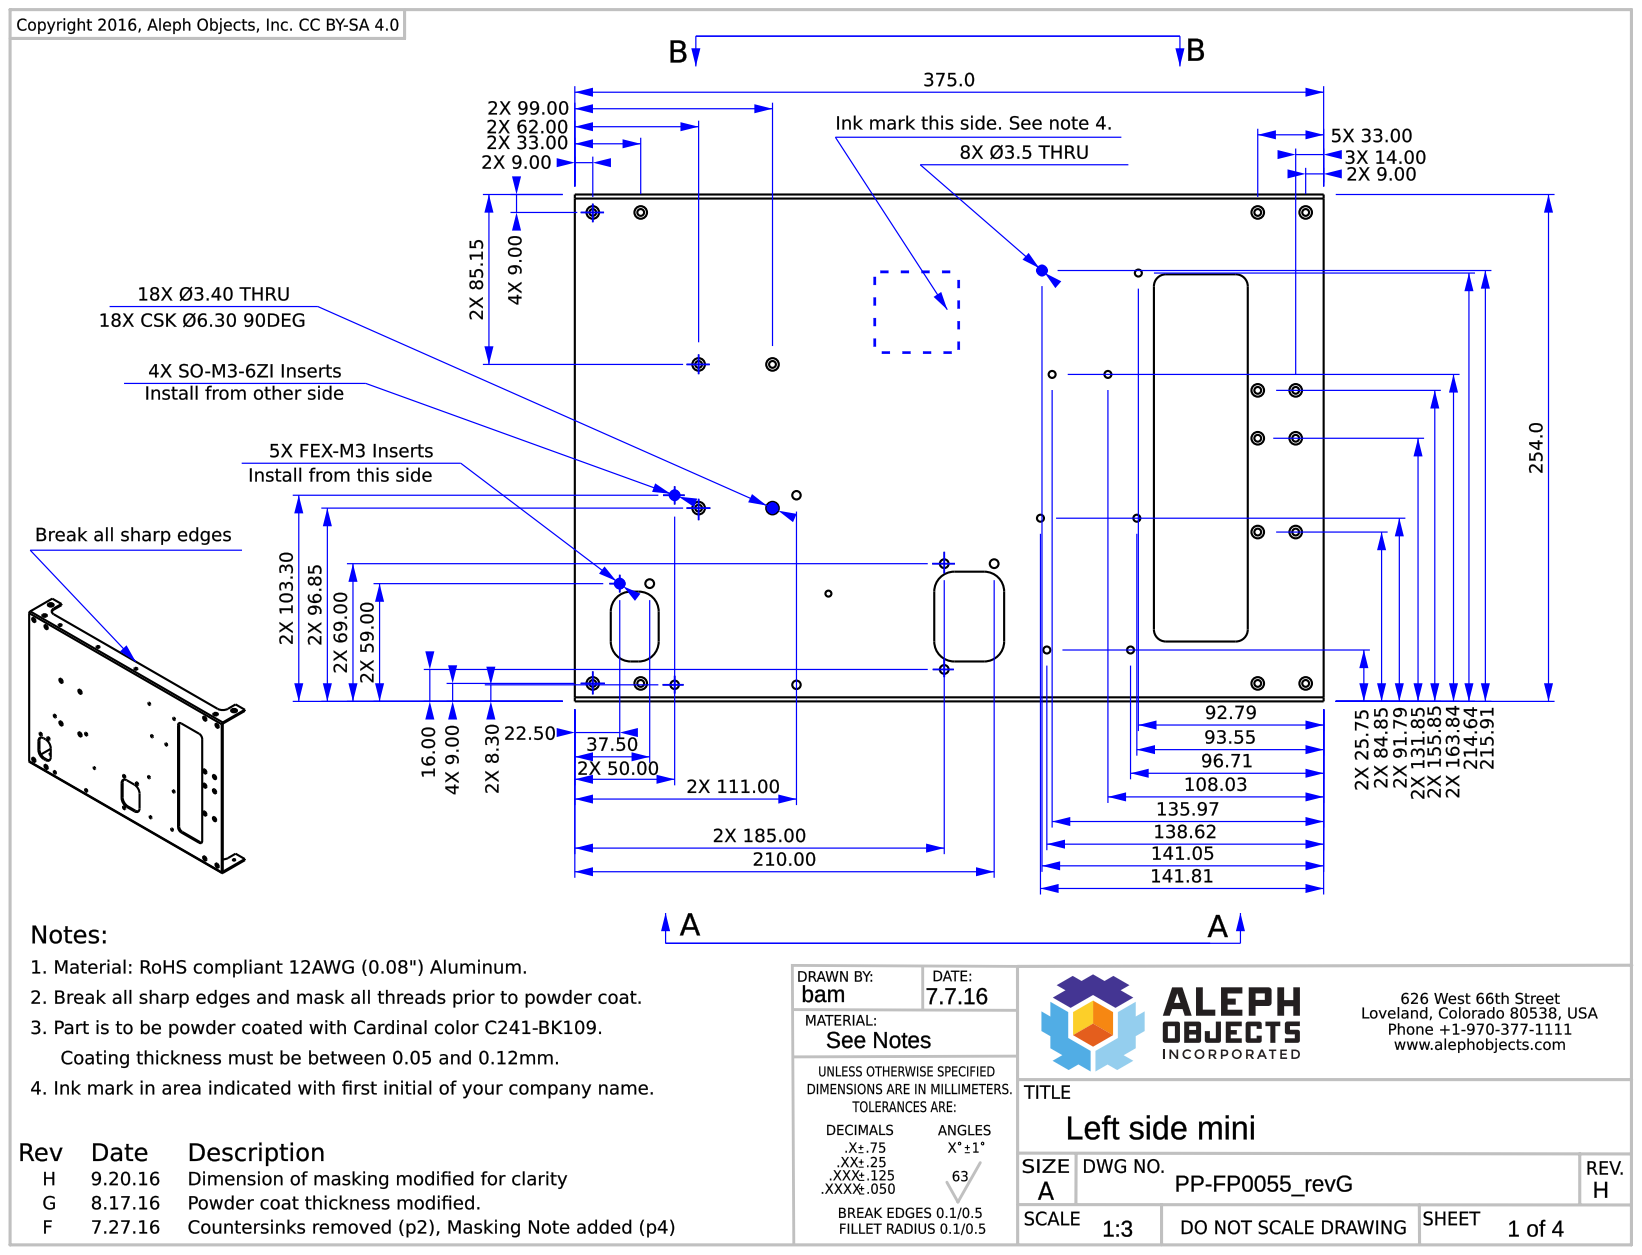
[picture p114: page 1]
