leedshackspace/lulzbot-mini/parts/machined_parts/left_side/left-side-mini_PP-FP0055_revH_page2.pdf

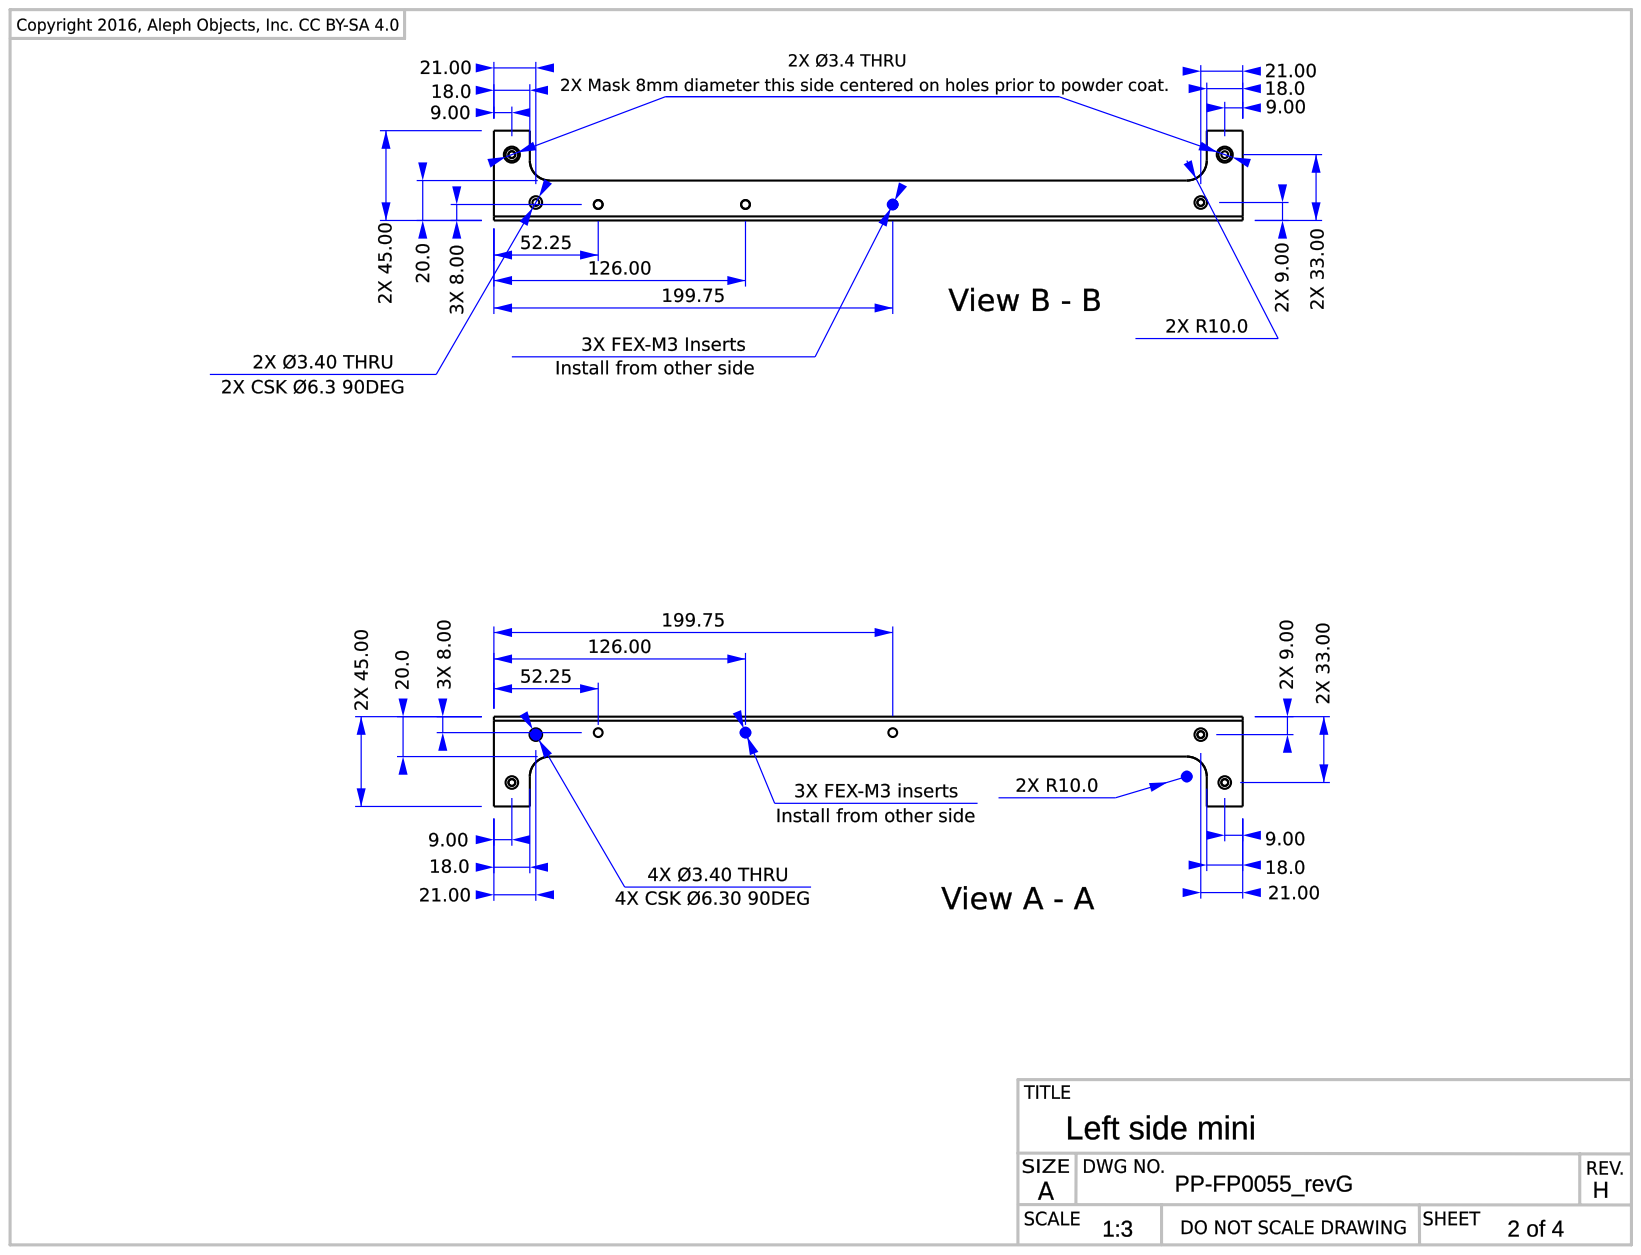
[picture p115: page 1]
