leedshackspace/lulzbot-mini/parts/machined_parts/left_side/left-side-mini_PP-FP0055_revH_page3.pdf

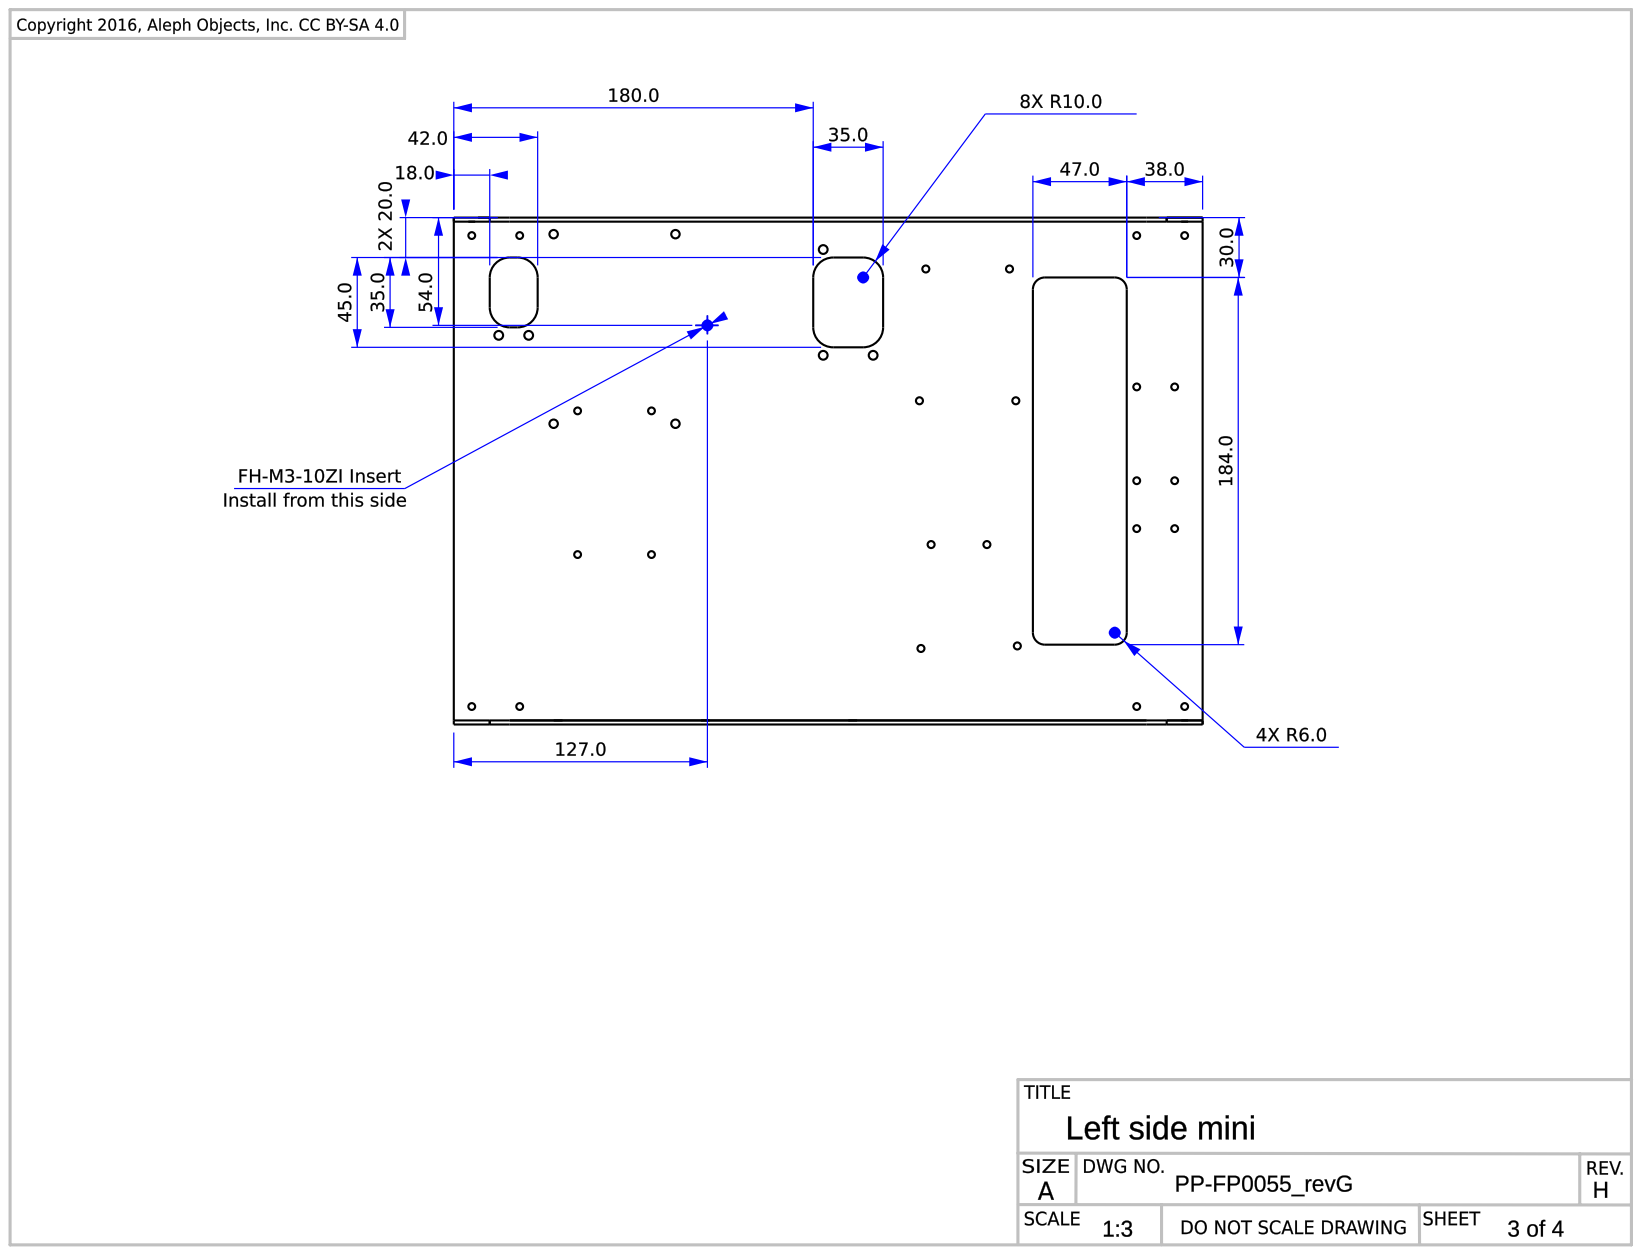
[picture p116: page 1]
