leedshackspace/lulzbot-mini/parts/machined_parts/left_side/left-side-mini_PP-FP0055_revH_page4.pdf

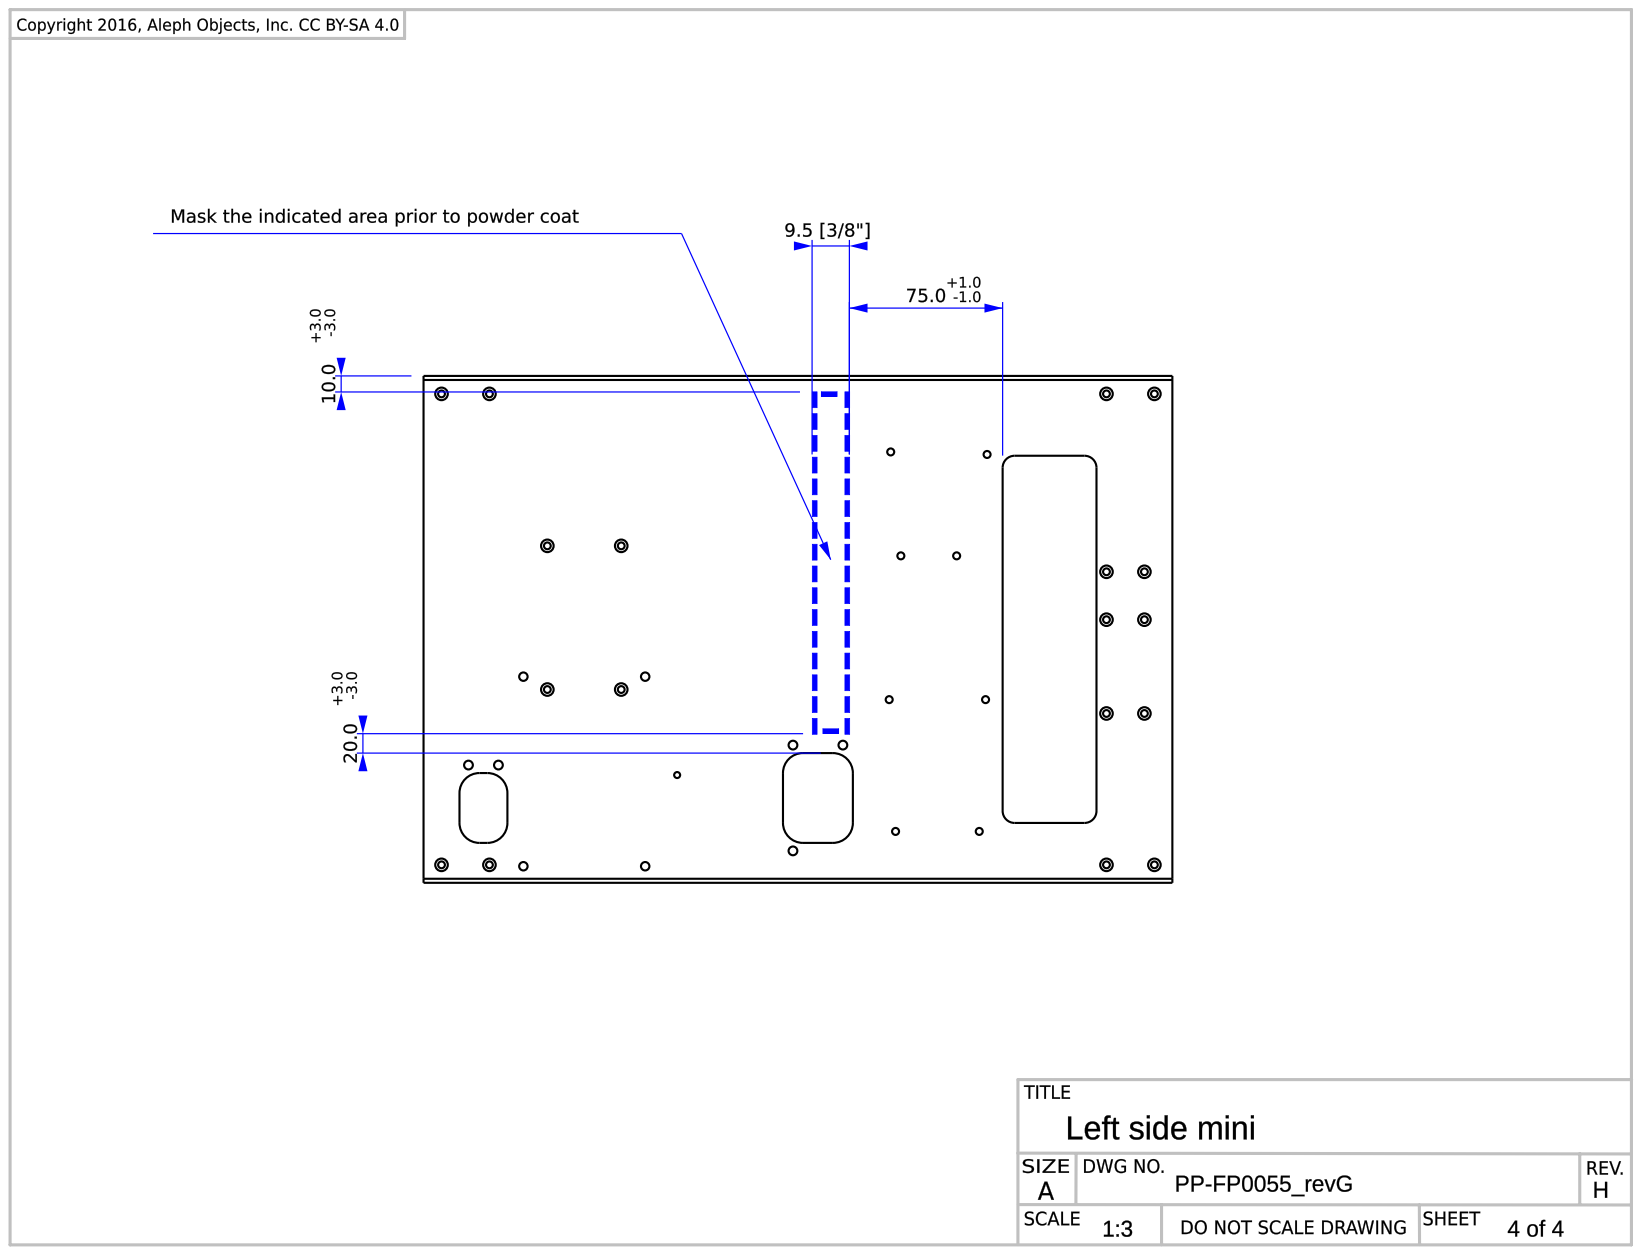
[picture p117: page 1]
