leedshackspace/lulzbot-mini/parts/machined_parts/right_side/right-side-mini_PP-FP0052_revF_page1.pdf

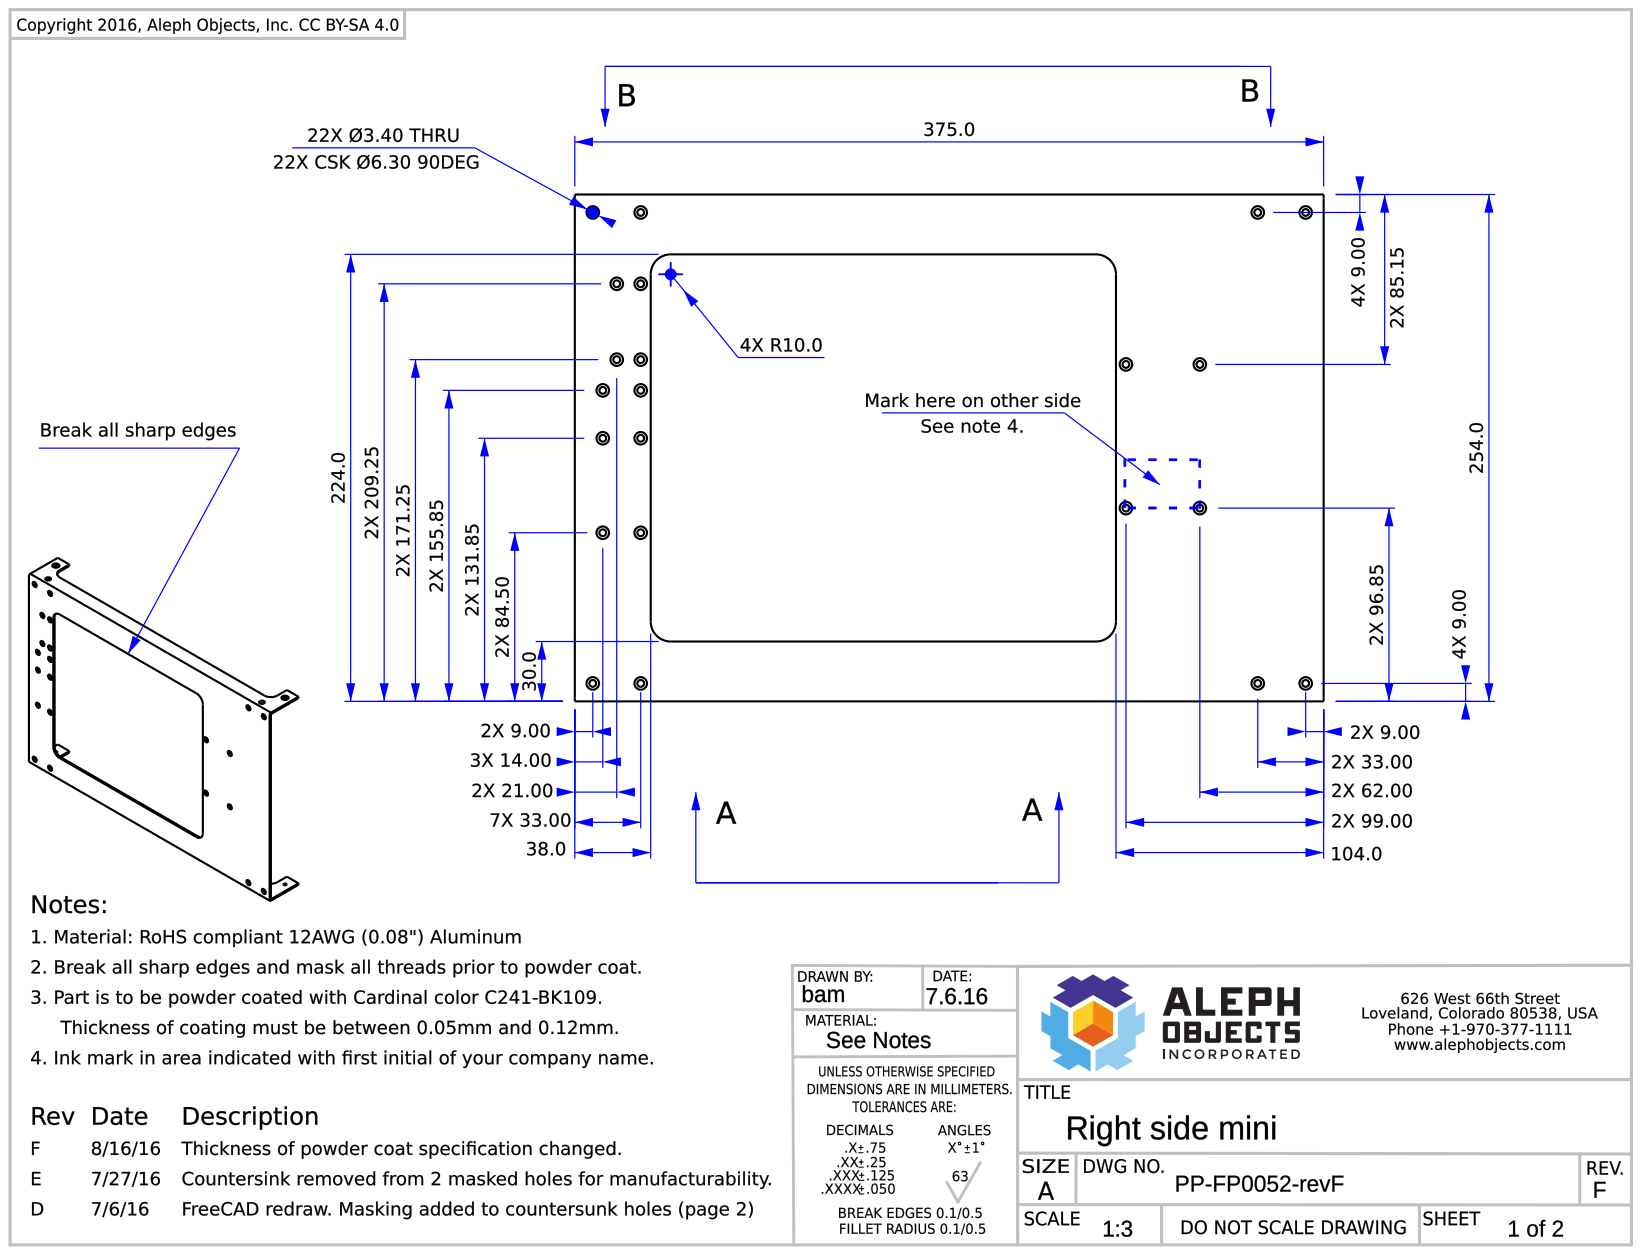
[picture p118: page 1]
