leedshackspace/lulzbot-mini/parts/machined_parts/right_side/right-side-mini_PP-FP0052_revF_page2.pdf

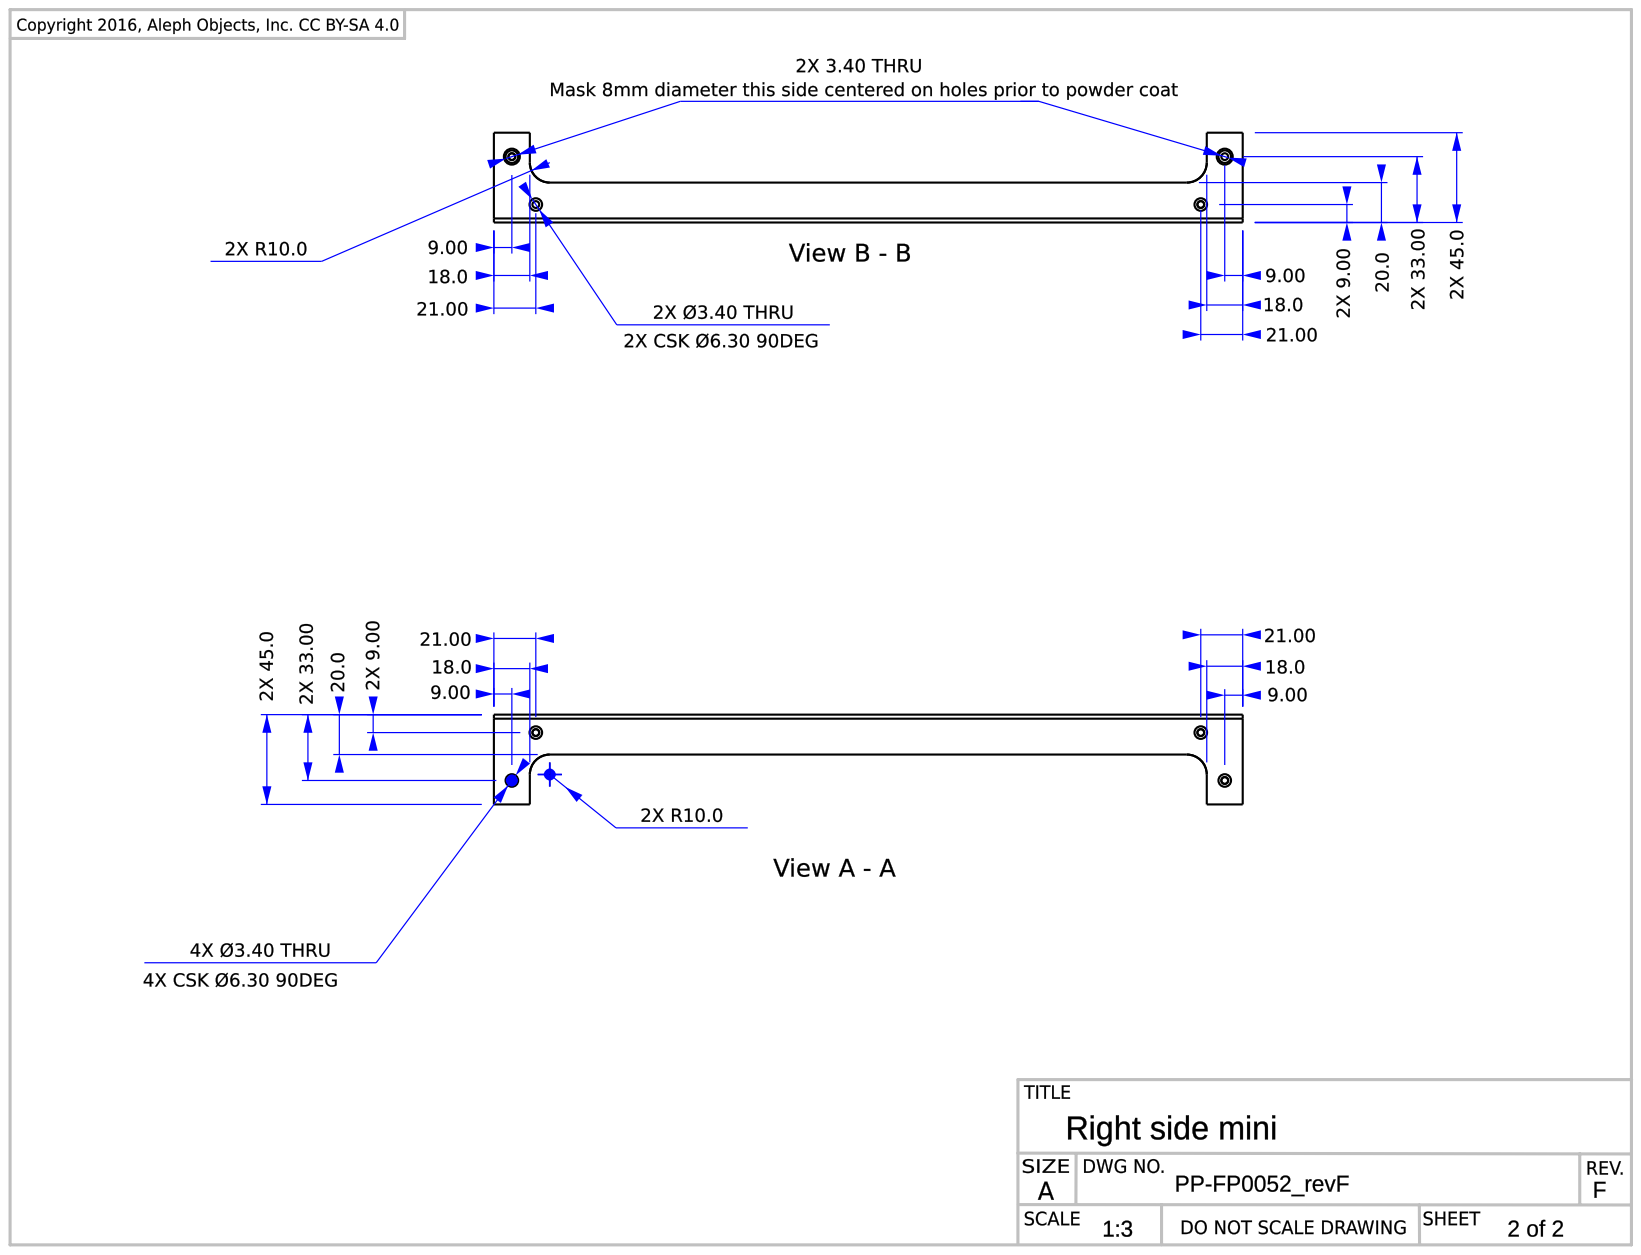
[picture p119: page 1]
