leedshackspace/lulzbot-mini/parts/machined_parts/smooth_rod_mini/8mmx315_rod_v1.0.pdf

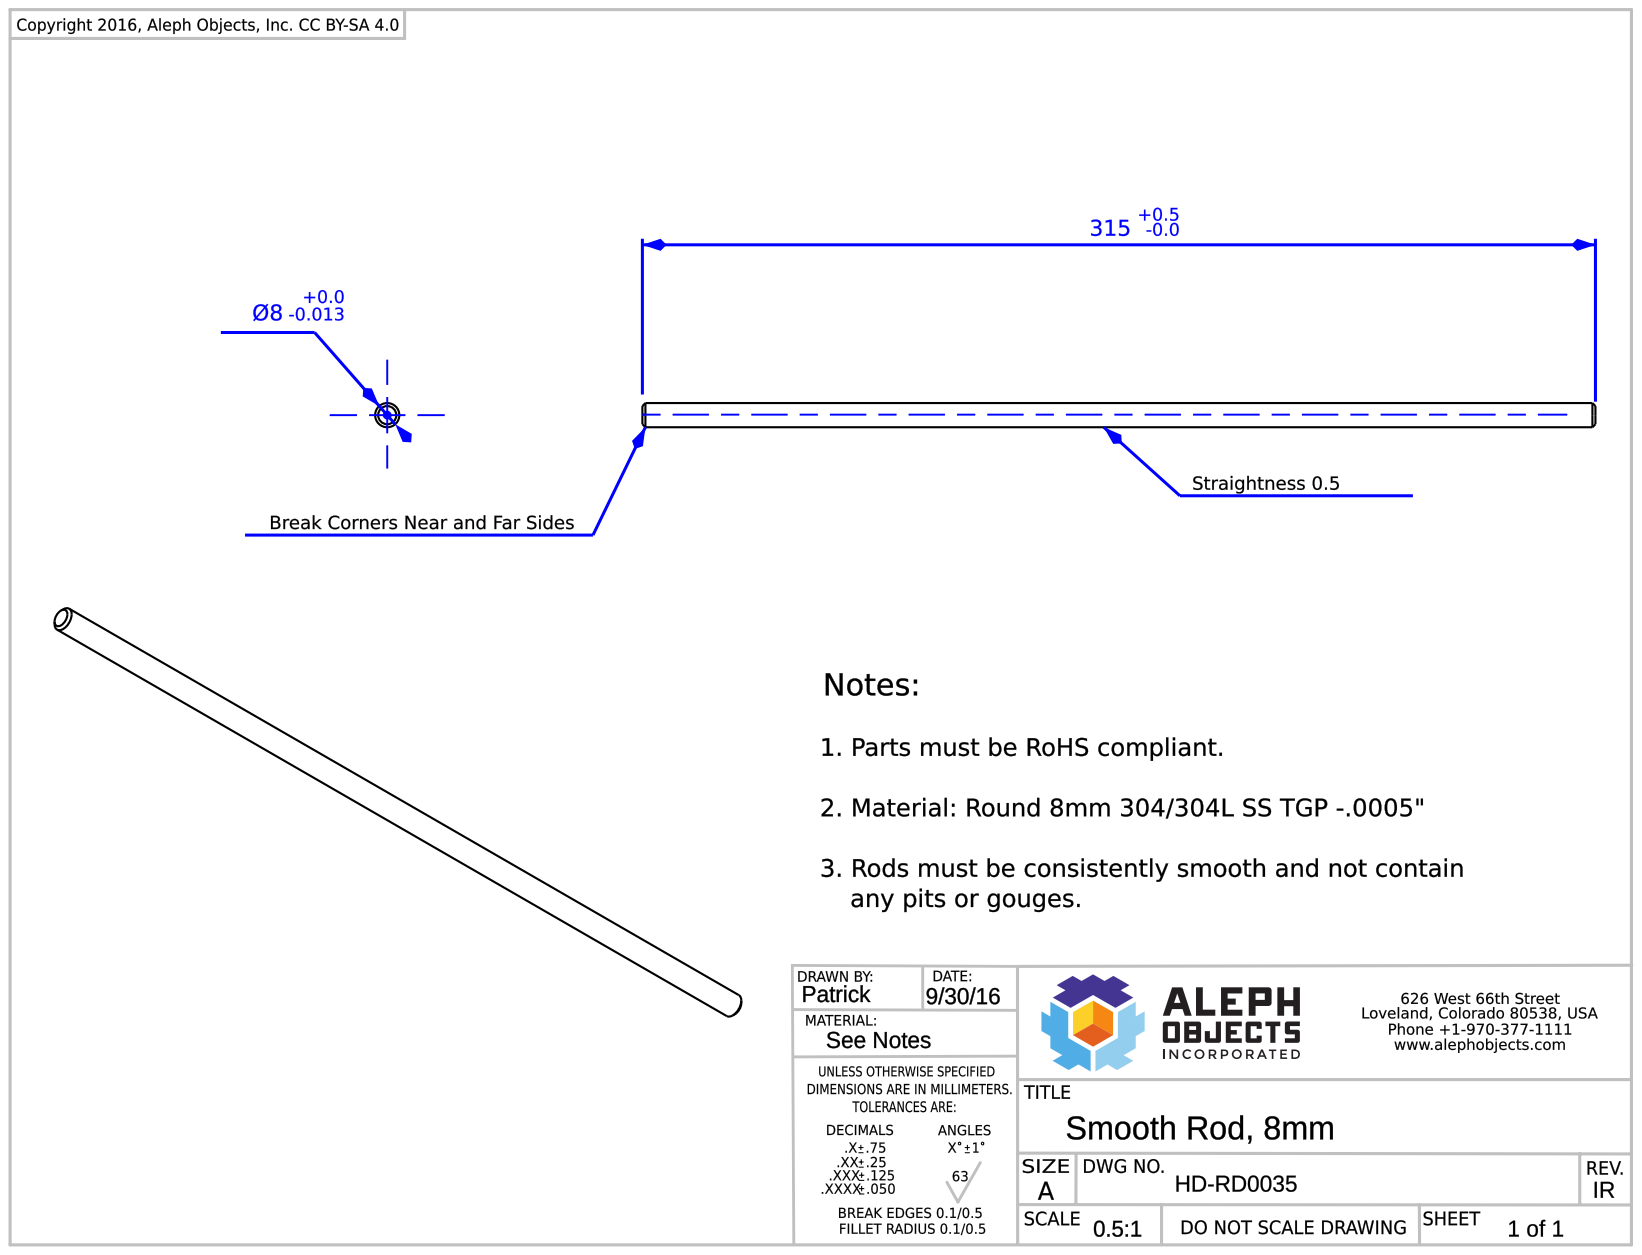
[picture p120: page 1]
