leedshackspace/lulzbot-mini/parts/machined_parts/top_plate_mini/top-plate-mini_PP-FP0051_revF_page1.pdf

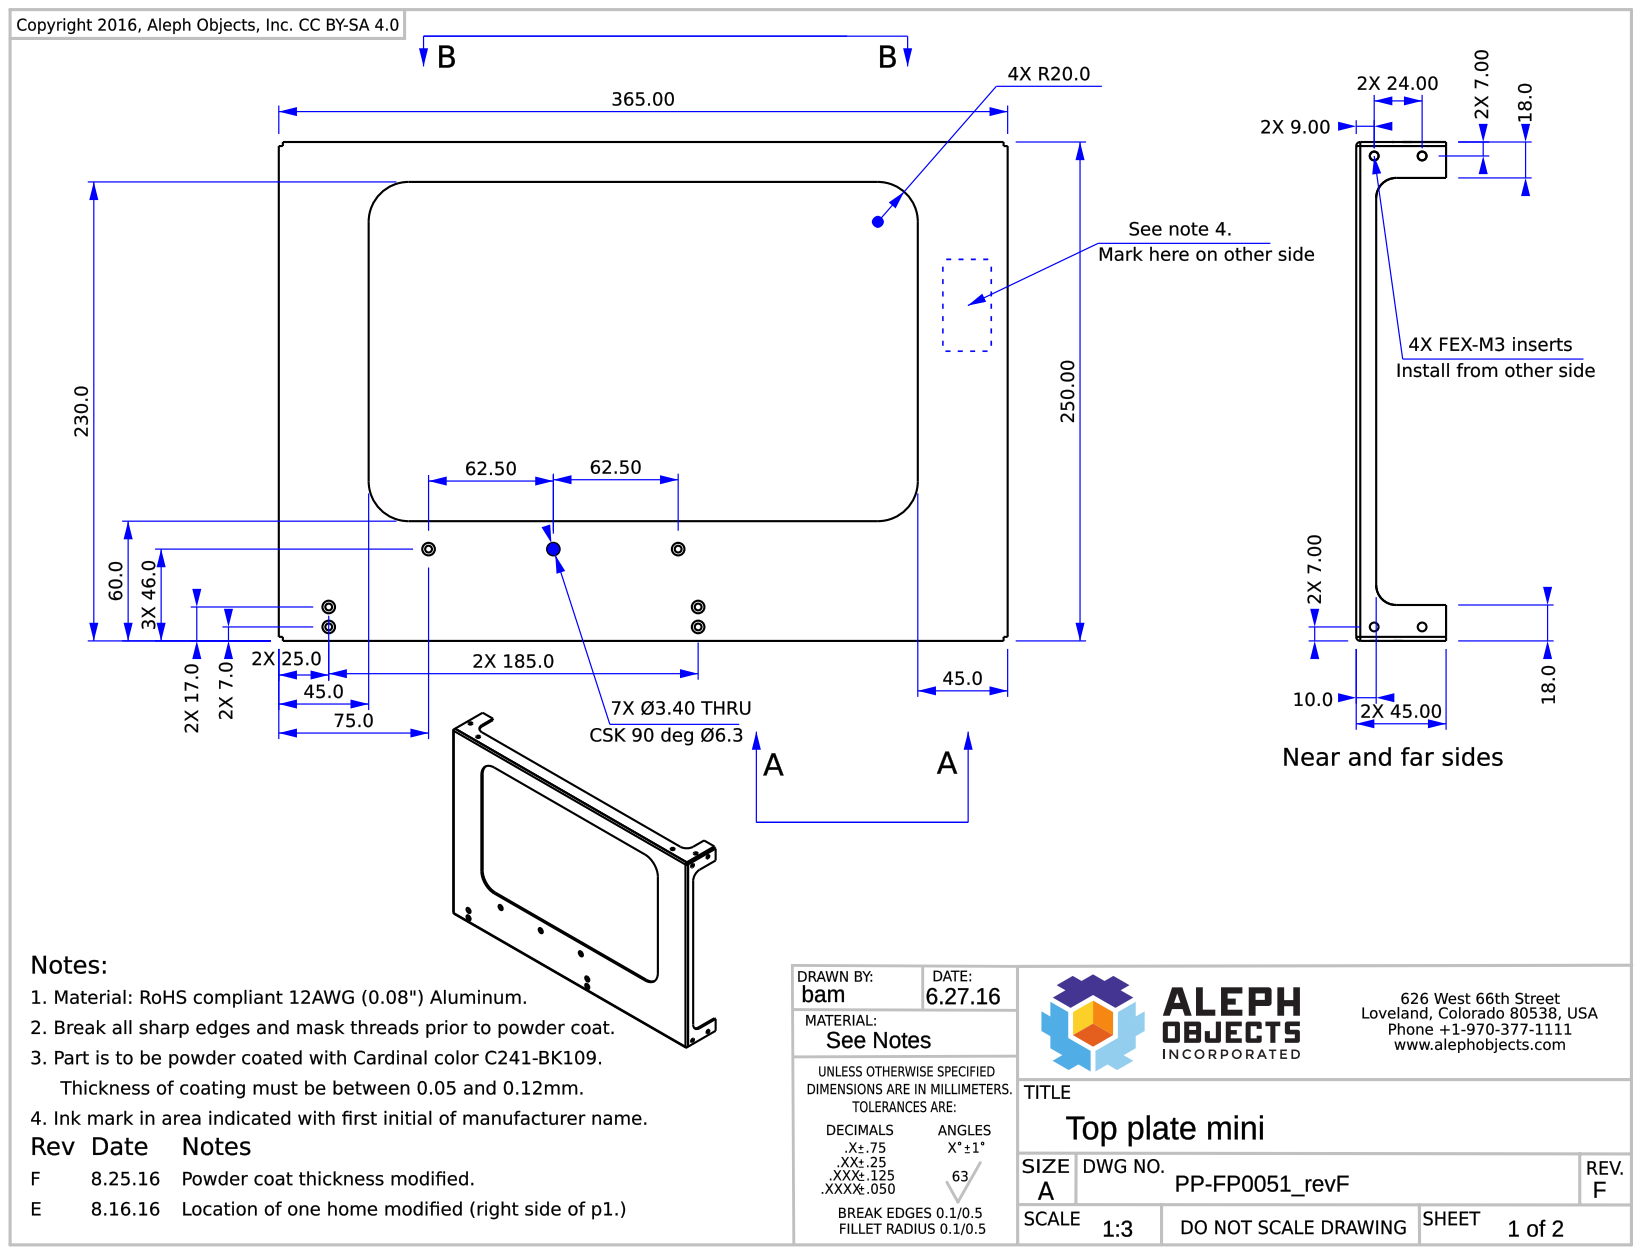
[picture p121: page 1]
