leedshackspace/lulzbot-mini/parts/machined_parts/top_plate_mini/top-plate-mini_PP-FP0051_revF_page2.pdf

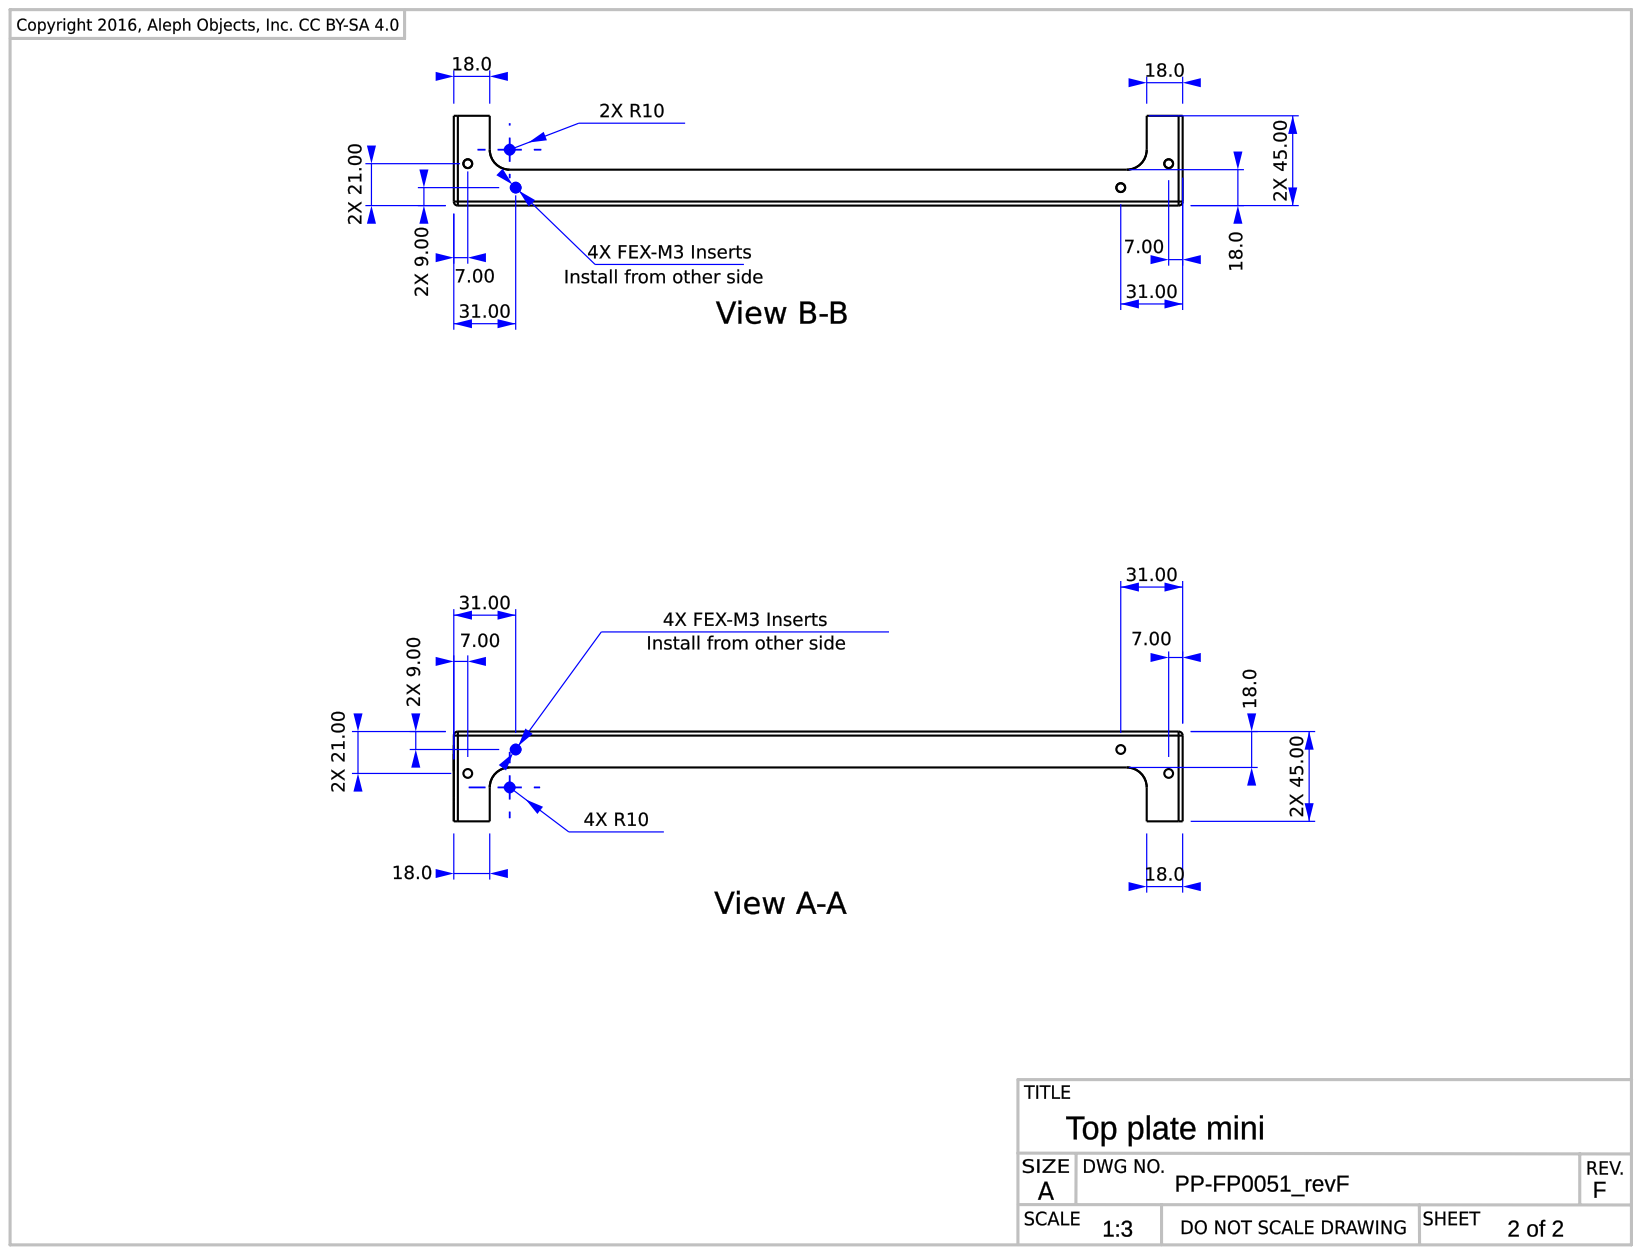
[picture p122: page 1]
