leedshackspace/lulzbot-mini/documentation/Safety Warnings.pdf

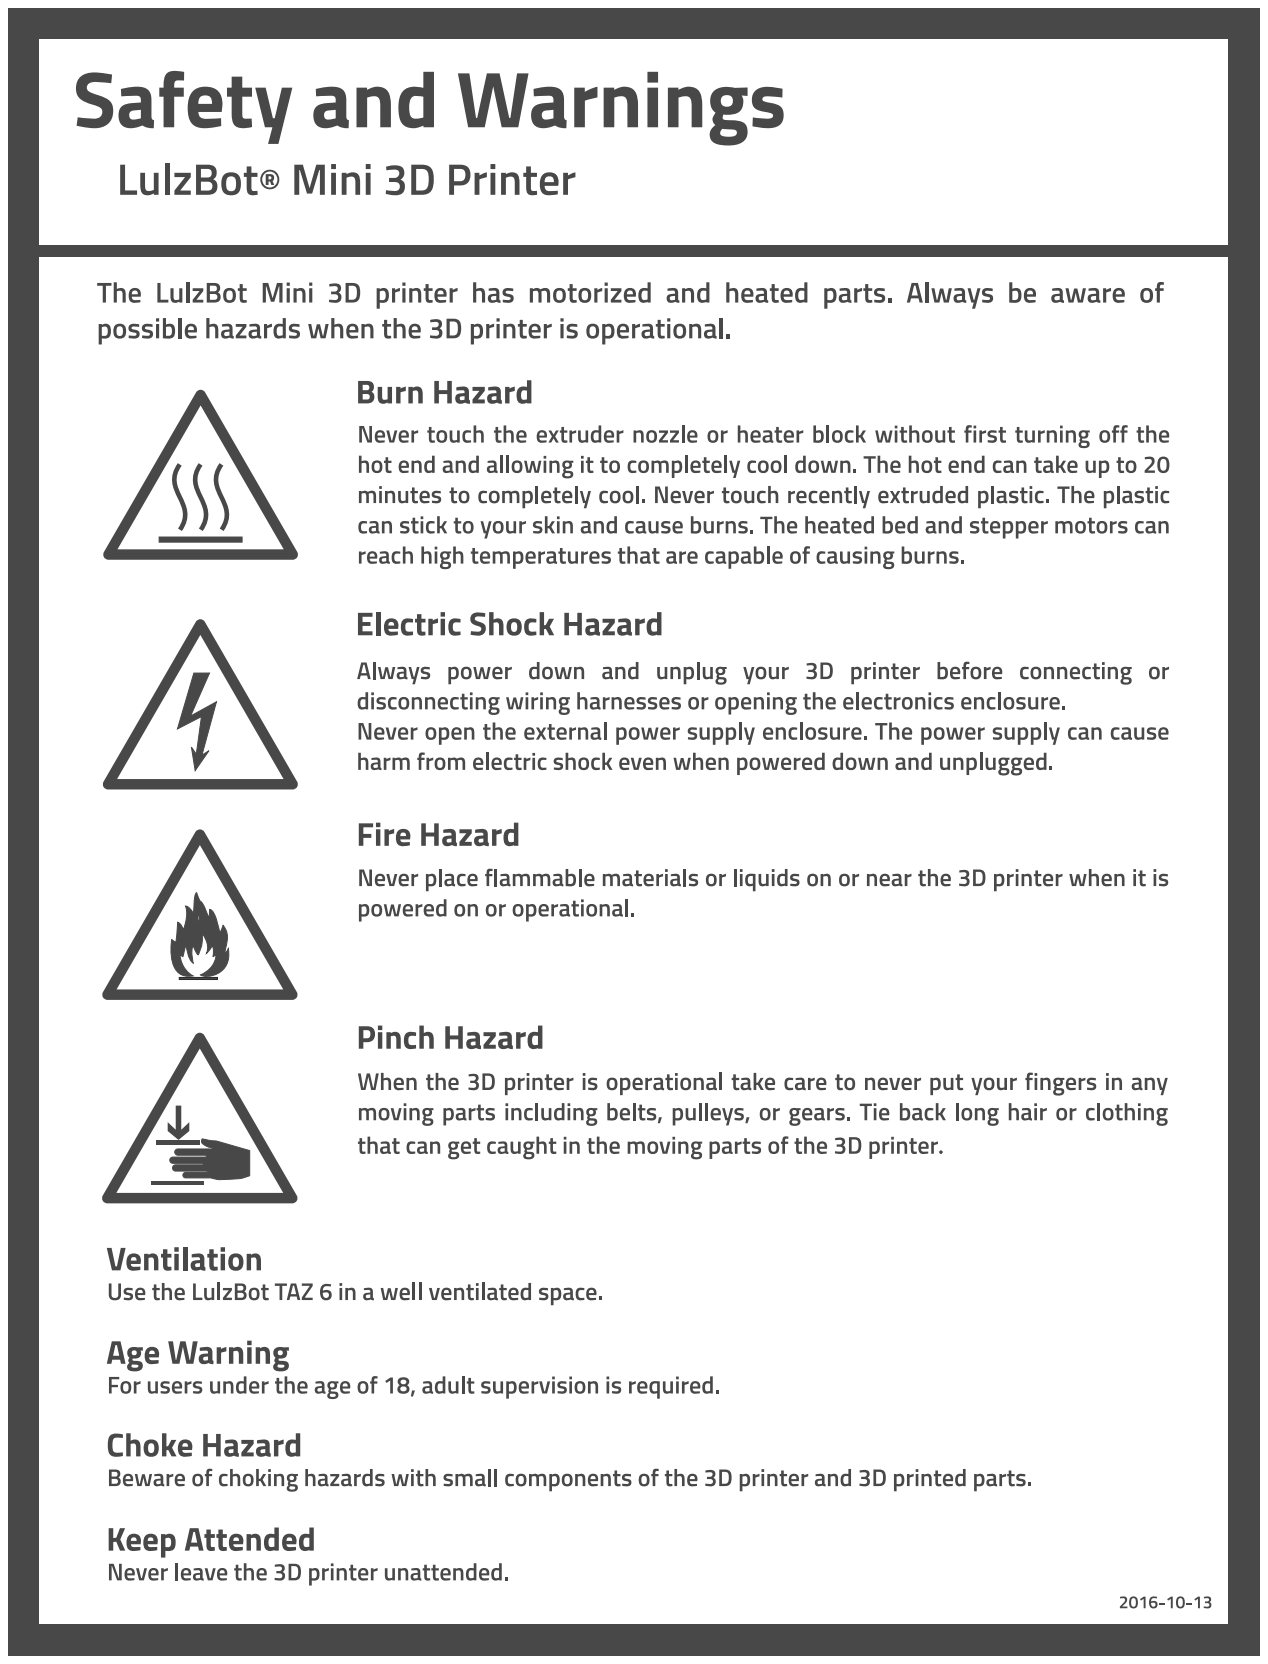
[picture p123: page 1]
