leedshackspace/lulzbot-mini/firmware/Source/Marlin/Configuration.h

#define CONFIGURATION_H
#include "boards.h"
#include "macros.h"
#if ENABLED(USE_AUTOMATIC_VERSIONING)
  #include "_Version.h"
#else
  #include "Version.h"
#endif
#define STRING_CONFIG_H_AUTHOR "(Aleph Objects Inc., LulzBot Mini)" // Who made the changes.
#define SHOW_BOOTSCREEN
#define STRING_SPLASH_LINE1 SHORT_BUILD_VERSION // will be shown during bootup in line 1
#define SERIAL_PORT 0
#define BAUDRATE 115200
  #define MOTHERBOARD BOARD_MINIRAMBO
#define MACHINE_UUID "351487b6-ca9a-4c1a-8765-d668b1da6585"
#define EXTRUDERS 1
#define POWER_SUPPLY 1
#define TEMP_SENSOR_0 5
#define TEMP_SENSOR_1 5
#define TEMP_SENSOR_2 0
#define TEMP_SENSOR_3 0
#define TEMP_SENSOR_BED 7
#define MAX_REDUNDANT_TEMP_SENSOR_DIFF 10
#define TEMP_RESIDENCY_TIME 1  // (seconds)
#define TEMP_HYSTERESIS 10       // (degC) range of +/- temperatures considered "close" to the target one
#define TEMP_WINDOW     10       // (degC) Window around target to start the residency timer x degC early.
#define TEMP_BED_RESIDENCY_TIME 1  // (seconds)
#define TEMP_BED_HYSTERESIS 5       // (degC) range of +/- temperatures considered "close" to the target one
#define TEMP_BED_WINDOW     5       // (degC) Window around target to start the residency timer x degC early.
#define HEATER_0_MINTEMP 5
#define HEATER_1_MINTEMP 5
#define HEATER_2_MINTEMP 5
#define HEATER_3_MINTEMP 5
#define BED_MINTEMP 5
#define HEATER_0_MAXTEMP 305
#define HEATER_1_MAXTEMP 305
#define HEATER_2_MAXTEMP 305
#define HEATER_3_MAXTEMP 305
#define BED_MAXTEMP 150
#define PIDTEMP
#define BANG_MAX 255 // limits current to nozzle while in bang-bang mode; 255=full current
#define PID_MAX BANG_MAX // limits current to nozzle while PID is active (see PID_FUNCTIONAL_RANGE below); 255=full current
  #define PID_FUNCTIONAL_RANGE 10 // If the temperature difference between the target temperature and the actual temperature
  #define PID_INTEGRAL_DRIVE_MAX PID_MAX  //limit for the integral term
  #define K1 0.95 //smoothing factor within the PID
  #define  DEFAULT_Kp 28.79
  #define  DEFAULT_Ki 1.91
  #define  DEFAULT_Kd 108.51
#define PIDTEMPBED
#define MAX_BED_POWER 255 // limits duty cycle to bed; 255=full current
  #define PID_BED_INTEGRAL_DRIVE_MAX MAX_BED_POWER //limit for the integral term
  #define  DEFAULT_bedKp 294
  #define  DEFAULT_bedKi 65
  #define  DEFAULT_bedKd 382
#define PREVENT_DANGEROUS_EXTRUDE
#define PREVENT_LENGTHY_EXTRUDE
#define EXTRUDE_MINTEMP 120
#define EXTRUDE_MAXLENGTH (X_MAX_LENGTH+Y_MAX_LENGTH) //prevent extrusion of very large distances.
#define THERMAL_PROTECTION_HOTENDS // Enable thermal protection for all extruders
#define THERMAL_PROTECTION_BED     // Enable thermal protection for the heated bed
#define USE_XMIN_PLUG
#define USE_YMIN_PLUG
#define USE_ZMIN_PLUG
#define USE_XMAX_PLUG
#define USE_YMAX_PLUG
#define USE_ZMAX_PLUG
#define ENDSTOPPULLUPS // Comment this out (using // at the start of the line) to disable the endstop pullup resistors
const bool X_MIN_ENDSTOP_INVERTING = true; // set to true to invert the logic of the endstop.
const bool Y_MIN_ENDSTOP_INVERTING = true; // set to true to invert the logic of the endstop.
const bool Z_MIN_ENDSTOP_INVERTING = true; // set to true to invert the logic of the endstop.
const bool X_MAX_ENDSTOP_INVERTING = true; // set to true to invert the logic of the endstop.
const bool Y_MAX_ENDSTOP_INVERTING = true; // set to true to invert the logic of the endstop.
const bool Z_MAX_ENDSTOP_INVERTING = true; // set to true to invert the logic of the endstop.
const bool Z_MIN_PROBE_ENDSTOP_INVERTING = true; // set to true to invert the logic of the endstop.
#define Z_MIN_PROBE_USES_Z_MIN_ENDSTOP_PIN
#define X_ENABLE_ON 0
#define Y_ENABLE_ON 0
#define Z_ENABLE_ON 0
#define E_ENABLE_ON 0 // For all extruders
#define DISABLE_X false
#define DISABLE_Y false
#define DISABLE_Z false
#define DISABLE_E false // For all extruders
#define DISABLE_INACTIVE_EXTRUDER true //disable only inactive extruders and keep active extruder enabled
#define INVERT_X_DIR false
#define INVERT_Y_DIR true
#define INVERT_Z_DIR false
#define INVERT_E0_DIR true
#define INVERT_E1_DIR true
#define INVERT_E2_DIR true
#define INVERT_E3_DIR true
#define X_HOME_DIR -1
#define Y_HOME_DIR 1
#define Z_HOME_DIR 1
#define min_software_endstops true // If true, axis won't move to coordinates less than HOME_POS.
#define max_software_endstops true  // If true, axis won't move to coordinates greater than the defined lengths below.
#define X_MIN_POS 0
#define Y_MIN_POS -10
#define Z_MIN_POS -2
#define X_MAX_POS 175
#define Y_MAX_POS 191
#define Z_MAX_POS 159
#define AUTO_BED_LEVELING_FEATURE // Delete the comment to enable (remove // at the start of the line)
#define Z_MIN_PROBE_REPEATABILITY_TEST  // If not commented out, Z Probe Repeatability test will be included if Auto Bed Leveling is Enabled.
  #define AUTO_BED_LEVELING_GRID
    #define LEFT_PROBE_BED_POSITION 0
    #define RIGHT_PROBE_BED_POSITION 164
    #define FRONT_PROBE_BED_POSITION -6
    #define BACK_PROBE_BED_POSITION 162
    #define MIN_PROBE_EDGE 10 // The Z probe minimum square sides can be no smaller than this.
    #define AUTO_BED_LEVELING_GRID_POINTS 2
    #define REPROBE // Re-attempts probing
      #define Z_RETRY_PT 5 // Z height to move the hotend after failed probe
      #define NUM_ATTEMPTS 3 // Number of attempts to make before quiting
      #define PROBE_FAIL_PANIC // Completely give up printing if the final attempt fails (use G26 to get out of failed state)
        #define PROBE_FAIL_POS {80.0, 0.0, 80.0, 0.0}
        #define PROBE_FAIL_TEMP_TIME 30 // How long (in seconds) to hold the temperatures after probing fails
      #define REWIPE // Re-attempts wiping
        #define NUM_REWIPES 6 // Number of (back-and-forth) re-wipe attemps to make, e.g. 6 would produce 12 strokes
        #define REWIPE_FIRST_PT {115, 173}
        #define REWIPE_SECOND_PT {45, 173}
        #define Z_REWIPE_PT (Z_MIN_POS + 1) // Depth to re-wipe at
  #define X_PROBE_OFFSET_FROM_EXTRUDER 0  // X offset: -left  +right  [of the nozzle]
  #define Y_PROBE_OFFSET_FROM_EXTRUDER 0  // Y offset: -front +behind [the nozzle]
  #define Z_PROBE_OFFSET_FROM_EXTRUDER -1.43   // Z offset: -below +above  [the nozzle]
  #define XY_TRAVEL_SPEED 8000         // X and Y axis travel speed between probes, in mm/min.
  #define MIN_PROBE_PT (Z_MIN_POS-2)     //How far the extruder should move down to probe
  #define Z_RAISE_BEFORE_PROBING 5   // How much the Z axis will be raised before traveling to the first probing point.
  #define Z_RAISE_BETWEEN_PROBINGS 5  // How much the Z axis will be raised when traveling from between next probing points.
  #define Z_RAISE_AFTER_PROBING 0    // How much the Z axis will be raised after the last probing point.
  #define MECHANICAL_PROBE
#define HOMING_FEEDRATE {30*60, 30*60, 12*60, 0}  // set the homing speeds (mm/min)
#define DEFAULT_AXIS_STEPS_PER_UNIT   {100.5,100.5,1600,833}  // default steps per unit for LulzBot Mini
#define DEFAULT_MAX_FEEDRATE          {800, 800, 8, 40}    // (mm/sec)
#define DEFAULT_MAX_ACCELERATION      {9000,9000,100,1000}    // X, Y, Z, E maximum start speed for accelerated moves. E default values are good for Skeinforge 40+, for older versions raise them a lot.
#define DEFAULT_ACCELERATION          2000    // X, Y, Z and E acceleration in mm/s^2 for printing moves
#define DEFAULT_RETRACT_ACCELERATION  3000    // E acceleration in mm/s^2 for retracts
#define DEFAULT_TRAVEL_ACCELERATION   2000    // X, Y, Z acceleration in mm/s^2 for travel (non printing) moves
#define DEFAULT_XYJERK                12.0    // (mm/sec)
#define DEFAULT_ZJERK                 0.4     // (mm/sec)
#define DEFAULT_EJERK                 10.0    // (mm/sec)
#define CUSTOM_M_CODES
    #define CUSTOM_M_CODE_SET_Z_PROBE_OFFSET 851
    #define Z_PROBE_OFFSET_RANGE_MIN -2
    #define Z_PROBE_OFFSET_RANGE_MAX 5
#define EEPROM_SETTINGS
  #define EEPROM_CHITCHAT // Please keep turned on if you can.
#define DISABLE_HOST_KEEPALIVE // Enable this option if your host doesn't like keepalive messages.
#define PLA_PREHEAT_HOTEND_TEMP 180
#define PLA_PREHEAT_HPB_TEMP 70
#define PLA_PREHEAT_FAN_SPEED 0   // Insert Value between 0 and 255
#define ABS_PREHEAT_HOTEND_TEMP 240
#define ABS_PREHEAT_HPB_TEMP 110
#define ABS_PREHEAT_FAN_SPEED 0   // Insert Value between 0 and 255
#define LCD_LANGUAGE en
#define DISPLAY_CHARSET_HD44780 JAPANESE
#define FAST_PWM_FAN
#define SOFT_PWM_SCALE 0
#define DEFAULT_NOMINAL_FILAMENT_DIA 3.00  //Enter the diameter (in mm) of the filament generally used (3.0 mm or 1.75 mm) - this is then used in the slicer software.  Used for sensor reading validation
#include "Configuration_adv.h"
#include "thermistortables.h"
